robmacl/micron_maxon/drawings/Inventor_Design/Micron22_top_adj_02082013_Inventor2013/Images/render_Shop2.jpg

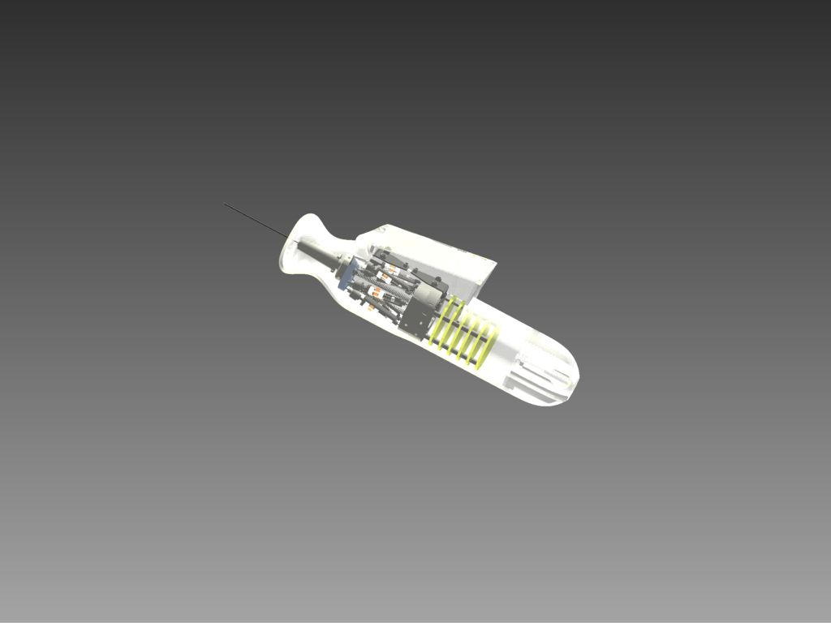
drawings/Inventor_Design/Micron22_top_adj_02082013_Inventor2013/Images/render_Shop2.jpg
