robmacl/micron_maxon/cad/asap_micron/mechanical/README.txt

Parts for the ASAP instrument.

Rob MacLachlan (412-445-8113, ram@ri.cmu.edu)

You can charge this to 15798.1.1090159

The big hole in the camera is for a "C mount lens".  My understanding
that the spec for this is 1" 32 TPI UN2A.

Tolerances: I've used three decimals for any dimensions where there
may be a fit issue.  I've used standard clearance holes for paired bolts,
so I don't think any special care should be required for the tapped
holes or clearance holes.

I think the most critical position is the hole pairs for the alignment
dowel pins between the camera and bar parts.  The idea is that the
pins should slip fit in the camera body and press fit in the bar.

Hole sizes should generally be standard drill sizes, and are not
critical.  I have not called out any tap drill on tapped holes, only
the thread depth.

Files:

Documentation:
README.txt		This file
assembly.SLDASM		Assembly
drawings.SLDDRW		Drawings of assembly and all parts
lens.SLDPRT		Dummy lens for assembly

Fabricated parts:
Mount block.SLDPRT	Mounting block
adapter_plate.SLDPRT	Adapter plate
bar.SLDPRT		Bar
camera.SLDPRT		Camera
ctr_laser_bracket.SLDPRT Center laser bracket
laser_bracket.SLDPRT	 (side) laser bracket
