robmacl/micron_maxon/micron/labview/manipulator/squiggle/Documentation/i2c_fpga.pptx

## I2C multi-bus controller organization

Control output (low overhead)

Demultiplexer commands (synchronization) and packets of bus controller commands.

Host write FIFO

Local command generation

Local write FIFO

Demultiplexer

Triggering

Bus controller commands: start_read, etc.

Bus 0

Bus 1

Bus 2

Multiplexer

Status packets

Host read FIFO

## I2C bus timing

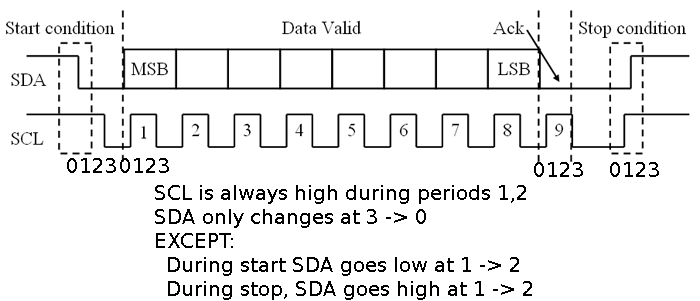
[picture p14: figure]

- Each bit period is divided into four phases 0 .. 3
- State transitions are usually clocked off of the leading edge of one of these phases.

## I2C bus state machine

See
Next slide

start_write
start_read

Exit on empty

Trigger delay 1

CMD wait

sequence

Sequence arg load

stop

Trigger delay 2

TX stop wait

Trigger delay 3

TX stop

## I2C bus state (read/write)

CMD wait

start_write

start_read

The first states of reading and writing are in common, with some parts conditional on whether the command is read or write.

load

start

address

RX data

TX data

address ACK

RX data 1

TX data ACK

wait

RX data ACK

## States for I2C bus state machine

This is copied from the LabView documentation for i2c_controller.ctl
- CMD wait: Waiting for command on write FIFO.
- load: State when loading arguments to read/write command.
- start: Sending start bit for I2C read/write.
- address: Sending address for read/write.
- address ACK: waiting for ACK on read/write address.
- wait: waiting to read/write next byte.
- TX data: writing data byte.
- TX data ACK: waiting for ACK on write data.
- stop wait: waiting to send stop.
- stop: sending stop bit.
- RX data: reading data byte.
- RX data 1: saving read byte.
- RX data ACK: waiting for ACK on read data.
- Sequence arg load: loading argument for sequence command.
- Trigger delay 1: preparing to stop, waiting for argument to load.
- Trigger delay 2: waiting for status machine to start
- Trigger delay 3: waiting for status to be saved.
