robmacl/micron_maxon/drawings/Inventor_Design/Micron22_top_adj_02082013_Inventor2013/Param_Micron.xlsx

baseD | 20
baseOD | 23
baseInitD | 4
baseTh0 | 48.46 | deg
baseTh1 | 23.07 | deg
topD | 14
topInitD | 4
topTh0 | 16.60 | deg
topTh1 | 86.80 | deg
dFlexure | 0.38
lFlexure | 1.5
lFlexureOffset | 1.95
dMotor | 1.44
lMotor | 22.35
topH | 21.666
springBaseD | 8
springTopD | 8
springInitL | 12.7
springLset | 3.5
springDeform | 18.166
springL | 30.866
springLO | 33.866
springUnderCut | 9.200
dM1X | 6.7359
dM1Y | 2.3401
dM2X | -1.3413
dM2Y | 7.0035
dM1Xt | 6.592266744
dM1Yt | -0.437039605 |  | -0.437039605
dM2Xt | -3.674620773 |  | 5.490550667
dM2Yt | 5.490550667
GuideRod | 2
GuideTubingOD | 4
GuideTubingID | 2
CSpringOD | 5.537
CSpringCD | 0.254
CSpringID | 5.029
lOCT | 58
OCToffset | 14.38
lOCTprobeNom | 72.38
lOCTprobe | 75
OCTd0 | 20
OCTd1 | 10
