robmacl/micron_maxon/asap/design/design_freqs.txt

;;; 4 Lights, max ADC rate 500ksps, 2ksps output
;;;
;;; This is what is used in the 3DOF micron

common-lisp-user> (opt-integer 4 2000 22000 15000 (/ 500000 8) :max_time (/ 2000.0))
interference 4.33d-3, Fs = 62500.00 (interval 16.00 uS), repeat interval 31
Output sample rate 2016.129, ADC rate 500000.00, ADC divisor 20
F = 8064.52, half-interval 1/2F = 0.000062, divisor 620
F = 10080.65, half-interval 1/2F = 0.0000496, divisor 496
F = 16129.03, half-interval 1/2F = 0.000031, divisor 310
F = 20161.29, half-interval 1/2F = 0.0000248, divisor 248
 2016.13 0.01604 (60483.87, 3h 20161.29)
 6048.39 0.00846 (56451.61, 7h 8064.52)
 8064.52 0.00433 (70564.52, 7h 10080.65)
 8064.52 1.00000 ( 8064.52, 1h 8064.52)
10080.65 1.00000 (10080.65, 1h 10080.65)
10080.65 0.00309 (72580.65, 9h 8064.52)
12096.77 0.00106 (112903.23, 7h 16129.03)
12096.77 0.01663 (50403.23, 5h 10080.65)
14112.90 0.03133 (48387.10, 3h 16129.03)
14112.90 0.00071 (110887.10, 11h 10080.65)
16129.03 0.00054 (141129.03, 7h 20161.29)
16129.03 1.00000 (16129.03, 1h 16129.03)
16129.03 0.00050 (16129.03, 2h 8064.52)
18145.16 0.00406 (80645.16, 5h 16129.03)
20161.29 0.00071 (104838.71, 13h 8064.52)
20161.29 1.00000 (20161.29, 1h 20161.29)
20161.29 0.00050 (20161.29, 2h 10080.65)
22177.42 0.03248 (40322.58, 5h 8064.52)
24193.55 0.25064 (24193.55, 3h 8064.52)
24193.55 0.00208 (100806.45, 5h 20161.29)
26209.68 0.00139 (88709.68, 11h 8064.52)
28225.81 0.00158 (90725.81, 9h 10080.65)
30241.94 0.12833 (30241.94, 3h 10080.65)
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

Partition 1: 9578.54 11973.18 14367.82 
Internal infererence:
      0      1      2
0: 1.0d+0 
1: 9.9d-3 1.0d+0 
2: 5.5d-4 2.6d-3 1.0d+0 

Partition 2: 7183.91 10775.86 17959.77 
Internal infererence:
      0      1      2
0: 1.0d+0 
1: 1.3d-3 1.0d+0 
2: 3.6d-4 1.3d-4 1.0d+0 

Between partition interference:
2.0d-3 1.5d-4 1.8d-3 
4.3d-4 4.1d-4 2.8d-4 
5.9d-4 5.8d-4 2.9d-3 
Max beteen paritions: 2.9d-3

0.009929061422590217d0
312500/9
((625000/87 29 6) (2500000/261 29 8) (312500/29 29 9) (3125000/261 29 10)
 (1250000/87 29 12) (1562500/87 29 15))
