robmacl/micron_maxon/drawings/Inventor_Design/Micron22_top_adj_02082013_Inventor2013/OCT Probes/OCT_Probe_Asm_03142013.pdf

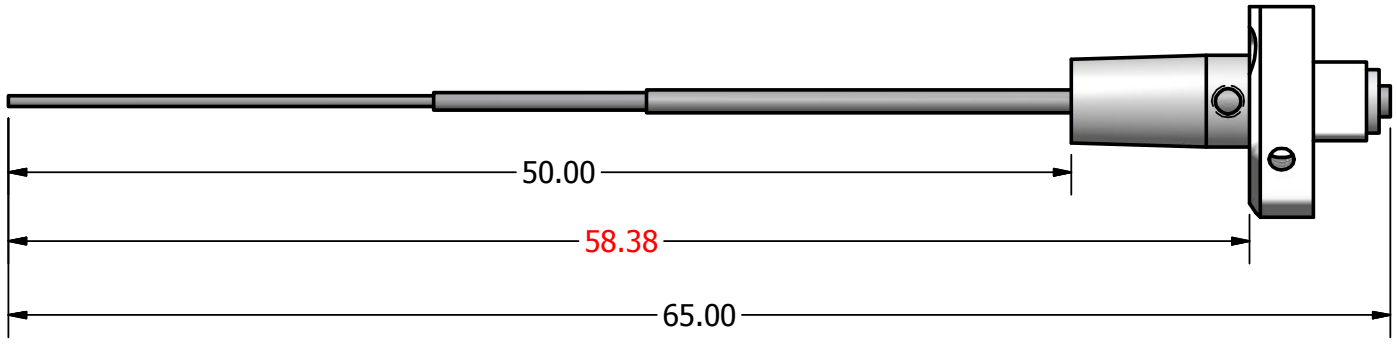
[picture p15: figure]

PRODUCED BY AN AUTODESK EDUCATIONAL PRODUCT

PRODUCED BY AN AUTODESK EDUCATIONAL PRODUCT

A

A

B

B

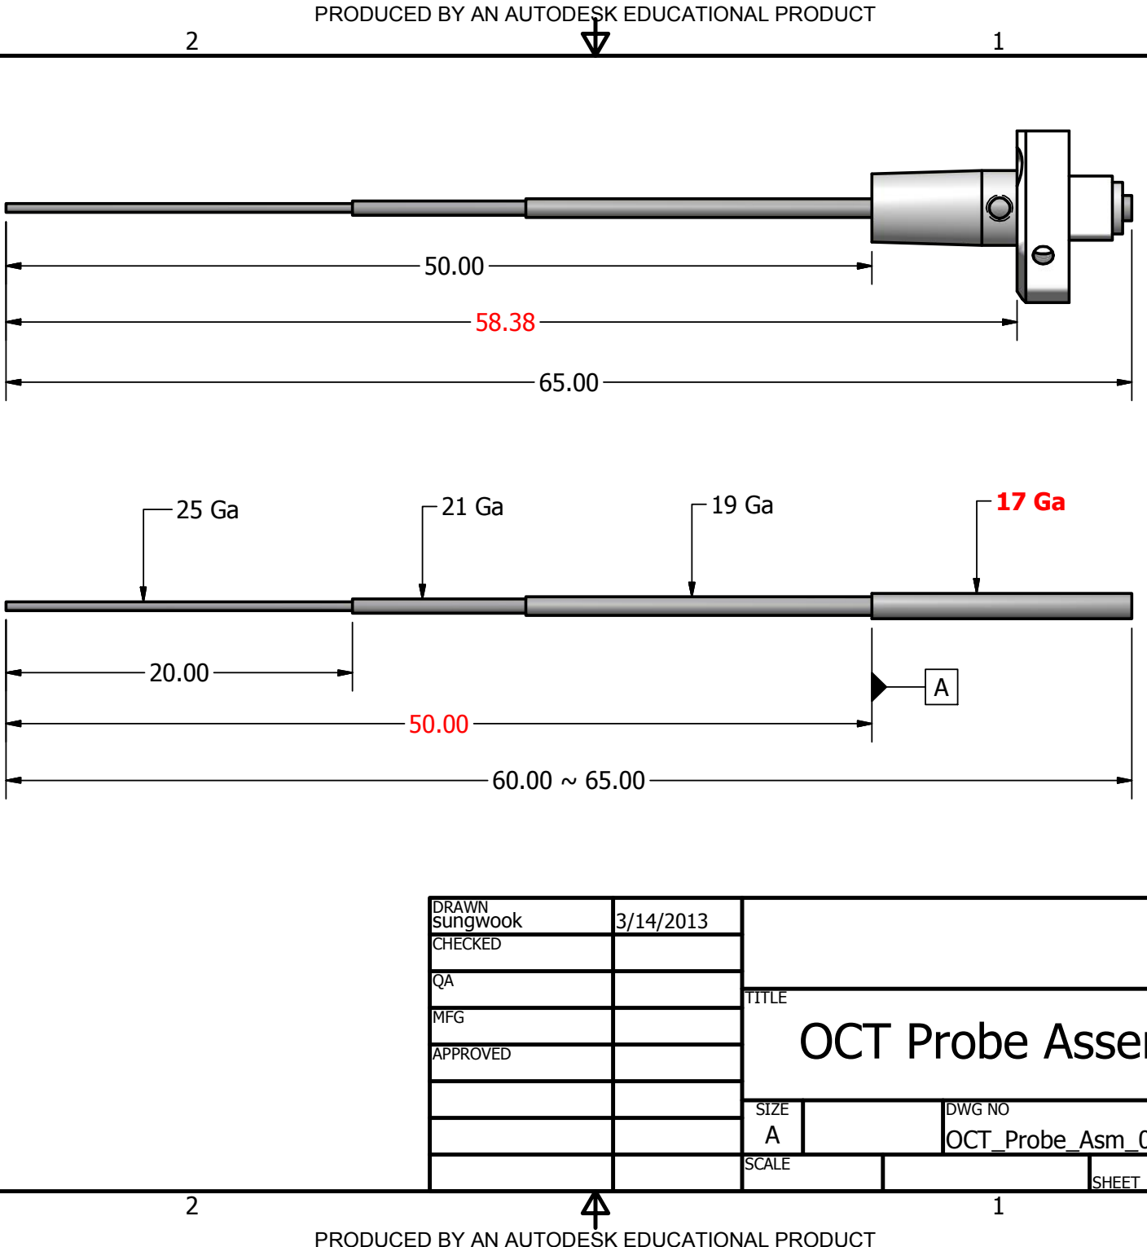
[picture p16: figure]
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
# bly
