robmacl/micron_maxon/cad/exp_fixtures/circle_cross.pdf

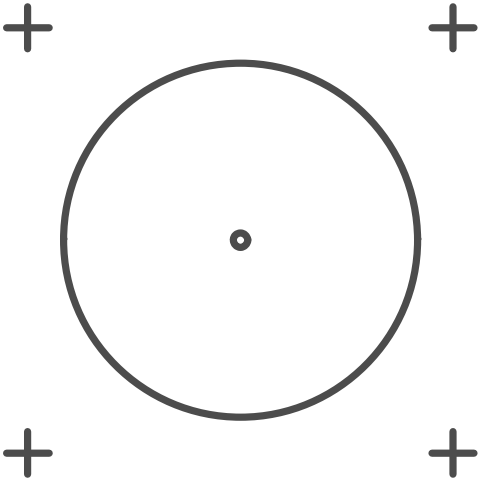
[picture p17: figure]
