robmacl/micron_maxon/cad/micron_6dof/Kinematic Data Pt.xlsx

Sheet: Kinematic Data
Pivot | at half of flexure (1) |  |  | at holes (2) |  |  | on the plates (3)
top | x | y | z | x | y | z | x | y | z
0 | 4.753 | 5.219 | -9.724 | 4.754 | 4.984 | -8.513 | 4.8314 | 5.0653 | -9.0000
1 | -4.753 | 5.219 | -9.724 | -4.754 | 4.984 | -8.513 | -4.8314 | 5.0653 | -9.0000
2 | -6.896 | 1.506 | -9.724 | -6.693 | 1.625 | -8.513 | -6.8024 | 1.6515 | -9.0000
3 | -2.144 | -6.726 | -9.724 | -1.939 | -6.609 | -8.513 | -1.9710 | -6.7168 | -9.0000
4 | 2.144 | -6.726 | -9.724 | 1.939 | -6.609 | -8.513 | 1.9710 | -6.7168 | -9.0000
5 | 6.896 | 1.506 | -9.724 | 6.693 | 1.625 | -8.513 | 6.8024 | 1.6515 | -9.0000
Bottom | x | y | z | x | y | z | x | y | z
0 | 2.550 | 9.536 | -30.015 | 2.499 | 9.799 | -31.226 | 2.471 | 9.690 | -30.739
1 | -2.550 | 9.536 | -30.015 | -2.499 | 9.799 | -31.226 | -2.471 | 9.690 | -30.739
2 | -9.533 | -2.560 | -30.015 | -9.735 | -2.735 | -31.226 | -9.627 | -2.705 | -30.739
3 | -6.984 | -6.976 | -30.015 | -7.237 | -7.063 | -31.226 | -7.156 | -6.985 | -30.739
4 | 6.984 | -6.976 | -30.015 | 7.237 | -7.063 | -31.226 | 7.156 | -6.985 | -30.739
5 | 9.533 | -2.560 | -30.015 | 9.735 | -2.735 | -31.226 | 9.627 | -2.705 | -30.739
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
