robmacl/micron_maxon/drawings/Inventor_Design/Micron22_top_adj_02082013_Inventor2013/Param_dMotor.xlsx

Sheet: Data
dMotor1 | 2.452
dMotor2 | 2.452
dMotor3 | 2.452
dMotor4 | 2.452
dMotor5 | 2.452
dMotor6 | 2.452
 | (0,2,0)
dMotor1 | 2.107
dMotor2 | 3.763
dMotor3 | 3.241
dMotor4 | 2.4
dMotor5 | 3.487
dMotor6 | 2.673
 | pi/2,2,0
dMotor1 | 3.105
dMotor2 | 3.105
dMotor3 | 2.141
dMotor4 | 3.589
dMotor5 | 3.589
dMotor6 | 2.141
 | pi,2,0
dMotor1 | 3.763
dMotor2 | 2.107
dMotor3 | 2.673
dMotor4 | 3.487
dMotor5 | 2.4
dMotor6 | 3.241
 | -pi/2,2,0
dMotor1 | 2.805
dMotor2 | 2.805
dMotor3 | 3.726
dMotor4 | 2.305
dMotor5 | 2.305
dMotor6 | 3.726
 | 0,0,-2
dMotor1 | 0.503
dMotor2 | 0.503
dMotor3 | 0.503
dMotor4 | 0.503
dMotor5 | 0.503
dMotor6 | 0.503
 | 0,2,-2
dMotor1 | 0.182
dMotor2 | 2.116
dMotor3 | 1.433
dMotor4 | 0.445
dMotor5 | 1.872
dMotor6 | 0.927
 | pi/2,2,-2
dMotor1 | 1.442
dMotor2 | 1.442
dMotor3 | 0.174
dMotor4 | 1.871
dMotor5 | 1.871
dMotor6 | 0.174
 | pi,2,-2
dMotor1 | 2.116
dMotor2 | 0.182
dMotor3 | 0.927
dMotor4 | 1.872
dMotor5 | 0.445
dMotor6 | 1.433
 | -pi/2,2,-2
dMotor1 | 0.911
dMotor2 | 0.911
dMotor3 | 2.116
dMotor4 | 0.462
dMotor5 | 0.462
dMotor6 | 2.116
 | 0,0,2
dMotor1 | 4.409
dMotor2 | 4.409
dMotor3 | 4.409
dMotor4 | 4.409
dMotor5 | 4.409
dMotor6 | 4.409
 | 0,2,2
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
