robmacl/micron_maxon/drawings/Inventor_Design/Micron22_top_adj_02082013_Inventor2013/Param_OCT.xlsx

lAdapter | 8.38 | mm
dTop | 6 | mm
OCToffset | 14.38 | mm
lOCTtoAdapter | 50 | mm
lOCTprobeNom | 58.38 | mm
lOCTprobeTotal | 64.38 | mm
OCTd0 | 65 | mm
OCTd1 | 20 | mm
OCTd2 | 10 | mm
