robmacl/micron_maxon/drawings/Inventor_Design/Micron22_top_adj_02082013_Inventor2013/06082012_Outer_Tube/Tube_2D.xlsx

 |  | r (mm)
D | 1.125 | 14.2875 | 89.77101008 | 44.886
 | 1.1289 | 14.3375 | 90.08516934 | 45.043
 | 1.1329 | 14.3875 | 90.39932861 | 45.200
 |  |  | 117.07 | 29.193 | 87.57910125
 |  |  | 117.07 | 29.295 | 87.88558979
 |  |  | 117.07 | 29.397 | 88.19207833
 |  |  | 120 | 29.924
 |  |  | 120 | 30.028
 |  |  | 120 | 30.133 |  | offset
 |  |  | 124.92 | 31.151
 |  |  | 124.92 | 31.260
 |  |  | 124.92 | 31.369
 | 1.378 | 35.0012
 | 1.041 | 26.4414
 | 0.076 | 1.9304
