robmacl/micron_maxon/drawings/Inventor_Design/Micron22_top_adj_02082013_Inventor2013/Param_dMotor_old.xlsx

Sheet: Data
dMotor1 | 2.452
dMotor2 | 2.452
dMotor3 | 2.452
dMotor4 | 2.452
dMotor5 | 2.452
dMotor6 | 2.452
 | (0,2,0)
dMotor1 | 2.194
dMotor2 | 3.609
dMotor3 | 2.738
dMotor4 | 2.738
dMotor5 | 3.609
dMotor6 | 2.194
 | pi/2,2,0
dMotor1 | 3.360
dMotor2 | 2.549
dMotor3 | 2.013
dMotor4 | 3.661
dMotor5 | 3.166
dMotor6 | 2.331
 | pi,2,0
dMotor1 | 3.502
dMotor2 | 2.063
dMotor3 | 2.975
dMotor4 | 2.975
dMotor5 | 2.063
dMotor6 | 3.502
 | -pi/2,2,0
dMotor1 | 2.331
dMotor2 | 3.166
dMotor3 | 3.661
dMotor4 | 2.013
dMotor5 | 2.549
dMotor6 | 3.360
 | 0,0,-2
dMotor1 | 0.396
dMotor2 | 0.396
dMotor3 | 0.396
dMotor4 | 0.396
dMotor5 | 0.396
dMotor6 | 0.396
 | 0,2,-2
dMotor1 | 0.344
dMotor2 | 1.989
dMotor3 | 0.848
dMotor4 | 0.848
dMotor5 | 1.989
dMotor6 | 0.344
 | pi/2,2,-2
dMotor1 | 1.732
dMotor2 | 0.791
dMotor3 | 0.085
dMotor4 | 2.008
dMotor5 | 1.362
dMotor6 | 0.382
 | pi,2,-2
dMotor1 | 1.782
dMotor2 | 0.099
dMotor3 | 1.298
dMotor4 | 1.298
dMotor5 | 0.099
dMotor6 | 1.782
 | -pi/2,2,-2
dMotor1 | 0.382
dMotor2 | 1.362
dMotor3 | 2.008
dMotor4 | 0.085
dMotor5 | 0.791
dMotor6 | 1.732
 | 0,0,2
dMotor1 | 4.311
dMotor2 | 4.311
dMotor3 | 4.311
dMotor4 | 4.311
dMotor5 | 4.311
dMotor6 | 4.311
 | 0,2,2
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
