robmacl/micron_maxon/cad/3dof_handle/mechanical/LED Triangle2.jpg

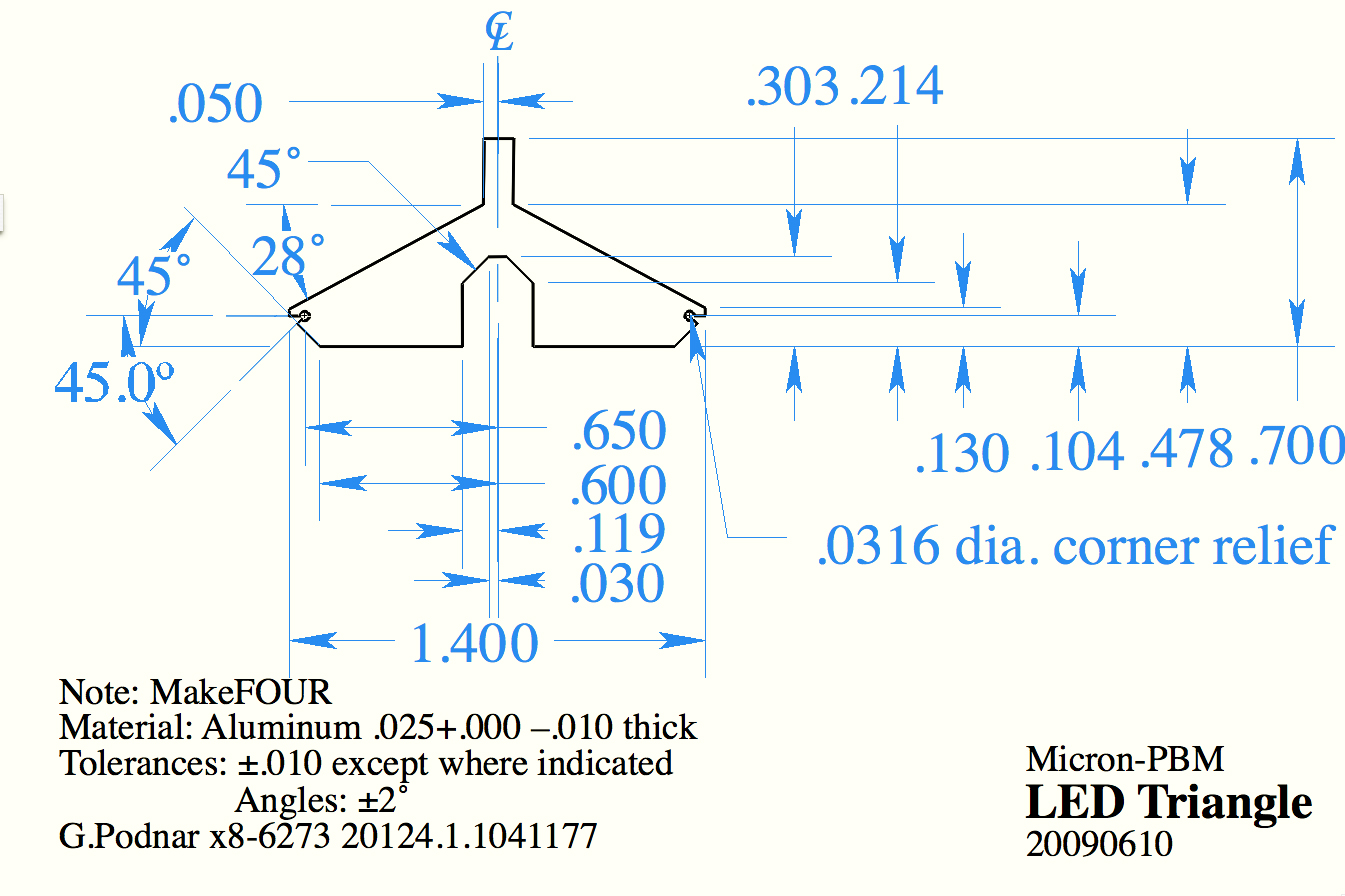
cad/3dof_handle/mechanical/LED Triangle2.jpg
