robmacl/micron_maxon/cad/3dof_handle/mechanical/MICRON-PBM-II_cover3.jpg

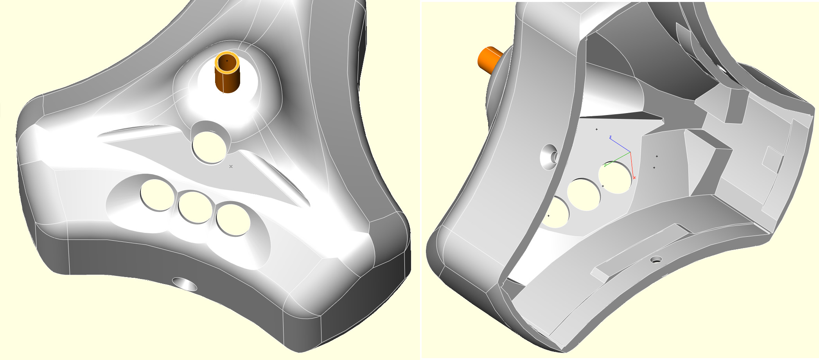
cad/3dof_handle/mechanical/MICRON-PBM-II_cover3.jpg
