robmacl/micron_maxon/cad/asap_micron/noise_gen.png

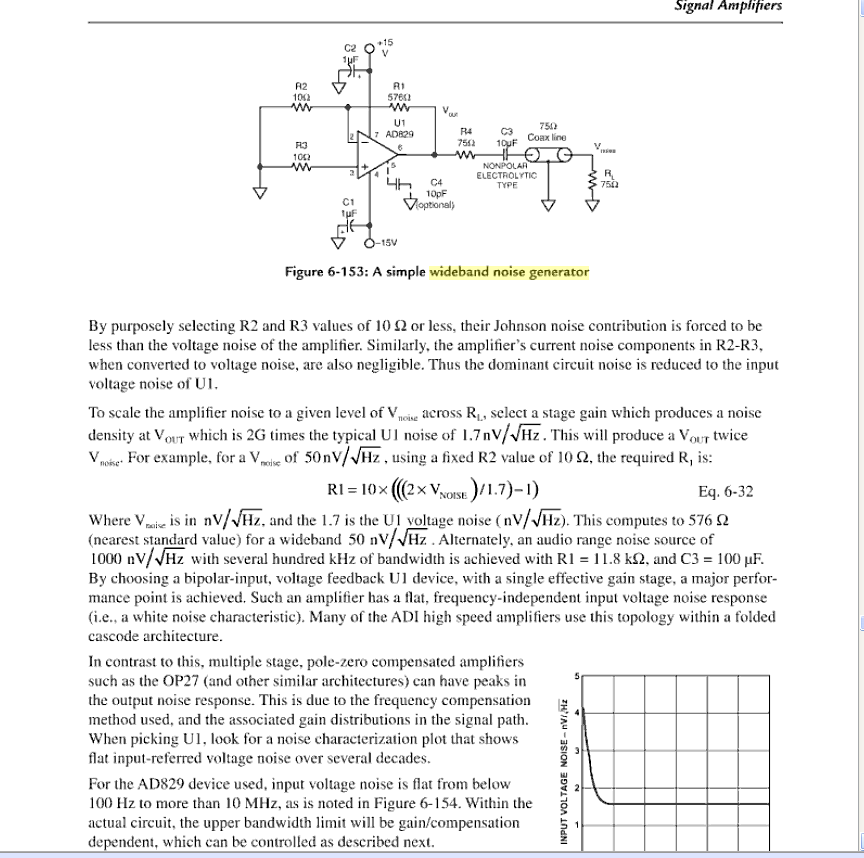
cad/asap_micron/noise_gen.png
