robmacl/micron_maxon/cad/Micron CAD/3dof_stop.jpg

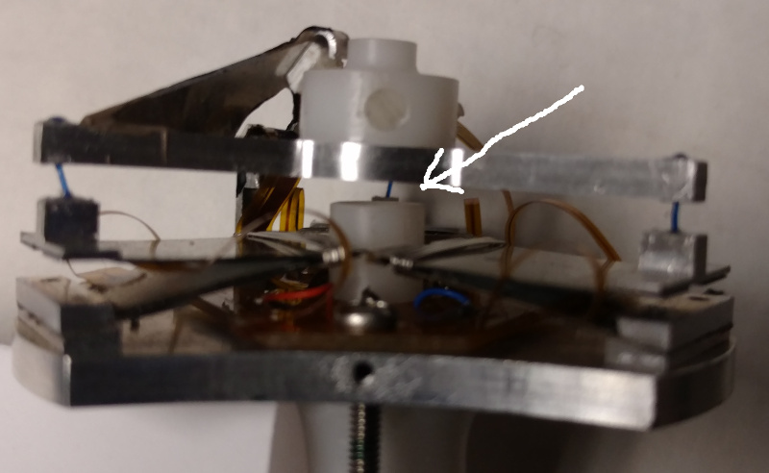
cad/Micron CAD/3dof_stop.jpg
