robmacl/micron_maxon/cad/Micron CAD/locking_feature.jpg

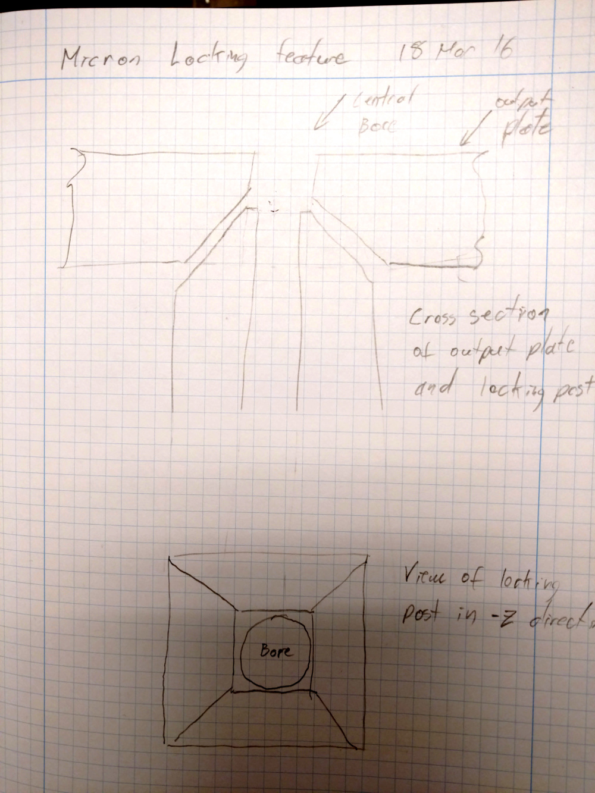
cad/Micron CAD/locking_feature.jpg
