robmacl/micron_maxon/cad/Micron CAD/Select tidbits/6 DOF no finger.jpg

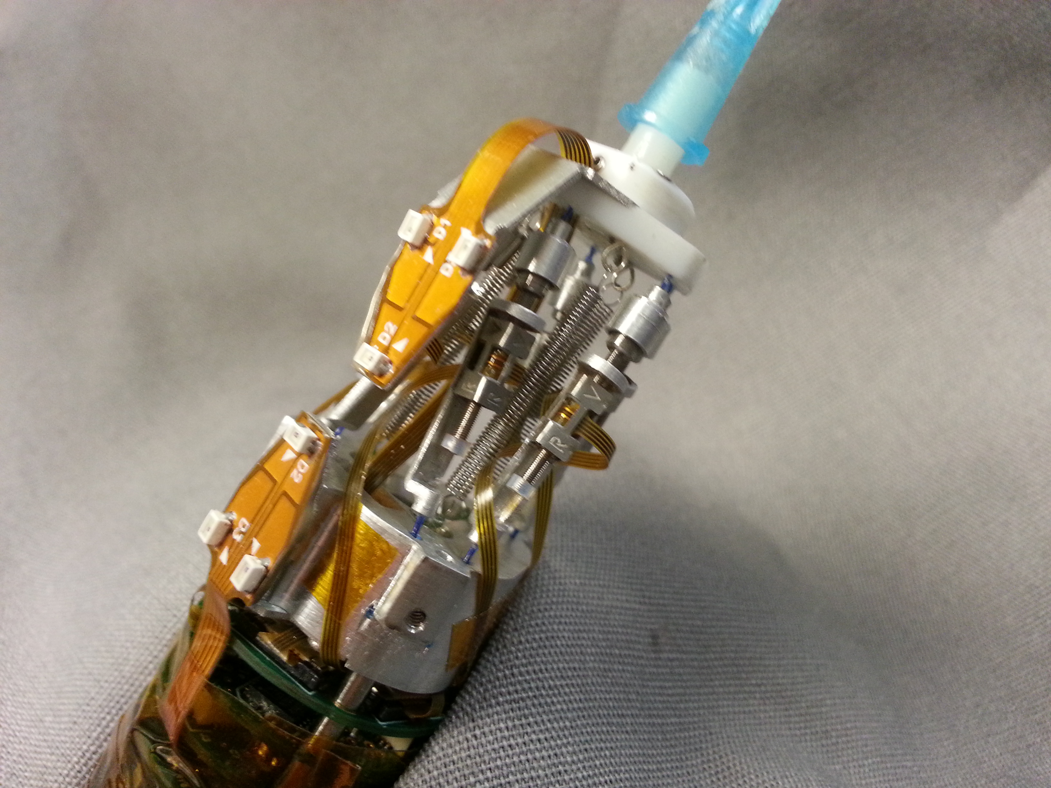
cad/Micron CAD/Select tidbits/6 DOF no finger.jpg
