robmacl/micron_maxon/cad/Micron CAD/Select tidbits/baseplate.png

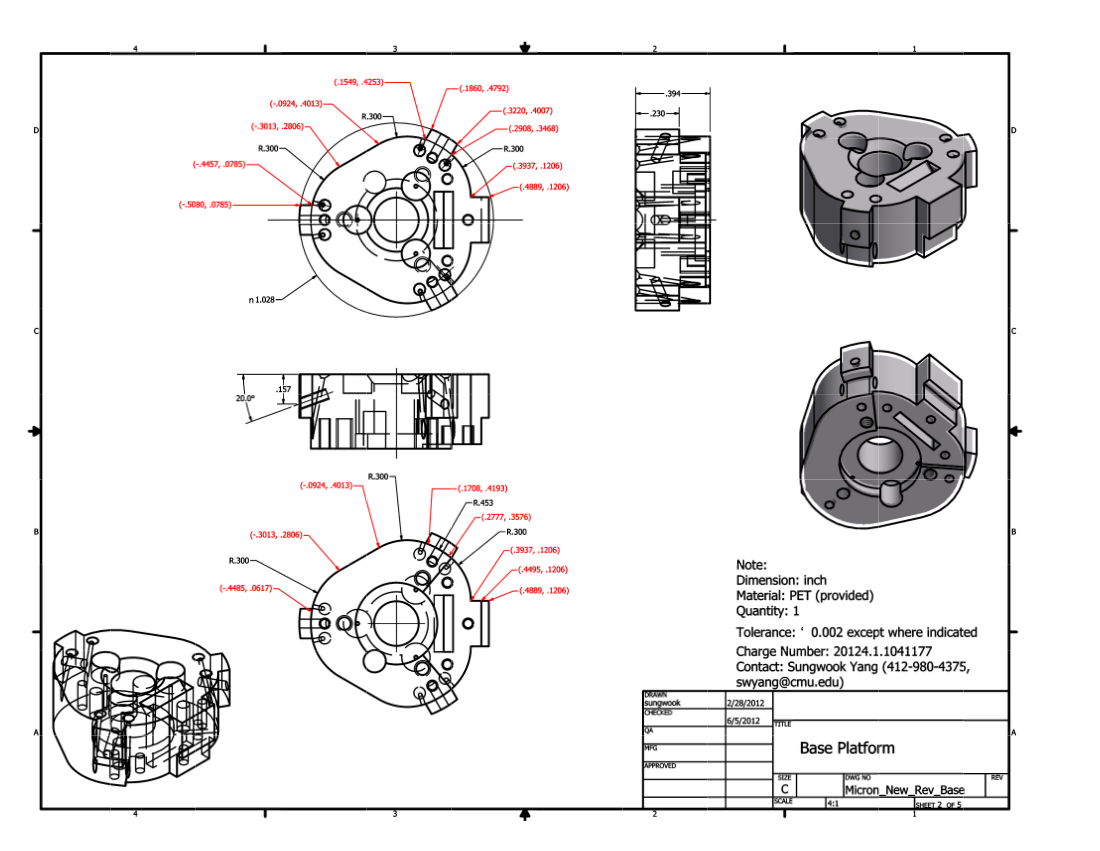
cad/Micron CAD/Select tidbits/baseplate.png
