robmacl/micron_maxon/cad/Micron CAD/Select tidbits/exploded_render.png

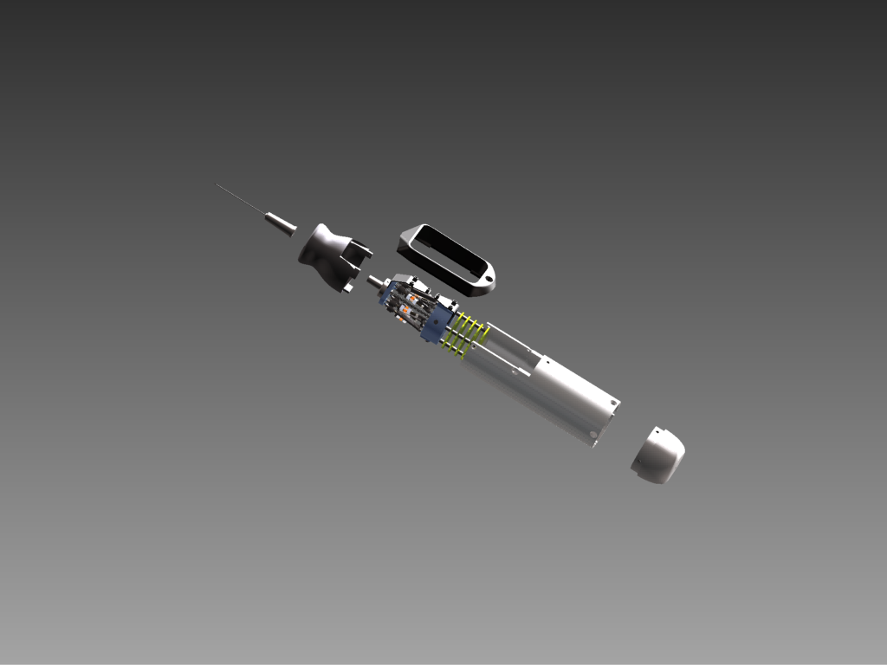
cad/Micron CAD/Select tidbits/exploded_render.png
