robmacl/micron_maxon/cad/Micron CAD/Select tidbits/led_flex.png

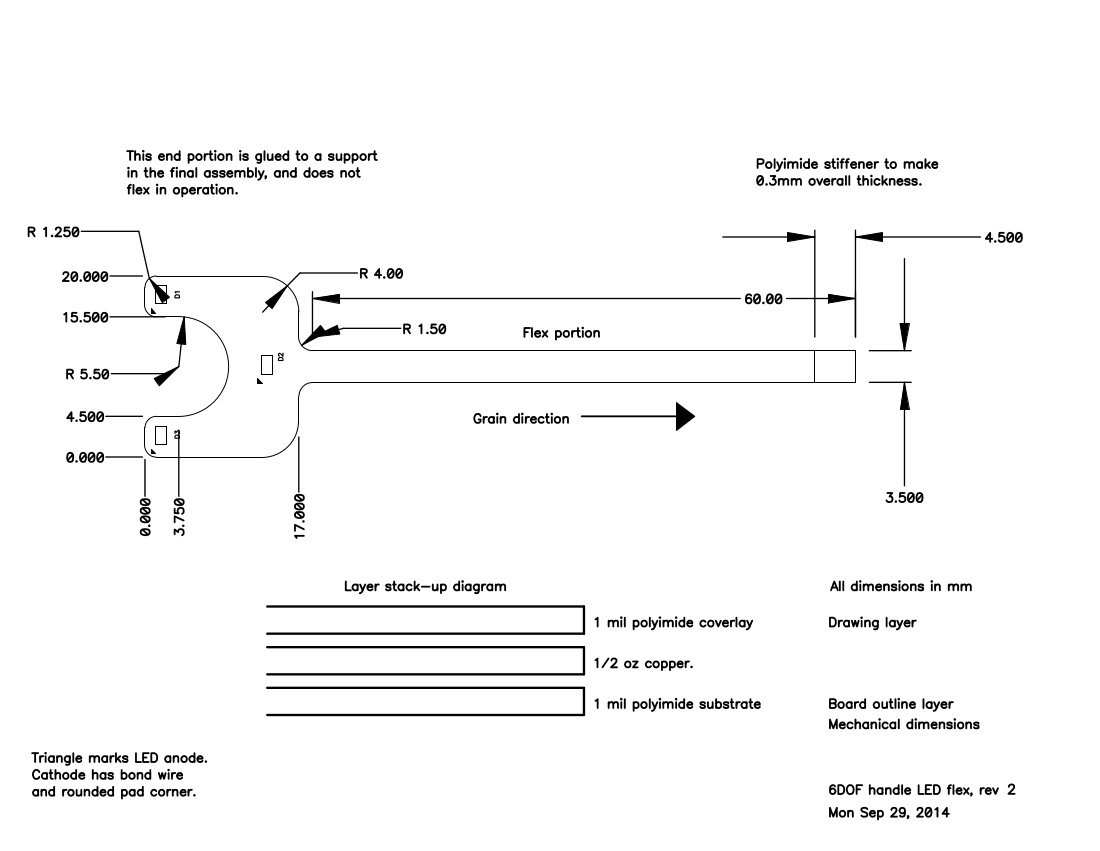
cad/Micron CAD/Select tidbits/led_flex.png
