robmacl/micron_maxon/cad/micron_6dof/connector-board-dimensions.png

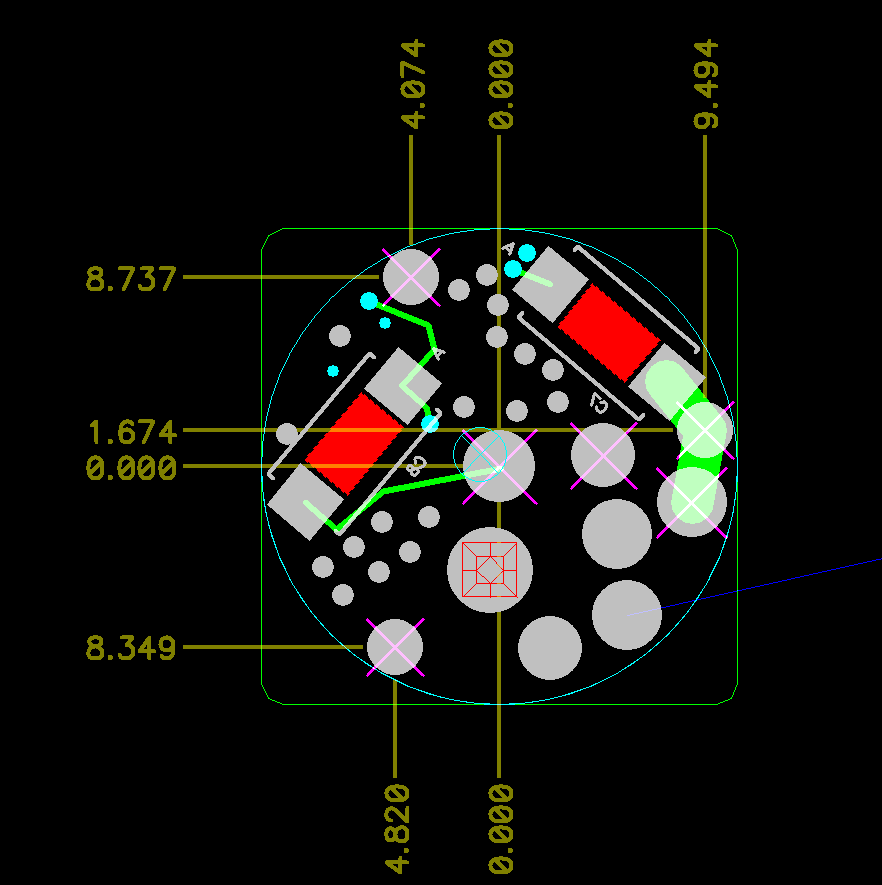
cad/micron_6dof/connector-board-dimensions.png
