robmacl/micron_maxon/cad/micron_6dof/driver-board-dimensions.png

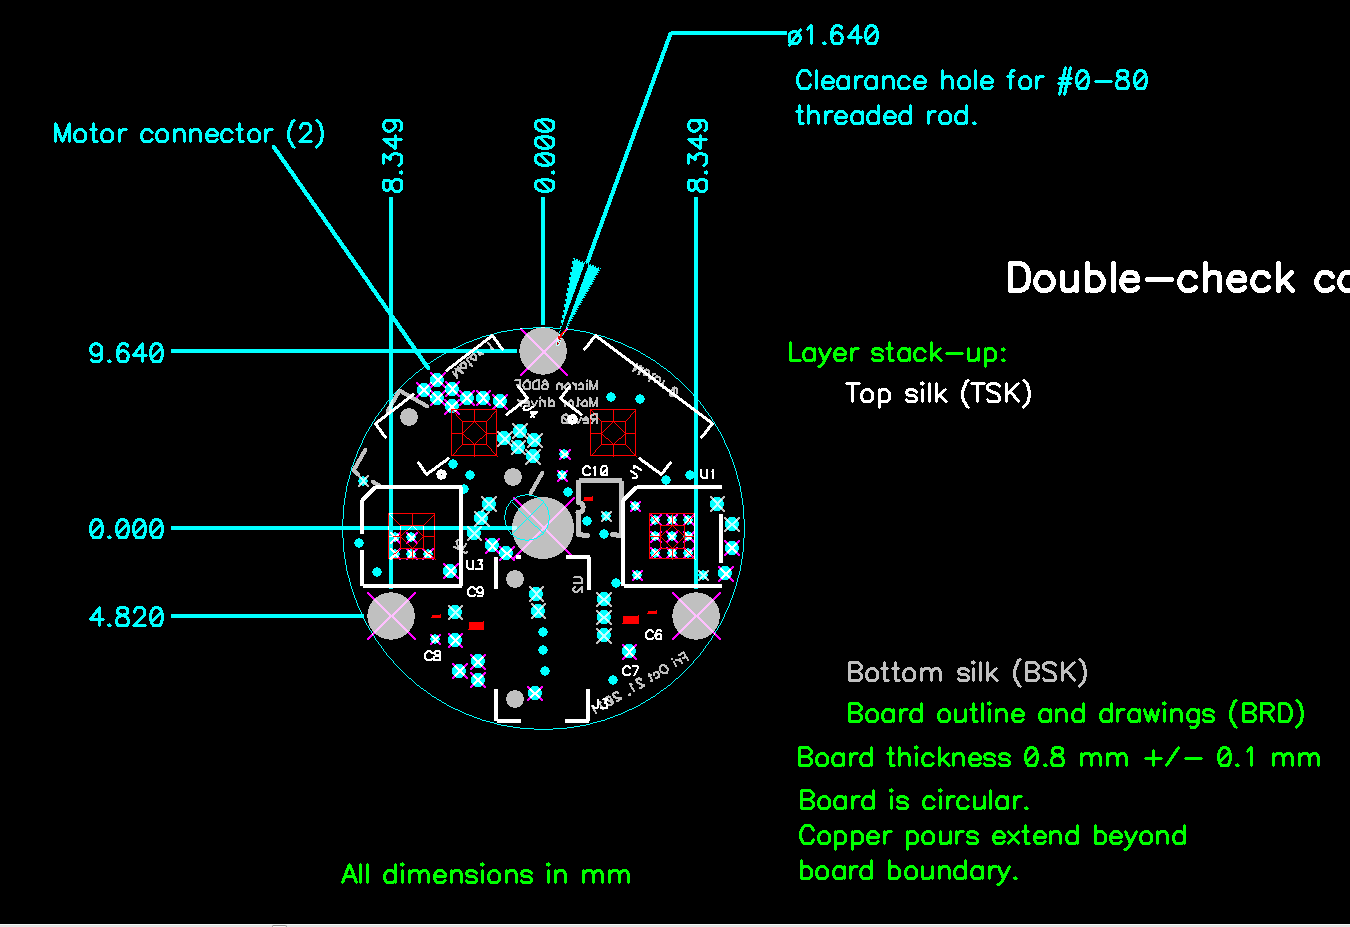
cad/micron_6dof/driver-board-dimensions.png
