robmacl/micron_maxon/cad/micron_6dof/led-board-dimensions.png

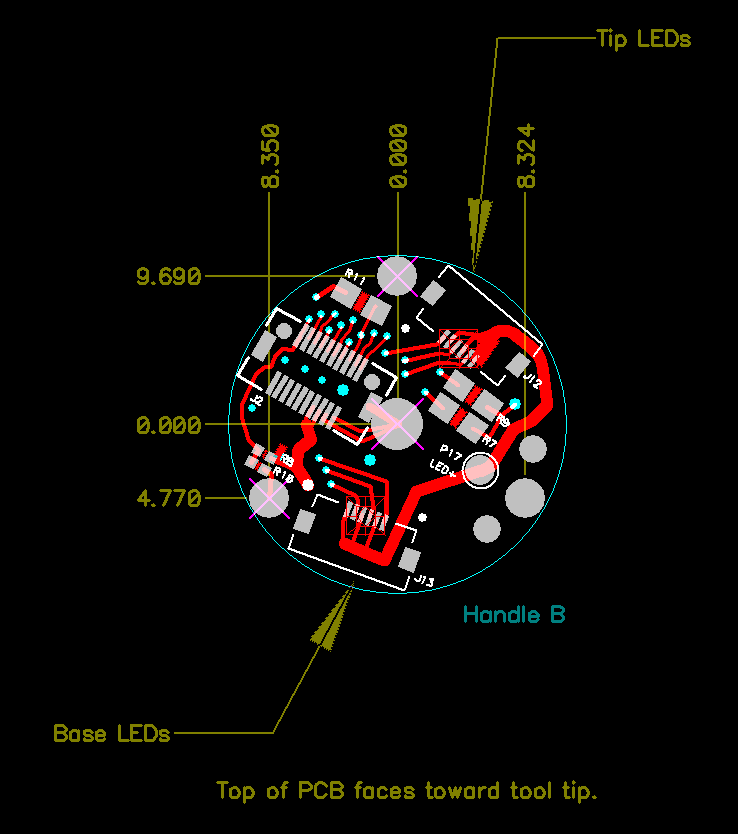
cad/micron_6dof/led-board-dimensions.png
