robmacl/micron_maxon/cad/micron_6dof/motor_location_map.png

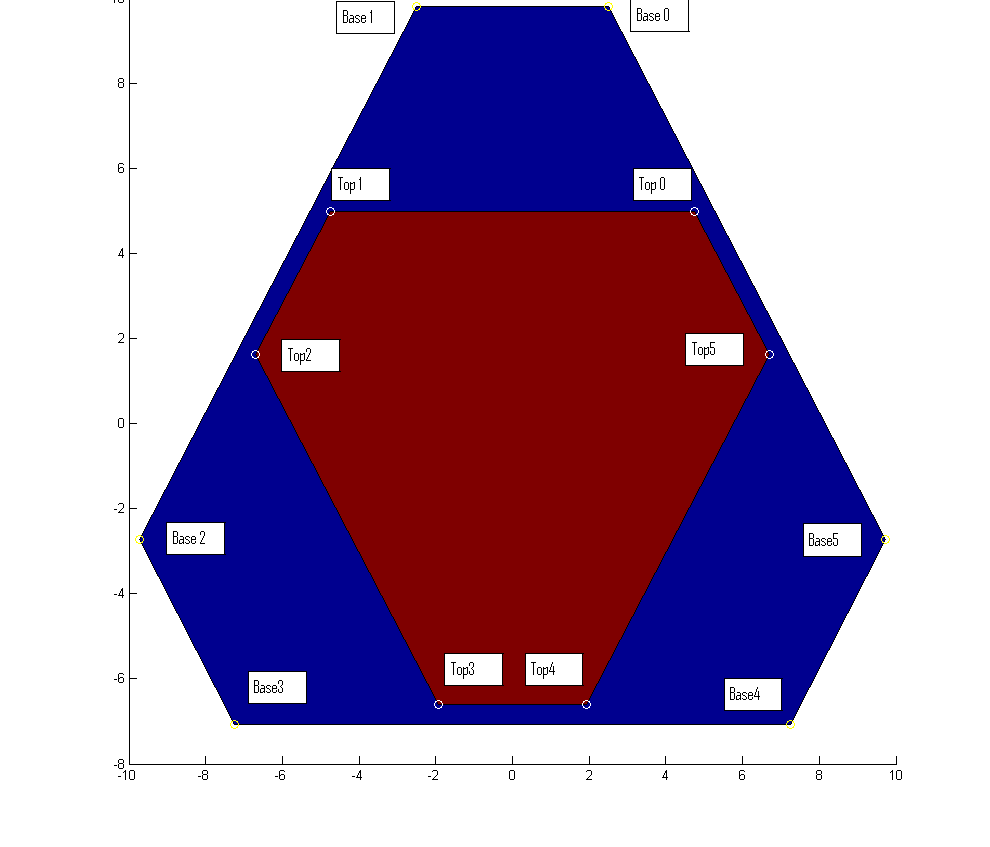
cad/micron_6dof/motor_location_map.png
