robmacl/micron_maxon/drawings/figs/Micron_Asm2.tif

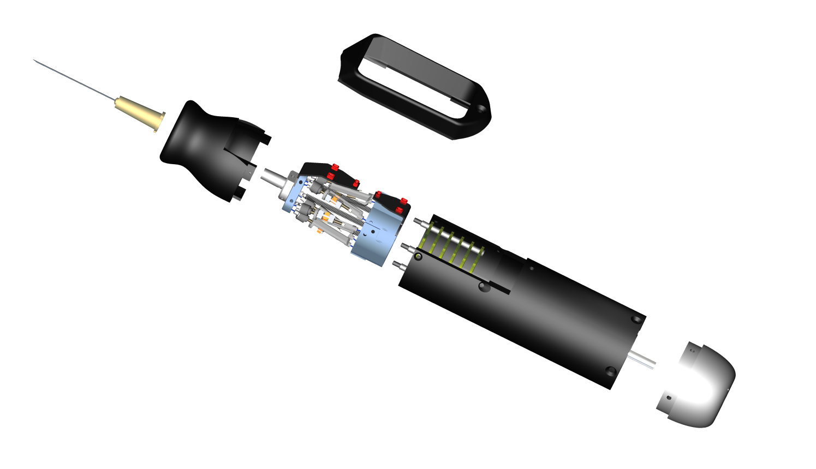
drawings/figs/Micron_Asm2.tif
