robmacl/micron_maxon/drawings/figs/Micron_Asm2_angle.tif

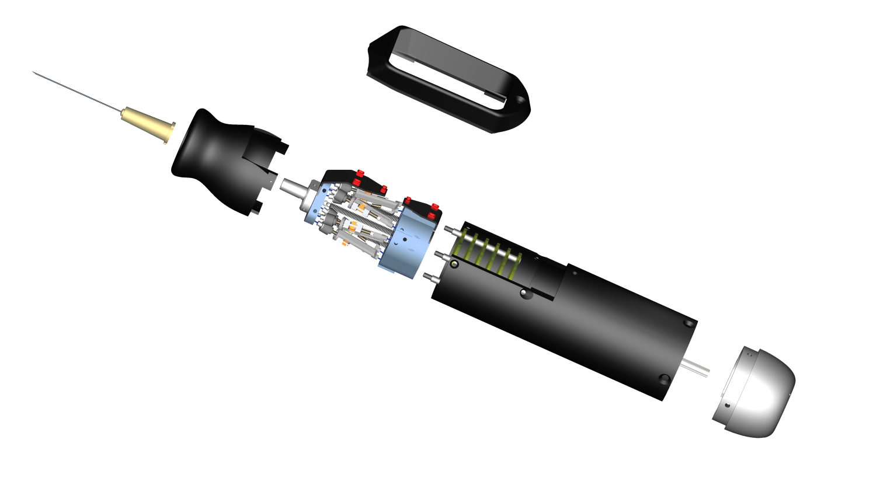
drawings/figs/Micron_Asm2_angle.tif
