robmacl/micron_maxon/drawings/figs/Micron_Asm.tif

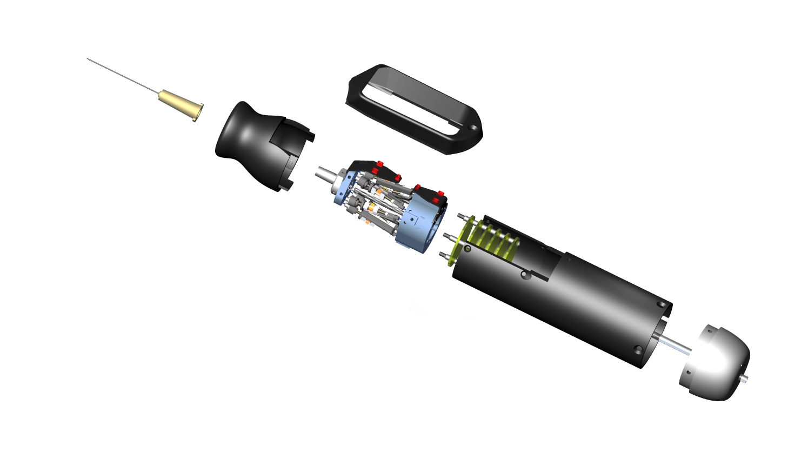
drawings/figs/Micron_Asm.tif
