robmacl/micron_maxon/drawings/figs/Micron_Motor_Asm.tif

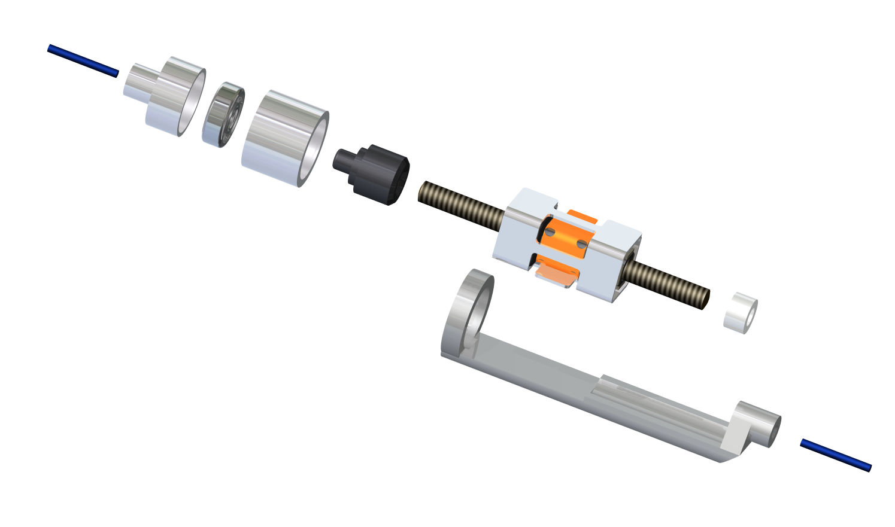
drawings/figs/Micron_Motor_Asm.tif
