robmacl/micron_maxon/drawings/Inventor_Design/Micron22_top_adj_02082013_Inventor2013/Images/ASM_Micron_ASAP_Merge_v4_0_mid.bmp

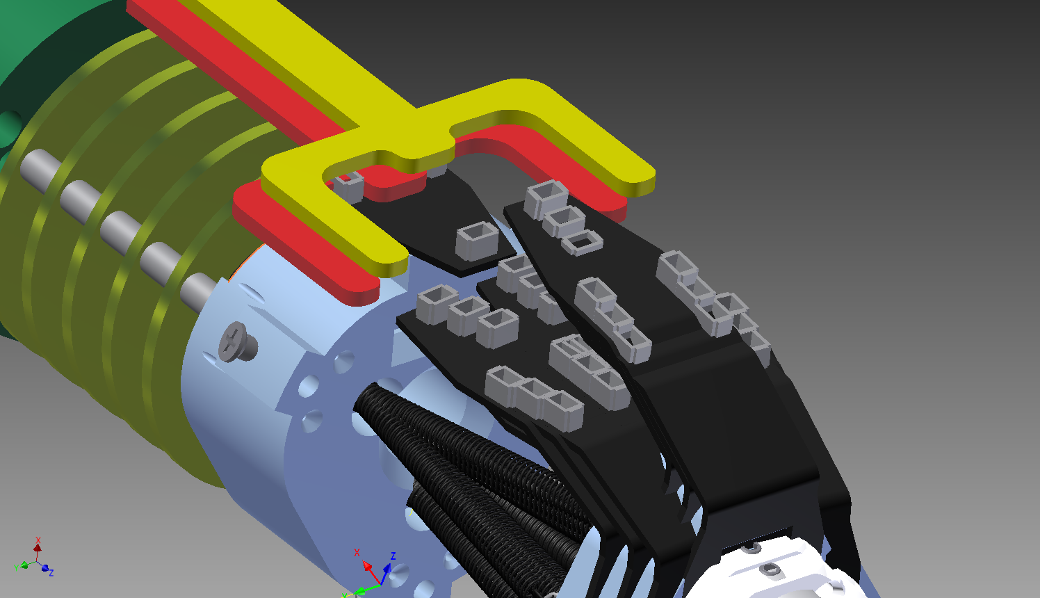
drawings/Inventor_Design/Micron22_top_adj_02082013_Inventor2013/Images/ASM_Micron_ASAP_Merge_v4_0_mid.bmp
