robmacl/micron_maxon/drawings/Inventor_Design/Micron22_top_adj_02082013_Inventor2013/Images/new_flex_3d.bmp

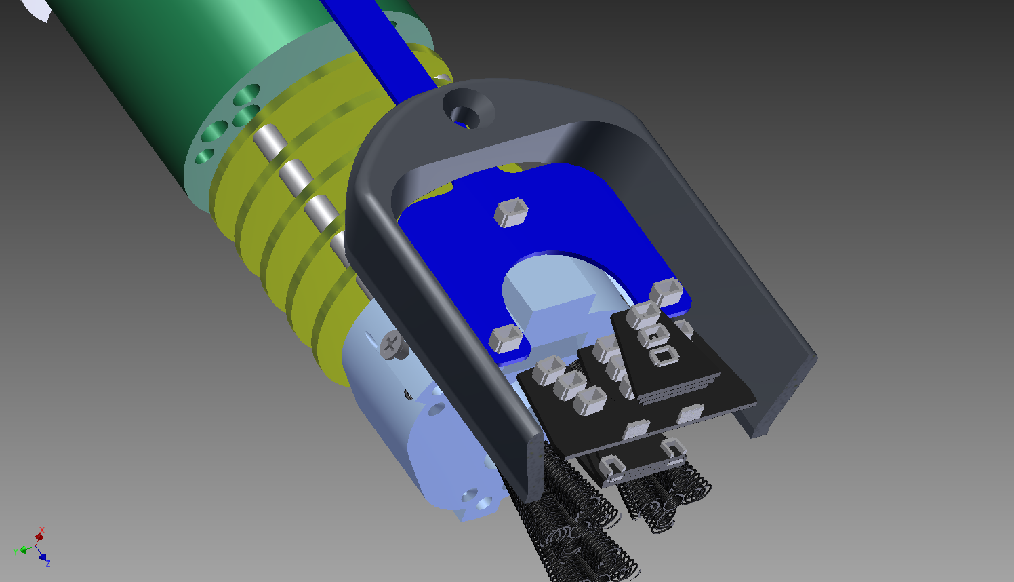
drawings/Inventor_Design/Micron22_top_adj_02082013_Inventor2013/Images/new_flex_3d.bmp
