robmacl/micron_maxon/drawings/Inventor_Design/Micron22_top_adj_02082013_Inventor2013/Images/new_flex_front.bmp

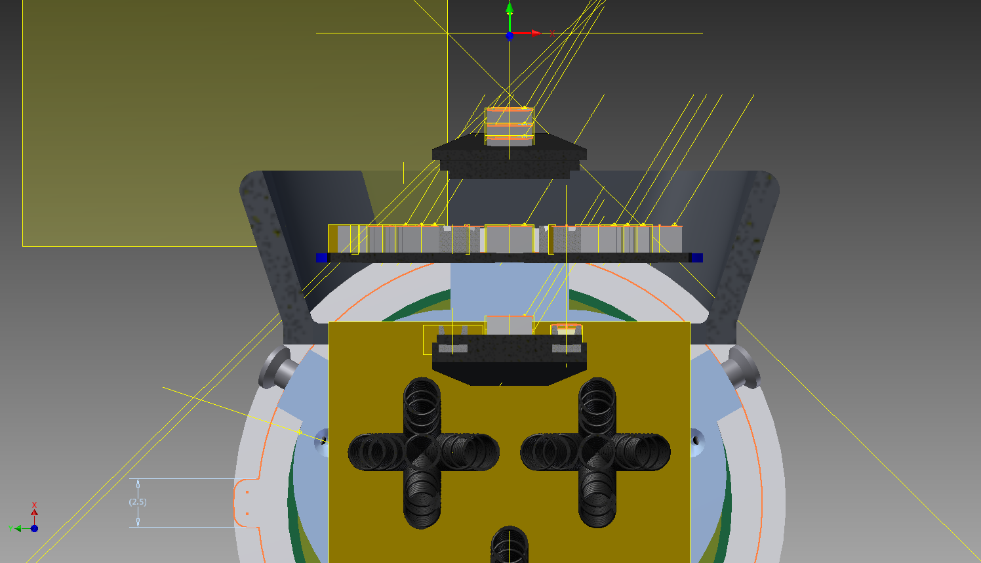
drawings/Inventor_Design/Micron22_top_adj_02082013_Inventor2013/Images/new_flex_front.bmp
