robmacl/micron_maxon/micron/labview/config/SN2/system_id_hh/comp_response.png

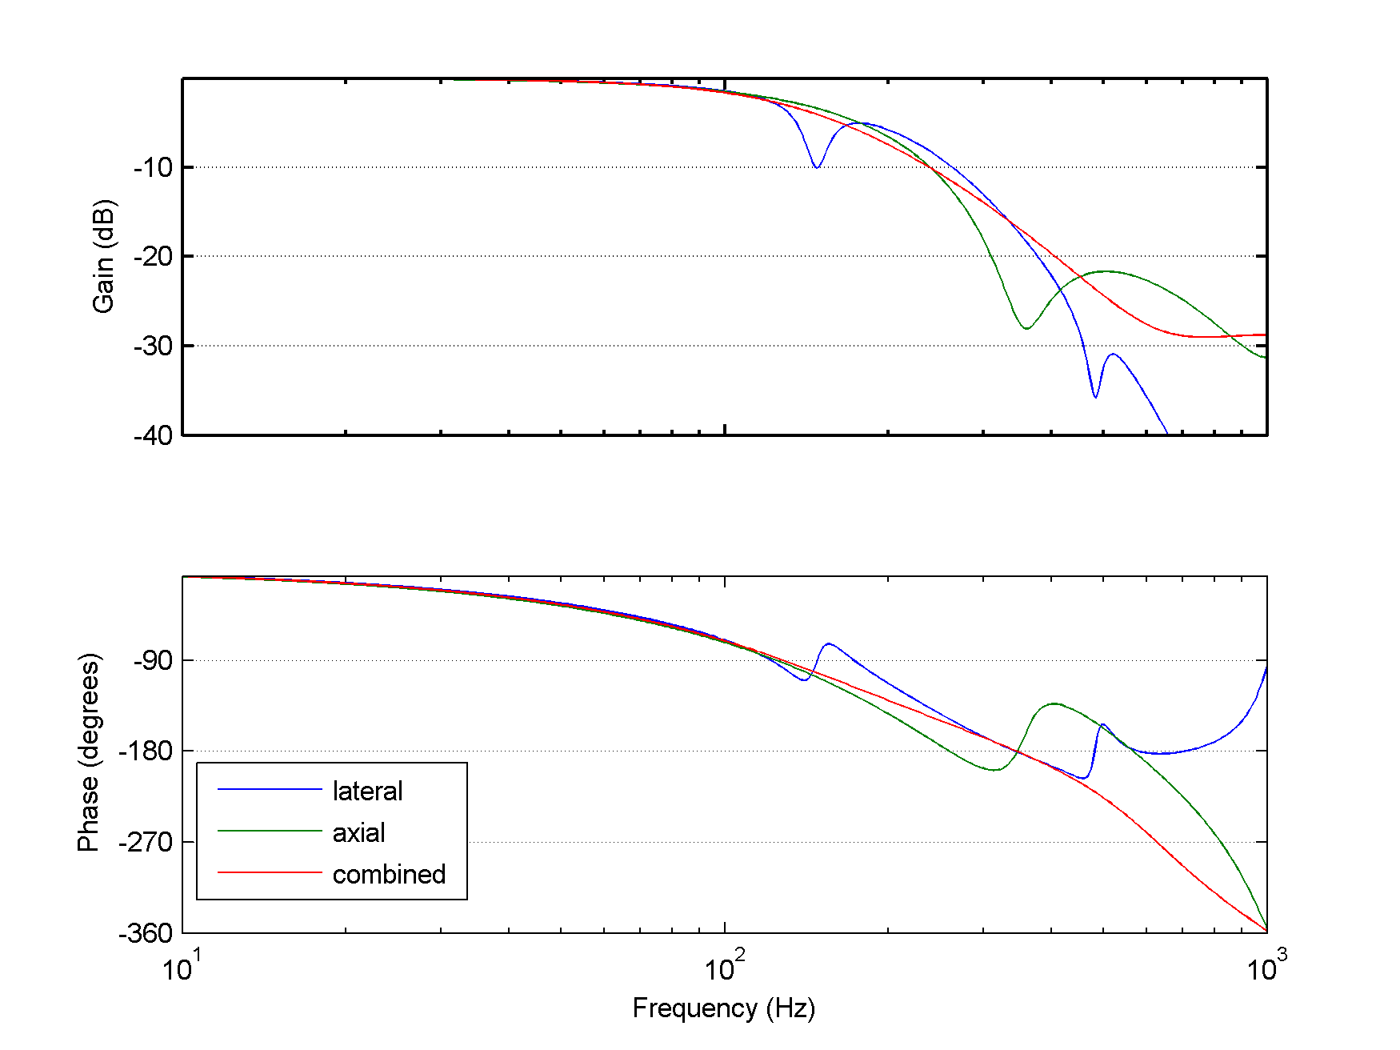
micron/labview/config/SN2/system_id_hh/comp_response.png
