robmacl/micron_maxon/drawings/Inventor_Design/Micron22_top_adj_02082013_Inventor2013/Assembly/ASM_Micron_Manipulator.stp

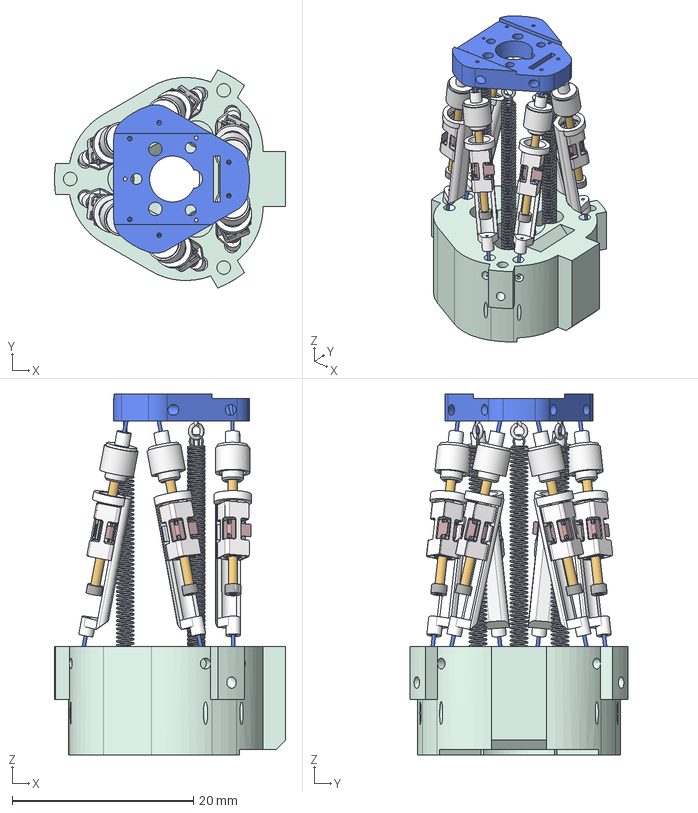
[picture p51: CAD file, 2024-06-14]
drawings/Inventor_Design/Micron22_top_adj_02082013_Inventor2013/Assembly/ASM_Micron_Manipulator.stp
25.5 x 24.1 x 39.9 mm
