robmacl/micron_maxon/drawings/Inventor_Design/Micron22_top_adj_02082013_Inventor2013/Parts/Motor Units/MU_Motor_Asm_Frame_new3.igs

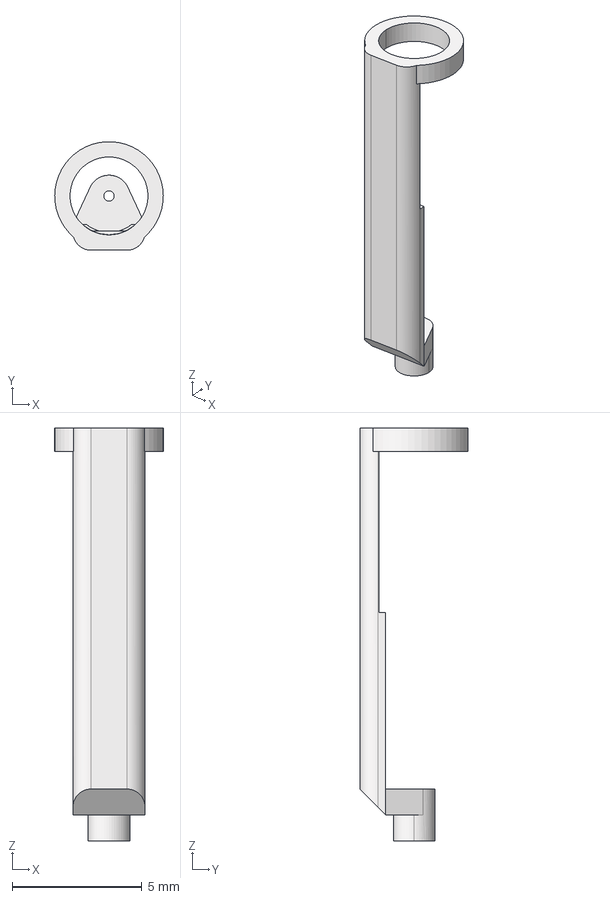
[picture p52: CAD file, 2024-06-14]
drawings/Inventor_Design/Micron22_top_adj_02082013_Inventor2013/Parts/Motor Units/MU_Motor_Asm_Frame_new3.igs
4.18 x 4.18 x 15.9 mm
