robmacl/micron_maxon/cad/exp_fixtures/circle_cross_500.DXF

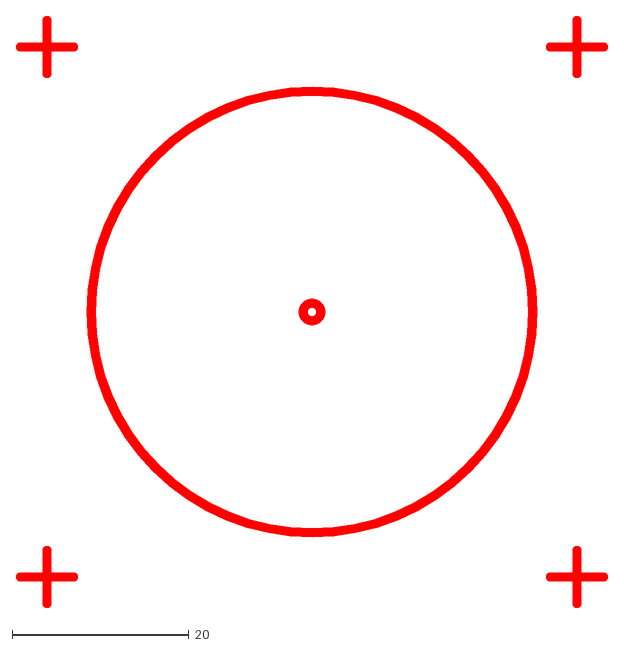
[picture p53: CAD file, 2024-06-14]
cad/exp_fixtures/circle_cross_500.DXF
67.0 x 67.0
