robmacl/micron_maxon/drawings/Inventor_Design/Micron22_top_adj_02082013_Inventor2013/Parts/ASAP/Cad_Drawings/ASAP_Handle_Fixture_New3_inch.dxf

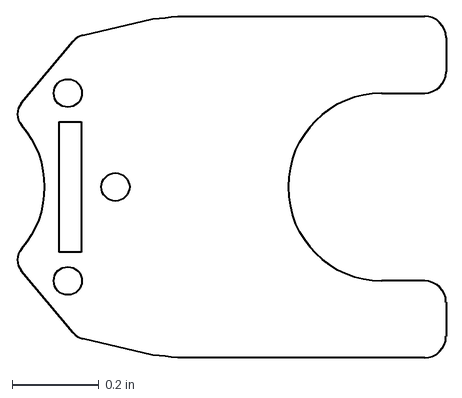
[picture p55: CAD file, 2024-06-14]
drawings/Inventor_Design/Micron22_top_adj_02082013_Inventor2013/Parts/ASAP/Cad_Drawings/ASAP_Handle_Fixture_New3_inch.dxf
0.992 x 0.787 in
