robmacl/micron_maxon/drawings/Inventor_Design/Micron22_top_adj_02082013_Inventor2013/Parts/Handle/STL Files/Handle_Back_Part2.stl

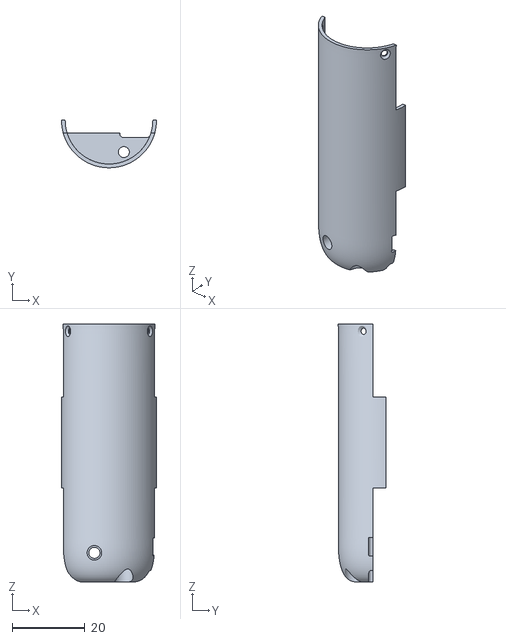
[picture p56: CAD file, 2024-06-14]
drawings/Inventor_Design/Micron22_top_adj_02082013_Inventor2013/Parts/Handle/STL Files/Handle_Back_Part2.stl
26.0 x 13.0 x 70.7
