robmacl/micron_maxon/drawings/Inventor_Design/Micron22_top_adj_02082013_Inventor2013/Parts/Tool/Tool_Mount_Luer_Adapter.igs

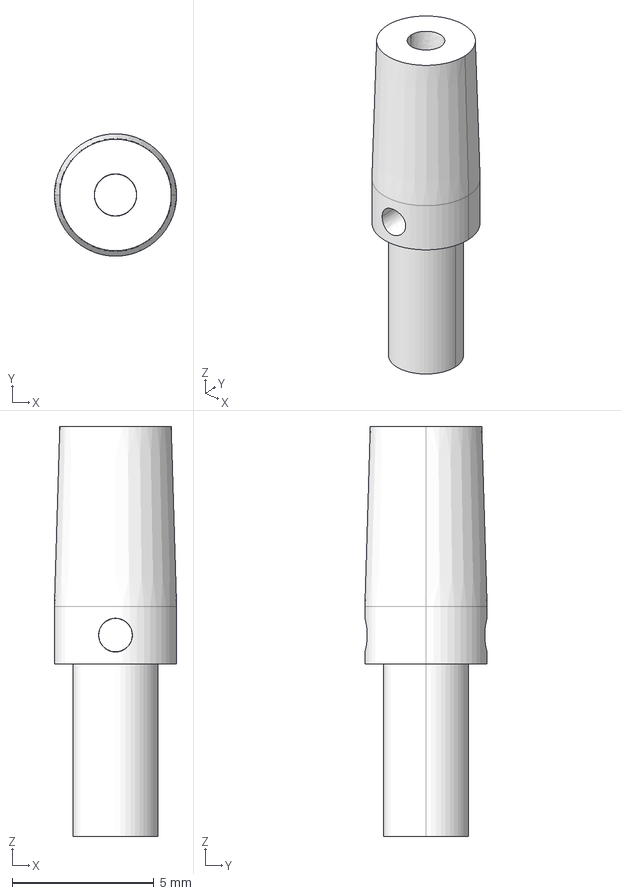
[picture p57: CAD file, 2024-06-14]
drawings/Inventor_Design/Micron22_top_adj_02082013_Inventor2013/Parts/Tool/Tool_Mount_Luer_Adapter.igs
4.32 x 4.32 x 14.5 mm
