robmacl/micron_maxon/drawings/Inventor_Design/Micron22_top_adj_02082013_Inventor2013/Parts/Handle/STL Files/Handle_Back_Part1.stl

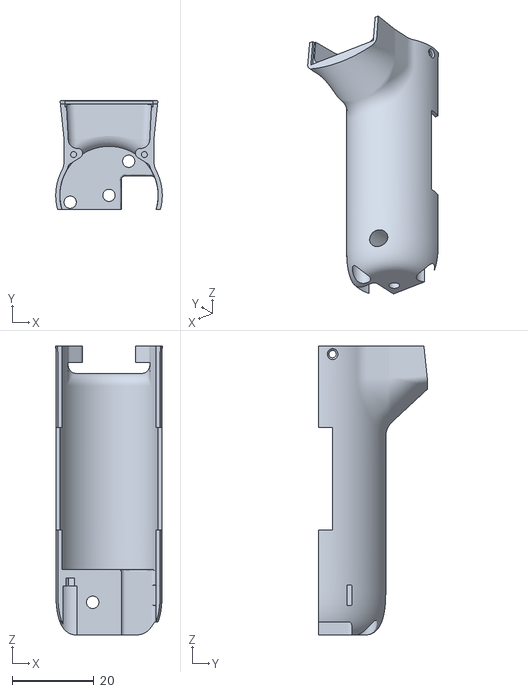
[picture p58: CAD file, 2024-06-14]
drawings/Inventor_Design/Micron22_top_adj_02082013_Inventor2013/Parts/Handle/STL Files/Handle_Back_Part1.stl
26.1 x 26.8 x 70.7
