robmacl/micron_maxon/drawings/Inventor_Design/Micron22_top_adj_02082013_Inventor2013/04192012_New_Front_2pcs/New_Front_Upper_rev3.stl

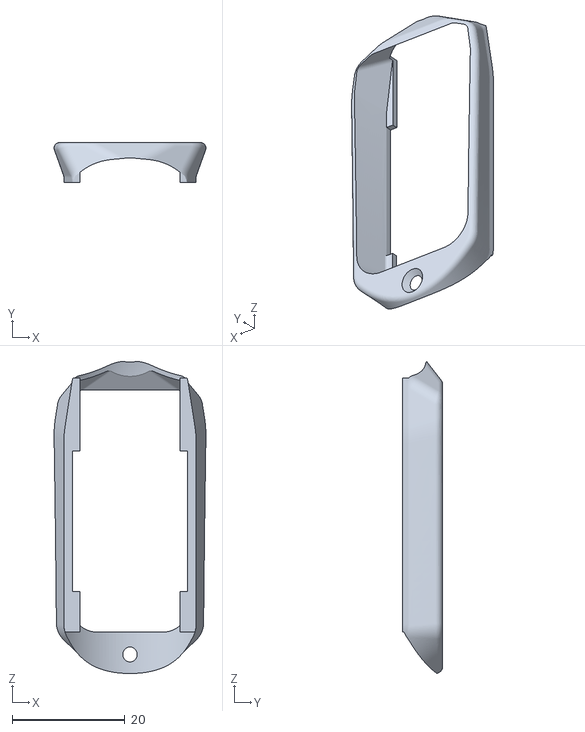
[picture p59: CAD file, 2024-06-14]
drawings/Inventor_Design/Micron22_top_adj_02082013_Inventor2013/04192012_New_Front_2pcs/New_Front_Upper_rev3.stl
26.9 x 7.10 x 55.3
