robmacl/micron_maxon/drawings/Inventor_Design/Micron22_top_adj_02082013_Inventor2013/Parts/ASAP/ASAP_Handle_Fixture_New3_inch2.dxf

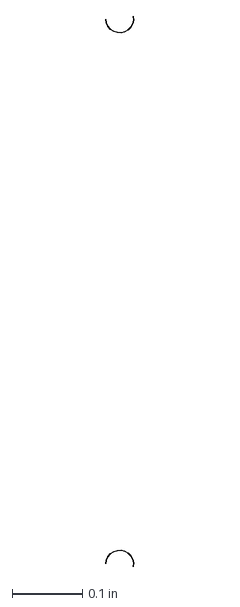
[picture p60: CAD file, 2024-06-14]
drawings/Inventor_Design/Micron22_top_adj_02082013_Inventor2013/Parts/ASAP/ASAP_Handle_Fixture_New3_inch2.dxf
0.0409 x 0.785 in
