robmacl/micron_maxon/drawings/Inventor_Design/Micron22_top_adj_02082013_Inventor2013/Parts/ASAP/Cad_Drawings/ASAP_Mount.dxf

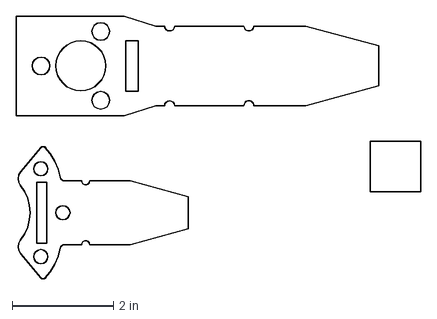
[picture p61: CAD file, 2024-06-14]
drawings/Inventor_Design/Micron22_top_adj_02082013_Inventor2013/Parts/ASAP/Cad_Drawings/ASAP_Mount.dxf
8.00 x 5.19 in
