robmacl/micron_maxon/drawings/Inventor_Design/Micron22_top_adj_02082013_Inventor2013/Parts/Handle/STL Files/Handle_2_Rev_Head.stl

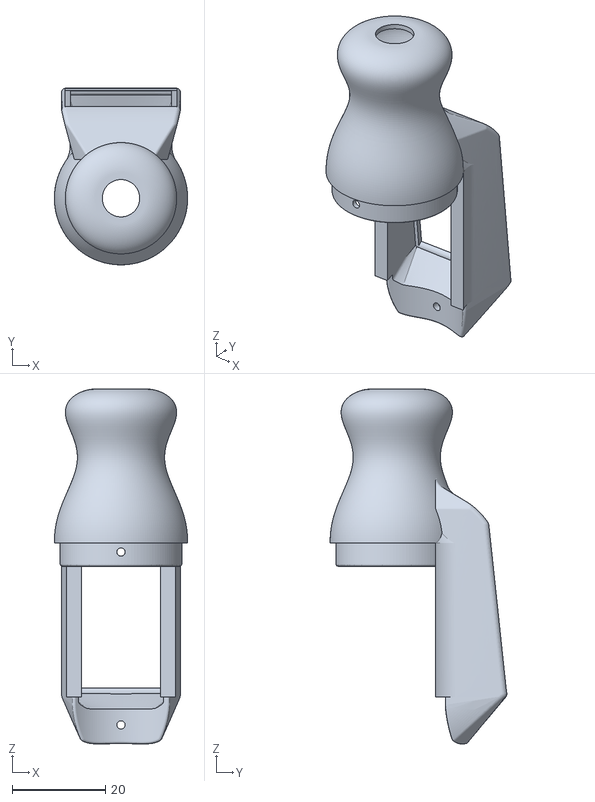
[picture p62: CAD file, 2024-06-14]
drawings/Inventor_Design/Micron22_top_adj_02082013_Inventor2013/Parts/Handle/STL Files/Handle_2_Rev_Head.stl
28.6 x 37.9 x 76.1
