robmacl/micron_maxon/drawings/Inventor_Design/Micron22_top_adj_02082013_Inventor2013/Parts/ASAP/ASAP_Handle_Fixture_New3_re.dxf

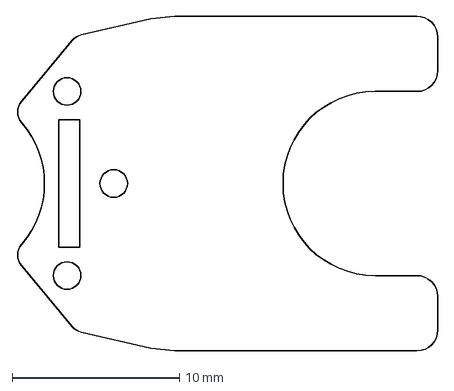
[picture p63: CAD file, 2024-06-14]
drawings/Inventor_Design/Micron22_top_adj_02082013_Inventor2013/Parts/ASAP/ASAP_Handle_Fixture_New3_re.dxf
25.2 x 20.0 mm
