robmacl/micron_maxon/drawings/Inventor_Design/Micron22_top_adj_02082013_Inventor2013/Parts/ASAP/ASAP_Handle_Fixture_New3_inch2_wr.dxf

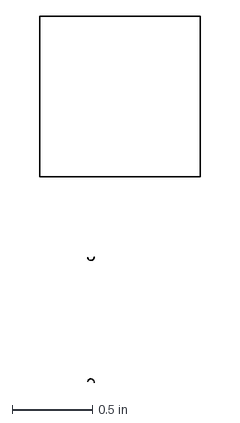
[picture p65: CAD file, 2024-06-14]
drawings/Inventor_Design/Micron22_top_adj_02082013_Inventor2013/Parts/ASAP/ASAP_Handle_Fixture_New3_inch2_wr.dxf
1.00 x 2.28 in
