robmacl/micron_maxon/cad/asap_micron/mechanical/base_assem.sldasm

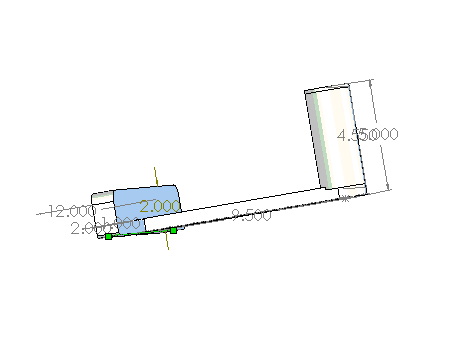
[picture p66: CAD file, 2024-06-14]
cad/asap_micron/mechanical/base_assem.sldasm
base_tube
base_top
base_bar
base_foot
