robmacl/micron_maxon/cad/asap_micron/mechanical/assembly.SLDASM

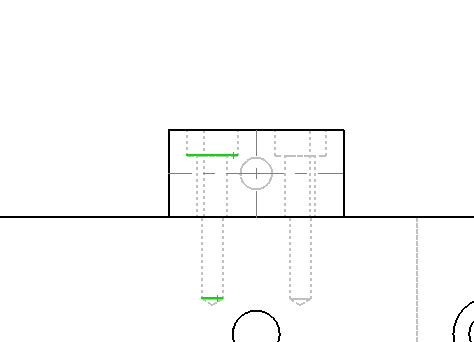
[picture p67: CAD file, 2024-06-14]
cad/asap_micron/mechanical/assembly.SLDASM
bar
camera x 2
ctr_laser_bracket
laser_bracket
lens x 2
Mount block
