robmacl/micron_maxon/(list of files, cad)

Other CAD files:
drawings/Inventor_Design/Micron22_top_adj_02082013_Inventor2013/Drawings/DWG/Bearing_Assembly(Metric).dwg
drawings/Inventor_Design/Micron22_top_adj_02082013_Inventor2013/Drawings/Jigs/ASM_Housing_Bearing_OD.dwg
drawings/Inventor_Design/Micron22_top_adj_02082013_Inventor2013/OCT Probes/OCT_Probe_Asm.dwg
drawings/Inventor_Design/Micron22_top_adj_02082013_Inventor2013/Drawings/ASM_Micron_Rev2_ASAP_FPCB.dwg
drawings/Inventor_Design/Micron22_top_adj_02082013_Inventor2013/Drawings/Jigs/ASM_Coupler_Bearing_ID.dwg
drawings/Inventor_Design/Micron22_top_adj_02082013_Inventor2013/OCT Probes/OCT_Probe_Asm2.dwg
drawings/Inventor_Design/Micron22_top_adj_02082013_Inventor2013/Cannulation/ASM_Micron_ASAP_v4_0_wo_tool.dwg
drawings/Inventor_Design/Micron22_top_adj_02082013_Inventor2013/OCT Probes/OCT_Probe_Asm_03142013.dwg
drawings/Inventor_Design/Micron22_top_adj_02082013_Inventor2013/Drawings/Micron_Bearing_Assembly_Rev2(tol_change)_Metric.dwg
drawings/Inventor_Design/Micron22_top_adj_02082013_Inventor2013/Drawings/ASM_Micron_ASAP_Merge2.dwg
drawings/Inventor_Design/Micron22_top_adj_02082013_Inventor2013/Drawings/ASM_Micron_Rev_with_Jigs_manipulator-1.dwg
drawings/Inventor_Design/Micron22_top_adj_02082013_Inventor2013/Drawings/ASM_Motor_Unit_Rev.dwg
drawings/Inventor_Design/Micron22_top_adj_02082013_Inventor2013/Drawings/ASM_Micron_Matlab_Indication.dwg
drawings/Inventor_Design/Micron22_top_adj_02082013_Inventor2013/Drawings/Micron_Bearing_Assembly_Rev2(tol_change).dwg
drawings/Inventor_Design/Micron22_top_adj_02082013_Inventor2013/Drawings/Micron_Bearing_Assembly_Rev.dwg
drawings/Inventor_Design/Micron22_top_adj_02082013_Inventor2013/Drawings/ASM_Motor_Unit_Rev2.dwg
cad/3dof_handle/mechanical/Micron-PBM4z.dwg
cad/asap_micron/mechanical/base_tube.SLDPRT
cad/Micron CAD/Micron_New_Rev_Base3.dwg
drawings/Inventor_Design/Micron22_top_adj_02082013_Inventor2013/02082012_Fiducail_Markers/Fiducial_Post.dwg
drawings/Inventor_Design/Micron22_top_adj_02082013_Inventor2013/06082012_Outer_Tube/Tube_2D.dwg
drawings/Inventor_Design/Micron22_top_adj_02082013_Inventor2013/Assembly/OCT/DWG_Micron_OCT_Integration.dwg
drawings/Inventor_Design/Micron22_top_adj_02082013_Inventor2013/Cannulation/Cannulation_metric.dwg
drawings/Inventor_Design/Micron22_top_adj_02082013_Inventor2013/Drawings/2D_Al_Tubing/2D_Al_Tubing_2.dwg
drawings/Inventor_Design/Micron22_top_adj_02082013_Inventor2013/Drawings/Micron_New_Rev3.dwg
drawings/Inventor_Design/Micron22_top_adj_02082013_Inventor2013/Parts/ASAP/LED_Mounts_All.dwg
drawings/Inventor_Design/Micron22_top_adj_02082013_Inventor2013/Parts/Handle/ex/handle0.dwg
cad/asap_micron/mechanical/lens.SLDPRT
drawings/Inventor_Design/Micron22_top_adj_02082013_Inventor2013/Cannulation/Cannulation.dwg
drawings/Inventor_Design/Micron22_top_adj_02082013_Inventor2013/Drawings/2D_Al_Tubing/2D_Al_Tubing.dwg
drawings/Inventor_Design/Micron22_top_adj_02082013_Inventor2013/Parts/ASAP/Cad_Drawings/ASAP_Mount_Bottom.dwg
drawings/Inventor_Design/Micron22_top_adj_02082013_Inventor2013/Drawings/Merge_Side.dwg
cad/asap_micron/mechanical/adapter_plate.SLDPRT
drawings/Inventor_Design/Micron22_top_adj_02082013_Inventor2013/Drawings/Micron_New_Rev_Base.dwg
drawings/Inventor_Design/Micron22_top_adj_02082013_Inventor2013/Parts/ASAP/Cad_Drawings/ASAP_Mount_Top.dwg
cad/asap_micron/mechanical/camera.SLDPRT
cad/asap_micron/mechanical/Mount block.SLDPRT
drawings/Inventor_Design/Micron22_top_adj_02082013_Inventor2013/Drawings/Micron_New_Rev_Base2.dwg
cad/asap_micron/mechanical/base_foot.sldprt
drawings/Inventor_Design/Micron22_top_adj_02082013_Inventor2013/Drawings/Merge_Handle.dwg
cad/asap_micron/mechanical/laser_bracket.SLDPRT
drawings/Inventor_Design/Micron22_top_adj_02082013_Inventor2013/Drawings/Merge_Top.dwg
cad/asap_micron/mechanical/bar.SLDPRT
cad/asap_micron/mechanical/ctr_laser_bracket.SLDPRT
cad/asap_micron/mechanical/base_top.SLDPRT
cad/asap_micron/mechanical/base_bar.SLDPRT
drawings/Inventor_Design/Micron22_top_adj_02082013_Inventor2013/Drawings/Top and Base.dwg
drawings/Inventor_Design/Micron22_top_adj_02082013_Inventor2013/Drawings/Micron_New_Rev_Base3.dwg
cad/asap_micron/mechanical/base_draw.SLDDRW
cad/asap_micron/mechanical/drawings.SLDDRW
cad/asap_micron/mechanical/full_size.SLDDRW
drawings/Inventor_Design/Micron22_top_adj_02082013_Inventor2013/02082012_Fiducail_Markers/ASM.iam
drawings/Inventor_Design/Micron22_top_adj_02082013_Inventor2013/02082012_Fiducail_Markers/ASM2.iam
drawings/Inventor_Design/Micron22_top_adj_02082013_Inventor2013/02082012_Fiducail_Markers/ASM_with_Manipulator.iam
drawings/Inventor_Design/Micron22_top_adj_02082013_Inventor2013/02082012_Fiducail_Markers/ASM_with_Micron.iam
drawings/Inventor_Design/Micron22_top_adj_02082013_Inventor2013/02082012_Fiducail_Markers/Fiducial_Post.ipt
drawings/Inventor_Design/Micron22_top_adj_02082013_Inventor2013/02082012_Fiducail_Markers/OldVersions/ASM.0018.iam
drawings/Inventor_Design/Micron22_top_adj_02082013_Inventor2013/02082012_Fiducail_Markers/OldVersions/ASM2.0010.iam
drawings/Inventor_Design/Micron22_top_adj_02082013_Inventor2013/02082012_Fiducail_Markers/OldVersions/ASM_with_Manipulator.0006.iam
drawings/Inventor_Design/Micron22_top_adj_02082013_Inventor2013/02082012_Fiducail_Markers/OldVersions/ASM_with_Micron.0009.iam
drawings/Inventor_Design/Micron22_top_adj_02082013_Inventor2013/02082012_Fiducail_Markers/OldVersions/Fiducial_Post.0008.dwg
drawings/Inventor_Design/Micron22_top_adj_02082013_Inventor2013/02082012_Fiducail_Markers/OldVersions/Fiducial_Post.0030.ipt
drawings/Inventor_Design/Micron22_top_adj_02082013_Inventor2013/02082012_Fiducail_Markers/OldVersions/Post.0007.ipt
drawings/Inventor_Design/Micron22_top_adj_02082013_Inventor2013/02082012_Fiducail_Markers/OldVersions/Short_Needle.0001.ipt
drawings/Inventor_Design/Micron22_top_adj_02082013_Inventor2013/02082012_Fiducail_Markers/OldVersions/Short_Needle.0007.ipt
drawings/Inventor_Design/Micron22_top_adj_02082013_Inventor2013/02082012_Fiducail_Markers/OldVersions/TriPost.0015.ipt
drawings/Inventor_Design/Micron22_top_adj_02082013_Inventor2013/02082012_Fiducail_Markers/Post.ipt
drawings/Inventor_Design/Micron22_top_adj_02082013_Inventor2013/02082012_Fiducail_Markers/Short_Needle.ipt
drawings/Inventor_Design/Micron22_top_adj_02082013_Inventor2013/03172012_Custom_Screw/Custom Screw.dwg
drawings/Inventor_Design/Micron22_top_adj_02082013_Inventor2013/03172012_Custom_Screw/MU_Motor_Thread_Modified.idw
drawings/Inventor_Design/Micron22_top_adj_02082013_Inventor2013/04192012_New_Front_2pcs/New_Front_Base.ipt
drawings/Inventor_Design/Micron22_top_adj_02082013_Inventor2013/04192012_New_Front_2pcs/New_Front_Base_rev.ipt
drawings/Inventor_Design/Micron22_top_adj_02082013_Inventor2013/04192012_New_Front_2pcs/New_Front_Merge.ipt
drawings/Inventor_Design/Micron22_top_adj_02082013_Inventor2013/04192012_New_Front_2pcs/New_Front_Upper.ipt
drawings/Inventor_Design/Micron22_top_adj_02082013_Inventor2013/04192012_New_Front_2pcs/New_Front_Upper_rev.ipt
drawings/Inventor_Design/Micron22_top_adj_02082013_Inventor2013/04192012_New_Front_2pcs/New_Front_Upper_rev2.stl
drawings/Inventor_Design/Micron22_top_adj_02082013_Inventor2013/04192012_New_Front_2pcs/New_Front_Upper_rev_old.ipt
drawings/Inventor_Design/Micron22_top_adj_02082013_Inventor2013/04192012_New_Front_2pcs/New_Front_Upper_rev_v2.ipt
drawings/Inventor_Design/Micron22_top_adj_02082013_Inventor2013/04192012_New_Front_2pcs/New_Front_Upper_rev_v3.ipt
drawings/Inventor_Design/Micron22_top_adj_02082013_Inventor2013/04192012_New_Front_2pcs/OldVersions/New_Front_Base_rev.0031.ipt
drawings/Inventor_Design/Micron22_top_adj_02082013_Inventor2013/04192012_New_Front_2pcs/OldVersions/New_Front_Merge.0015.ipt
drawings/Inventor_Design/Micron22_top_adj_02082013_Inventor2013/04192012_New_Front_2pcs/OldVersions/New_Front_Upper_rev.0056.ipt
drawings/Inventor_Design/Micron22_top_adj_02082013_Inventor2013/04192012_New_Front_2pcs/OldVersions/New_Front_Upper_rev_v2.0007.ipt
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
