robmacl/micron_maxon/cad/Micron CAD/Select tidbits/Assembly_manipulator.jpg

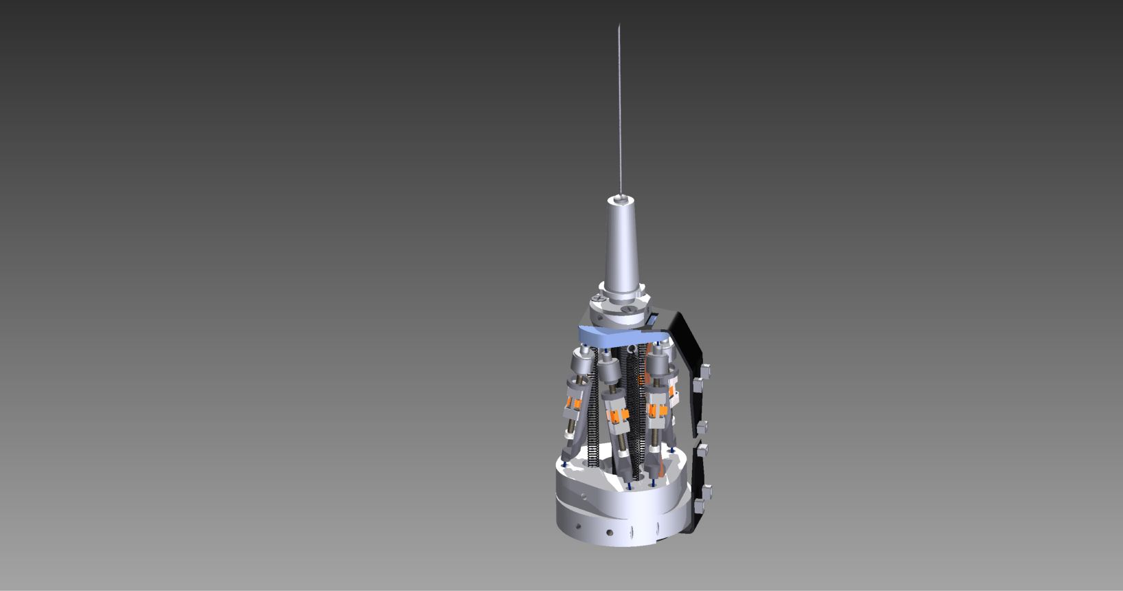
cad/Micron CAD/Select tidbits/Assembly_manipulator.jpg
