robmacl/micron_maxon/drawings/Inventor_Design/Micron22_top_adj_02082013_Inventor2013/05222012_Inner_Guide_Tube/ASM_Micron_with_Inner_Guide.jpg

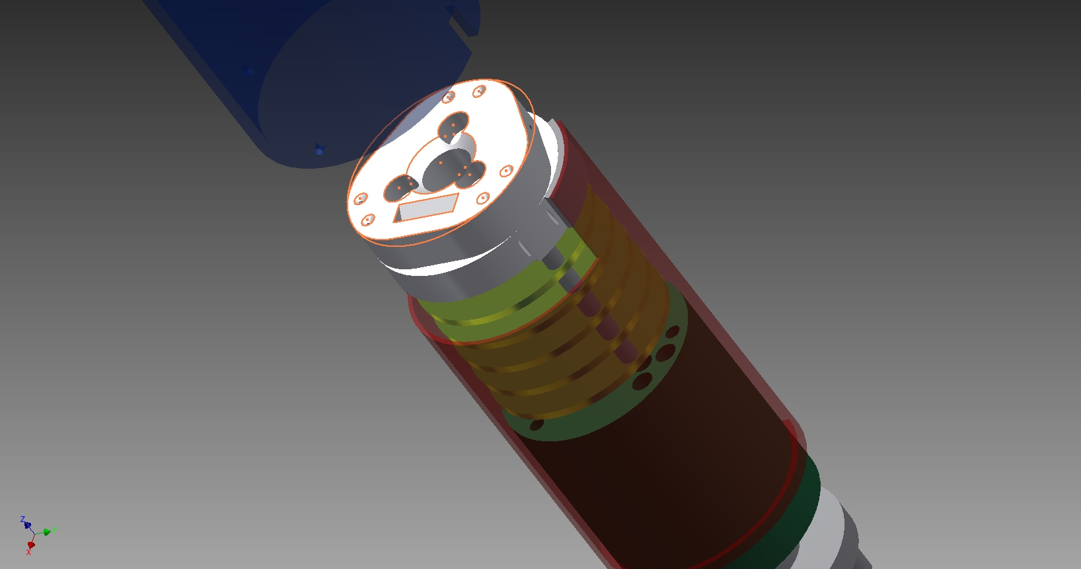
drawings/Inventor_Design/Micron22_top_adj_02082013_Inventor2013/05222012_Inner_Guide_Tube/ASM_Micron_with_Inner_Guide.jpg
