robmacl/micron_maxon/micron/labview/config/SN1/test/30-apr-12/freq_reponse.csv

Axis | 0.0 | 1.0 | 2.0 | 3.0 | 4.0 | 5.0
Gxx 20 Hz | 43.5 | 48.0 | 46.8 | 45.4 | 47.4 | 40.8
Gxx 3 dB | 141.7 | 5.2 | 141.7 | 141.7 | 126.0 | 5.2
Gxy 20 Hz | -18.3 | -18.7 | -9.5 | -11.6 | -15.9 | -16.7
Gxy -14 dB | 63.4 | 85.3 | 5.2 | 5.2 | 56.7 | 5.2
Phase 10 deg | 141.7 | 6.4 | 35.0 | 125.4 | 96.4 | 6.4
