robmacl/micron_maxon/hexapod/calibration_refangle.txt

0.0000000	0.0000000	0.0000000	0.4225887	0.3531663	0.3356417	0.4203384	0.4184356	0.5316067	0.3418544	0.2476595	0.4220374	0.4422272	0.1102258	0.1135686	0.2810811	0.3704242	0.2492310	0.1833477	1516.0523492	-11953.2989616	-1112.5735378	-2193.7348887	-11747.2495231	-6205.0063849	393.2764435	46.0900147
0.0000000	0.0000000	0.0000000	0.4058921	0.3852530	0.2633384	0.3628916	0.3707317	0.5093236	0.3008058	0.2441933	0.3261129	0.3336033	0.2105018	0.2322482	0.2825439	0.3749723	0.2530829	0.1896889	3555.4385967	-4770.3159891	-1170.0632116	-30.5117699	-3987.4702335	-6289.8520844	502.9971590	169.9345986
0.0000000	0.0000000	0.0000000	0.3332142	0.2957910	0.3797278	0.5193448	0.3222859	0.4714772	0.3915800	0.3484949	0.3963842	0.4331677	0.1617968	0.1829080	0.2400114	0.3467508	0.3167646	0.2678328	-1897.2496711	-8416.7273619	2660.5564642	-5882.8242750	-7933.1492322	-2227.4935380	447.2520060	188.7555363
0.0000000	0.0000000	0.0000000	0.4801380	0.4233131	0.2067404	0.2703985	0.4435807	0.5447104	0.2464354	0.1550536	0.3464092	0.3419662	0.1581472	0.1631978	0.3074204	0.3784313	0.1956895	0.1250768	7016.6359251	-8178.9825377	-4615.2345231	3658.5185575	-7639.1660756	-10004.9152290	496.1687500	243.5016681
0.0000000	0.0000000	0.0000000	0.4461579	0.4197341	0.3186068	0.4474237	0.4422350	0.6213214	0.3251405	0.2518955	0.4203113	0.4407170	0.0994614	0.1013821	0.2867765	0.3744887	0.2309420	0.1655417	2470.0360373	-12680.0060925	-2062.6246793	-1161.0061359	-12525.0395159	-7222.3835088	385.2578267	86.0932085
0.0000000	0.0000000	0.0000000	0.3762344	0.3153187	0.2777897	0.3390857	0.3417383	0.4235923	0.3140290	0.2358134	0.3191085	0.3249883	0.2221239	0.2465115	0.2688579	0.3608684	0.2715704	0.2095404	2330.3353483	-3992.0309290	38.9379054	-1361.9862852	-3128.7474806	-5004.5024851	481.8006360	149.6138093
