robmacl/micron_maxon/asap/cal_data/SN1/hex27/calibration_ref.txt

0.0000000	0.0000000	0.0000000	-3.0000000	-3.0000000	-3.0000000	0.0000000	0.0000000	0.0000000	-0.0000037	0.0975940	0.0000005	0.0654851	-0.0000191	0.0977703	-0.0000120	0.0653014	-0.0000036	0.0839197	-0.0000001	0.0708868	-0.0000101	0.0885224	-0.0000201	0.0664909	-8565.3193823	-21479.3571718	1764.5191820	3324.0939042	-2173.3270931	-3026.4468225	10614.9874698	674.6699377
0.0000000	0.0000000	0.0000000	0.0000000	-3.0000000	-3.0000000	0.0000000	0.0000000	0.0000000	-0.0000034	0.0985367	0.0000000	0.0655916	-0.0000166	0.0864959	-0.0000124	0.0776265	-0.0000029	0.0830457	-0.0000021	0.0699457	-0.0000097	0.0766159	-0.0000189	0.0765666	-6479.5417501	-8601.7772967	1481.4650743	3380.3395282	-2164.3514062	-140.1234169	10087.2051316	581.9472778
