robmacl/micron_maxon/asap/cal_data/SN1/new_probe/axis_sweep_test_new2_2x_out.xlsx

Sheet: Sheet1
 |  | Integral non-linearity
 |  | mm |  |  | degrees
 |  | X | Y | Z | Rx | Ry | Rz
On axis | RMS | 0.003 | 0.003 | 0.003 | 0.031 | 0.019 | 0.130
 | MAV | 0.007 | 0.005 | 0.006 | 0.058 | 0.047 | 0.307
Off axis | RMS | 0.003 | 0.002 | 0.004 | 0.025 | 0.027 | 0.090
 | MAV | 0.005 | 0.004 | 0.006 | 0.055 | 0.061 | 0.202
To Rz | RMS | 0.053 | 0.128 | 0.073 | 0.056 | 0.130 | 0.130
 | MAV | 0.087 | 0.207 | 0.191 | 0.112 | 0.201 | 0.307
Cross | RMS | 0.048 | 0.038 | 0.054 | 0.004 | 0.008 | 0.057
 | MAV | 0.083 | 0.052 | 0.081 | 0.007 | 0.014 | 0.102
 |  | degrees |  |  | mm
 |  | Differential non-linearity
 |  | X | Y | Z | Rx | Ry | Rz
On axis | RMS | 0.2% | 0.3% | 0.2% | 0.9% | 0.7% | 8.7%
 | MAV | 0.5% | 0.6% | 0.4% | 2.0% | 1.7% | 18.4%
Off axis | RMS | 0.3% | 0.2% | 0.3% | 0.8% | 1.5% | 4.9%
 | MAV | 0.5% | 0.3% | 0.8% | 1.7% | 3.1% | 11.0%
To Rz | RMS | 0.074 | 0.051 | 0.041 | 2.6% | 2.6% | 8.7%
 | MAV | 0.155 | 0.103 | 0.140 | 5.8% | 4.8% | 18.4%
Cross | RMS | 0.025 | 0.022 | 0.029 | 0.001 | 0.002 | 0.009 | To Rz | RMS | To Rz | RMS | To Rz | RMS | To Rz | RMS | To Rz | RMS | To Rz | RMS
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
