robmacl/micron_maxon/asap/cal_data/SN1/new_probe/axis_sweep_test_new2_2x_out_o17.xlsx

Sheet: Sheet1
 |  | Integral non-linearity
 |  | mm |  |  | degrees
 |  | X | Y | Z | Rx | Ry | Rz
On axis | RMS | 0.001 | 0.003 | 0.002 | 0.020 | 0.012 | 0.110
 | MAV | 0.004 | 0.004 | 0.005 | 0.031 | 0.020 | 0.212
Off axis | RMS | 0.002 | 0.002 | 0.004 | 0.016 | 0.023 | 0.067
 | MAV | 0.004 | 0.003 | 0.006 | 0.035 | 0.042 | 0.138
To Rz | RMS | 0.046 | 0.105 | 0.062 | 0.054 | 0.101 | 0.110
 | MAV | 0.082 | 0.170 | 0.088 | 0.097 | 0.172 | 0.212
Cross | RMS | 0.050 | 0.034 | 0.051 | 0.003 | 0.006 | 0.043
 | MAV | 0.079 | 0.052 | 0.076 | 0.004 | 0.009 | 0.075
 |  | degrees |  |  | mm
 |  | Differential non-linearity
 |  | X | Y | Z | Rx | Ry | Rz
On axis | RMS | 0.1% | 0.1% | 0.1% | 0.6% | 0.4% | 1.6%
 | MAV | 0.3% | 0.3% | 0.2% | 0.8% | 0.9% | 2.5%
Off axis | RMS | 0.1% | 0.1% | 0.1% | 0.4% | 0.7% | 2.0%
 | MAV | 0.2% | 0.2% | 0.2% | 0.8% | 1.4% | 3.8%
To Rz | RMS | 0.034 | 0.052 | 0.018 | 1.2% | 2.5% | 1.6%
 | MAV | 0.051 | 0.074 | 0.043 | 1.9% | 3.5% | 2.5%
Cross | RMS | 0.016 | 0.012 | 0.015 | 0.001 | 0.002 | 0.009 | To Rz | RMS | To Rz | RMS | To Rz | RMS | To Rz | RMS | To Rz | RMS | To Rz | RMS
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
