robmacl/micron_maxon/asap/cal_data/SN1/new_probe/axis_sweep_test_new2_2x_out_save_o9.xlsx

Sheet: Sheet1
 |  | Integral non-linearity
 |  | mm |  |  | degrees
 |  | X | Y | Z | Rx | Ry | Rz
On axis | RMS | 0.002 | 0.003 | 0.003 | 0.028 | 0.015 | 0.127
 | MAV | 0.007 | 0.004 | 0.006 | 0.053 | 0.032 | 0.293
Off axis | RMS | 0.002 | 0.002 | 0.004 | 0.023 | 0.024 | 0.080
 | MAV | 0.004 | 0.004 | 0.006 | 0.055 | 0.043 | 0.171
To Rz | RMS | 0.053 | 0.120 | 0.066 | 0.055 | 0.119 | 0.127
 | MAV | 0.083 | 0.191 | 0.134 | 0.109 | 0.183 | 0.293
Cross | RMS | 0.049 | 0.038 | 0.054 | 0.003 | 0.008 | 0.052
 | MAV | 0.083 | 0.052 | 0.079 | 0.007 | 0.012 | 0.093
 |  | degrees |  |  | mm
 |  | Differential non-linearity
 |  | X | Y | Z | Rx | Ry | Rz
On axis | RMS | 0.2% | 0.2% | 0.1% | 0.8% | 0.6% | 5.6%
 | MAV | 0.3% | 0.4% | 0.3% | 1.5% | 1.5% | 11.7%
Off axis | RMS | 0.2% | 0.1% | 0.2% | 0.7% | 1.2% | 4.1%
 | MAV | 0.3% | 0.2% | 0.4% | 1.4% | 2.5% | 9.4%
To Rz | RMS | 0.048 | 0.050 | 0.029 | 2.2% | 2.6% | 5.6%
 | MAV | 0.098 | 0.092 | 0.097 | 4.5% | 4.4% | 11.7%
Cross | RMS | 0.021 | 0.017 | 0.022 | 0.001 | 0.002 | 0.009 | To Rz | RMS | To Rz | RMS | To Rz | RMS | To Rz | RMS | To Rz | RMS | To Rz | RMS
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
