robmacl/micron_maxon/asap/cal_data/SN1/new_probe/axis_sweep_test_new2_out.xlsx

Sheet: Sheet1
 |  | Integral non-linearity
 |  | mm |  |  | degrees
 |  | X | Y | Z | Rx | Ry | Rz
On axis | RMS | 0.003 | 0.003 | 0.003 | 0.032 | 0.017 | 0.127
 | MAV | 0.005 | 0.006 | 0.006 | 0.051 | 0.045 | 0.297
Off axis | RMS | 0.003 | 0.003 | 0.005 | 0.026 | 0.030 | 0.083
 | MAV | 0.006 | 0.005 | 0.007 | 0.056 | 0.055 | 0.183
To Rz | RMS | 0.058 | 0.119 | 0.052 | 0.054 | 0.122 | 0.127
 | MAV | 0.095 | 0.199 | 0.119 | 0.109 | 0.187 | 0.297
Cross | RMS | 0.044 | 0.037 | 0.053 | 0.004 | 0.007 | 0.054
 | MAV | 0.077 | 0.051 | 0.078 | 0.007 | 0.013 | 0.093
 |  | degrees |  |  | mm
 |  | Differential non-linearity
 |  | X | Y | Z | Rx | Ry | Rz
On axis | RMS | 0.2% | 0.2% | 0.1% | 0.8% | 0.6% | 5.8%
 | MAV | 0.4% | 0.5% | 0.3% | 1.5% | 1.5% | 12.5%
Off axis | RMS | 0.2% | 0.1% | 0.2% | 0.7% | 1.3% | 4.2%
 | MAV | 0.4% | 0.2% | 0.5% | 1.4% | 2.9% | 9.6%
To Rz | RMS | 0.049 | 0.050 | 0.028 | 2.2% | 2.6% | 5.8%
 | MAV | 0.104 | 0.096 | 0.105 | 4.5% | 4.4% | 12.5%
Cross | RMS | 0.021 | 0.017 | 0.022 | 0.001 | 0.002 | 0.009 | To Rz | RMS | To Rz | RMS | To Rz | RMS | To Rz | RMS | To Rz | RMS | To Rz | RMS
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
