robmacl/micron_maxon/asap/cal_data/SN1/new_probe/axis_sweep_test_new_out.xlsx

Sheet: Sheet1
 |  | Integral non-linearity
 |  | mm |  |  | degrees
 |  | X | Y | Z | Rx | Ry | Rz
On axis | RMS | 0.006 | 0.011 | 0.006 | 0.033 | 0.020 | 0.115
 | MAV | 0.008 | 0.022 | 0.011 | 0.058 | 0.060 | 0.234
Off axis | RMS | 0.009 | 0.007 | 0.008 | 0.028 | 0.024 | 0.106
 | MAV | 0.012 | 0.011 | 0.013 | 0.056 | 0.043 | 0.215
To Rz | RMS | 0.091 | 0.360 | 0.094 | 0.048 | 0.108 | 0.115
 | MAV | 0.140 | 0.752 | 0.190 | 0.100 | 0.238 | 0.234
Cross | RMS | 0.042 | 0.077 | 0.074 | 0.005 | 0.012 | 0.055
 | MAV | 0.069 | 0.153 | 0.127 | 0.007 | 0.019 | 0.107
 |  | degrees |  |  | mm
 |  | Differential non-linearity
 |  | X | Y | Z | Rx | Ry | Rz
On axis | RMS | 0.2% | 0.3% | 0.1% | 0.8% | 0.6% | 6.4%
 | MAV | 0.5% | 1.0% | 0.3% | 1.6% | 1.4% | 13.9%
Off axis | RMS | 0.2% | 0.1% | 0.2% | 0.6% | 1.4% | 4.3%
 | MAV | 0.3% | 0.3% | 0.4% | 1.2% | 3.0% | 9.4%
To Rz | RMS | 0.050 | 0.049 | 0.060 | 2.4% | 2.5% | 6.4%
 | MAV | 0.105 | 0.137 | 0.182 | 4.8% | 4.1% | 13.9%
Cross | RMS | 0.021 | 0.022 | 0.022 | 0.001 | 0.003 | 0.009 | To Rz | RMS | To Rz | RMS | To Rz | RMS | To Rz | RMS | To Rz | RMS | To Rz | RMS
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
