robmacl/micron_maxon/asap/cal_data/SN1/new_probe/axis_sweep_test_out_new_floc.xlsx

Sheet: Sheet1
 |  | Integral non-linearity
 |  | mm |  |  | degrees
 |  | X | Y | Z | Rx | Ry | Rz
On axis | RMS | 0.003 | 0.004 | 0.004 | 0.032 | 0.028 | 0.111
 | MAV | 0.008 | 0.006 | 0.008 | 0.051 | 0.071 | 0.269
Off axis | RMS | 0.003 | 0.002 | 0.005 | 0.049 | 0.029 | 0.089
 | MAV | 0.005 | 0.004 | 0.007 | 0.083 | 0.053 | 0.194
To Rz | RMS | 0.074 | 0.121 | 0.036 | 0.044 | 0.114 | 0.111
 | MAV | 0.119 | 0.223 | 0.096 | 0.078 | 0.217 | 0.269
Cross | RMS | 0.053 | 0.047 | 0.061 | 0.004 | 0.007 | 0.053
 | MAV | 0.080 | 0.065 | 0.085 | 0.006 | 0.011 | 0.092
 |  | degrees |  |  | mm
 |  | Differential non-linearity
 |  | X | Y | Z | Rx | Ry | Rz
On axis | RMS | 0.2% | 0.2% | 0.2% | 0.8% | 0.6% | 5.8%
 | MAV | 0.4% | 0.6% | 0.3% | 1.6% | 1.5% | 12.6%
Off axis | RMS | 0.1% | 0.1% | 0.2% | 0.7% | 1.3% | 4.2%
 | MAV | 0.5% | 0.2% | 0.5% | 1.3% | 3.0% | 9.5%
To Rz | RMS | 0.049 | 0.050 | 0.028 | 2.3% | 2.6% | 5.8%
 | MAV | 0.104 | 0.098 | 0.105 | 4.6% | 4.3% | 12.6%
Cross | RMS | 0.021 | 0.017 | 0.022 | 0.001 | 0.002 | 0.009 | To Rz | RMS | To Rz | RMS | To Rz | RMS | To Rz | RMS | To Rz | RMS | To Rz | RMS
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
