robmacl/micron_maxon/micron/matlab/Data_Analysis/Linearization_fitting/1.3k_amp_sq_calibrate.xlsx

Sheet: Sheet1
Motor command - Plot 0 | Velocity (mm/sec) - Plot 0 | Motor command - Plot 1 | Velocity (mm/sec) - Plot 1 | Motor command - Plot 2 | Velocity (mm/sec) - Plot 2 | Motor command - Plot 3 | Velocity (mm/sec) - Plot 3 | Motor command - Plot 4 | Velocity (mm/sec) - Plot 4 | Motor command - Plot 5 | Velocity (mm/sec) - Plot 5 | Motor command - Plot 6 | Velocity (mm/sec) - Plot 6 | Motor command - Plot 7 | Velocity (mm/sec) - Plot 7 | Motor command - Plot 8 | Velocity (mm/sec) - Plot 8 | Motor command - Plot 9 | Velocity (mm/sec) - Plot 9 | Motor command - Plot 10 | Velocity (mm/sec) - Plot 10 | Motor command - Plot 11 | Velocity (mm/sec) - Plot 11
-0.89899 | -19.9764 | -0.939394 | -19.5301 | -0.69697 | -19.6703 | -0.737374 | -19.1344 | -0.919192 | -19.7661 | -0.818182 | -19.2995 | -0.322833 | -4.20558 | -0.285281 | -2.06292 | -0.265656 | -2.75169 | -0.248862 | -2.82762 | -0.27706 | -4.87413 | -0.272615 | -2.32712
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
