robmacl/micron_maxon/micron/matlab/Data_Analysis/Linearization_fitting/1.3k_amp_sq_calibrate_new.xlsx

Motor command - Plot 0 | Velocity (mm/sec) - Plot 0 | Motor command - Plot 1 | Velocity (mm/sec) - Plot 1 | Motor command - Plot 2 | Velocity (mm/sec) - Plot 2 | Motor command - Plot 3 | Velocity (mm/sec) - Plot 3 | Motor command - Plot 4 | Velocity (mm/sec) - Plot 4 | Motor command - Plot 5 | Velocity (mm/sec) - Plot 5 | Motor command - Plot 6 | Velocity (mm/sec) - Plot 6 | Motor command - Plot 7 | Velocity (mm/sec) - Plot 7 | Motor command - Plot 8 | Velocity (mm/sec) - Plot 8 | Motor command - Plot 9 | Velocity (mm/sec) - Plot 9 | Motor command - Plot 10 | Velocity (mm/sec) - Plot 10 | Motor command - Plot 11 | Velocity (mm/sec) - Plot 11
-0.757576 | -19.3059 | -0.757576 | -19.2607 | -0.79798 | -19.2847 | -0.79798 | -19.9031 | -0.757576 | -19.8783 | -0.777778 | -19.2209 | -0.304953 | -4.5525 | -0.394973 | -3.76829 | -0.397494 | -6.14234 | -0.368033 | -4.5159 | -0.341413 | -4.30028 | -0.391642 | -3.77316
-0.737374 | -18.343 | -0.737374 | -18.1502 | -0.777778 | -18.3573 | -0.777778 | -18.9574 | -0.737374 | -18.8866 | -0.757576 | -18.1521 | 0.0773693 | 1.18385 | -0.133006 | -0.920891 | 0.258577 | 1.03285 | -0.00773474 | -0.142436 | -0.0372502 | -0.630106 | -0.157567 | -1.40969
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
