robmacl/micron_maxon/micron/matlab/Data_Analysis/Linearization_fitting/1.3k_amp_sq_calibrate_new2_06122013.xlsx

Sheet: deci7
Motor command - Plot 0 | Velocity (mm/sec) - Plot 0 | Motor command - Plot 1 | Velocity (mm/sec) - Plot 1 | Motor command - Plot 2 | Velocity (mm/sec) - Plot 2 | Motor command - Plot 3 | Velocity (mm/sec) - Plot 3 | Motor command - Plot 4 | Velocity (mm/sec) - Plot 4 | Motor command - Plot 5 | Velocity (mm/sec) - Plot 5 | Motor command - Plot 6 | Velocity (mm/sec) - Plot 6 | Motor command - Plot 7 | Velocity (mm/sec) - Plot 7 | Motor command - Plot 8 | Velocity (mm/sec) - Plot 8 | Motor command - Plot 9 | Velocity (mm/sec) - Plot 9 | Motor command - Plot 10 | Velocity (mm/sec) - Plot 10 | Motor command - Plot 11 | Velocity (mm/sec) - Plot 11
-0.818182 | -24.3645 | -0.89899 | -24.6879 | -0.717172 | -24.2875 | -0.89899 | -24.8569 | -0.79798 | -23.9639 | -0.676768 | -24.524 | -0.262657 | -3.42841 | -0.330523 | -2.75917 | -0.308299 | -4.76402 | -0.316642 | -3.37665 | -0.29928 | -2.99708 | -0.304049 | -4.32364
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
