robmacl/micron_maxon/micron/labview/config/SN1/test/30-apr-12/sq_calibrate.csv

Axis | 0.00 | 1.00 | 2.00 | 3.00 | 4.00 | 5.00
y'(0) | 11.49 | 2.84 | 4.24 | 11.02 | 8.83 | 8.13
y'(-0.8) | 63.01 | 50.72 | 124.74 | 72.28 | 79.91 | 47.91
y'(0.8) | 40.78 | 31.92 | 82.81 | 55.99 | 55.48 | 15.36
y(-0.8) | -24.73 | -16.34 | -38.37 | -26.48 | -27.68 | -19.43
y(0.8) | 15.21 | 8.72 | 21.49 | 19.48 | 17.84 | 6.11
Residue | 0.86 | 2.08 | 0.94 | 0.57 | 0.79 | 1.53
P0 | -0.32 | -0.05 | -0.05 | -0.24 | -0.03 | -0.15
P1 | 11.49 | 2.84 | 4.24 | 11.02 | 8.83 | 8.13
P2 | -6.95 | -5.87 | -13.10 | -5.09 | -7.64 | -10.17
P3 | 21.04 | 20.04 | 51.84 | 27.66 | 30.66 | 12.24
