robmacl/micron_maxon/drawings/Fiducials/test.jpg

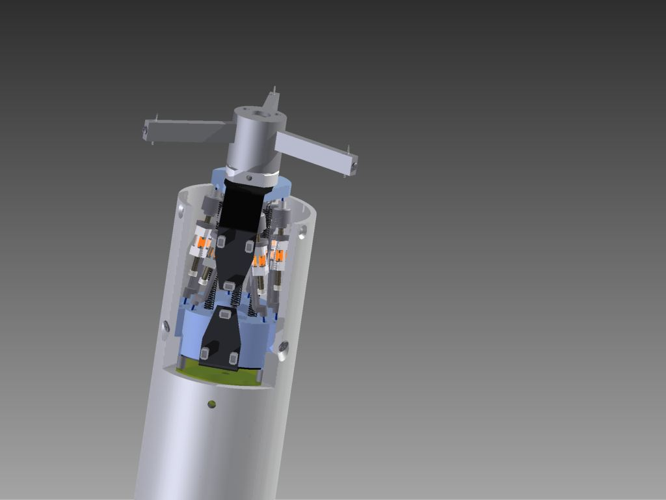
drawings/Fiducials/test.jpg
