robmacl/micron_maxon/drawings/Micron_Bearing_Assembly_Rev2_10302012.pdf

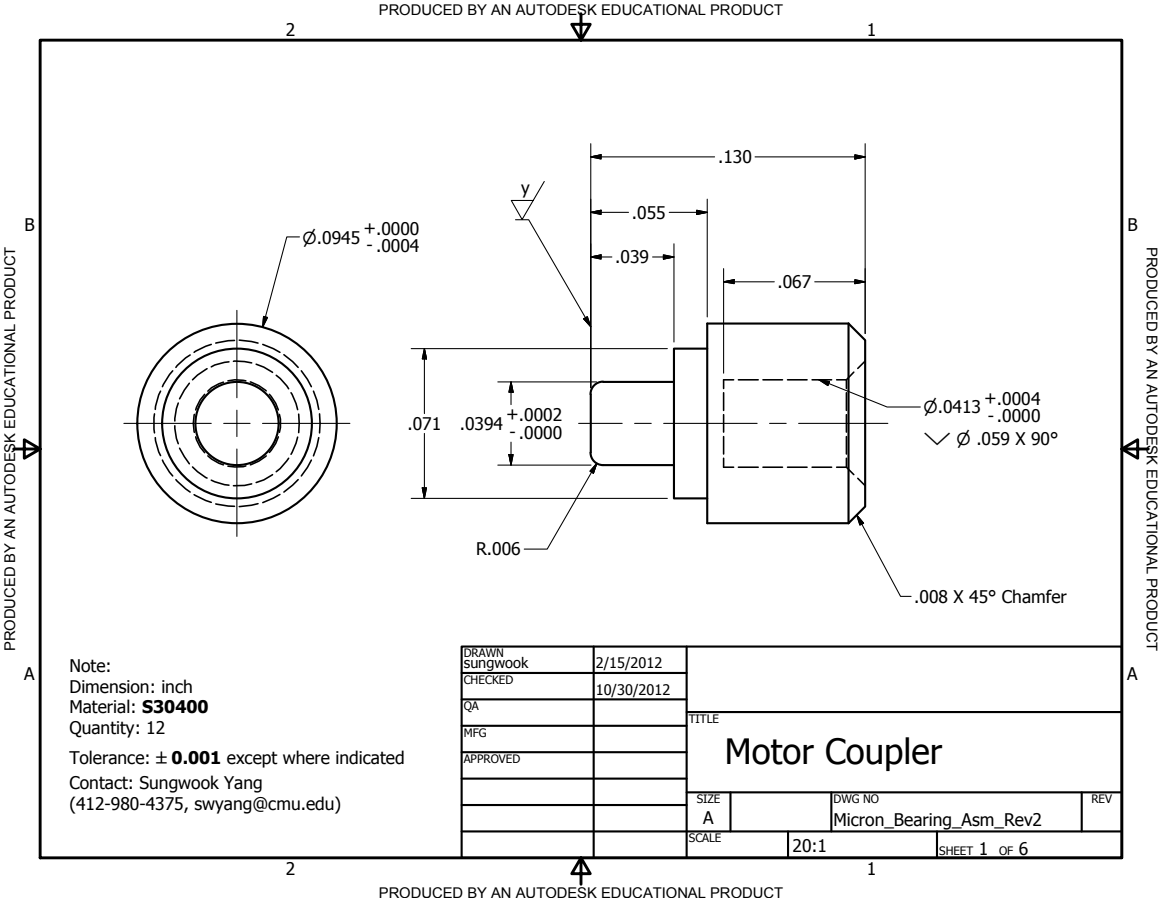
[picture p71: page 1]
TIO; A U T O D E S K E D U C A TIO; DRAWN sungwook; CHECKED; MFG; APPROVED; TITLE; SIZE A; SCALE; DWG NO Micron_Bearing_Asm_Rev2; REV; SHEET 1 OF 6; .008 X 45° Chamfer; Note:; Motor Coupler

Dimension: inch
Material: S30400
Quantity: 12
Tolerance: B0.001 except where indicated
Contact: Sungwook Yang
(412-980-4375, swyang@cmu.edu)

PRODUCED BY AN AUTODESK EDUCATIONAL PRODUCT

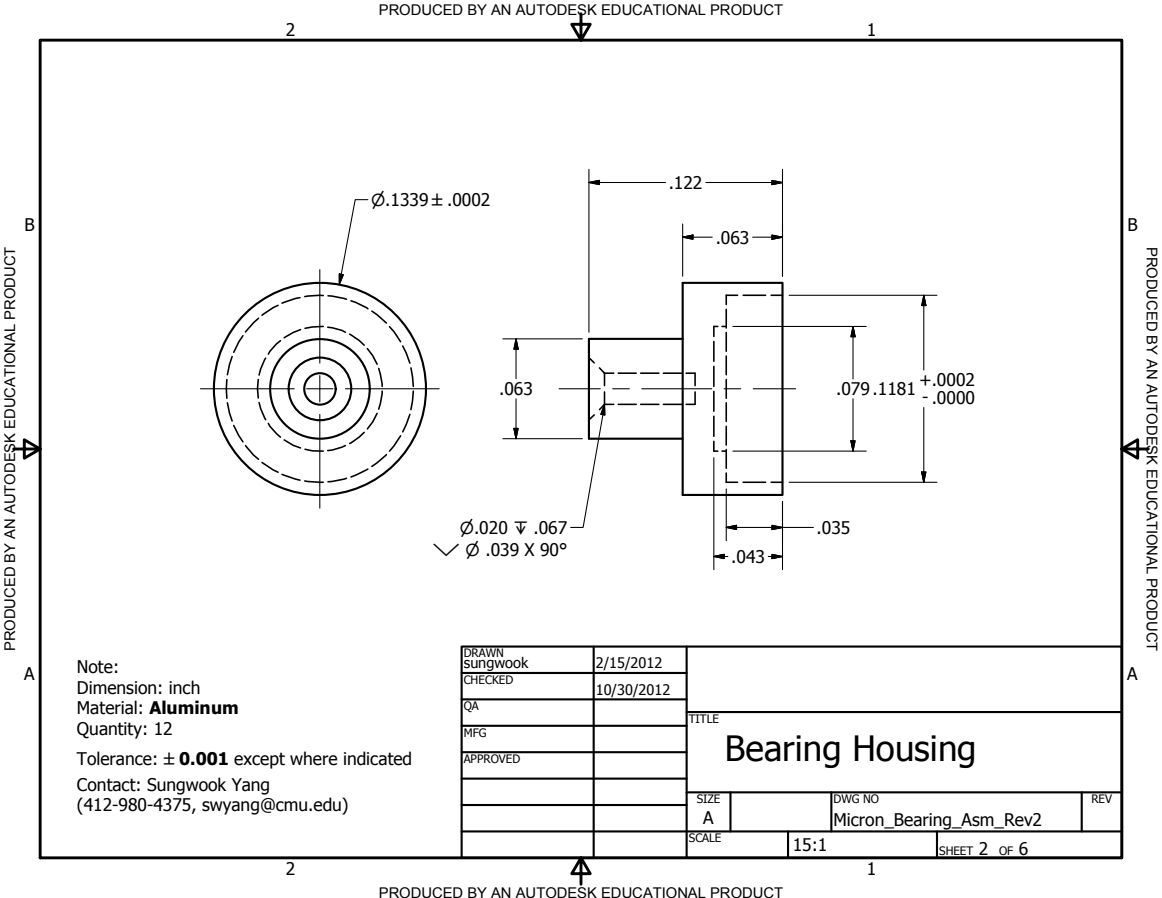
[picture p72: page 2]
TIO; A U T O D E S K E D U C A TIO; DRAWN sungwook; CHECKED; MFG; APPROVED; TITLE; SIZE A; DWG NO Micron_Bearing_Asm_Rev2; REV; Bearing Housing

Note:
Dimension: inch
Material: Aluminum
Quantity: 12
Tolerance: B0.001 except where indicated
Contact: Sungwook Yang
(412-980-4375, swyang@cmu.edu)

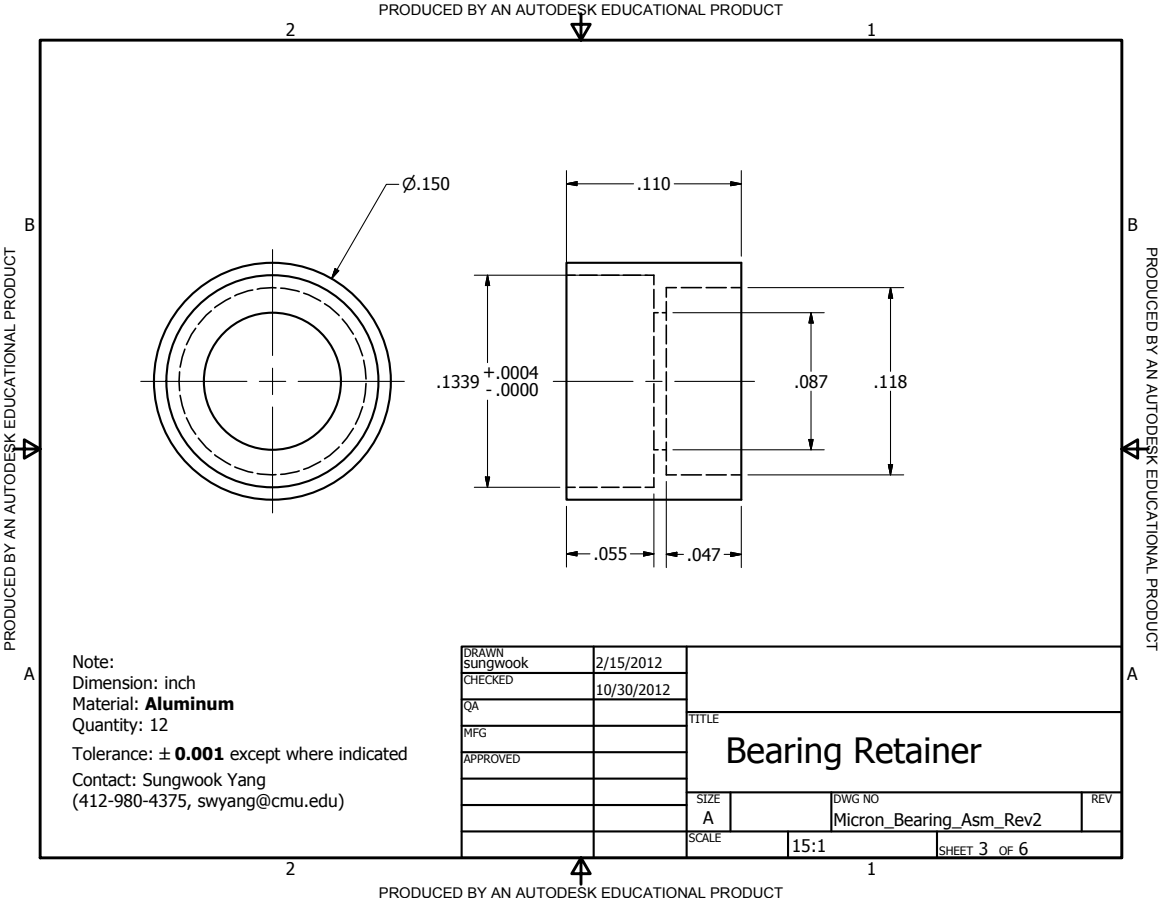
[picture p73: page 3]
TIO; A U T O D E S K E D U C A TIO; DRAWN sungwook; CHECKED; MFG; APPROVED; TITLE; SIZE A; DWG NO Micron_Bearing_Asm_Rev2; REV; Note:; Bearing Retainer

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
