robmacl/micron_maxon/drawings/Jigs/Bearing_Assembly_Jigs.pdf

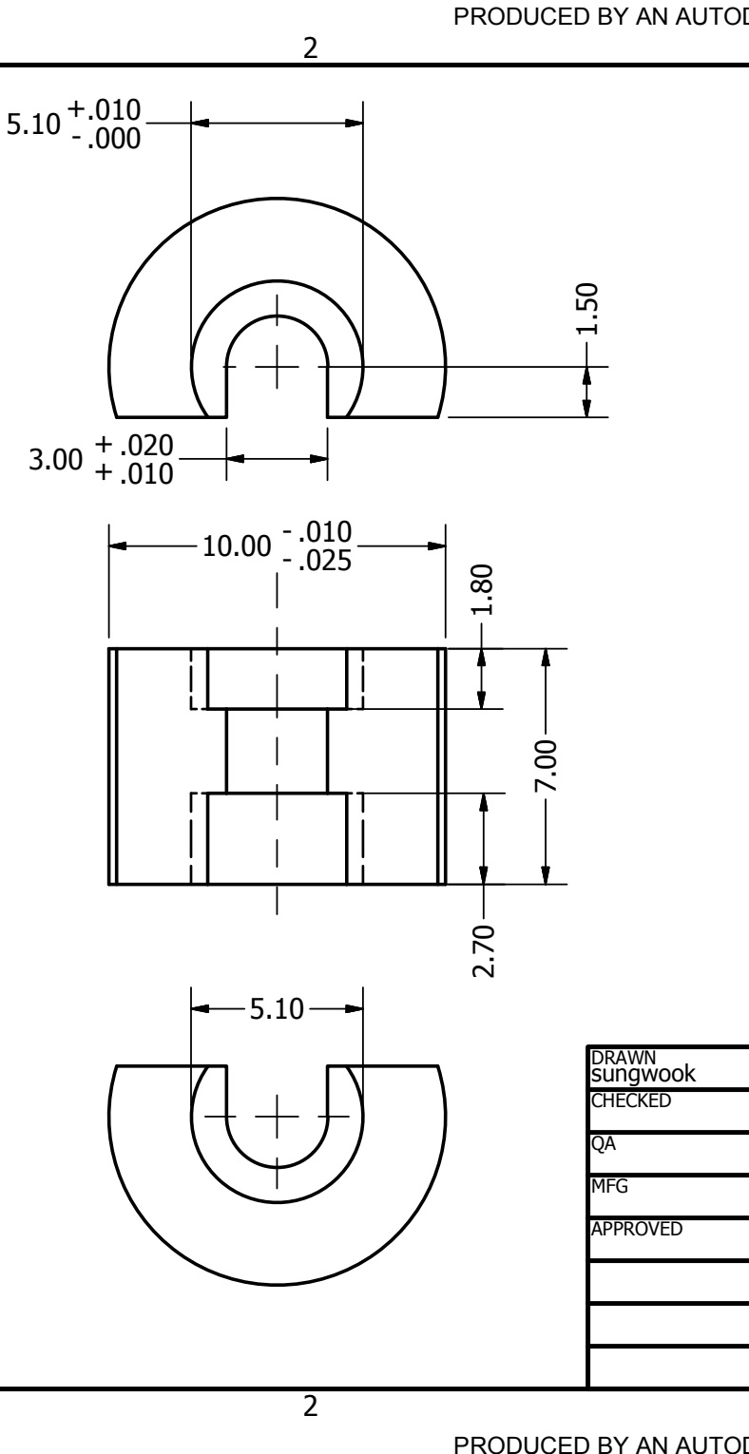
[picture p74: figure]

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
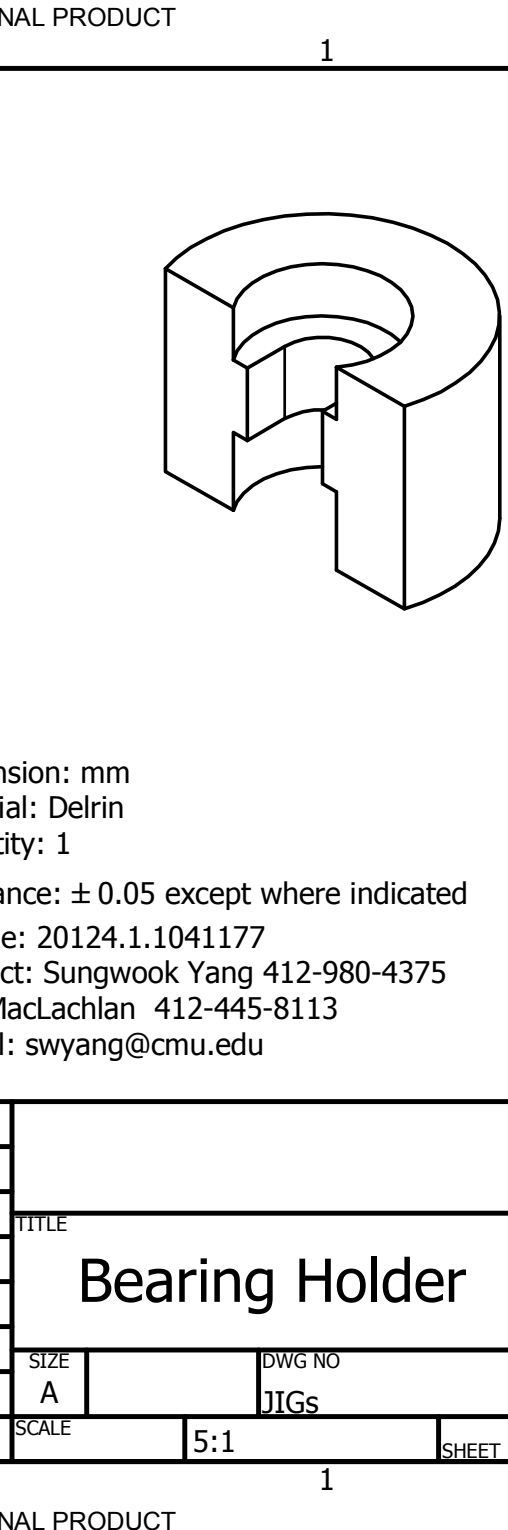
[picture p75: figure]
elr; hla; old

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
PRODUCED BY AN AUTODESK EDUCATIONAL PRODUCT

PRODUCED BY AN AUTODESK EDUCATIONAL PRODUCT

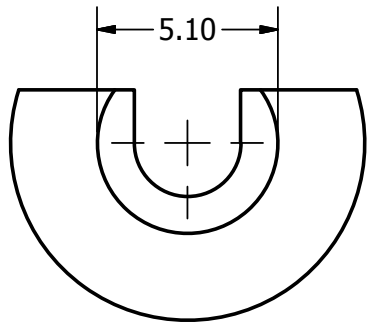
[picture p76: figure]

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
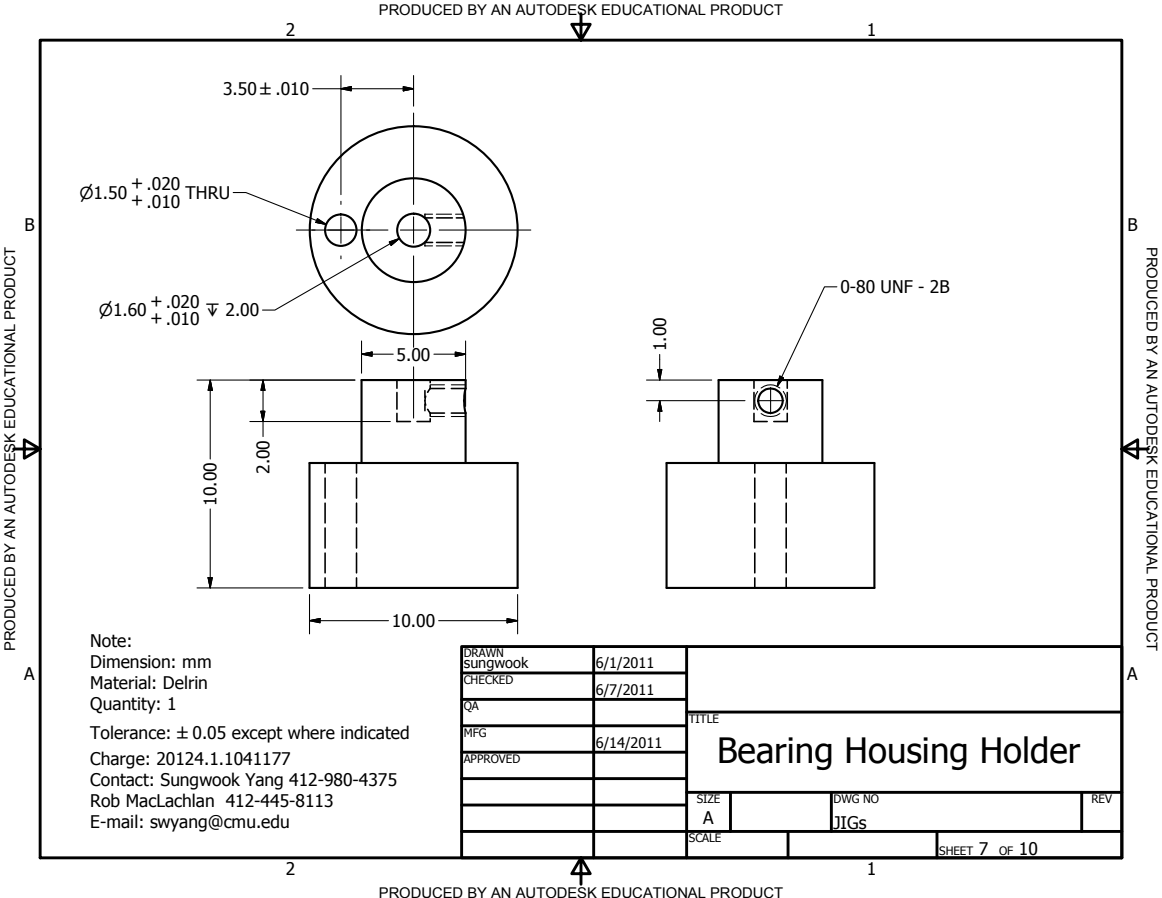
[picture p77: page 2]
TIO; A U T O D E S K E D U C A TIO; DRAWN sungwook; CHECKED; MFG; APPROVED; SIZE A; SCALE; DWG NO JIGs; REV; SHEET 7 OF 10; 0-80 UNF - 2B; THRU

Note:
Dimension: mm
Material: Delrin
Quantity: 1
Tolerance: B0.05 except where indicated
Charge: 20124.1.1041177
Contact: Sungwook Yang 412-980-4375
Rob MacLachlan 412-445-8113
E-mail: swyang@cmu.edu

TITLE
Bearing Housing Holder

PRODUCED BY AN AUTODESK EDUCATIONAL PRODUCT

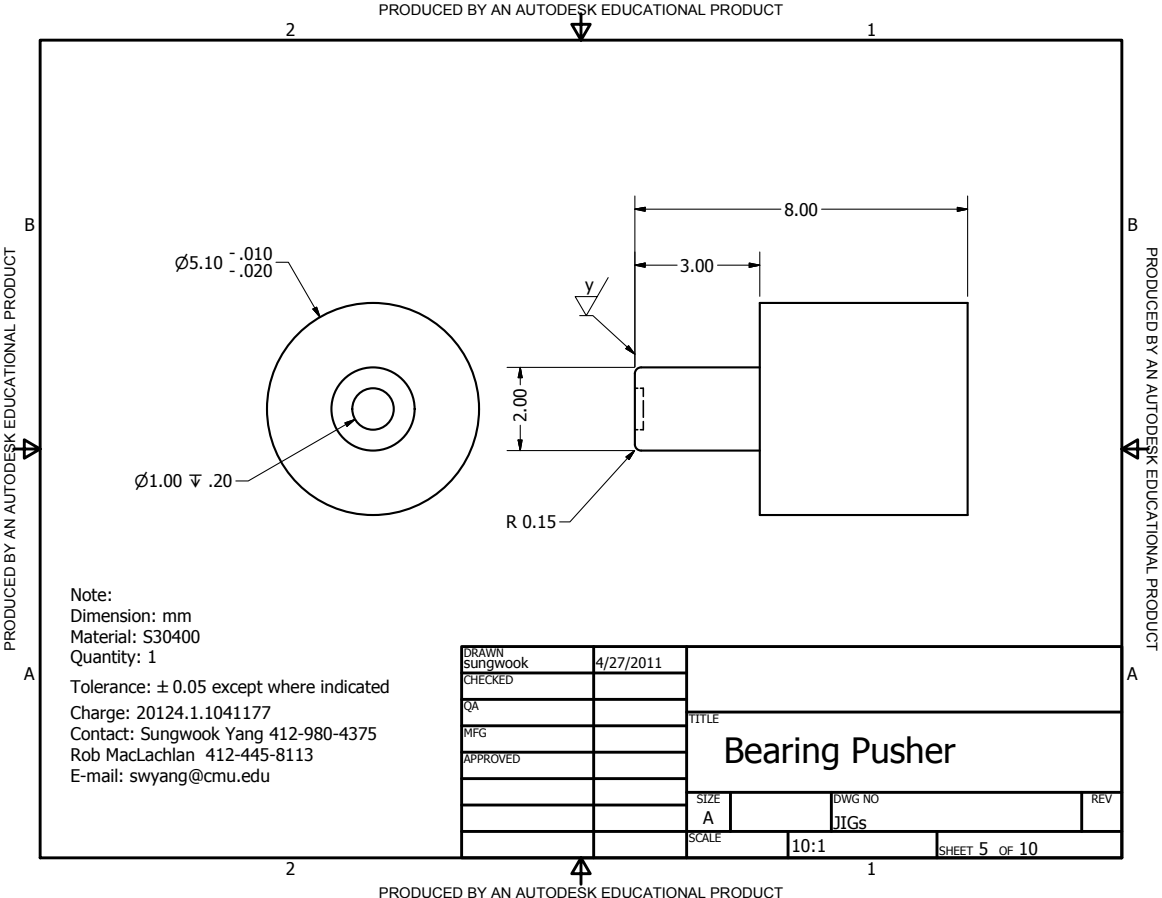
[picture p78: page 3]
TIO; A U T O D E S K E D U C A TIO; DRAWN sungwook; CHECKED; MFG; APPROVED; TITLE; SIZE A; DWG NO JIGs; REV; Bearing Pusher

Note:
Dimension: mm
Material: S30400
Quantity: 1
Tolerance: B0.05 except where indicated
Charge: 20124.1.1041177
Contact: Sungwook Yang 412-980-4375
Rob MacLachlan 412-445-8113
E-mail: swyang@cmu.edu

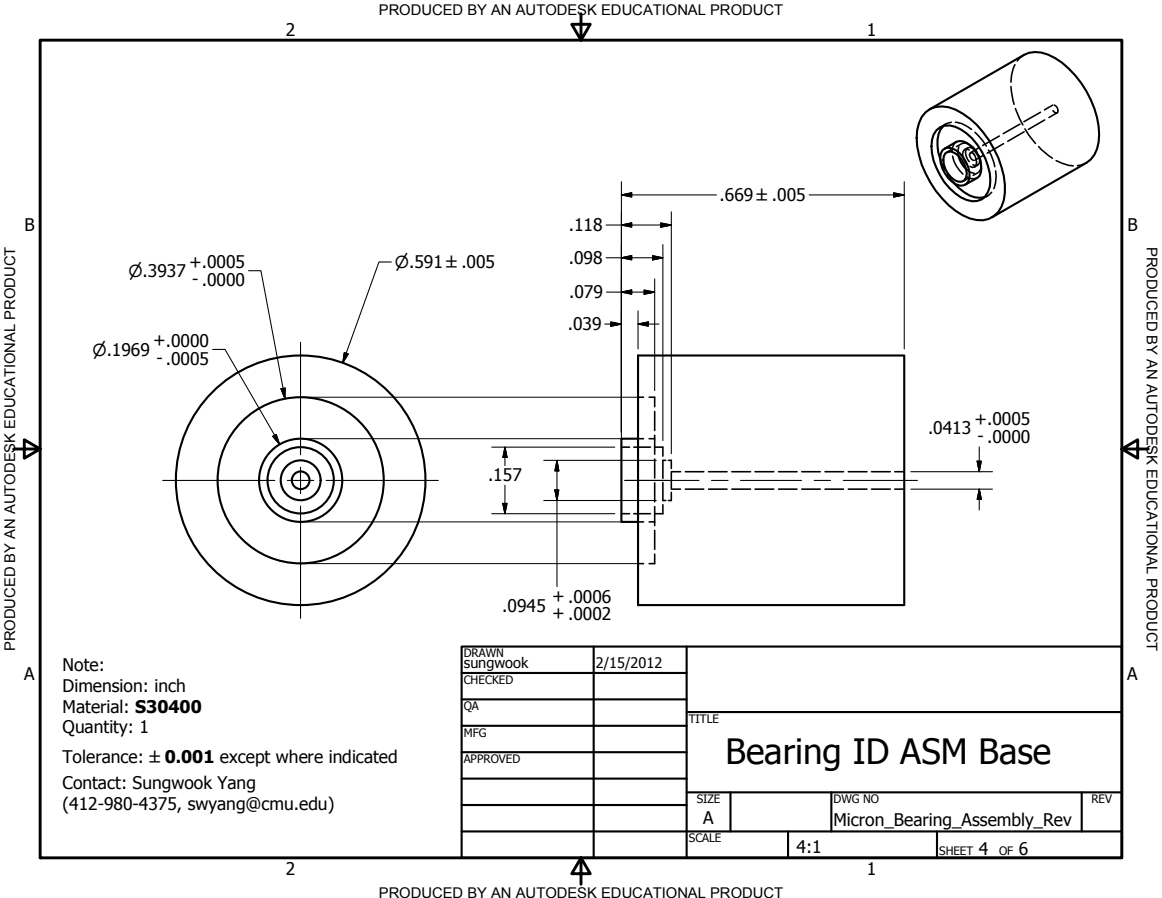
[picture p79: page 4]
TIO; A U T O D E S K E D U C A TIO; DRAWN sungwook; CHECKED; MFG; APPROVED; SIZE A; DWG NO Micron_Bearing_Assembly_Rev; REV; Note:

Dimension: inch
Material: S30400
Quantity: 1
Tolerance: B0.001 except where indicated
Contact: Sungwook Yang
(412-980-4375, swyang@cmu.edu)

TITLE
Bearing ID ASM Base

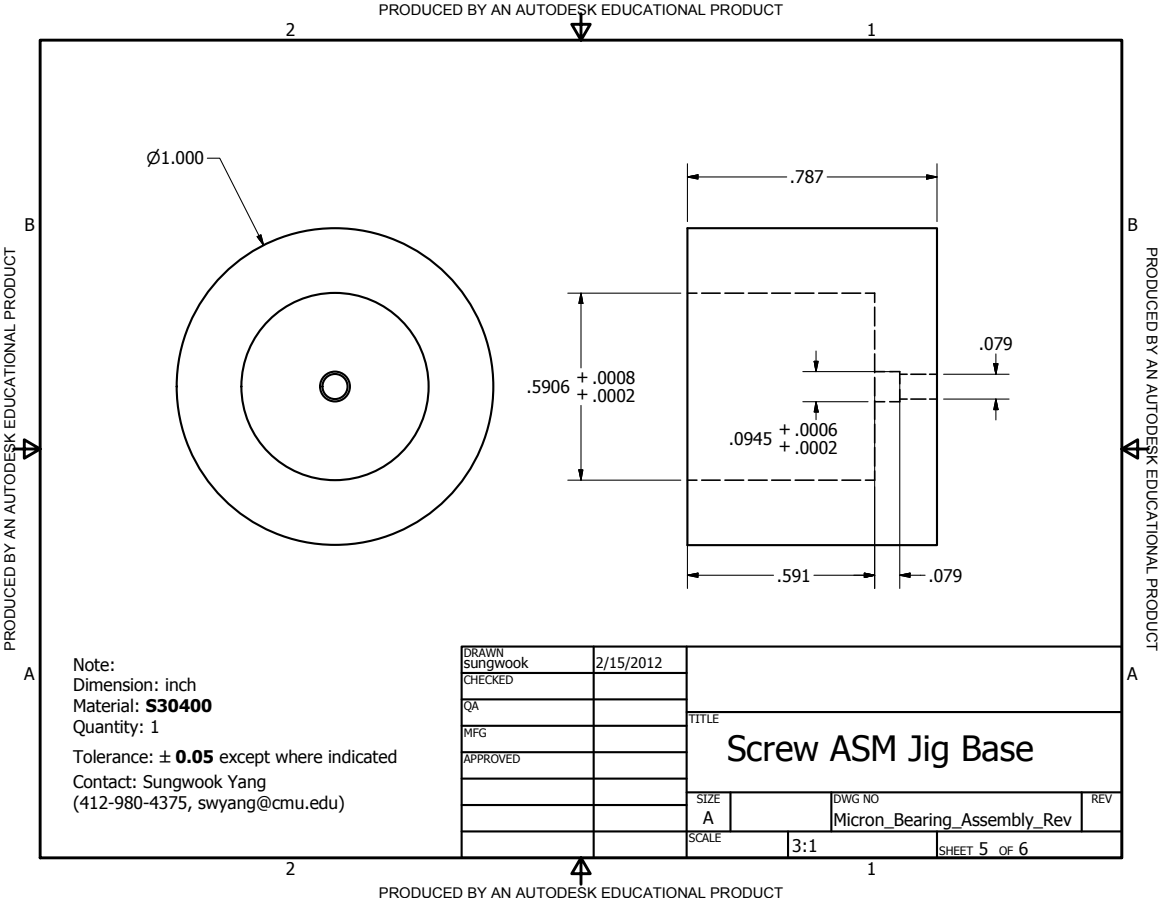
[picture p80: page 5]
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

Dimension: inch
Material: S30400
Quantity: 1
Tolerance: B0.05 except where indicated
Contact: Sungwook Yang
(412-980-4375, swyang@cmu.edu)

TITLE
Screw ASM Jig Base

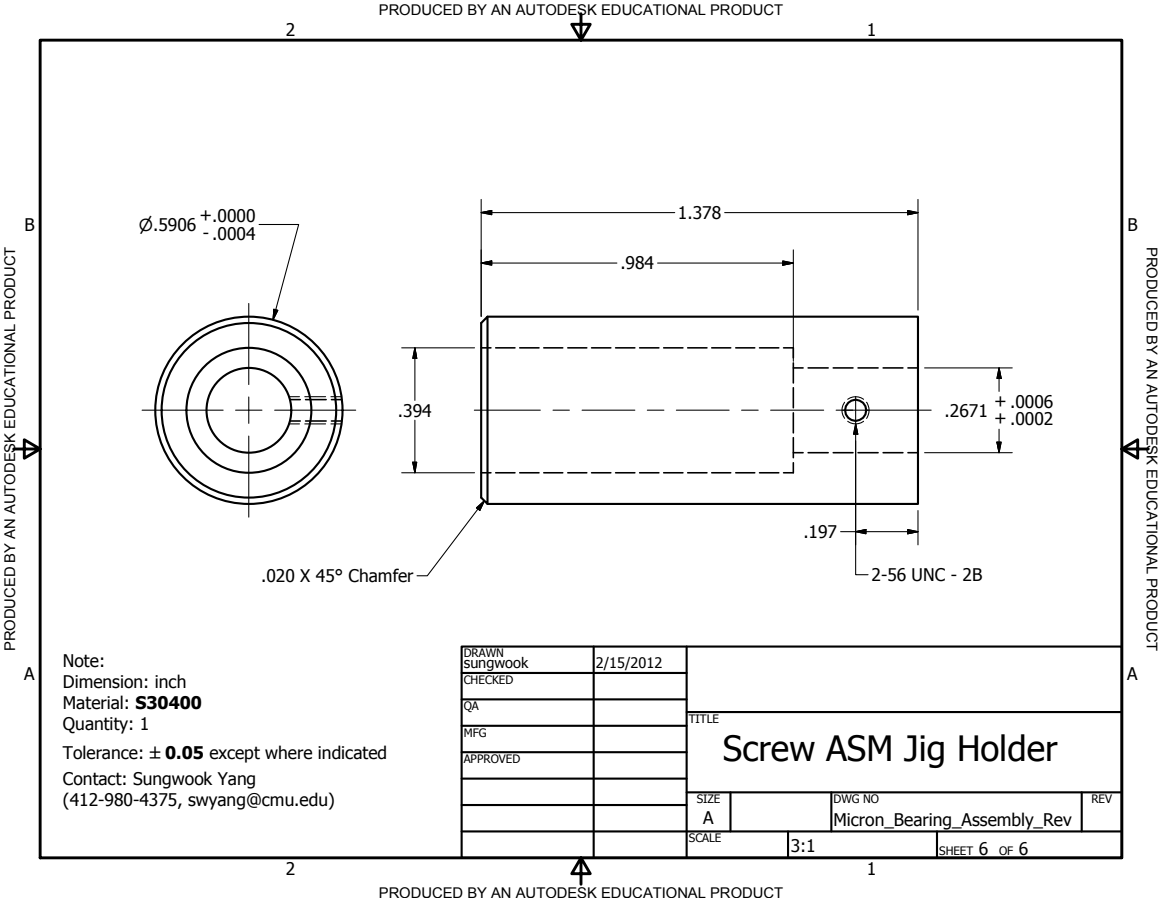
[picture p81: page 6]
TIO; A U T O D E S K E D U C A TIO; DRAWN sungwook; CHECKED; MFG; APPROVED; SIZE A; DWG NO Micron_Bearing_Assembly_Rev; REV; .020 X 45° Chamfer; 2-56 UNC - 2B; Note:

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

TITLE
Screw ASM Jig Holder
