robmacl/micron_maxon/cad/asap_micron/mechanical/drawings.pdf

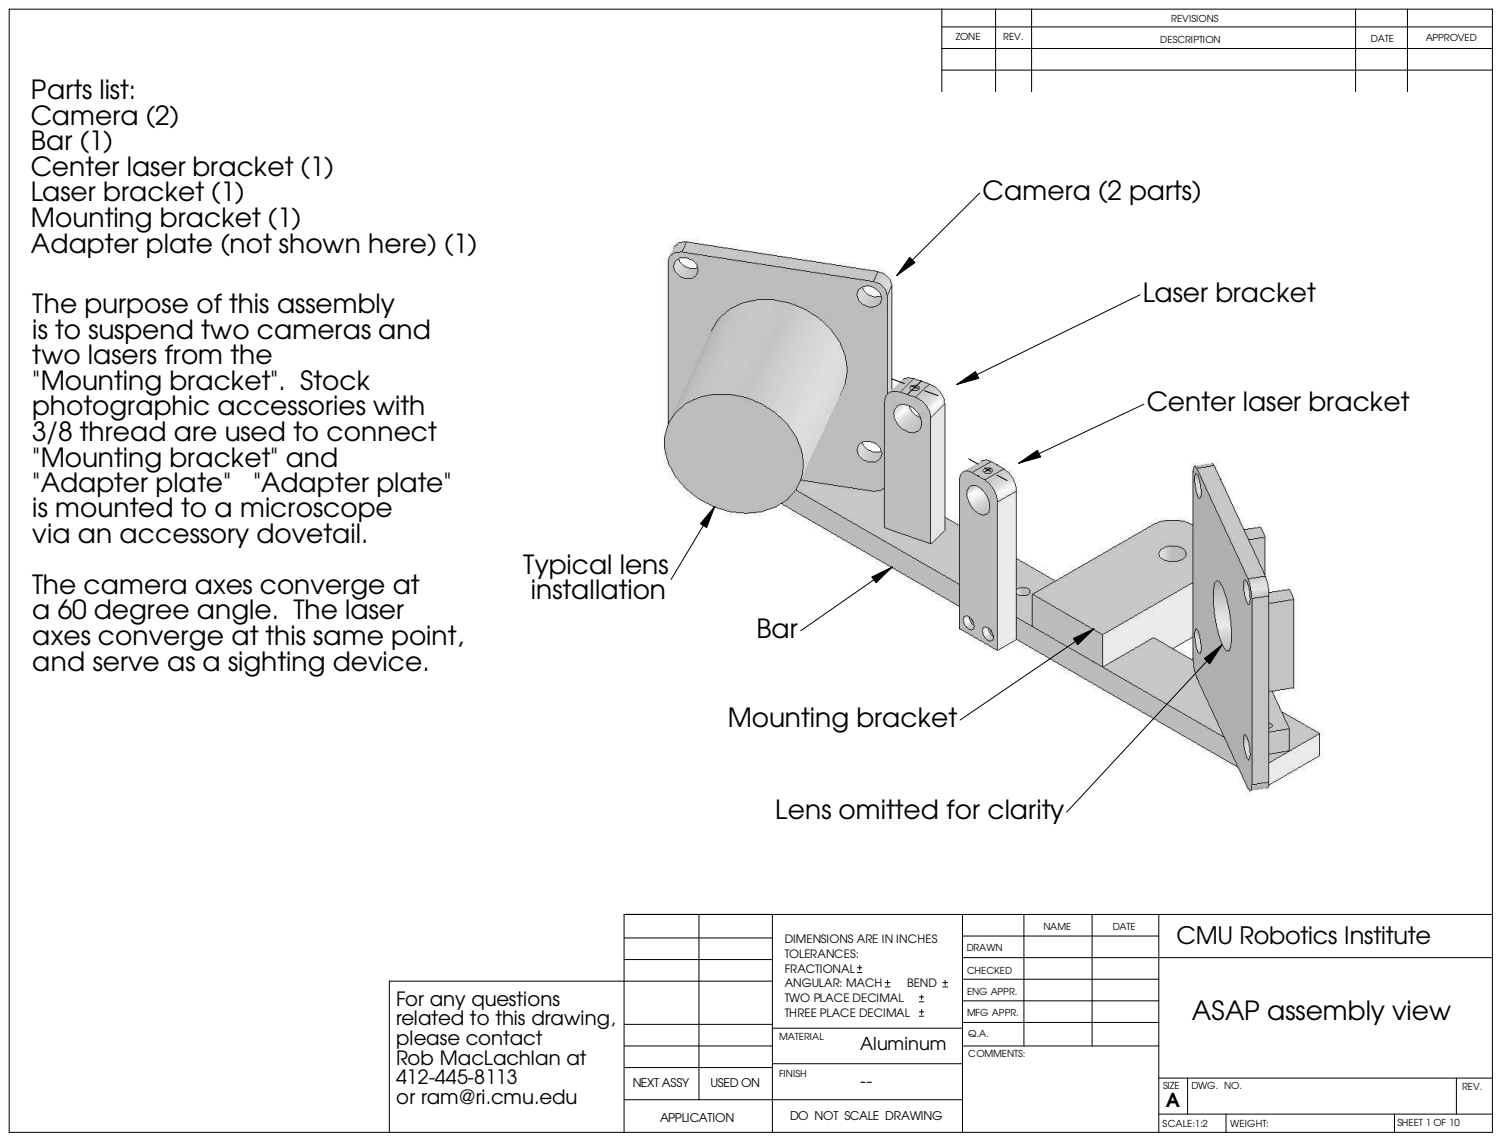
[picture p82: page 1]
Camera (2 parts); Laser bracket; Bar; Mounting bracket; Typical lens installation; MATERIAL; FINISH; Aluminum -- APPLICATION; DO NOT SCALE DRAWING NEXT ASSY; USED ON; COMMENTS:

REVISIONS

ZONE | REV. | DESCRIPTION | DATE | APPROVED

Parts list:
Camera (2)
Bar (1)
Center laser bracket (1)
Laser bracket (1)
Mounting bracket (1)
Adapter plate (not shown here) (1)

The purpose of this assembly
is to suspend two cameras and
two lasers from the
"Mounting bracket". Stock
photographic accessories with 3/8 thread are used to connect

Center laser bracket

"Mounting bracket" and
"Adapter plate"
is mounted to a microscope
via an accessory dovetail.

The camera axes converge at a 60 degree angle. The laser

axes converge at this same point,
and serve as a sighting device.

Lens omitted for clarity

DIMENSIONS ARE IN INCHES TOLERANCES: FRACTIONAL ANGULAR: MACH BEND TWO PLACE DECIMAL THREE PLACE DECIMAL | | NAME | DATE | CMU Robotics Institute

DRAWN
CHECKED | | | ASAP assembly view

For any questions related to this drawing, please contact Rob MacLachlan at 412-445-8113 or ram@ri.cmu.edu | | | ENG APPR.

MFG APPR.

SIZE A | DWG. NO. | REV.

SCALE:1:2 | WEIGHT: | SHEET 1 OF 10

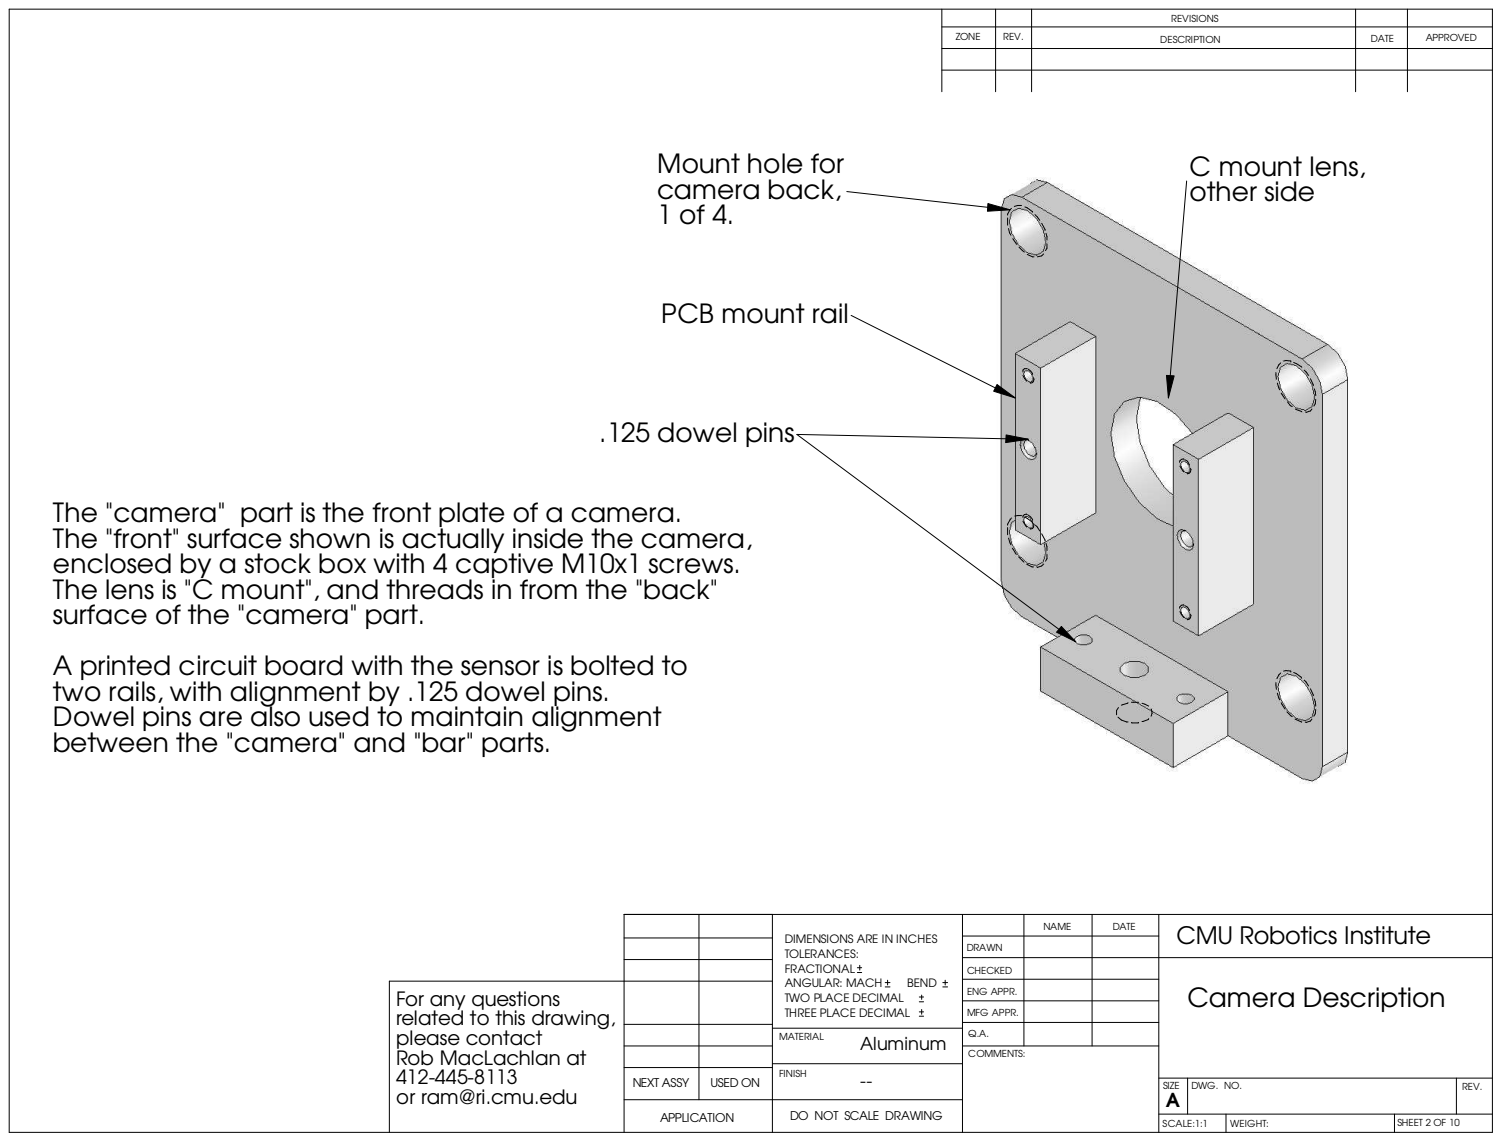
[picture p83: page 2]
C mount lens, other side; .125 dowel pins; SCALE:1:1; MATERIAL; FINISH; Aluminum -- APPLICATION; DO NOT SCALE DRAWING NEXT ASSY; USED ON; WEIGHT:; SHEET 2 OF 10; COMMENTS:

Mount hole for
camera back,

PCB mount rail

The "camera" part is the front plate of a camera.
The "front" surface shown is actually inside the camera,
enclosed by a stock box with 4 captive M10x1 screws.
The lens is "C mount", and threads in from the "back"
surface of the "camera" part.

A printed circuit board with the sensor is bolted to
two rails, with alignment by .125 dowel pins.
Dowel pins are also used to maintain alignment
between the "camera" and "bar" parts.

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

DRAWN
CHECKED | | | Camera Description

For any questions related to this drawing, please contact Rob MacLachlan at 412-445-8113 | | | ENG APPR.

MFG APPR.

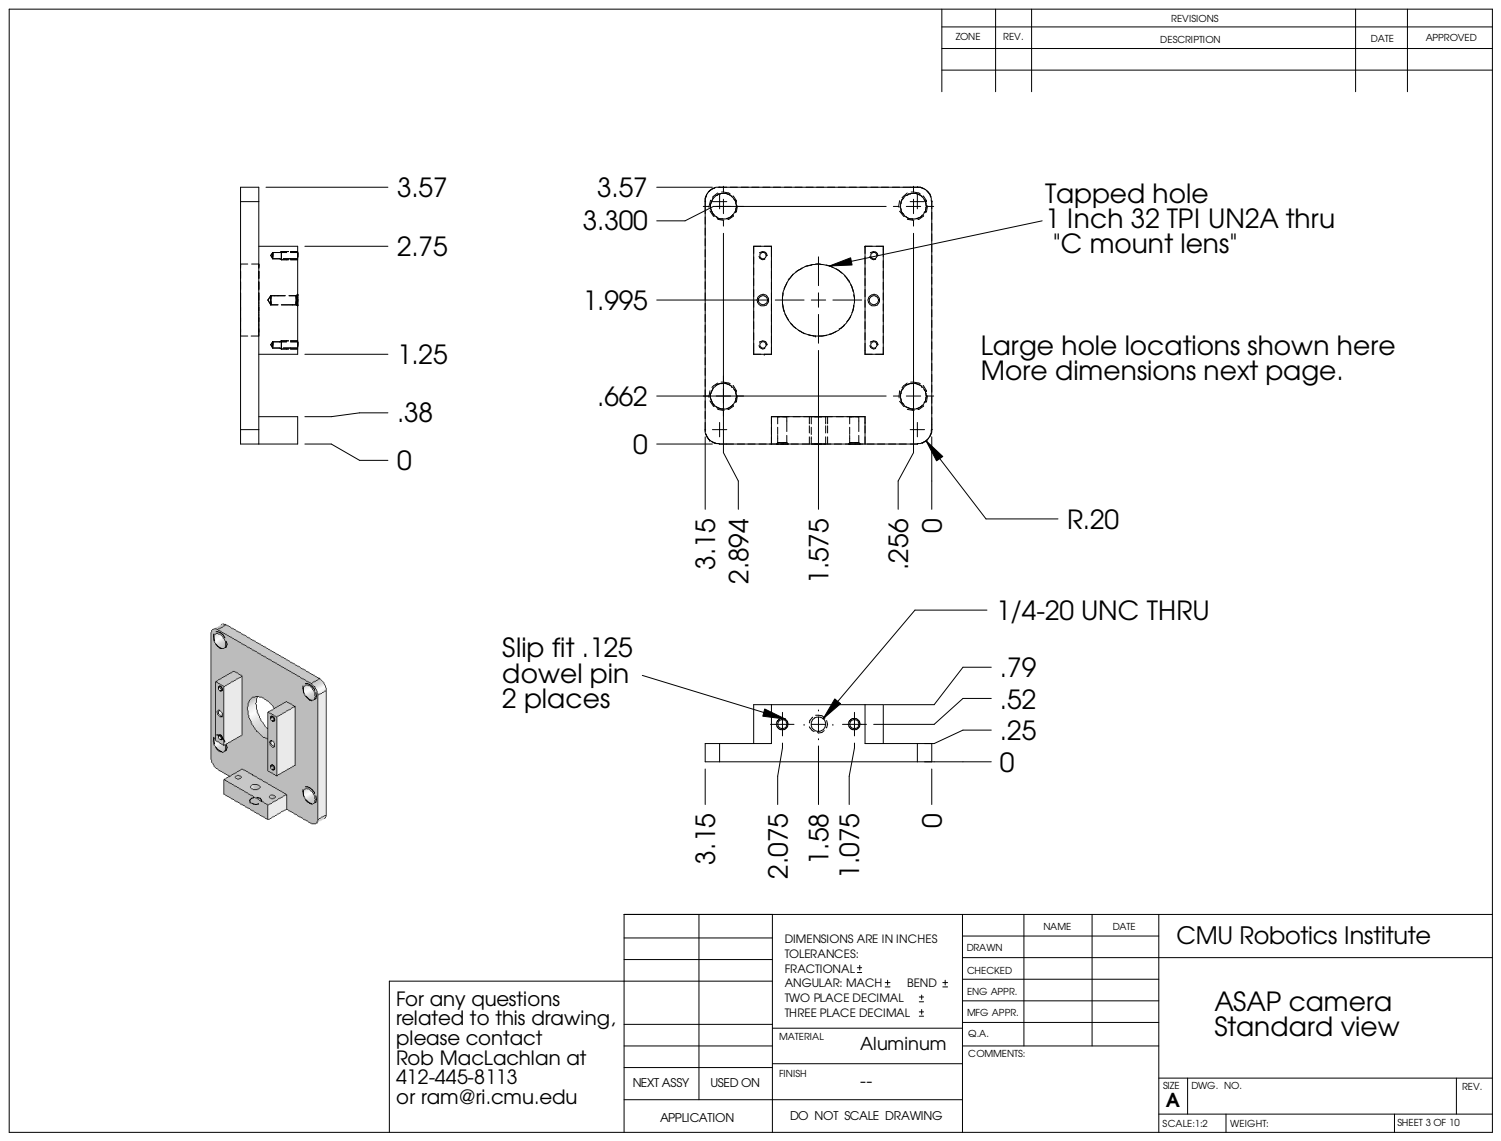
[picture p84: page 3]
3.57 Tapped hole; 1/4-20 UNC THRU; 2 places; MATERIAL; FINISH; Aluminum -- APPLICATION; DO NOT SCALE DRAWING NEXT ASSY; USED ON; WEIGHT:; SHEET 3 OF 10; COMMENTS:

1 Inch 32 TPI UN2A thru
"C mount lens"

Large hole locations shown here
More dimensions next page.

.79 Slip fit .125 dowel pin

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

DRAWN
CHECKED | | | ASAP camera Standard view

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

MFG APPR.

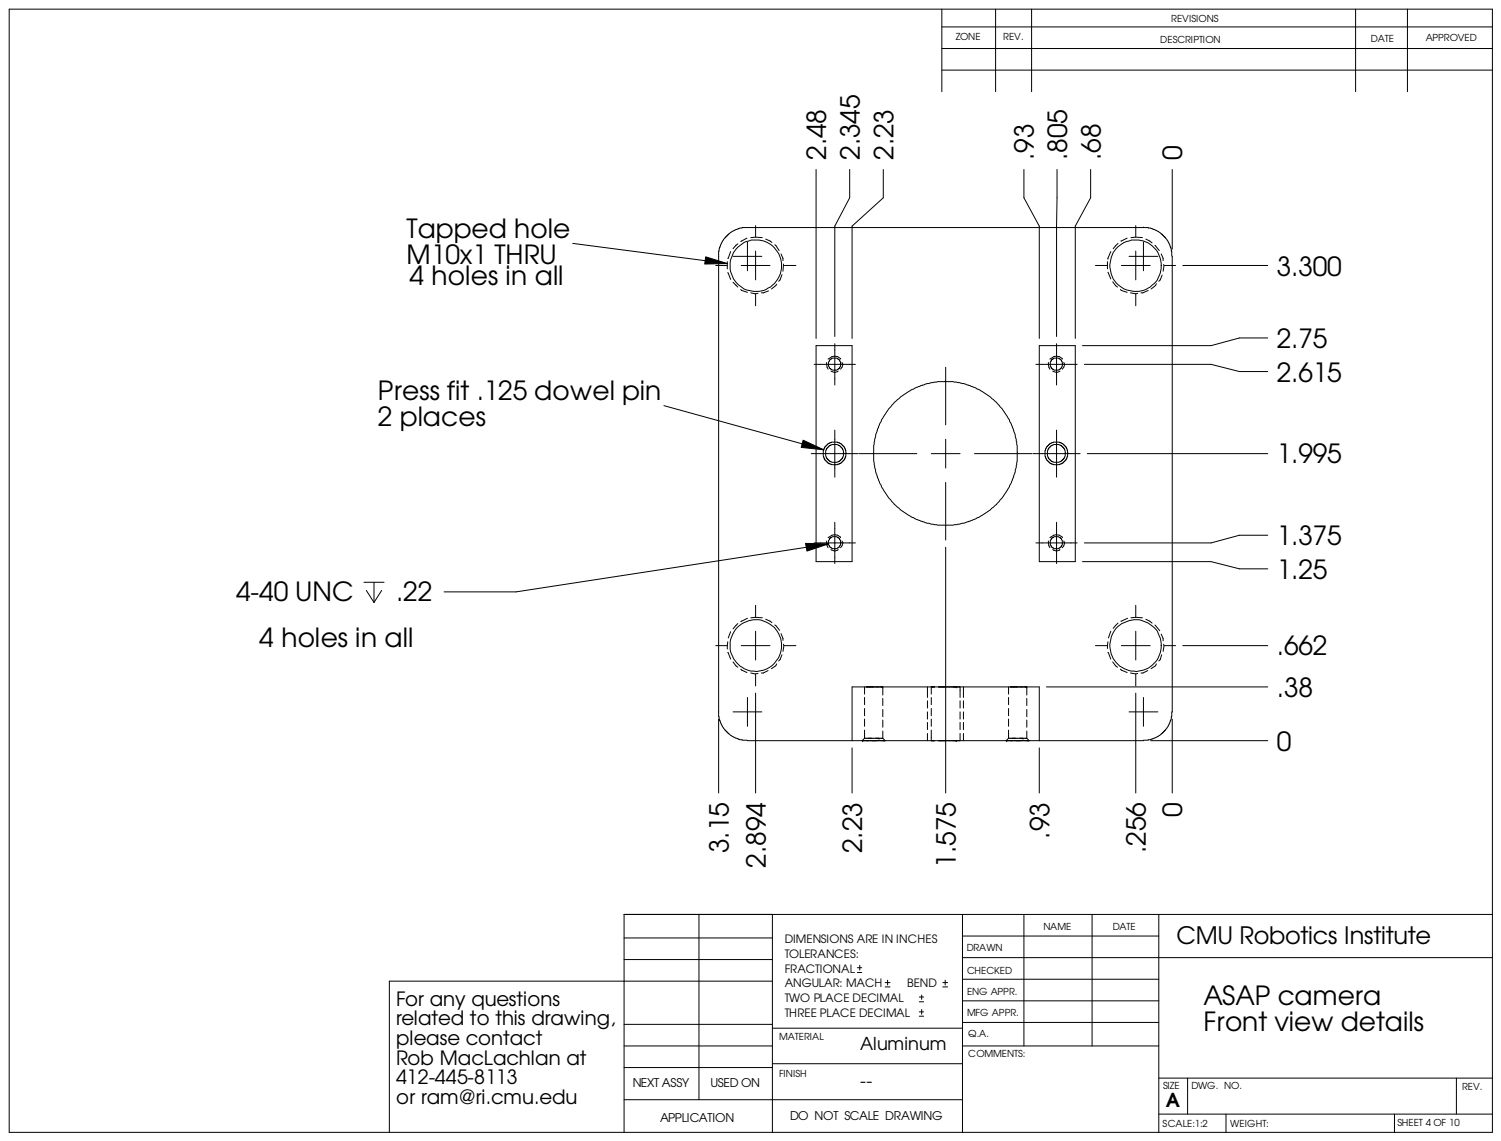
[picture p85: page 4]
4-40 UNC; MATERIAL; FINISH; Aluminum -- APPLICATION; DO NOT SCALE DRAWING NEXT ASSY; USED ON; WEIGHT:; SHEET 4 OF 10; COMMENTS:

Tapped hole
M10x1 THRU
4 holes in all

Press fit .125 dowel pin
2 places

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

DRAWN
CHECKED | | | ASAP camera Front view details

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

MFG APPR.

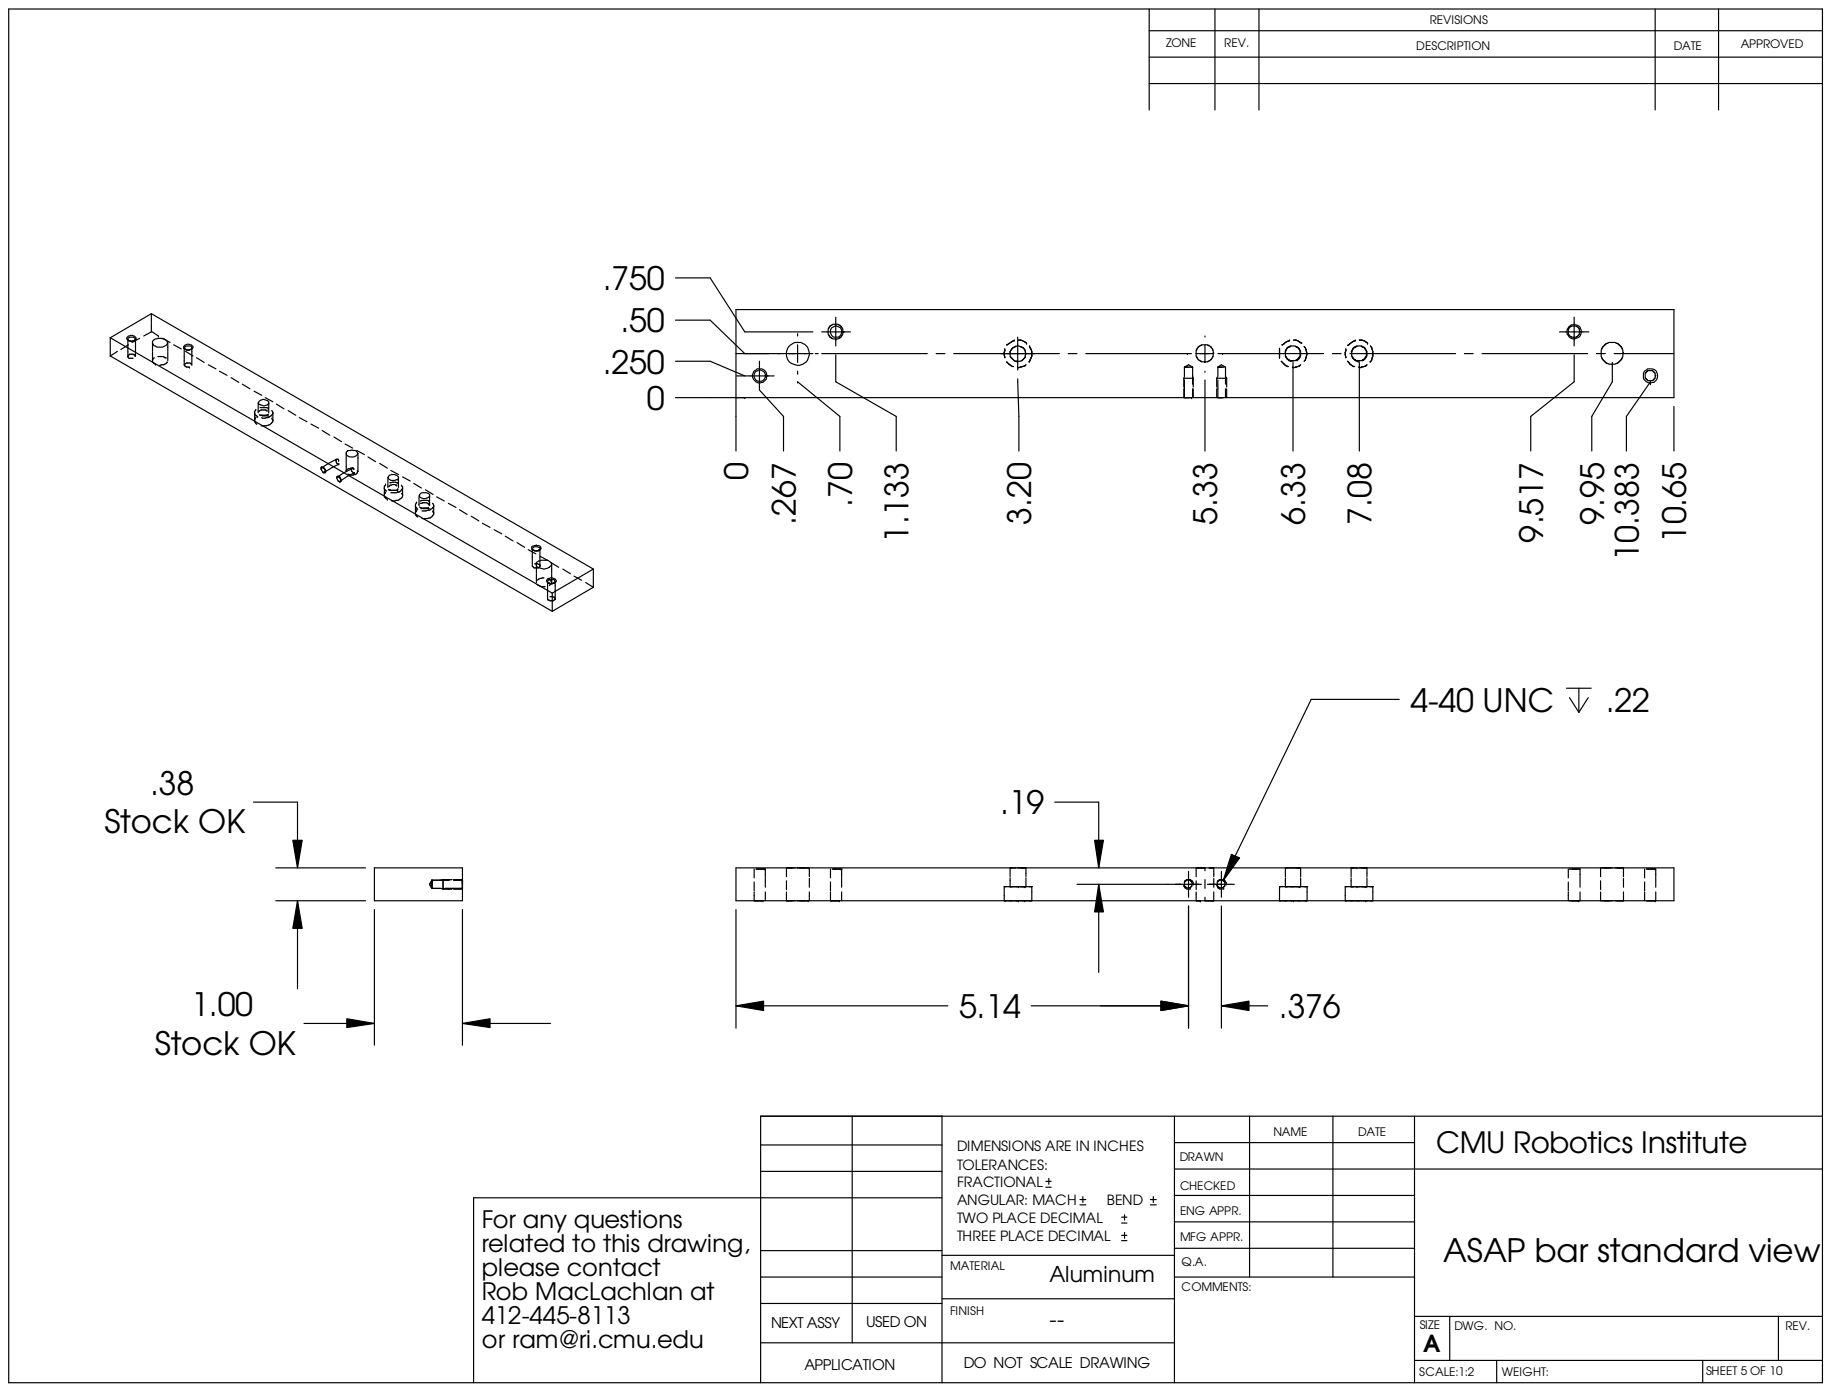
[picture p86: page 5]
4-40 UNC; .38 Stock OK; 1.00 Stock OK; MATERIAL; FINISH; Aluminum -- APPLICATION; DO NOT SCALE DRAWING NEXT ASSY; USED ON; WEIGHT:; SHEET 5 OF 10; COMMENTS:

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

DRAWN
CHECKED | | | ASAP bar standard view

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

MFG APPR.

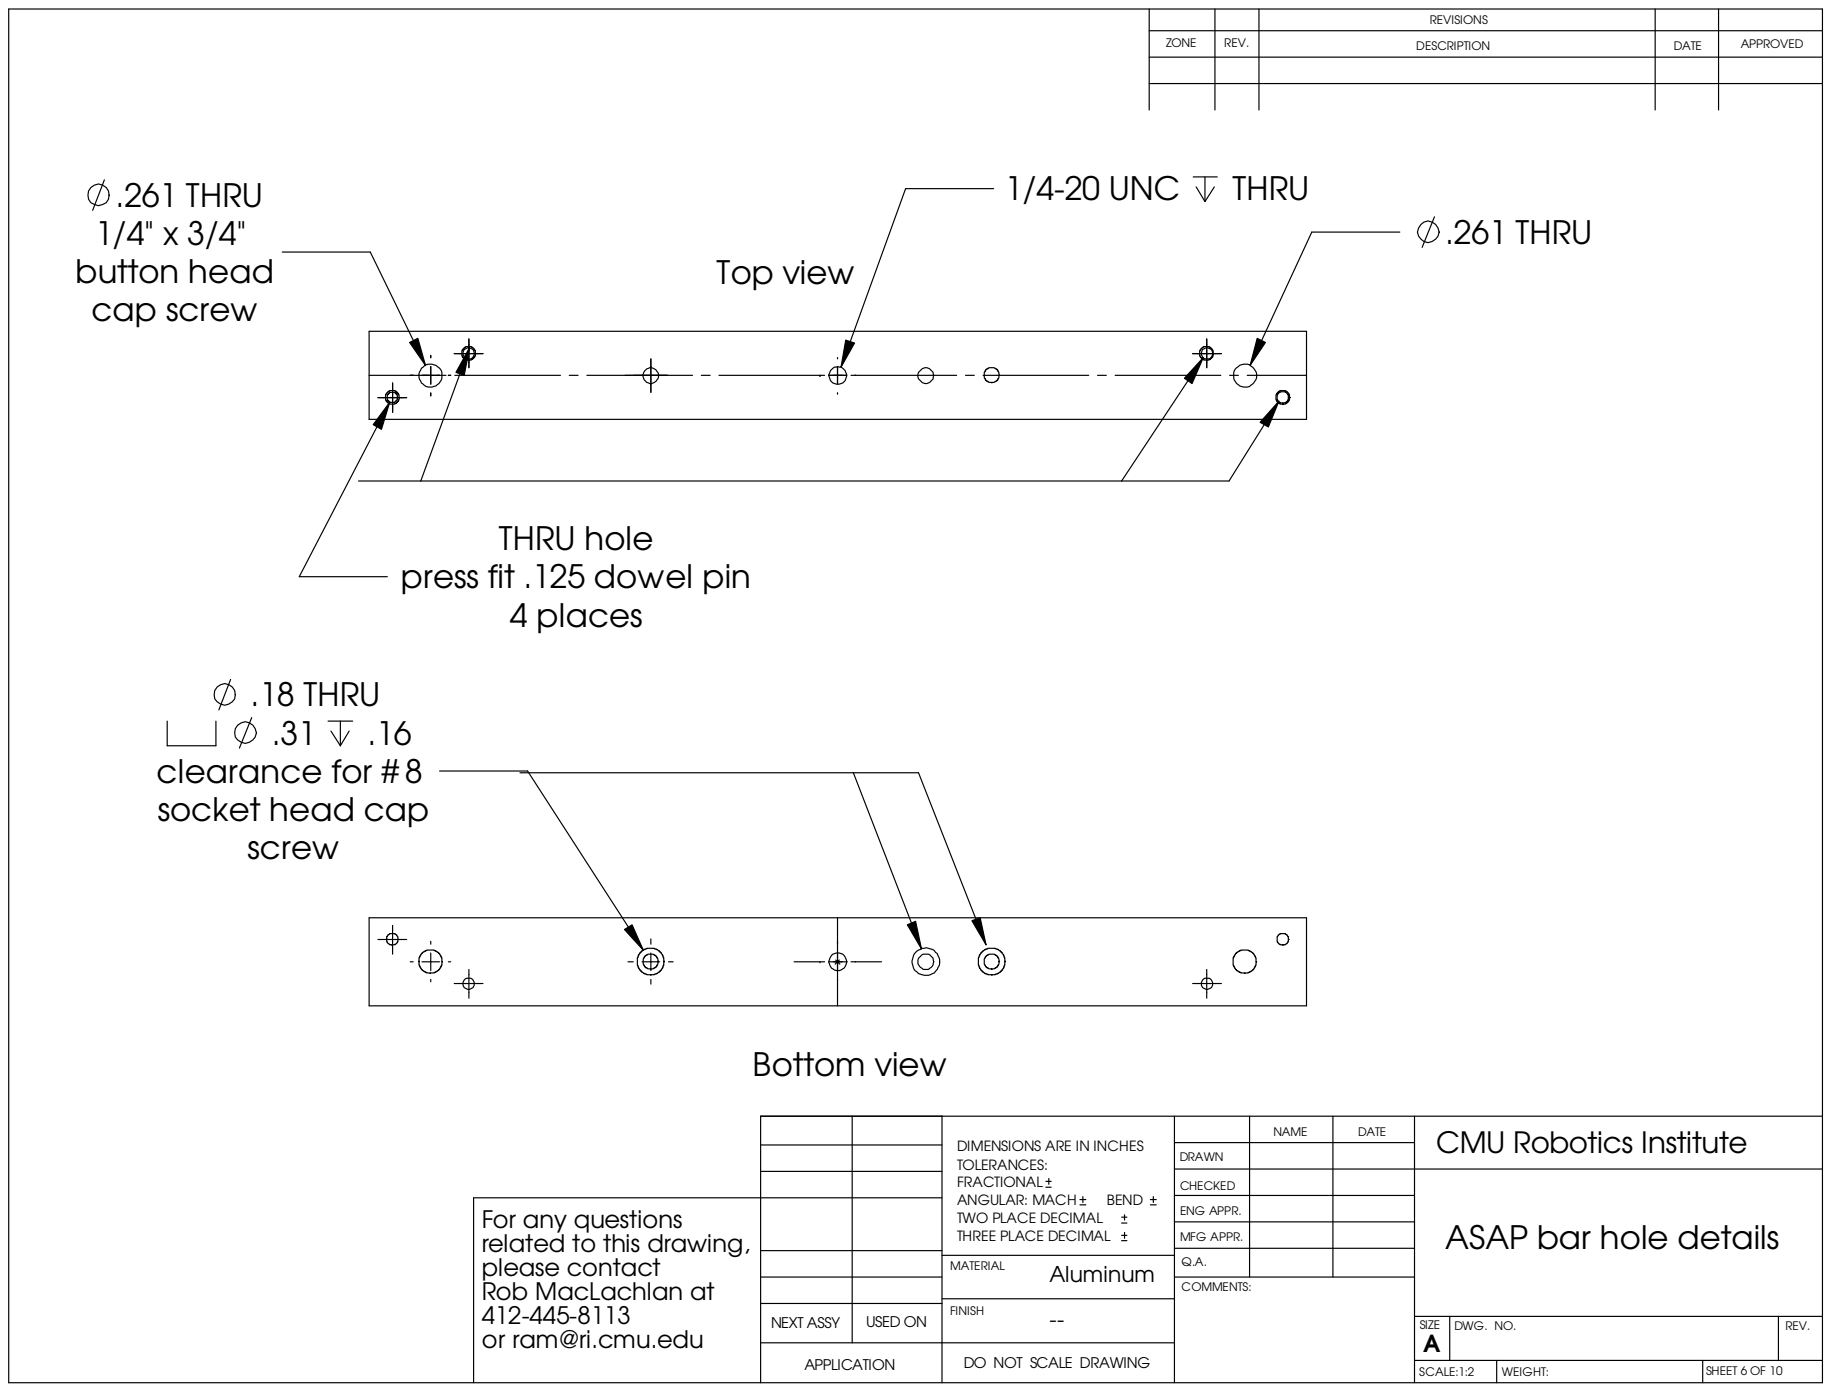
[picture p87: page 6]
.261 THRU 1/4" x 3/4" button head cap screw; 1/4-20 UNC; THRU; .261 THRU; THRU hole; 4 places; Top view; .18 THRU; Bottom view; MATERIAL; FINISH; Aluminum -- APPLICATION; DO NOT SCALE DRAWING NEXT ASSY; USED ON; WEIGHT:; SHEET 6 OF 10; COMMENTS:

press fit .125 dowel pin

clearance for # 8
socket head cap
screw

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

DRAWN
CHECKED | | | ASAP bar hole details

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

MFG APPR.

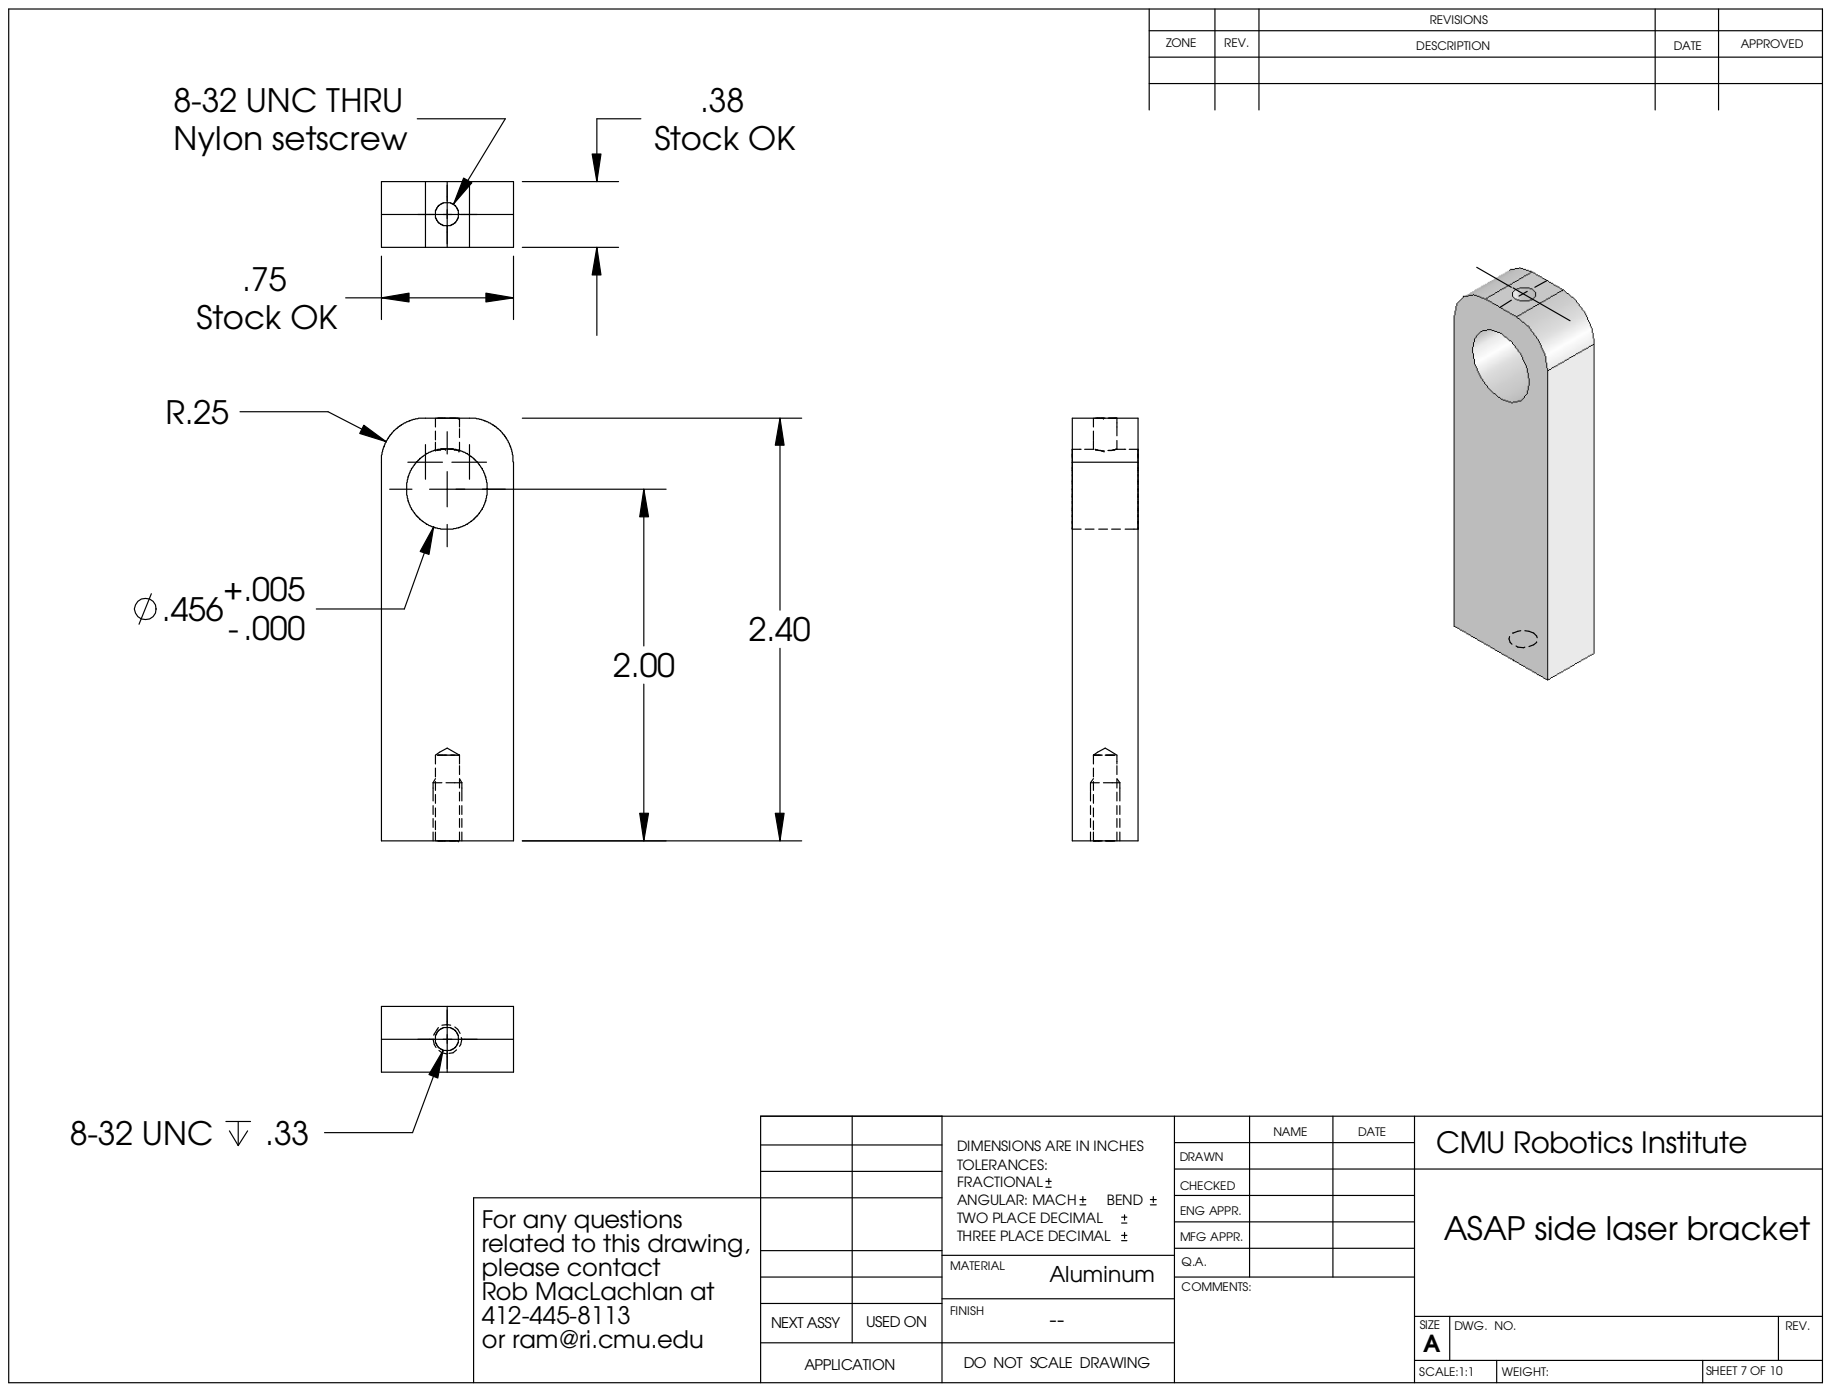
[picture p88: page 7]
.38 Stock OK; 8-32 UNC THRU Nylon setscrew; .75 Stock OK; 8-32 UNC; CMU Robotics Institute; MATERIAL; FINISH; Aluminum -- APPLICATION; DO NOT SCALE DRAWING NEXT ASSY; USED ON; WEIGHT:; SHEET 7 OF 10; COMMENTS:

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

DRAWN
CHECKED | | | ASAP side laser bracket

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

MFG APPR.

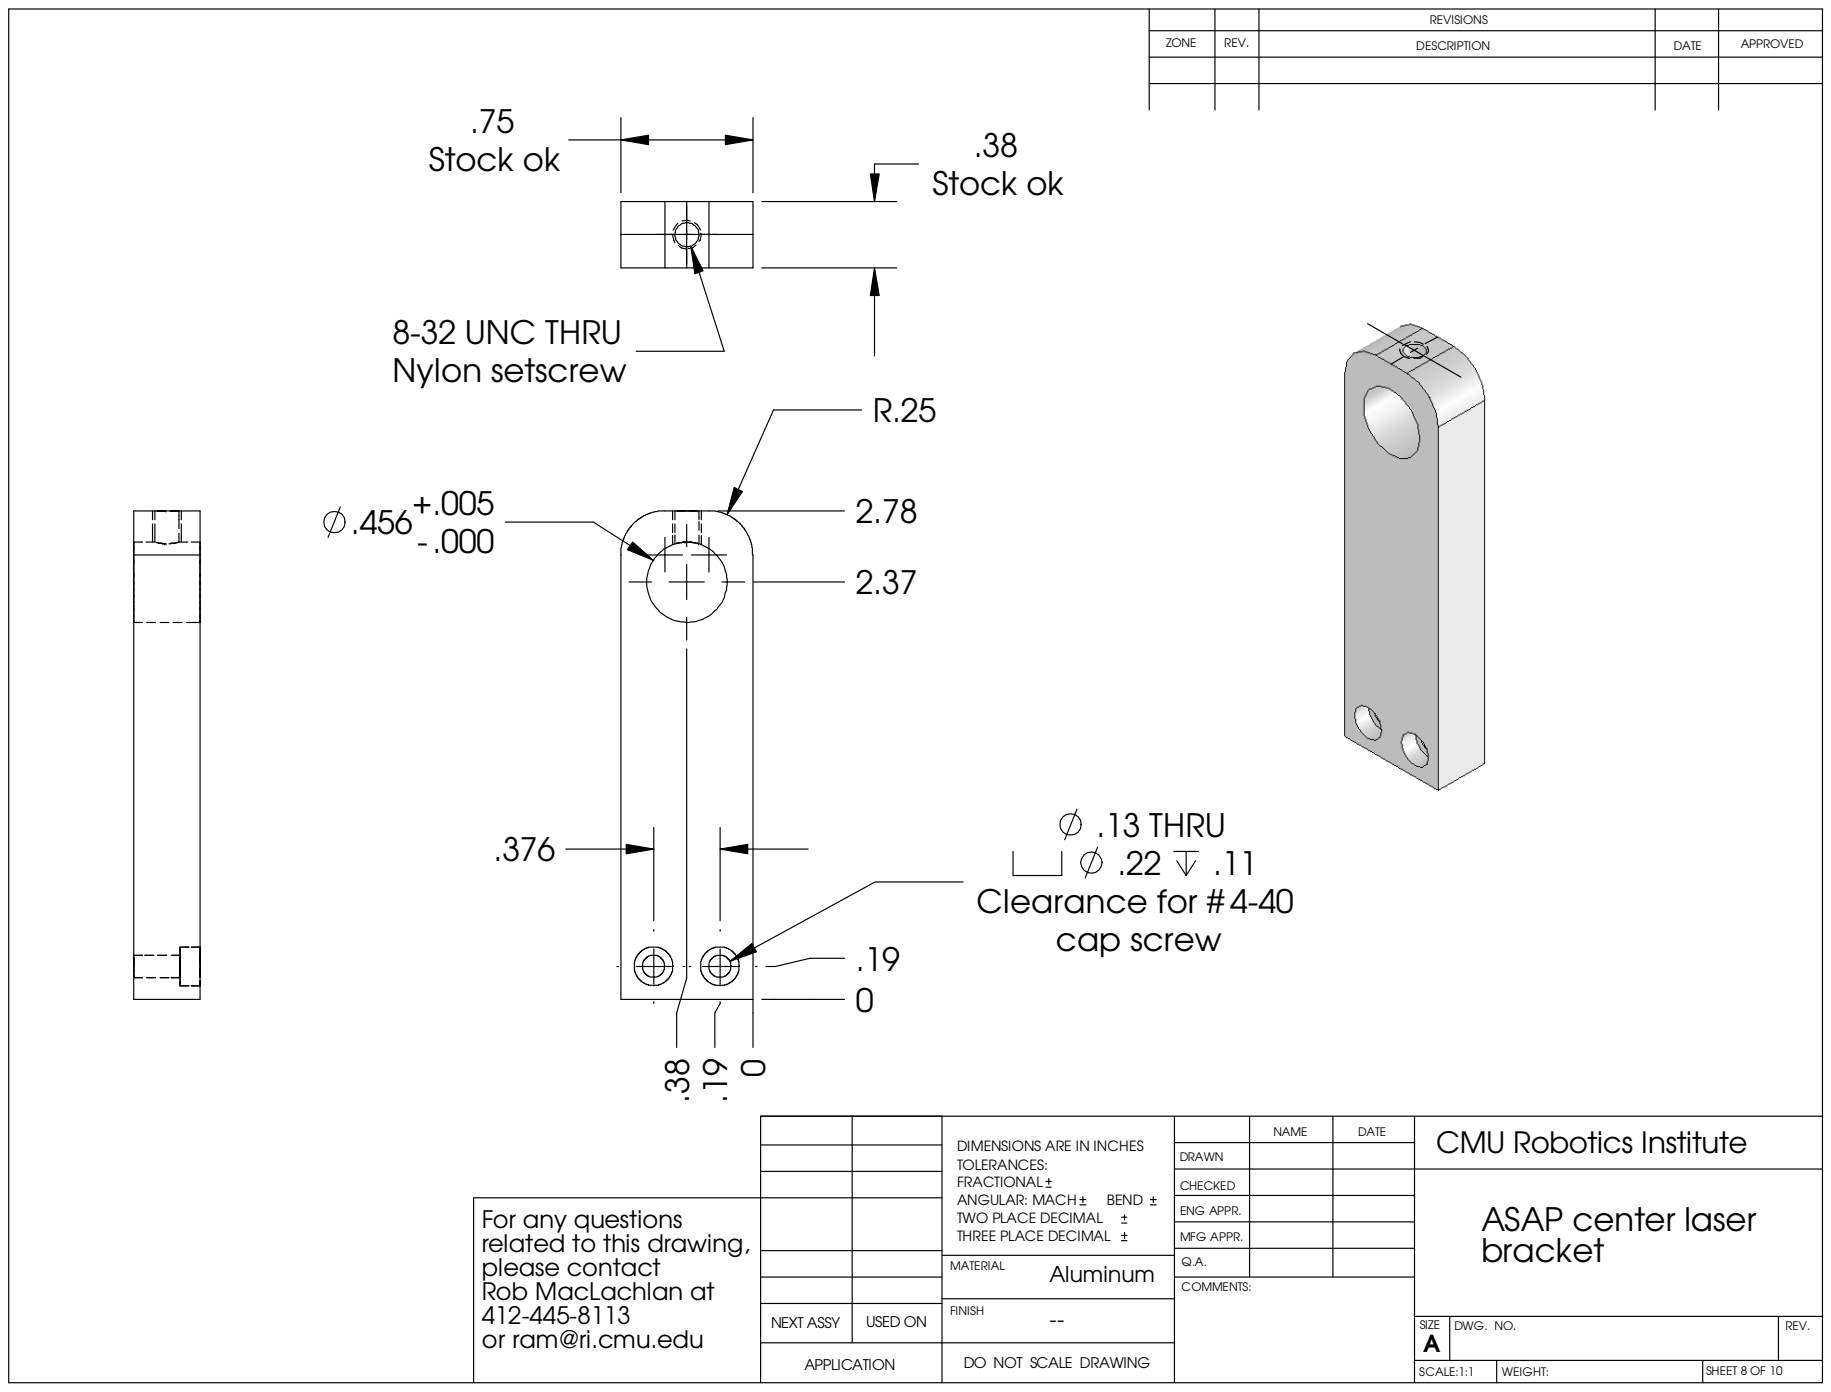
[picture p89: page 8]
Clearance for # 4-40 cap screw; .13 THRU; Stock ok; .38 Stock ok; 8-32 UNC THRU Nylon setscrew; MATERIAL; FINISH; Aluminum -- APPLICATION; DO NOT SCALE DRAWING NEXT ASSY; USED ON; WEIGHT:; SHEET 8 OF 10; COMMENTS:

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

DRAWN
CHECKED | | | ASAP center laser bracket

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

MFG APPR.

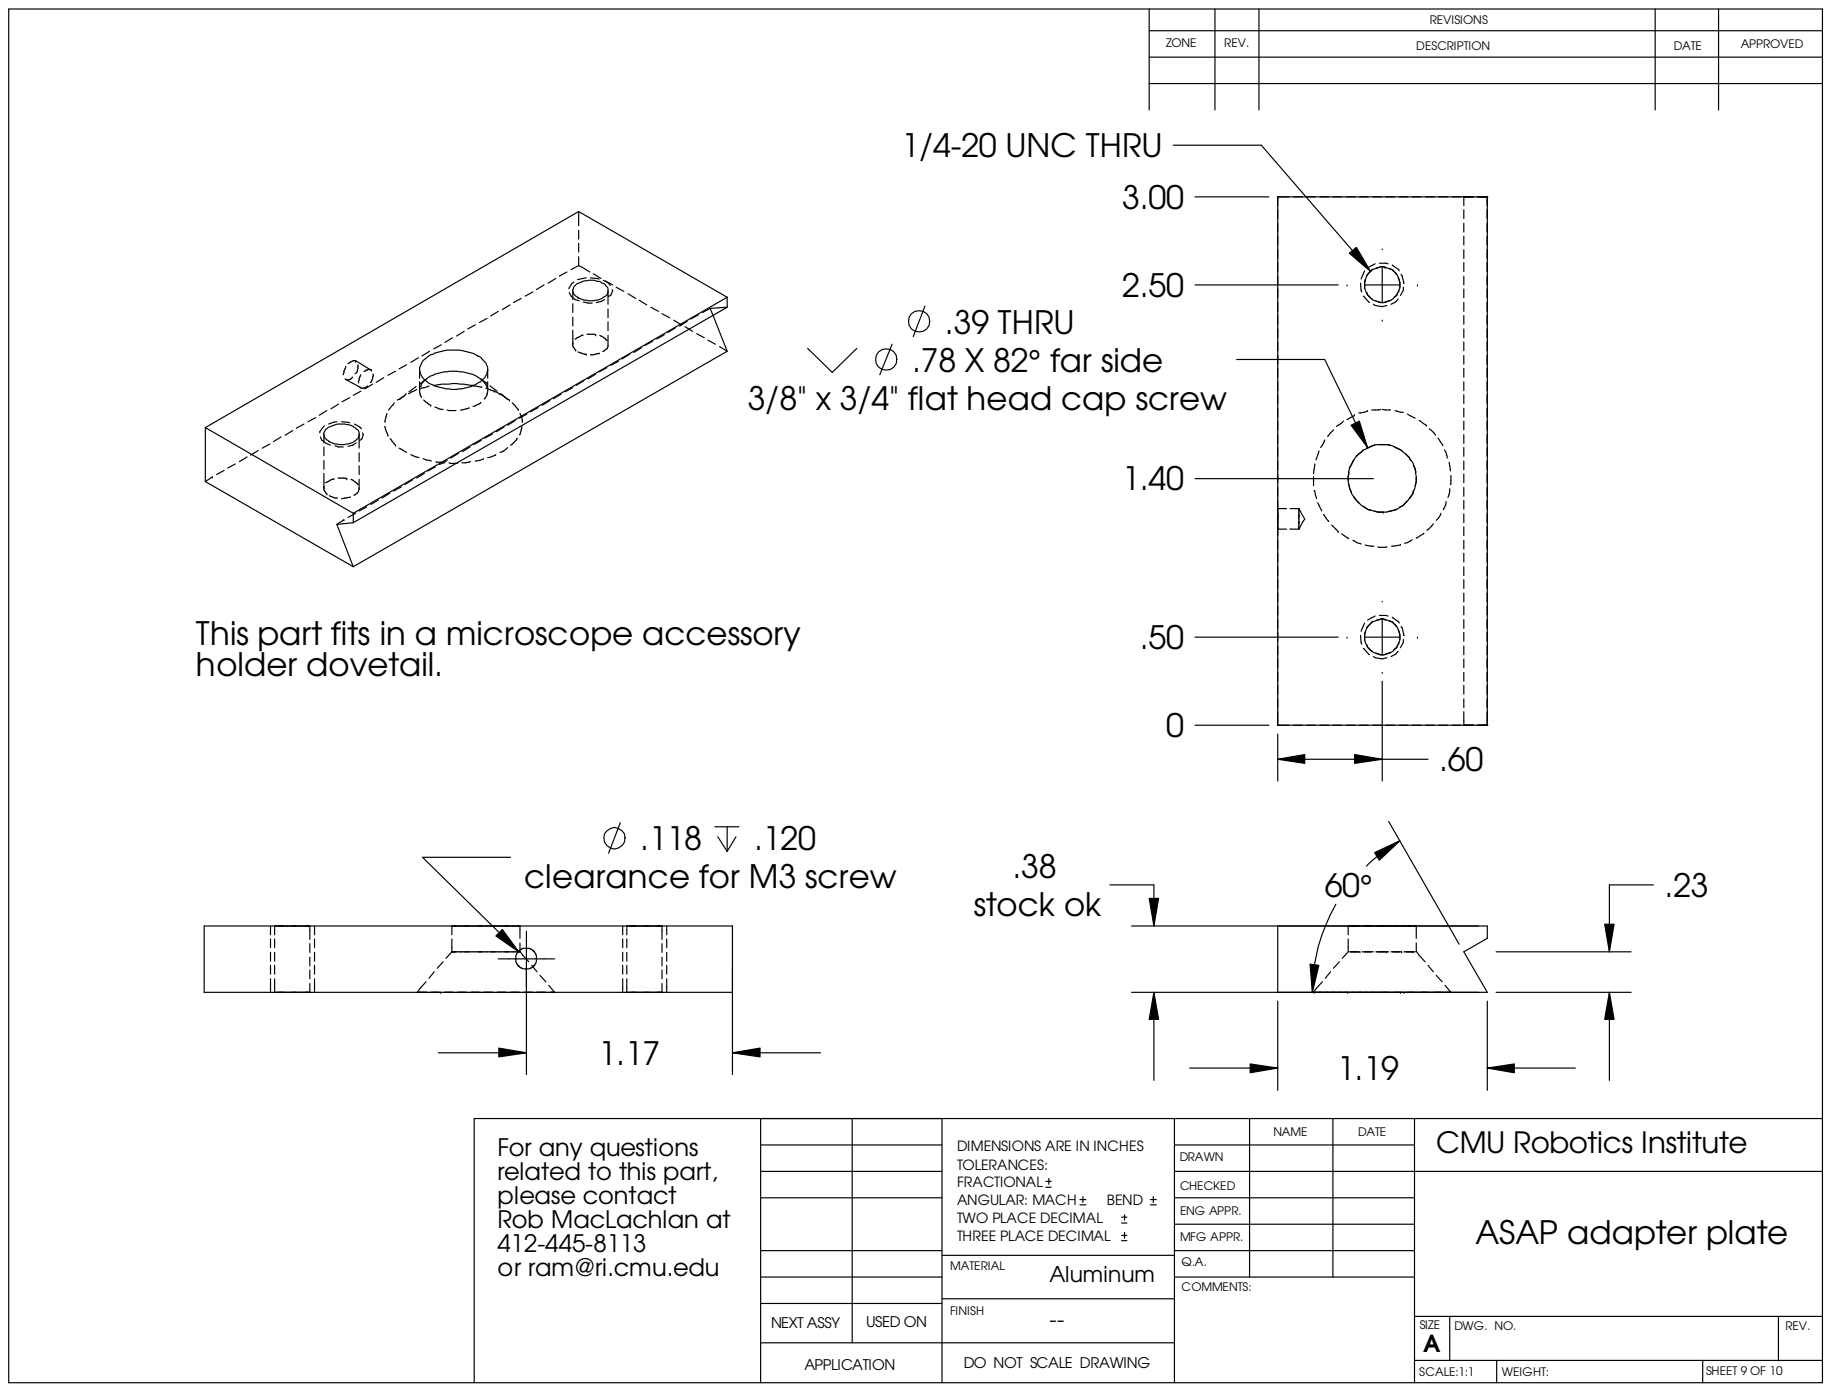
[picture p90: page 9]
stock ok; 1/4-20 UNC THRU; .78 X 82° far side; .39 THRU; FINISH; Aluminum -- APPLICATION; DO NOT SCALE DRAWING NEXT ASSY; USED ON; WEIGHT:; SHEET 9 OF 10; COMMENTS:

3/8" x 3/4" flat head cap screw

This part fits in a microscope accessory
holder dovetail.

clearance for M3 screw

For any questions related to this part, please contact Rob MacLachlan at 412-445-8113 or ram@ri.cmu.edu | DIMENSIONS ARE IN INCHES TOLERANCES: FRACTIONAL ANGULAR: MACH BEND TWO PLACE DECIMAL THREE PLACE DECIMAL | | NAME | DATE | CMU Robotics Institute

DRAWN
CHECKED | | | ASAP adapter plate

ENG APPR.

MFG APPR.

MATERIAL | Q.A.

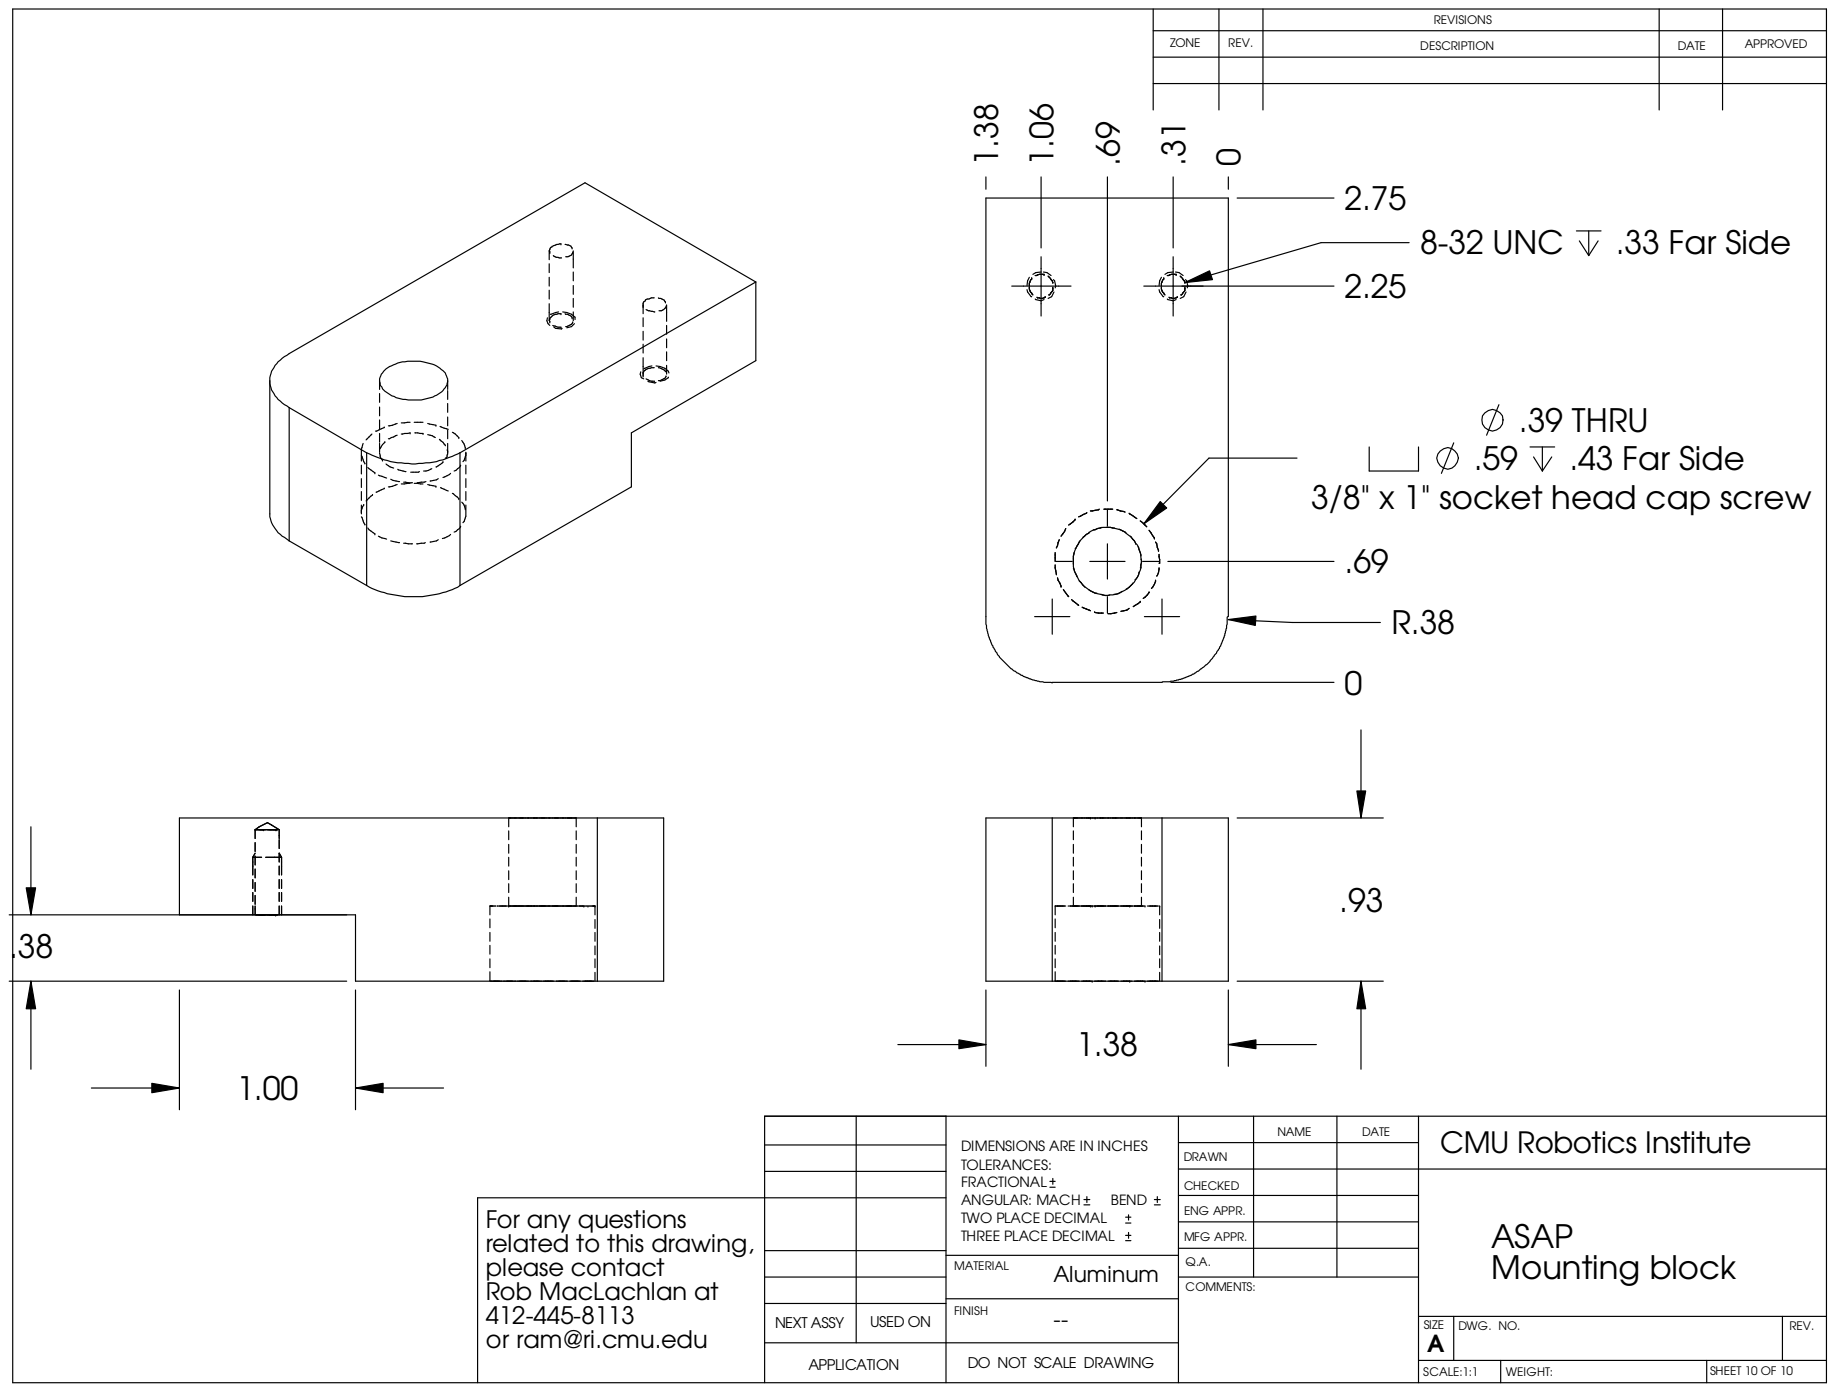
[picture p91: page 10]
.43 Far Side; .39 THRU; 8-32 UNC; .33 Far Side; MATERIAL; FINISH; Aluminum -- APPLICATION; DO NOT SCALE DRAWING NEXT ASSY; USED ON; WEIGHT:; SHEET 10 OF 10; COMMENTS:

3/8" x 1" socket head cap screw

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

DRAWN
CHECKED | | | ASAP Mounting block

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

MFG APPR.
