robmacl/micron_maxon/drawings/Inventor_Design/Micron22_top_adj_02082013_Inventor2013/03172012_Custom_Screw/Custom_Screw.pdf

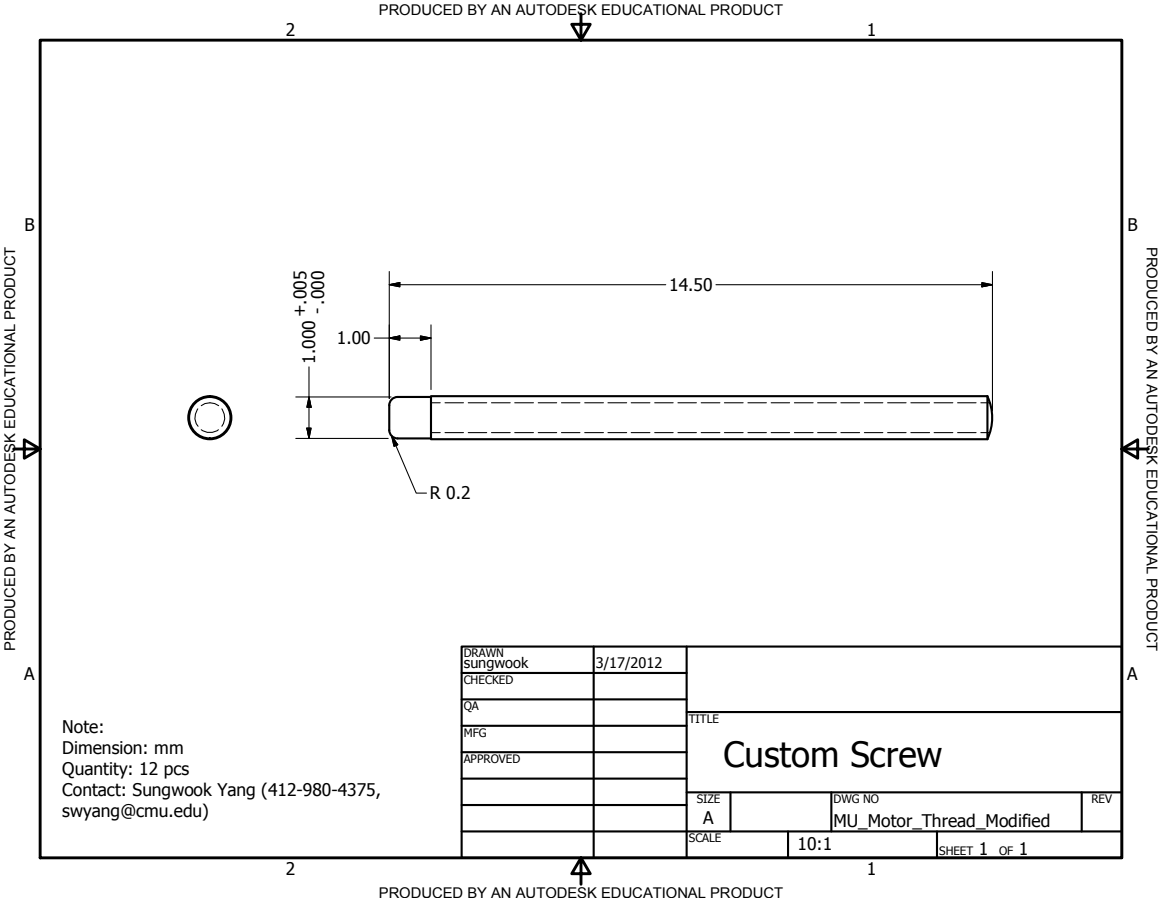
[picture p92: page 1]
TIO; A U T O D E S K E D U C A TIO; DRAWN sungwook; CHECKED; MFG; APPROVED; TITLE; SIZE A; SCALE; DWG NO MU_Motor_Thread_Modified; REV; SHEET 1 OF 1; Custom Screw

PRODUCED BY AN AUTODESK EDUCATIONAL PRODUCT

Note:
Dimension: mm
Quantity: 12 pcs
Contact: Sungwook Yang (412-980-4375,
swyang@cmu.edu)
