robmacl/micron_maxon/drawings/Inventor_Design/Micron22_top_adj_02082013_Inventor2013/09062012_Metric_Parts/Micron_Bearing_Assembly_Rev2(Metric).pdf

B | B

3.30

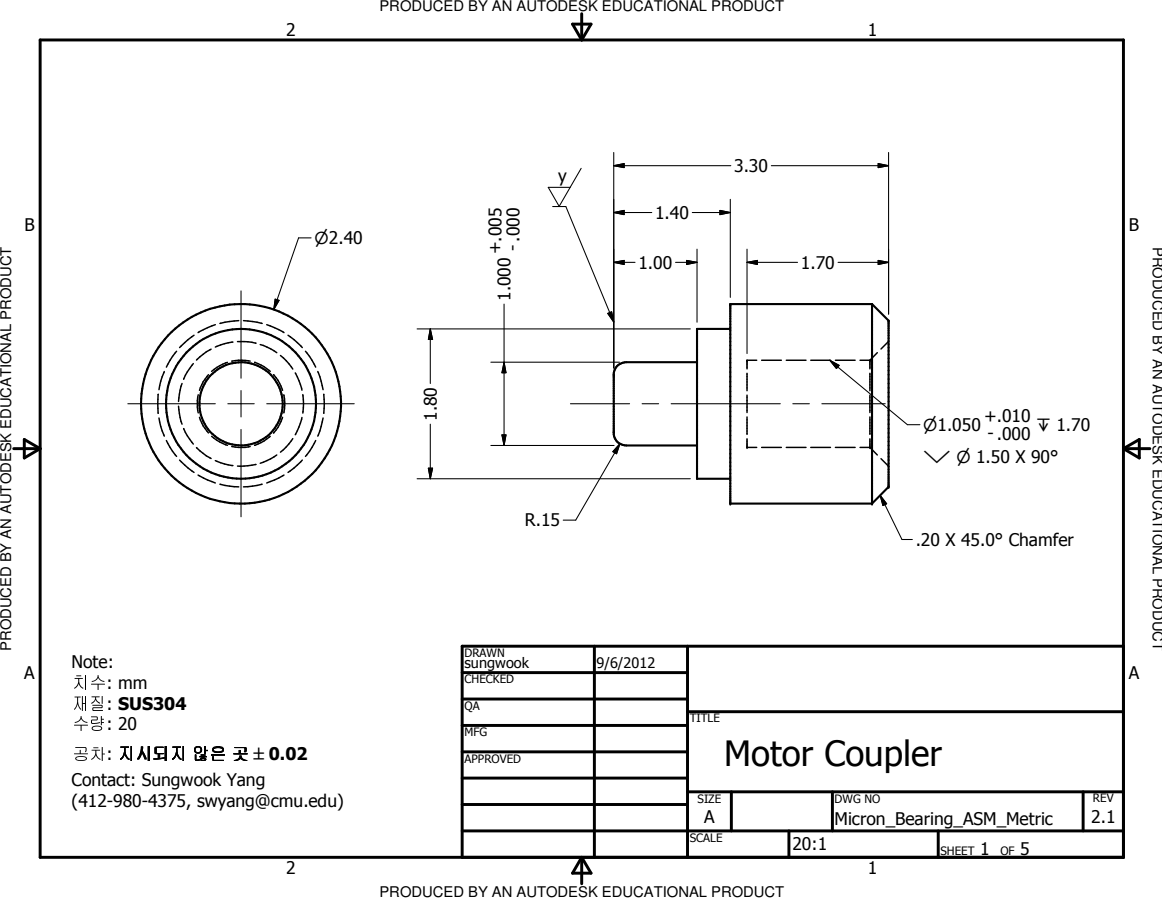
[picture p93: page 1]
TIO; A U T O D E S K E D U C A TIO; TITLE; Note: 치수: mm 재질: SUS304 수량: 20; .20 X 45.0° Chamfer; Motor Coupler

공차: 지시되지 않은 곳 `0.02

DRAWN sungwook | 9/6/2012

CHECKED

MFG

APPROVED

Contact: Sungwook Yang
(412-980-4375, swyang@cmu.edu)

SIZE A | DWG NO Micron_Bearing_ASM_Metric | REV 2.1

SCALE | | SHEET 1 OF 5

PRODUCED BY AN AUTODESK EDUCATIONAL PRODUCT

B | B
n | ` 3.400 .005

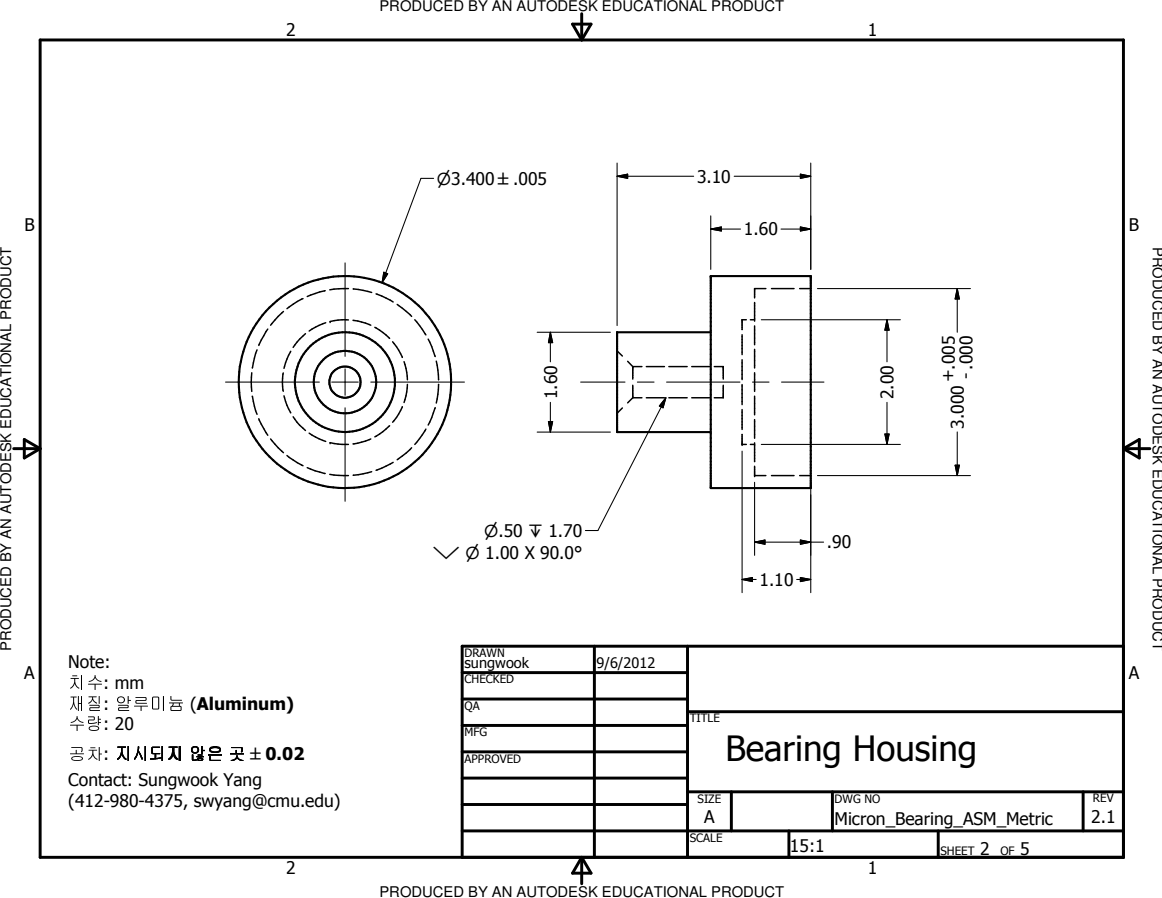
[picture p94: page 2]
TIO; A U T O D E S K E D U C A TIO; TITLE; SIZE A; DWG NO Micron_Bearing_ASM_Metric; REV 2.1; Note:; Bearing Housing

공차: 지시되지 않은 곳 `0.02

재질: 알루미늄 (Aluminum)

DRAWN sungwook | 9/6/2012

CHECKED

MFG

APPROVED

Contact: Sungwook Yang
(412-980-4375, swyang@cmu.edu)

B | B

n3.80

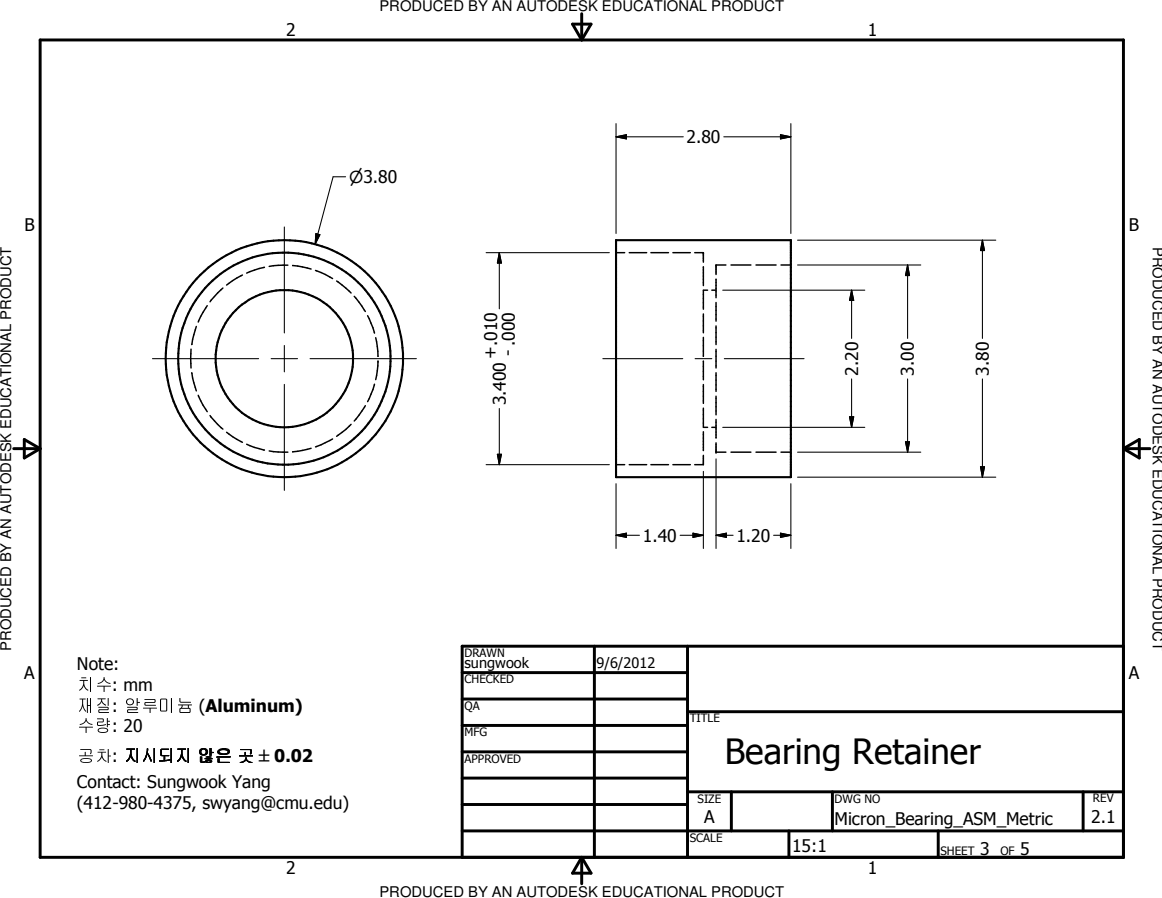
[picture p95: page 3]
TIO; A U T O D E S K E D U C A TIO; TITLE; SIZE A; DWG NO Micron_Bearing_ASM_Metric; REV 2.1; Note:; Bearing Retainer

공차: 지시되지 않은 곳 `0.02

재질: 알루미늄 (Aluminum)

DRAWN sungwook | 9/6/2012

CHECKED

MFG

APPROVED

Contact: Sungwook Yang
(412-980-4375, swyang@cmu.edu)
