robmacl/micron_maxon/drawings/Inventor_Design/Micron22_top_adj_02082013_Inventor2013/Cannulation/ASM_Micron_ASAP_v4_0.pdf

# PRODUCED BY AN AUTODESK EDUCATIONAL PRODUCT

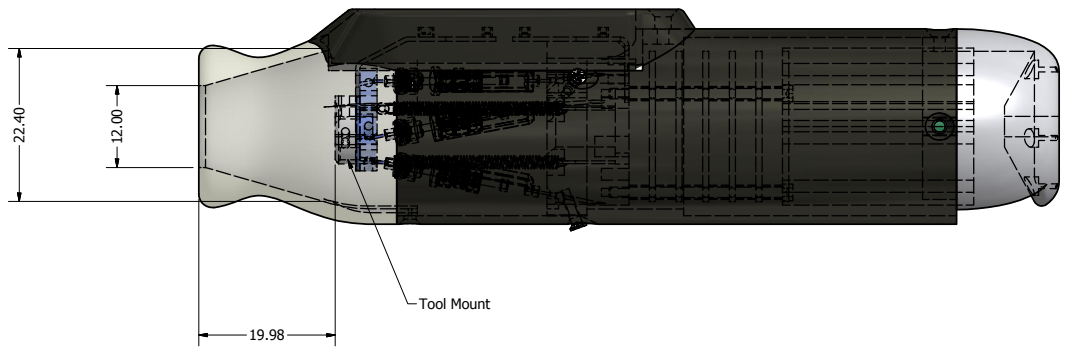
[picture p101: page 1]
TIO; P R O D U C E D B Y A N A U T O D E S K E D U C A TIO; SHEET 1 OF 1; DRAWN; CHECKED; MFG; APPROVED; sungwook; DWG NO ASM_Micron_ASAP_v4_0_wo_tool; TITLE; SIZE C; SCALE; REV; Tool Mount

PRODUCED BY AN AUTODESK EDUCATIONAL PRODUCT

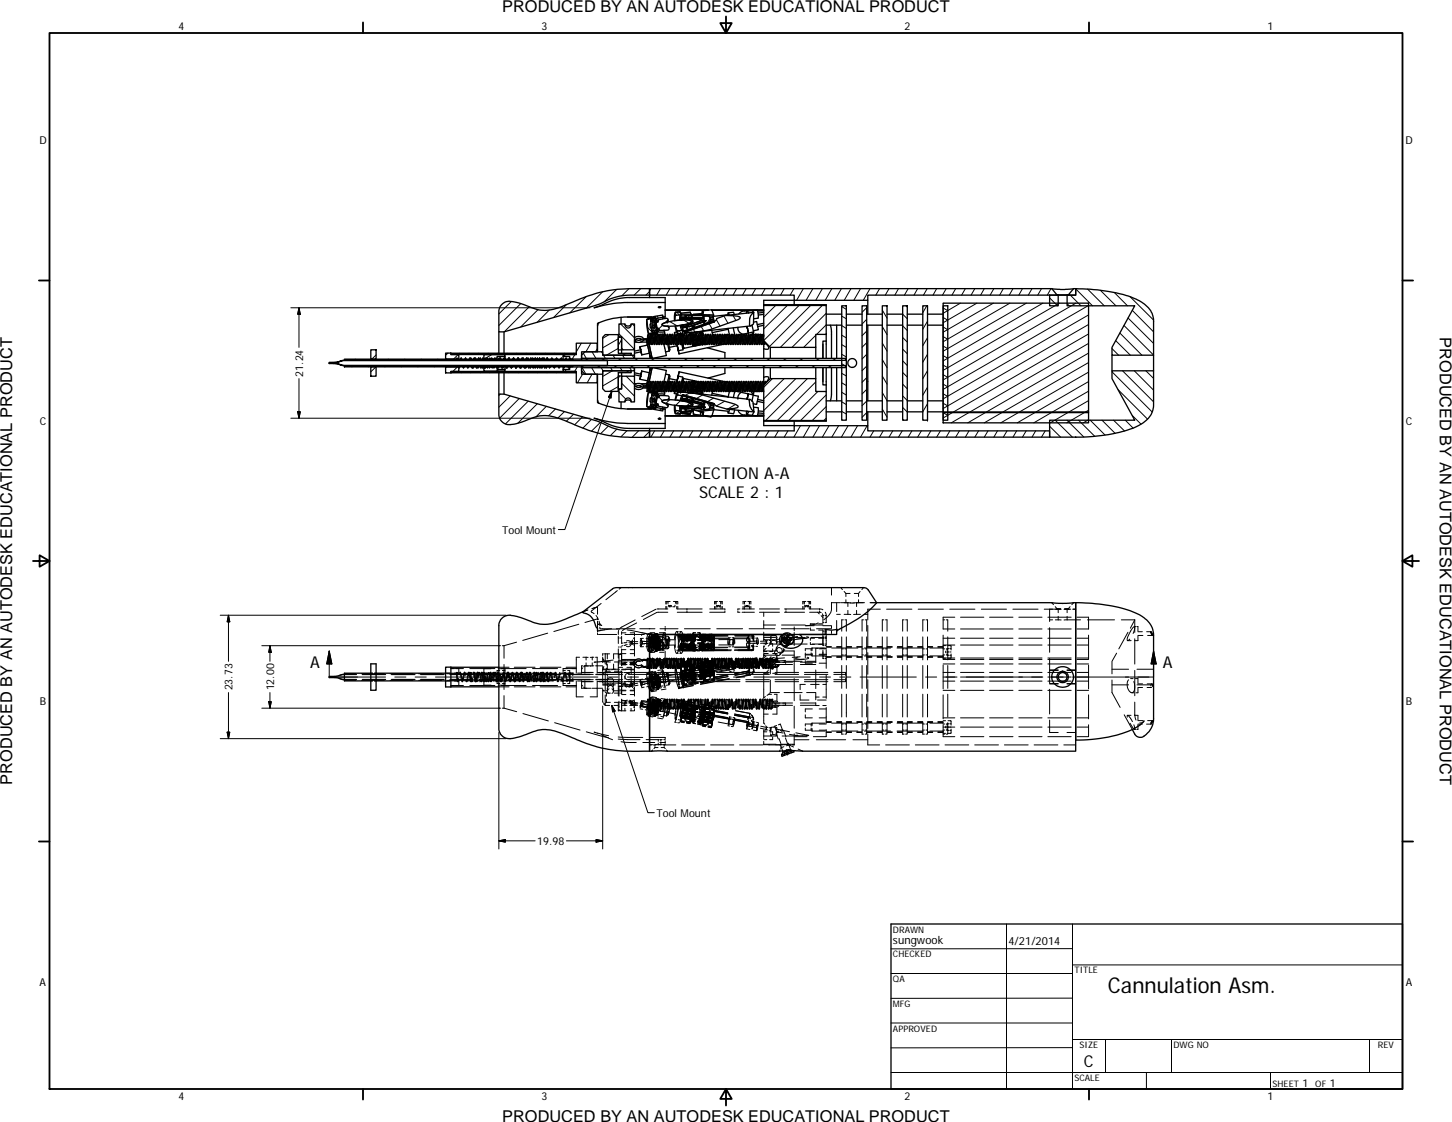
[picture p102: page 2]
SECTION A-A SCALE 2 : 1; SHEET 1 OF 1; DRAWN; CHECKED; MFG; APPROVED; sungwook; DWG NO; TITLE; SIZE C; SCALE; REV; Tool Mount; Cannulation Asm.

PRODUCED BY AN AUTODESK EDUCATIONAL PRODUCT
