robmacl/micron_maxon/drawings/Inventor_Design/Micron22_top_adj_02082013_Inventor2013/Cannulation/Bottom_cap.pdf

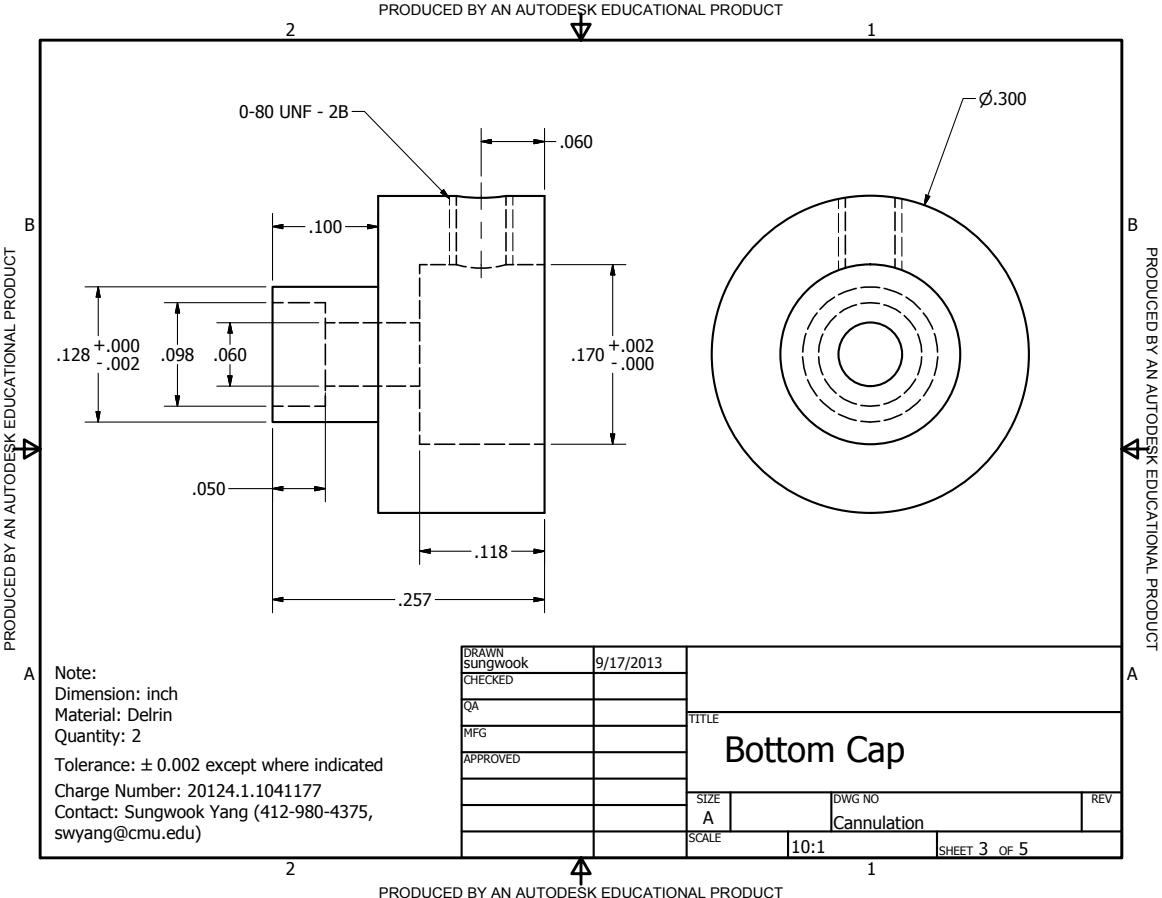
[picture p103: page 1]
TIO; A U T O D E S K E D U C A TIO; DRAWN sungwook; CHECKED; MFG; APPROVED; TITLE; SIZE A; SCALE; DWG NO Cannulation; REV; SHEET 3 OF 5; 0-80 UNF - 2B; Note:; Bottom Cap

PRODUCED BY AN AUTODESK EDUCATIONAL PRODUCT

Dimension: inch
Material: Delrin
Quantity: 2
Tolerance: B0.002 except where indicated
Charge Number: 20124.1.1041177
Contact: Sungwook Yang (412-980-4375,
swyang@cmu.edu)
