robmacl/micron_maxon/drawings/Inventor_Design/Micron22_top_adj_02082013_Inventor2013/Cannulation/Cannulation.pdf

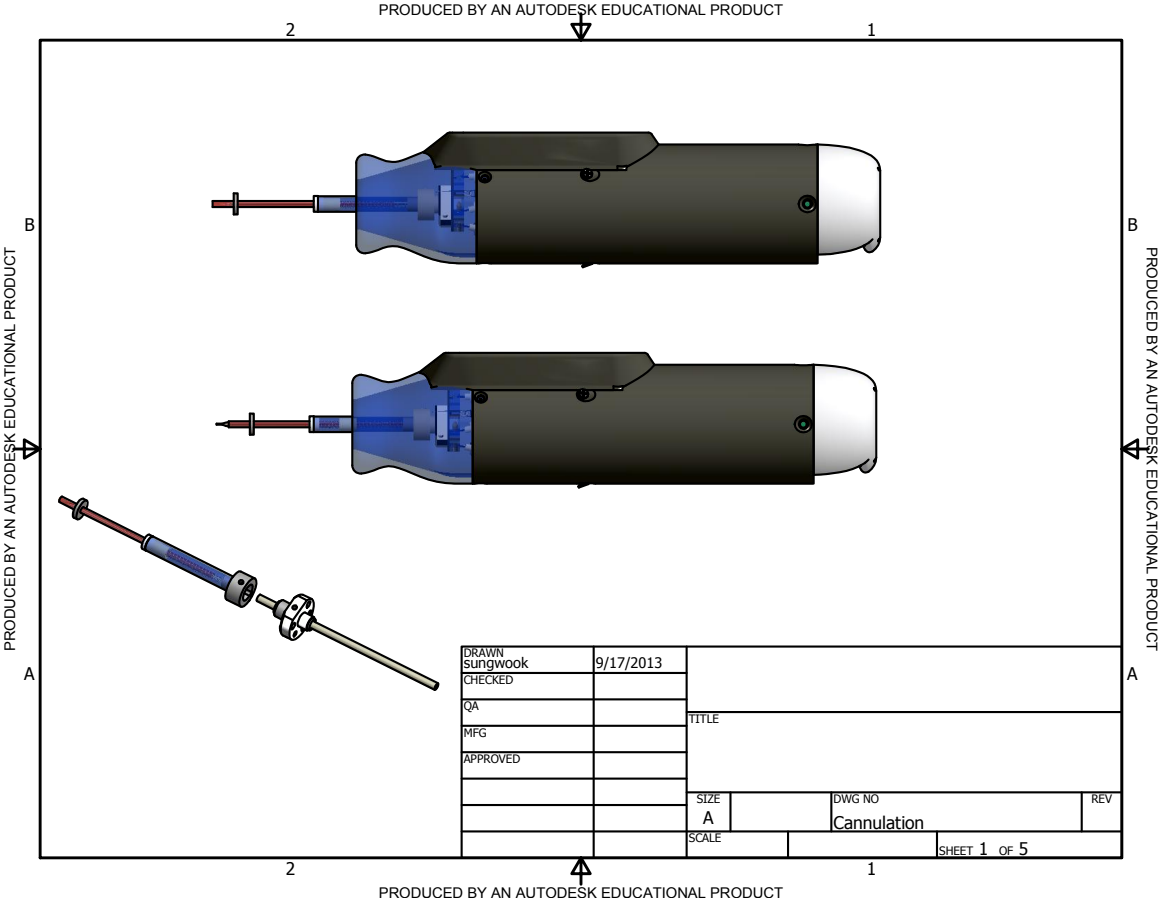
[picture p104: page 1]
TIO; ula

PRODUCED BY AN AUTODESK EDUCATIONAL PRODUCT

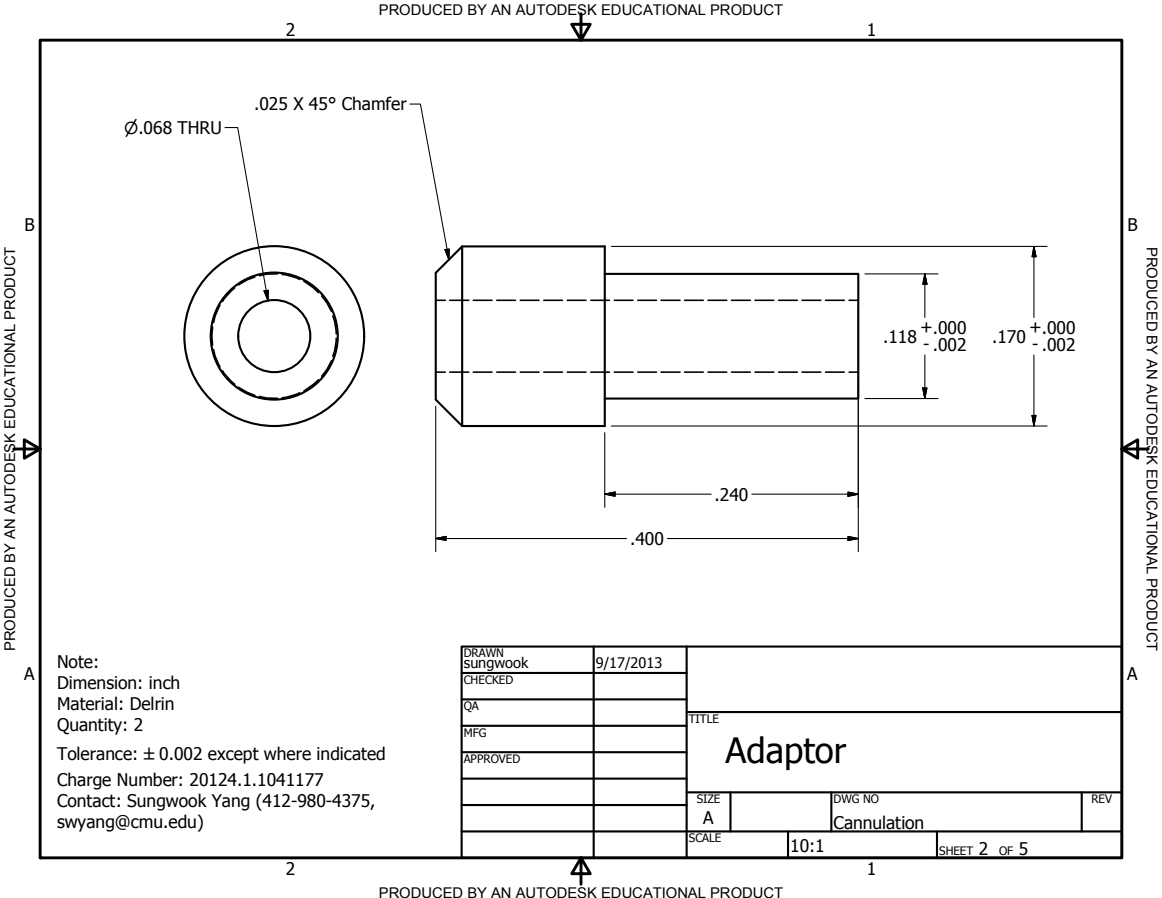
[picture p105: page 2]
TIO; A U T O D E S K E D U C A TIO; DRAWN sungwook; CHECKED; MFG; APPROVED; TITLE; SIZE A; SCALE; DWG NO Cannulation; REV; SHEET 2 OF 5; P.068 THRU; .025 X 45° Chamfer; Note:; Adaptor

Dimension: inch
Material: Delrin
Quantity: 2
Tolerance: B0.002 except where indicated
Charge Number: 20124.1.1041177
Contact: Sungwook Yang (412-980-4375,
swyang@cmu.edu)

PRODUCED BY AN AUTODESK EDUCATIONAL PRODUCT

TIO; A U T O D E S K E D U C A TIO; DRAWN sungwook; CHECKED; MFG; APPROVED; TITLE; SIZE A; DWG NO Cannulation; REV; 0-80 UNF - 2B; Note:; Bottom Cap

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

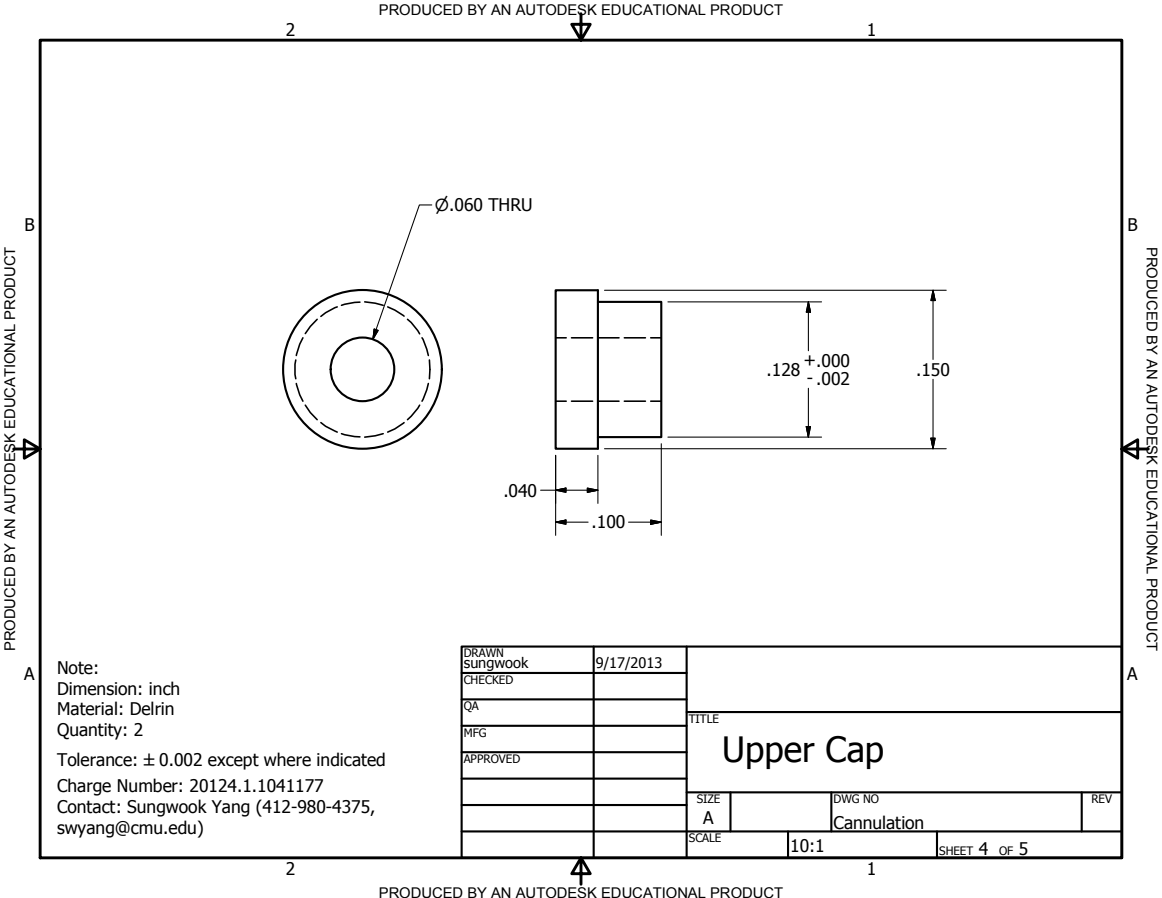
[picture p106: page 4]
TIO; A U T O D E S K E D U C A TIO; DRAWN sungwook; CHECKED; MFG; APPROVED; TITLE; SIZE A; DWG NO Cannulation; REV; P.060 THRU; Note:; Upper Cap

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

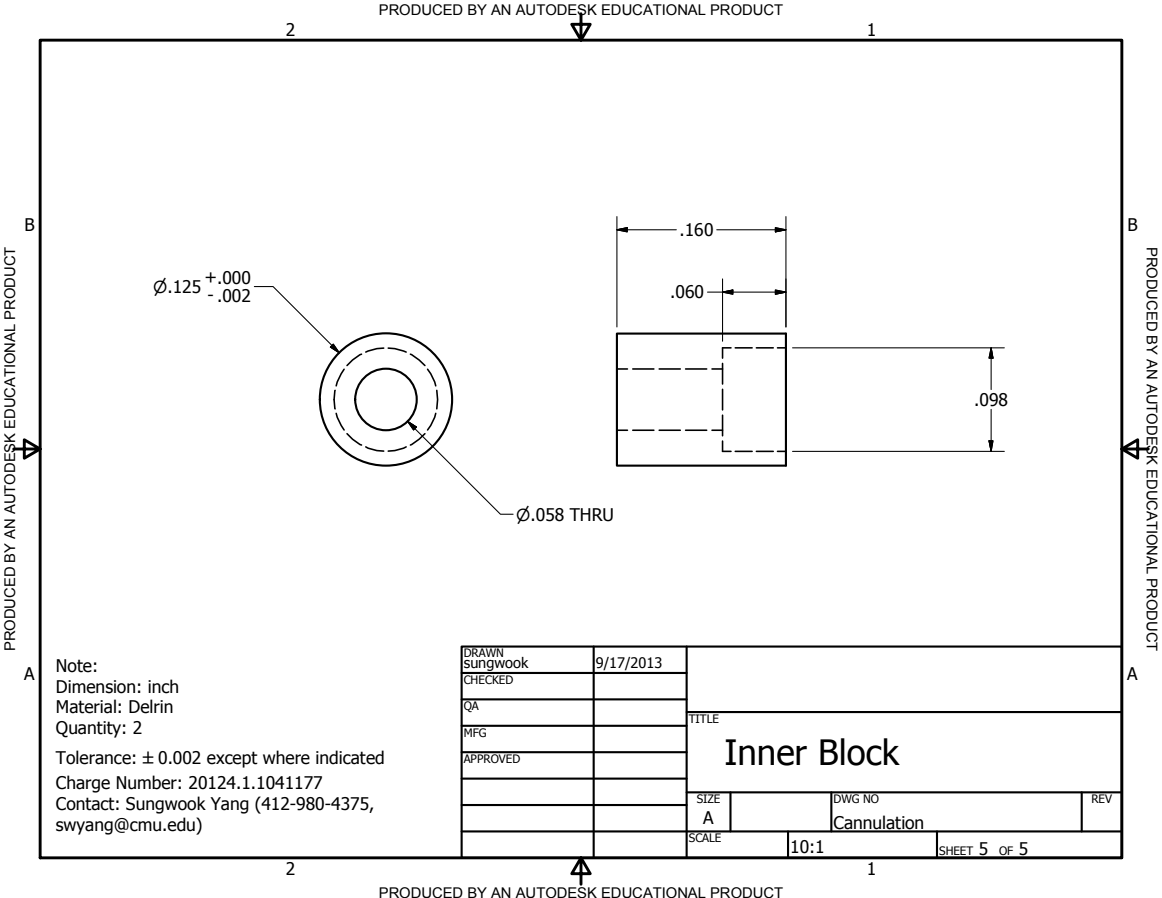
[picture p107: page 5]
TIO; A U T O D E S K E D U C A TIO; DRAWN sungwook; CHECKED; MFG; APPROVED; TITLE; SIZE A; DWG NO Cannulation; REV; P.058 THRU; Note:; Inner Block

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
