robmacl/micron_maxon/drawings/Inventor_Design/Micron22_top_adj_02082013_Inventor2013/Cannulation/Cannulation_for_JHU.pdf

TIO; ula

PRODUCED BY AN AUTODESK EDUCATIONAL PRODUCT

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

PRODUCED BY AN AUTODESK EDUCATIONAL PRODUCT

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

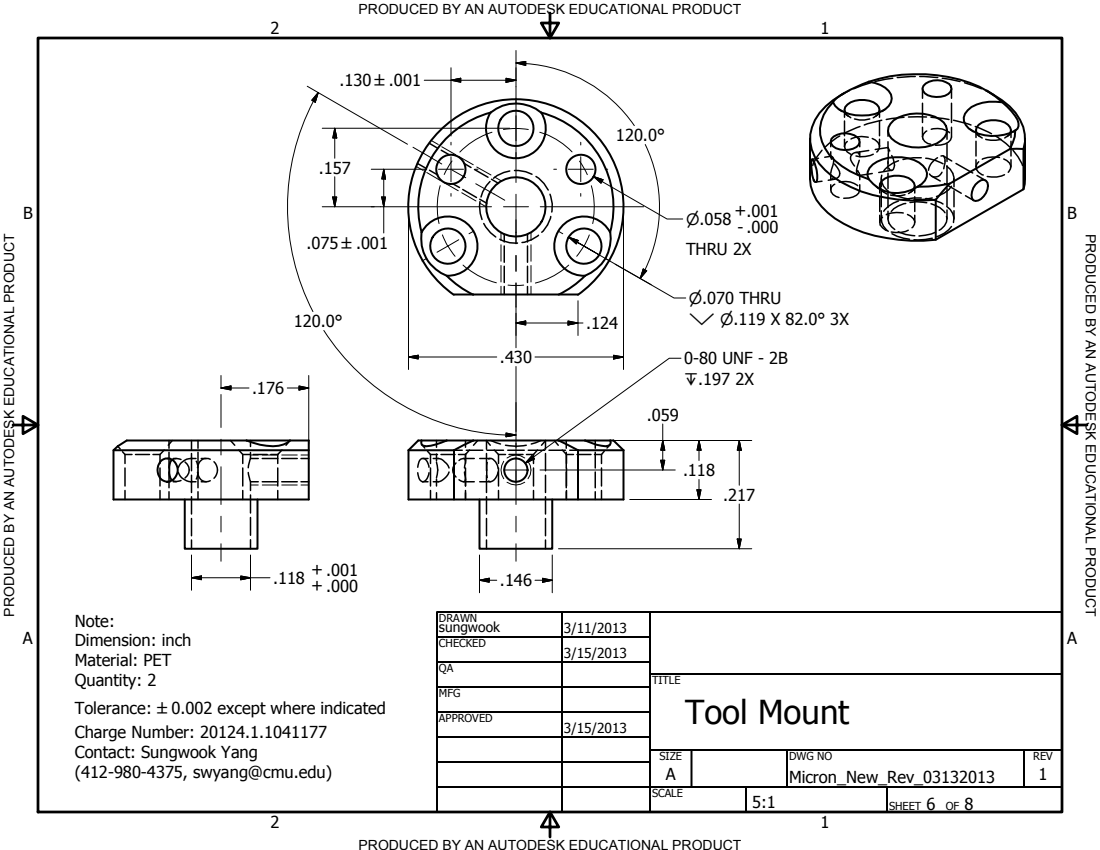
[picture p108: page 3]
TIO; A U T O D E S K E D U C A TIO; DRAWN sungwook; CHECKED; MFG; APPROVED; TITLE; SIZE A; SCALE; DWG NO Micron_New_Rev_03132013; REV 1; SHEET 6 OF 8; 0-80 UNF - 2B Z.197 2X; P.070 THRU Y P.119 X 82.0° 3X; THRU 2X; Tool Mount

PRODUCED BY AN AUTODESK EDUCATIONAL PRODUCT

Note:
Dimension: inch
Material: PET
Quantity: 2
Tolerance: B0.002 except where indicated
Charge Number: 20124.1.1041177
Contact: Sungwook Yang
(412-980-4375, swyang@cmu.edu)
