robmacl/micron_maxon/drawings/Inventor_Design/Micron22_top_adj_02082013_Inventor2013/Drawings/Micron_Bearing_ASM(CMU).pdf

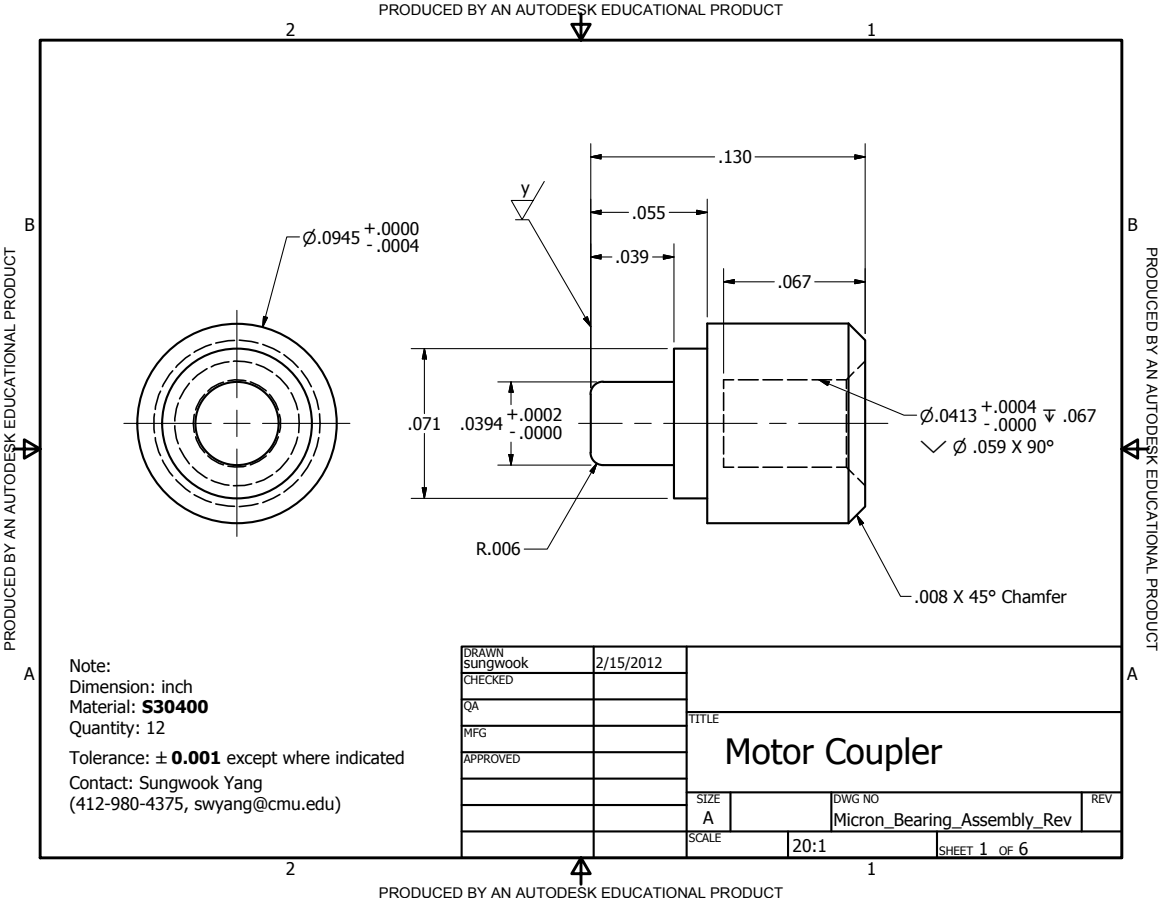
[picture p109: page 1]
TIO; A U T O D E S K E D U C A TIO; DRAWN sungwook; CHECKED; MFG; APPROVED; TITLE; SIZE A; SCALE; DWG NO Micron_Bearing_Assembly_Rev; REV; SHEET 1 OF 6; .008 X 45° Chamfer; Note:; Motor Coupler

Dimension: inch
Material: S30400
Quantity: 12
Tolerance: B0.001 except where indicated
Contact: Sungwook Yang
(412-980-4375, swyang@cmu.edu)

PRODUCED BY AN AUTODESK EDUCATIONAL PRODUCT

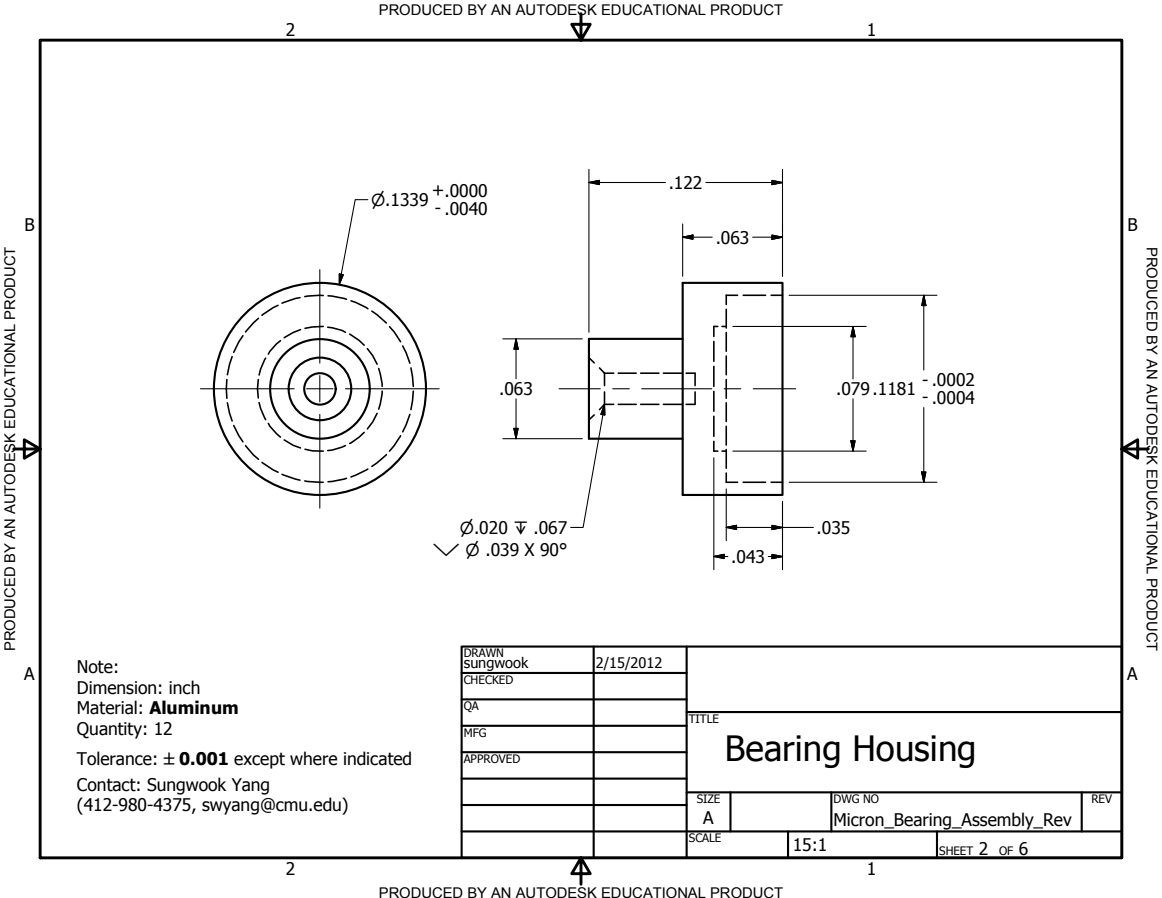
[picture p110: page 2]
TIO; A U T O D E S K E D U C A TIO; DRAWN sungwook; CHECKED; MFG; APPROVED; TITLE; SIZE A; DWG NO Micron_Bearing_Assembly_Rev; REV; Bearing Housing

Note:
Dimension: inch
Material: Aluminum
Quantity: 12
Tolerance: B0.001 except where indicated
Contact: Sungwook Yang
(412-980-4375, swyang@cmu.edu)

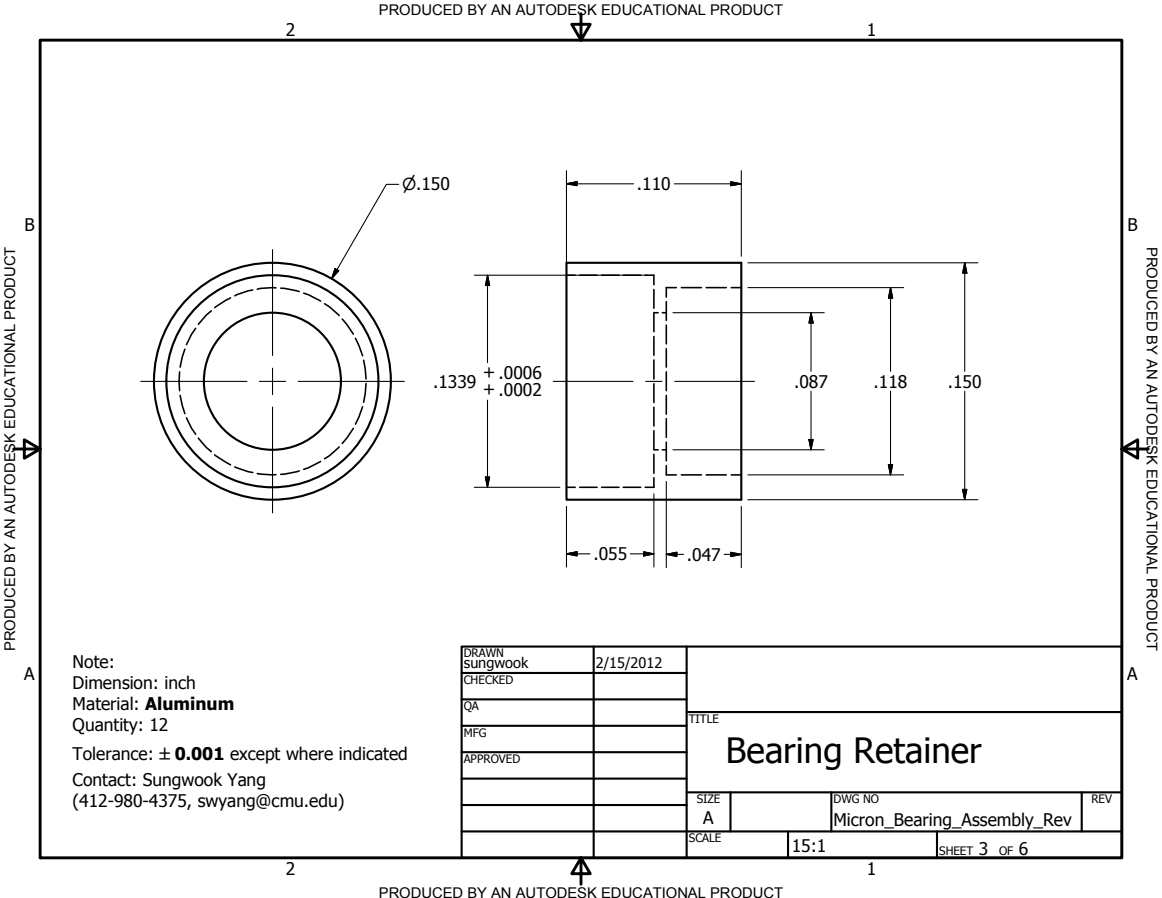
[picture p111: page 3]
TIO; A U T O D E S K E D U C A TIO; DRAWN sungwook; CHECKED; MFG; APPROVED; TITLE; SIZE A; DWG NO Micron_Bearing_Assembly_Rev; REV; Note:; Bearing Retainer

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

TIO; A U T O D E S K E D U C A TIO; DRAWN sungwook; CHECKED; MFG; APPROVED; SIZE A; DWG NO Micron_Bearing_Assembly_Rev; REV; Note:

Dimension: inch
Material: S30400
Quantity: 1
Tolerance: B0.001 except where indicated
Contact: Sungwook Yang
(412-980-4375, swyang@cmu.edu)

TITLE
Bearing ID ASM Base

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

Dimension: inch
Material: S30400
Quantity: 1
Tolerance: B0.05 except where indicated
Contact: Sungwook Yang
(412-980-4375, swyang@cmu.edu)

TITLE
Screw ASM Jig Base

TIO; A U T O D E S K E D U C A TIO; DRAWN sungwook; CHECKED; MFG; APPROVED; SIZE A; DWG NO Micron_Bearing_Assembly_Rev; REV; .020 X 45° Chamfer; 2-56 UNC - 2B; Note:

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

TITLE
Screw ASM Jig Holder
