robmacl/micron_maxon/drawings/Inventor_Design/Micron22_top_adj_02082013_Inventor2013/Drawings/Micron_New_Rev4.pdf

C

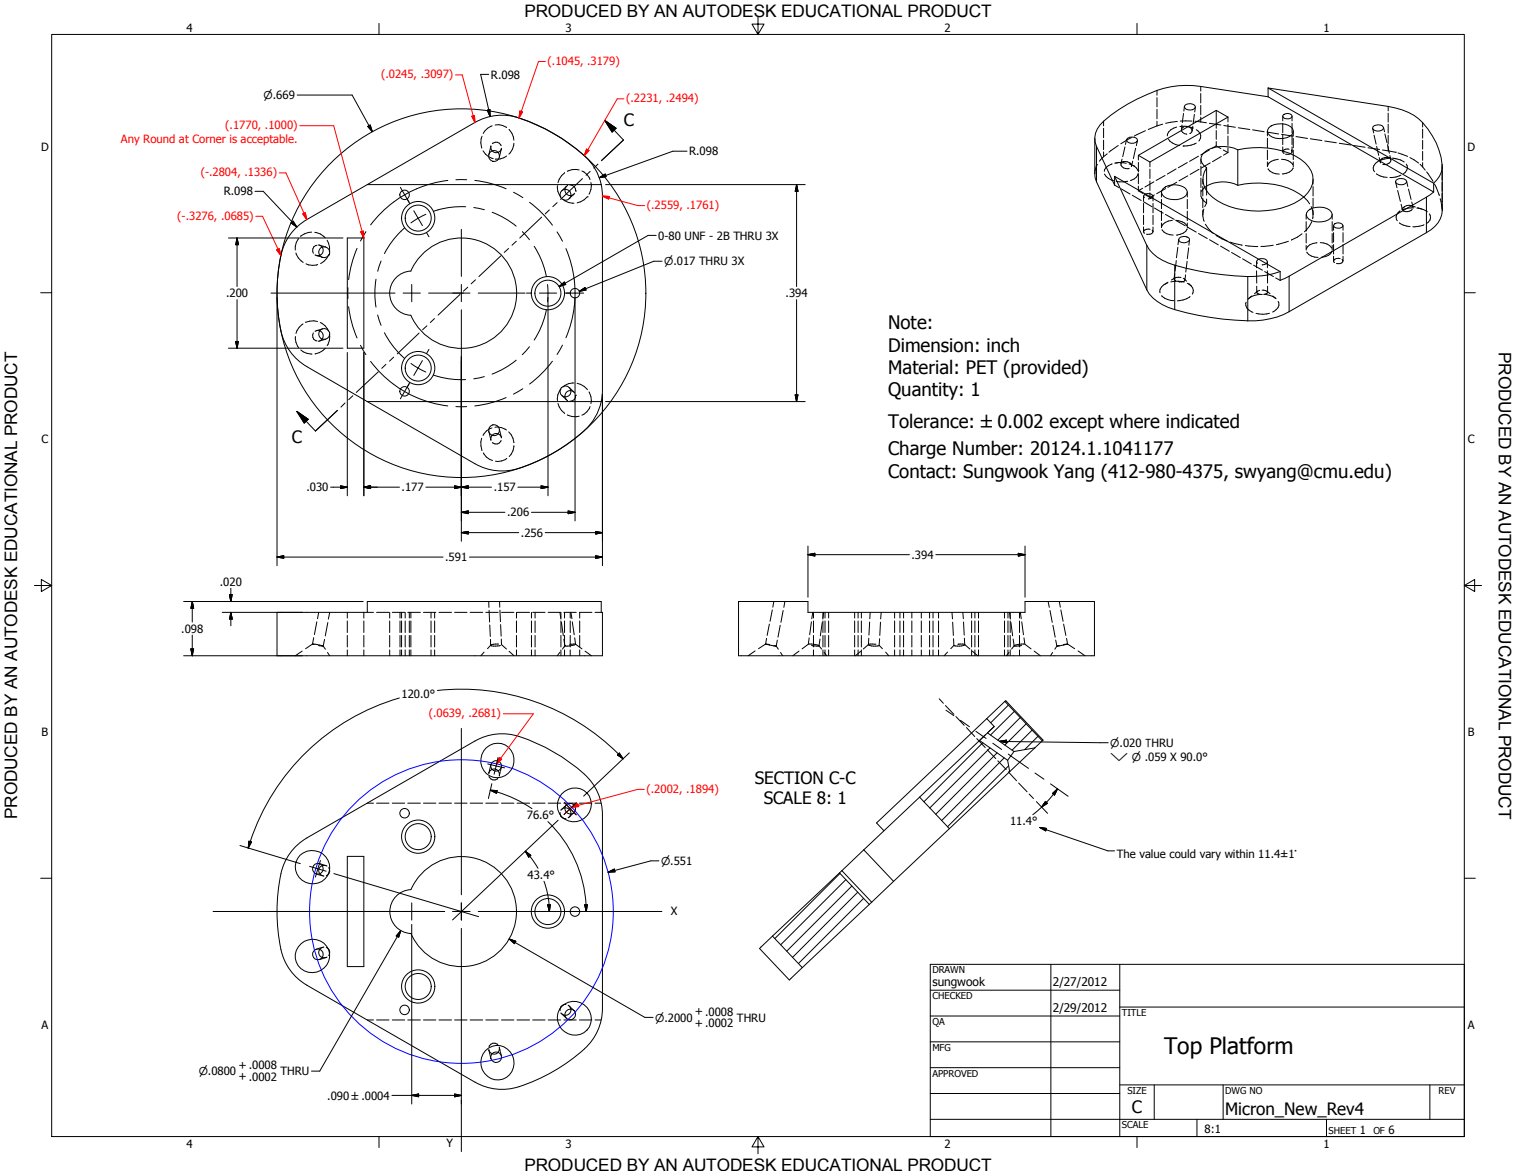
[picture p112: page 1]
SECTION C-C SCALE 8: 1; TIO; P R O D U C E D B Y A N A U T O D E S K E D U C A TIO; TITLE; Top Platform; THRU; P.017 THRU 3X; 0-80 UNF - 2B THRU 3X; P.020 6HRU Y P .059 X 90.0°

Any Round at Corner is acceptable.

Note:
Dimension: inch
Material: PET (provided)
Quantity: 1
Tolerance: B0.002 except where indicated
Charge Number: 20124.1.1041177
Contact: Sungwook Yang (412-980-4375, swyang@cmu.edu)

The value could vary within 11.4±1`

DRAWN sungwook | 2/27/2012

CHECKED | 2/29/2012

MFG

APPROVED

SIZE C | DWG NO Micron_New_Rev4 | REV

SCALE | | SHEET 1 OF 6

PRODUCED BY AN AUTODESK EDUCATIONAL PRODUCT

A

A

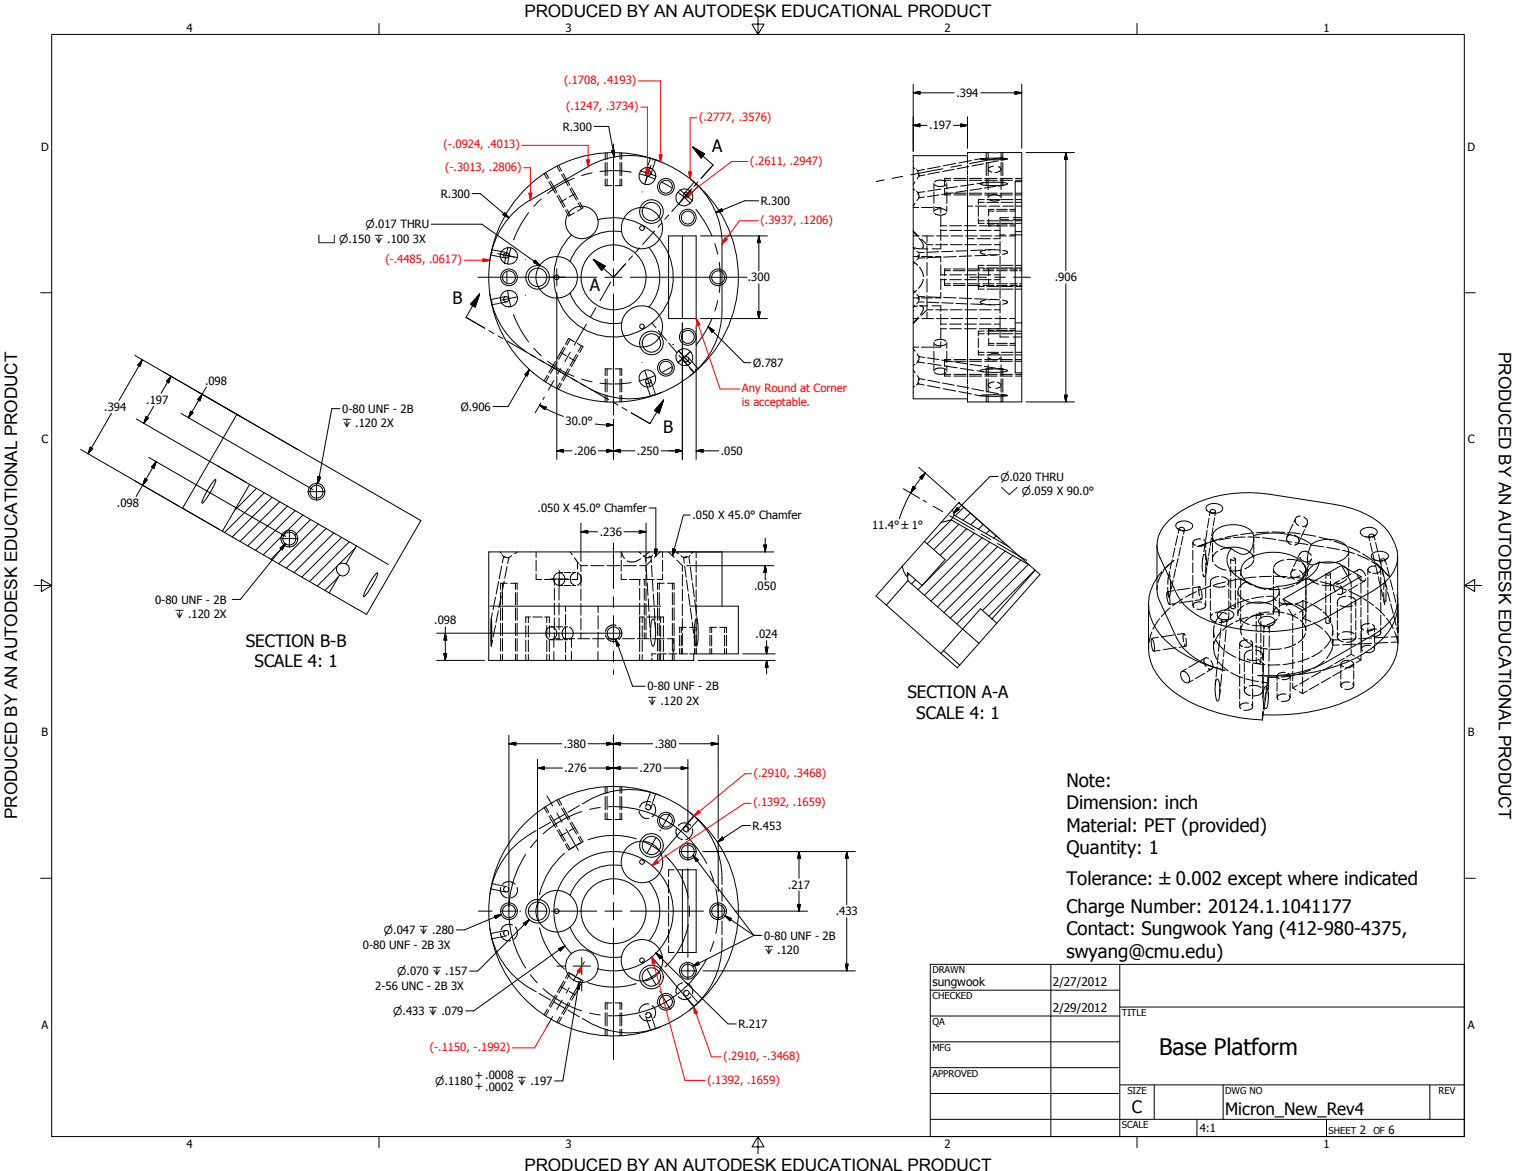
[picture p113: page 2]
SECTION A-A SCALE 4: 1; SECTION B-B SCALE 4: 1; TIO; P R O D U C E D B Y A N A U T O D E S K E D U C A TIO; DWG NO Micron_New_Rev4; TITLE; SIZE; REV; Base Platform; 0-80 UNF - 2B 3X; 2-56 UNC - 2B 3X; P.017 THRU X P.150 Z .100 3X; .050 X 45.0° Chamfer; 0-80 UNF - 2B Z .120 2X; P.020 THRU Y P.059 X 90.0°; 0-80 UNF - 2B Z .120

Any Round at Corner
is acceptable.

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

DRAWN sungwook | 2/27/2012

CHECKED | 2/29/2012

MFG

APPROVED

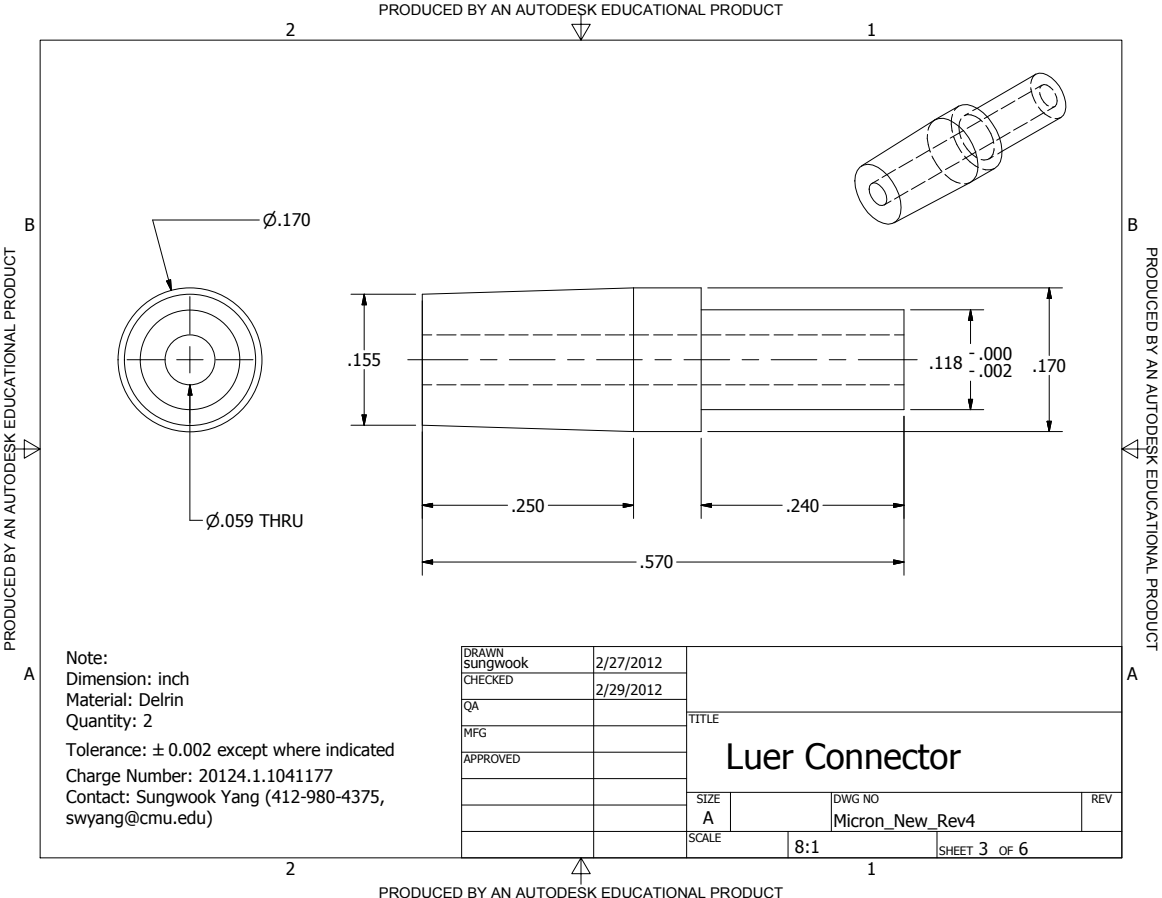
[picture p114: page 3]
TIO; A U T O D E S K E D U C A TIO; TITLE; SIZE A; DWG NO Micron_New_Rev4; REV; P.059 THRU; Luer Connector; Note:

Dimension: inch
Material: Delrin
Quantity: 2
Tolerance: B0.002 except where indicated
Charge Number: 20124.1.1041177
Contact: Sungwook Yang (412-980-4375,
swyang@cmu.edu)

DRAWN sungwook | 2/27/2012

CHECKED | 2/29/2012

MFG

APPROVED

B
P

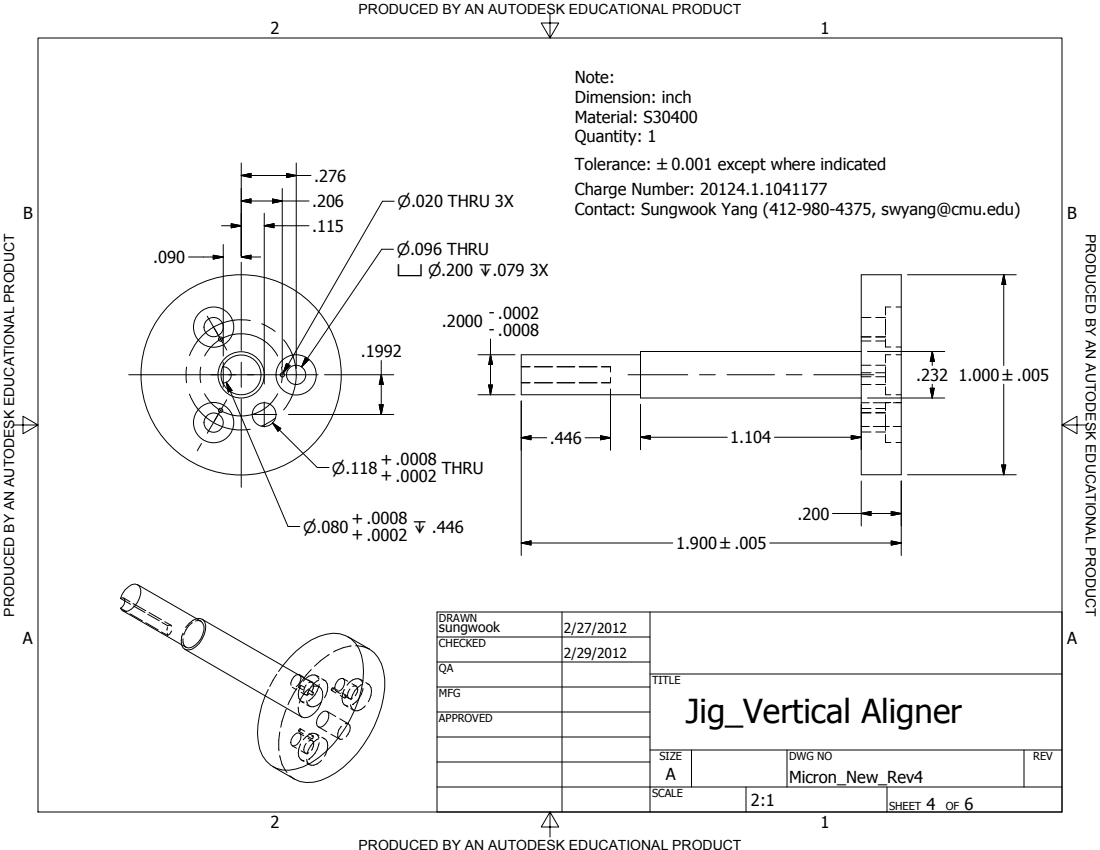
[picture p115: page 4]
TIO; ole; al Ali

PRODUCED BY AN AUTODESK EDUCATIONAL PRODUCT

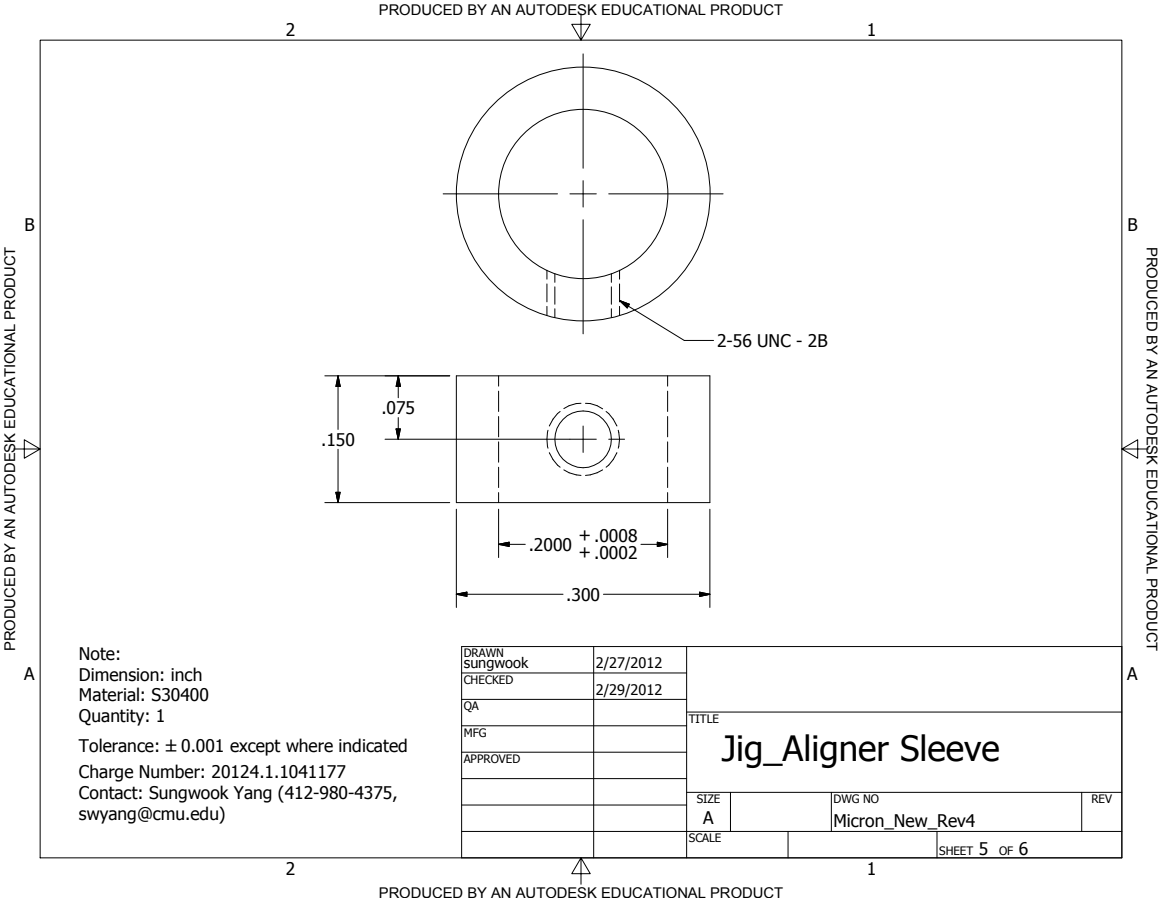
[picture p116: page 5]
TIO; A U T O D E S K E D U C A TIO; TITLE; SIZE A; DWG NO Micron_New_Rev4; REV; Jig_Aligner Sleeve; 2-56 UNC - 2B

Note:
Dimension: inch
Material: S30400
Quantity: 1
Tolerance: B0.001 except where indicated
Charge Number: 20124.1.1041177
Contact: Sungwook Yang (412-980-4375,
swyang@cmu.edu)

DRAWN sungwook | 2/27/2012

CHECKED | 2/29/2012

MFG

APPROVED

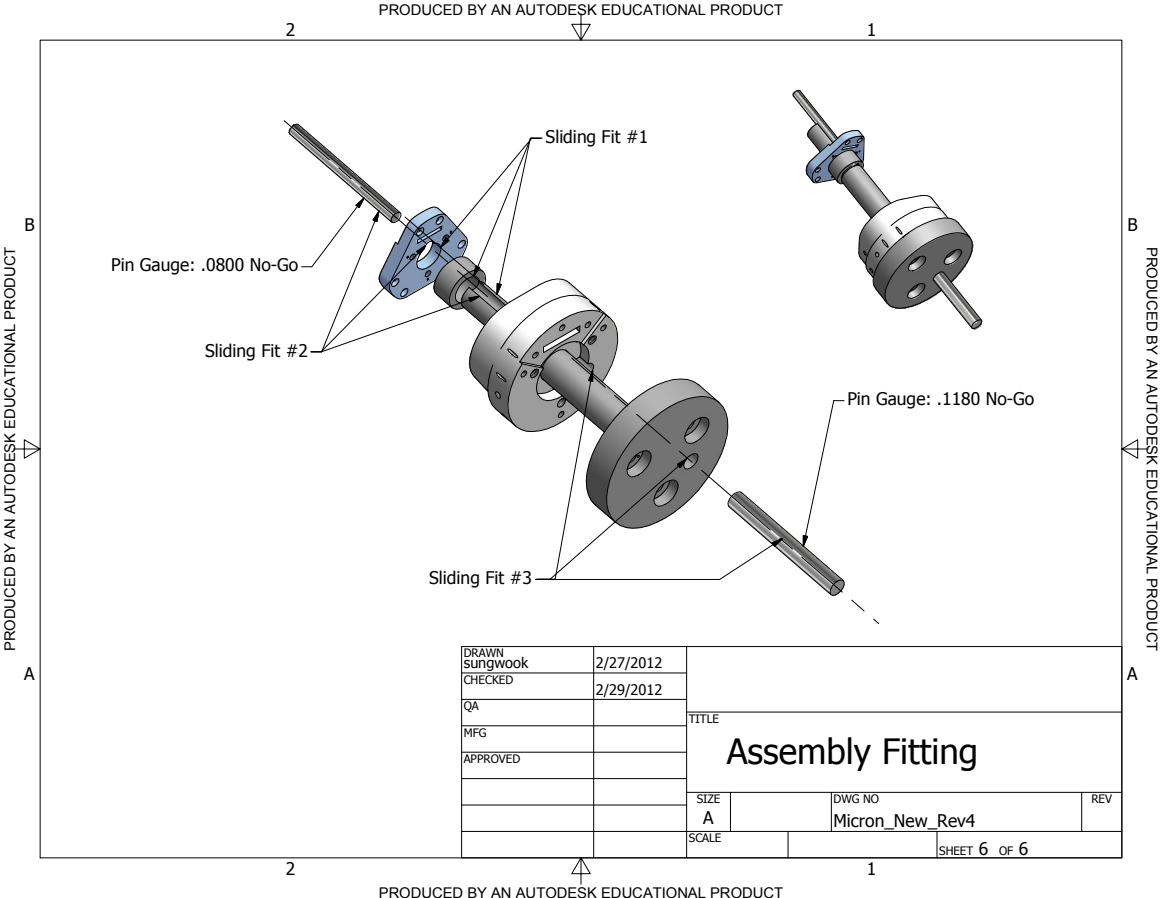
[picture p117: page 6]
TIO; A U T O D E S K E D U C A TIO; TITLE; SIZE A; DWG NO Micron_New_Rev4; REV; Sliding Fit #1; Sliding Fit #3; Assembly Fitting; Sliding Fit #2

Pin Gauge: .0800 No-Go

Pin Gauge: .1180 No-Go

DRAWN sungwook | 2/27/2012

CHECKED | 2/29/2012

MFG

APPROVED
