robmacl/micron_maxon/drawings/Inventor_Design/Micron22_top_adj_02082013_Inventor2013/Drawings/Micron_New_Rev_03132013.pdf

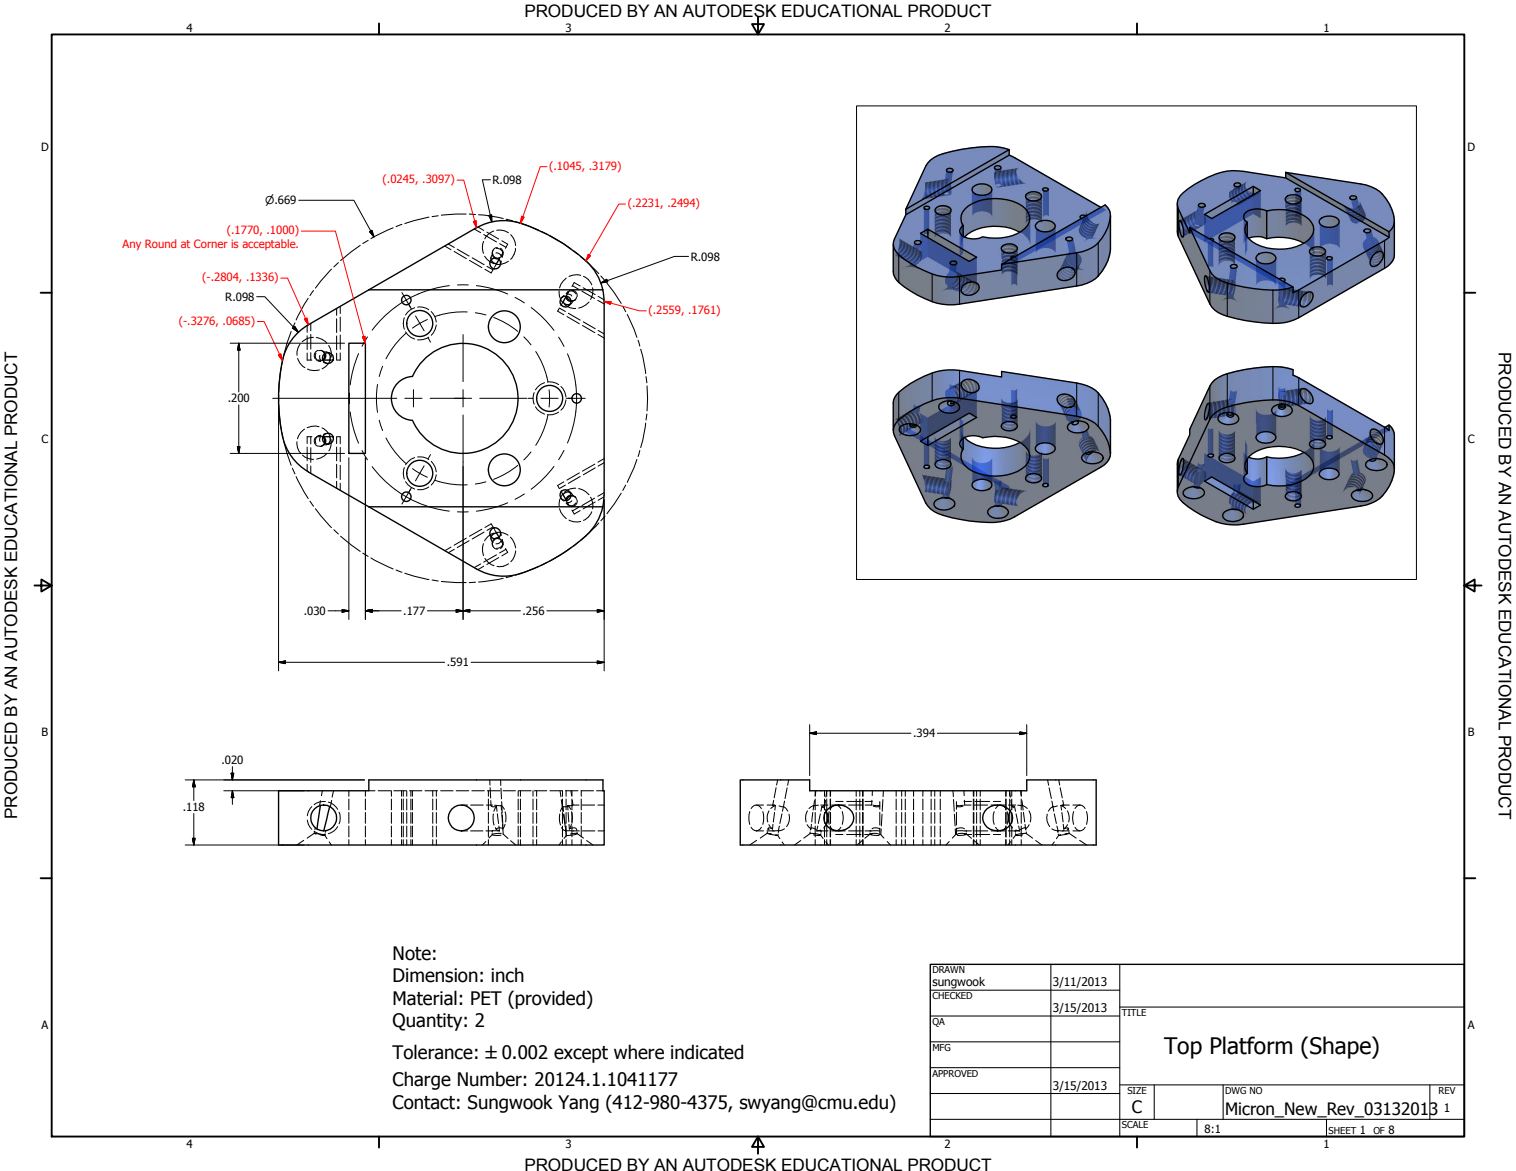
[picture p131: page 1]
TIO; P R O D U C E D B Y A N A U T O D E S K E D U C A TIO; SHEET 1 OF 8; DRAWN; CHECKED; MFG; APPROVED; sungwook; DWG NO; Micron_New_Rev_03132013; SIZE C; SCALE; REV

Any Round at Corner is acceptable.

Note:
Dimension: inch
Material: PET (provided)
Quantity: 2
Tolerance: B0.002 except where indicated
Charge Number: 20124.1.1041177
Contact: Sungwook Yang (412-980-4375, swyang@cmu.edu)

TITLE
Top Platform (Shape)

PRODUCED BY AN AUTODESK EDUCATIONAL PRODUCT

C

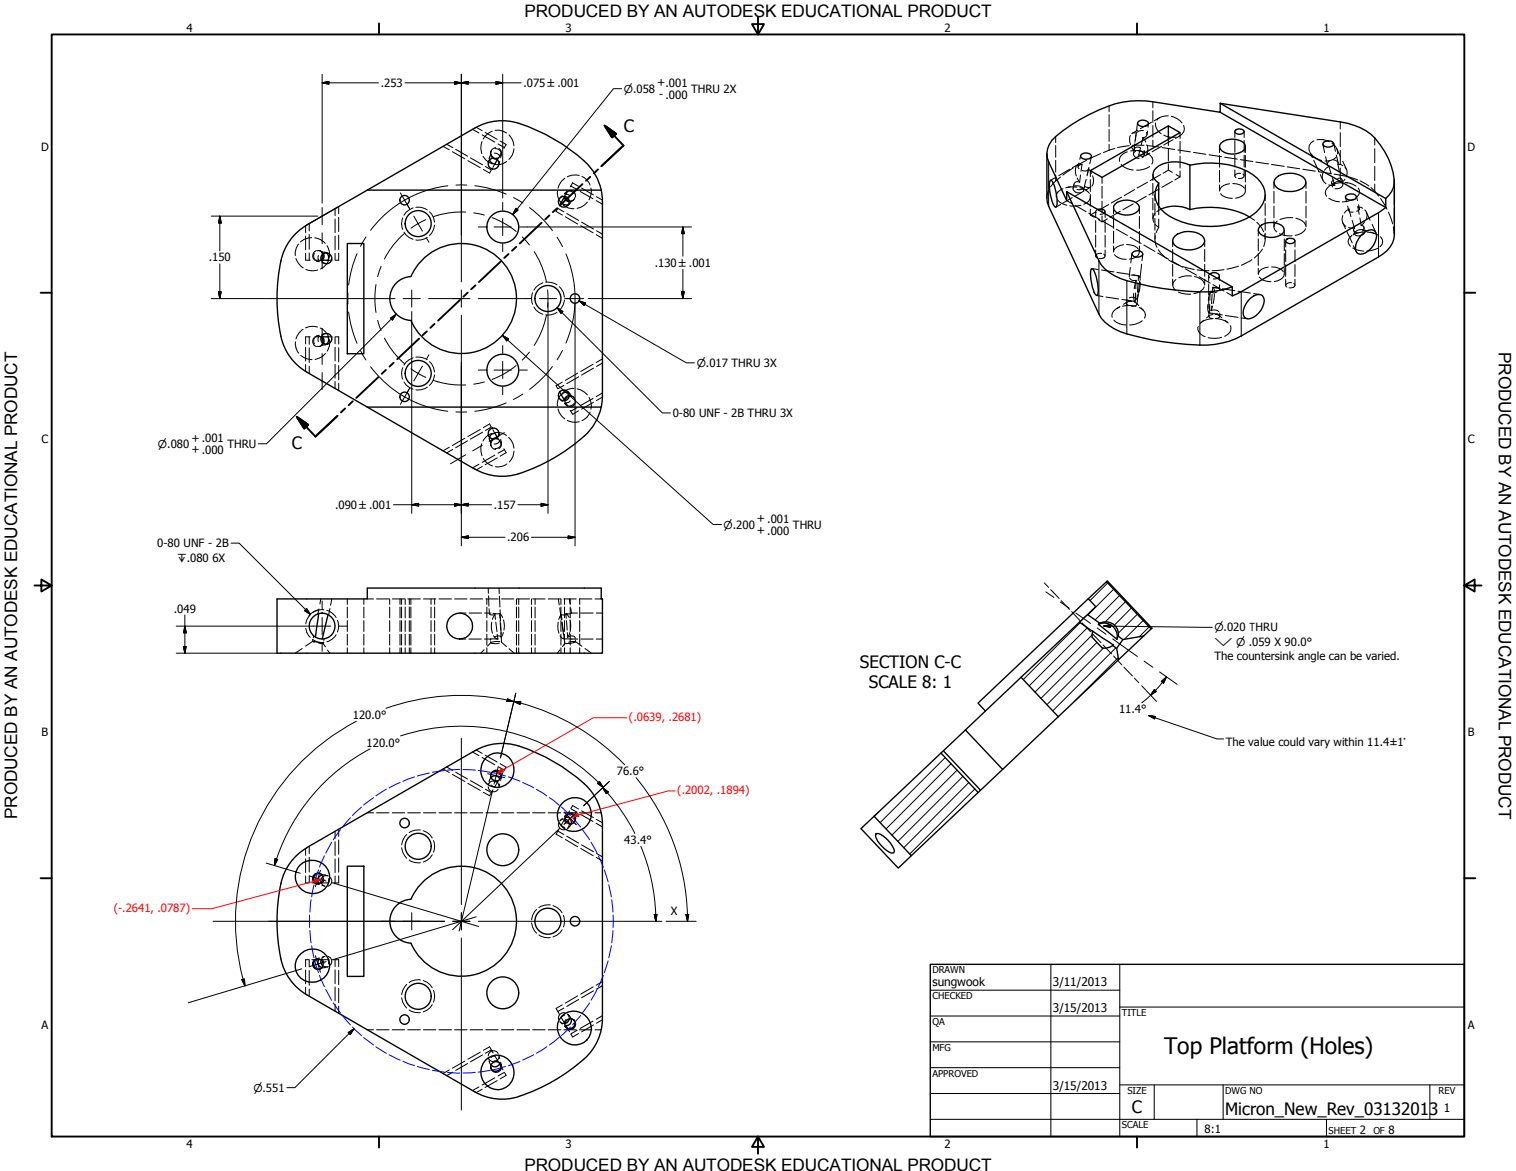
[picture p132: page 2]
SECTION C-C SCALE 8: 1; TIO; P R O D U C E D B Y A N A U T O D E S K E D U C A TIO; DRAWN; CHECKED; MFG; sungwook; P.017 THRU 3X; 0-80 UNF - 2B THRU 3X; THRU 2X; 0-80 UNF - 2B Z.080 6X; THRU

P.020 6HRU
The countersink angle can be varied.

The value could vary within 11.4±1`

TITLE
Top Platform (Holes)

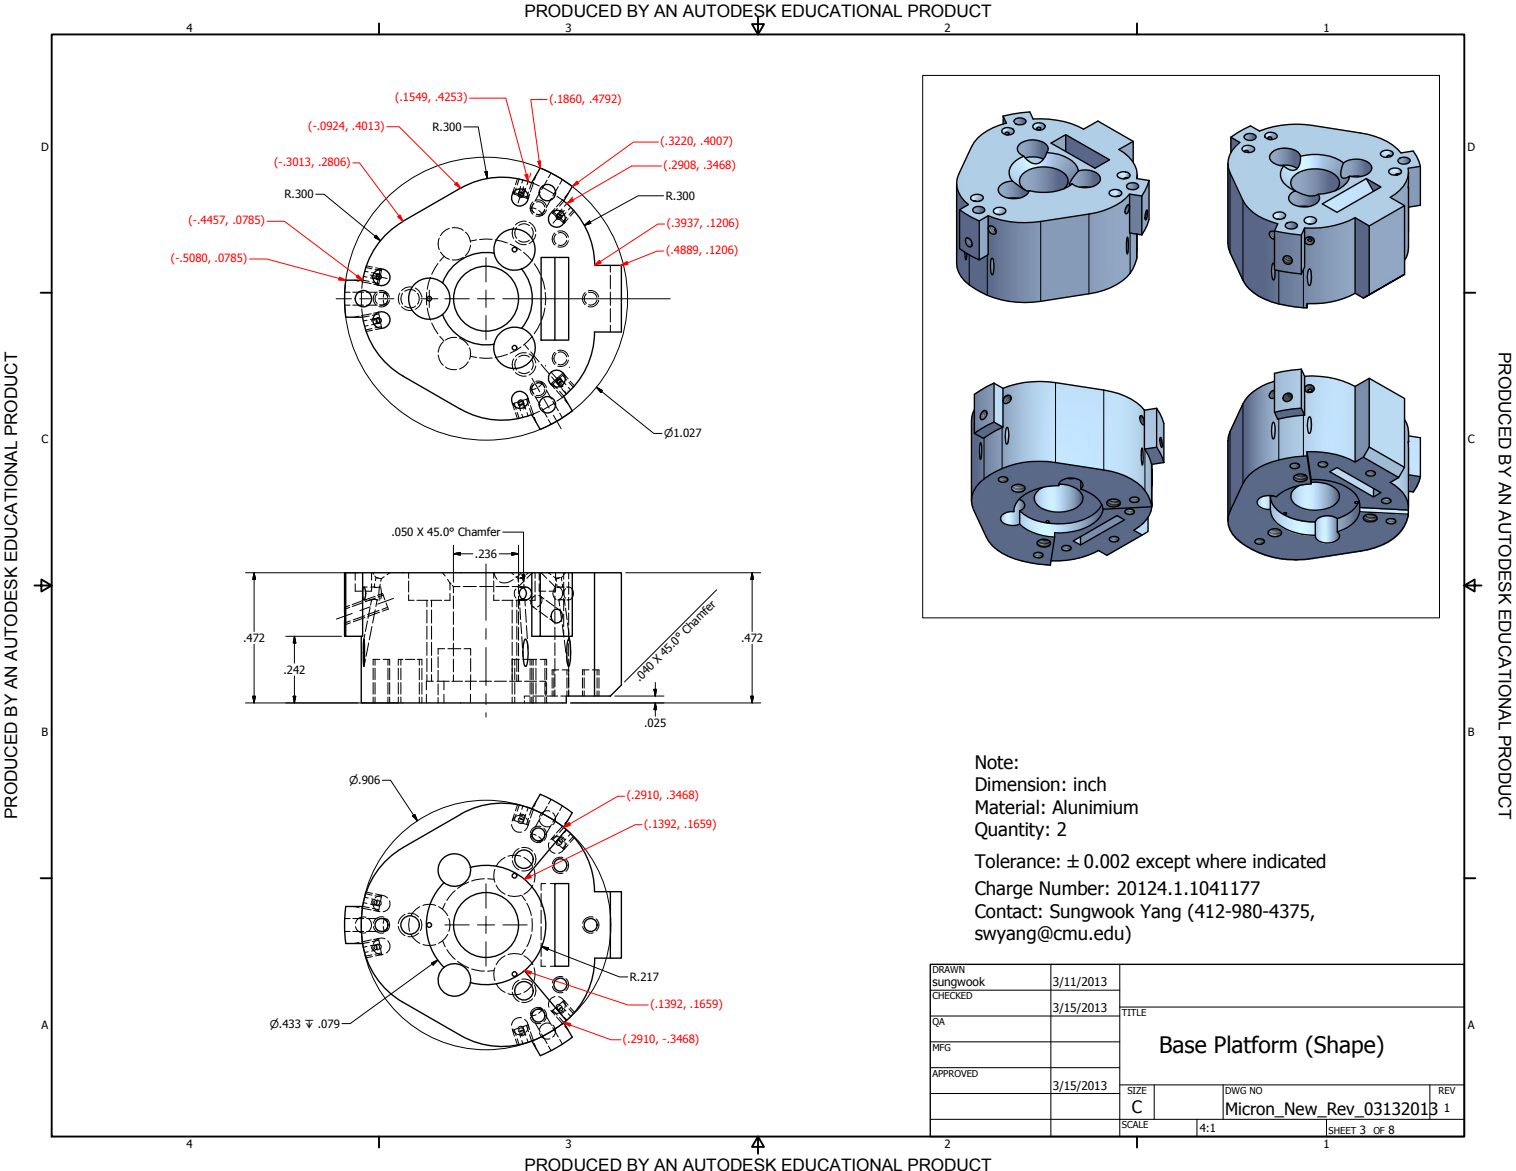
[picture p133: page 3]
TIO; P R O D U C E D B Y A N A U T O D E S K E D U C A TIO; DRAWN; CHECKED; MFG; sungwook; .050 X 45.0° Chamfer; .040 X 45.0° Chamfer

Note:
Dimension: inch
Material: Alunimium
Quantity: 2
Tolerance: B0.002 except where indicated
Charge Number: 20124.1.1041177
Contact: Sungwook Yang (412-980-4375,
swyang@cmu.edu)

TITLE
Base Platform (Shape)

B

## Holes Summary

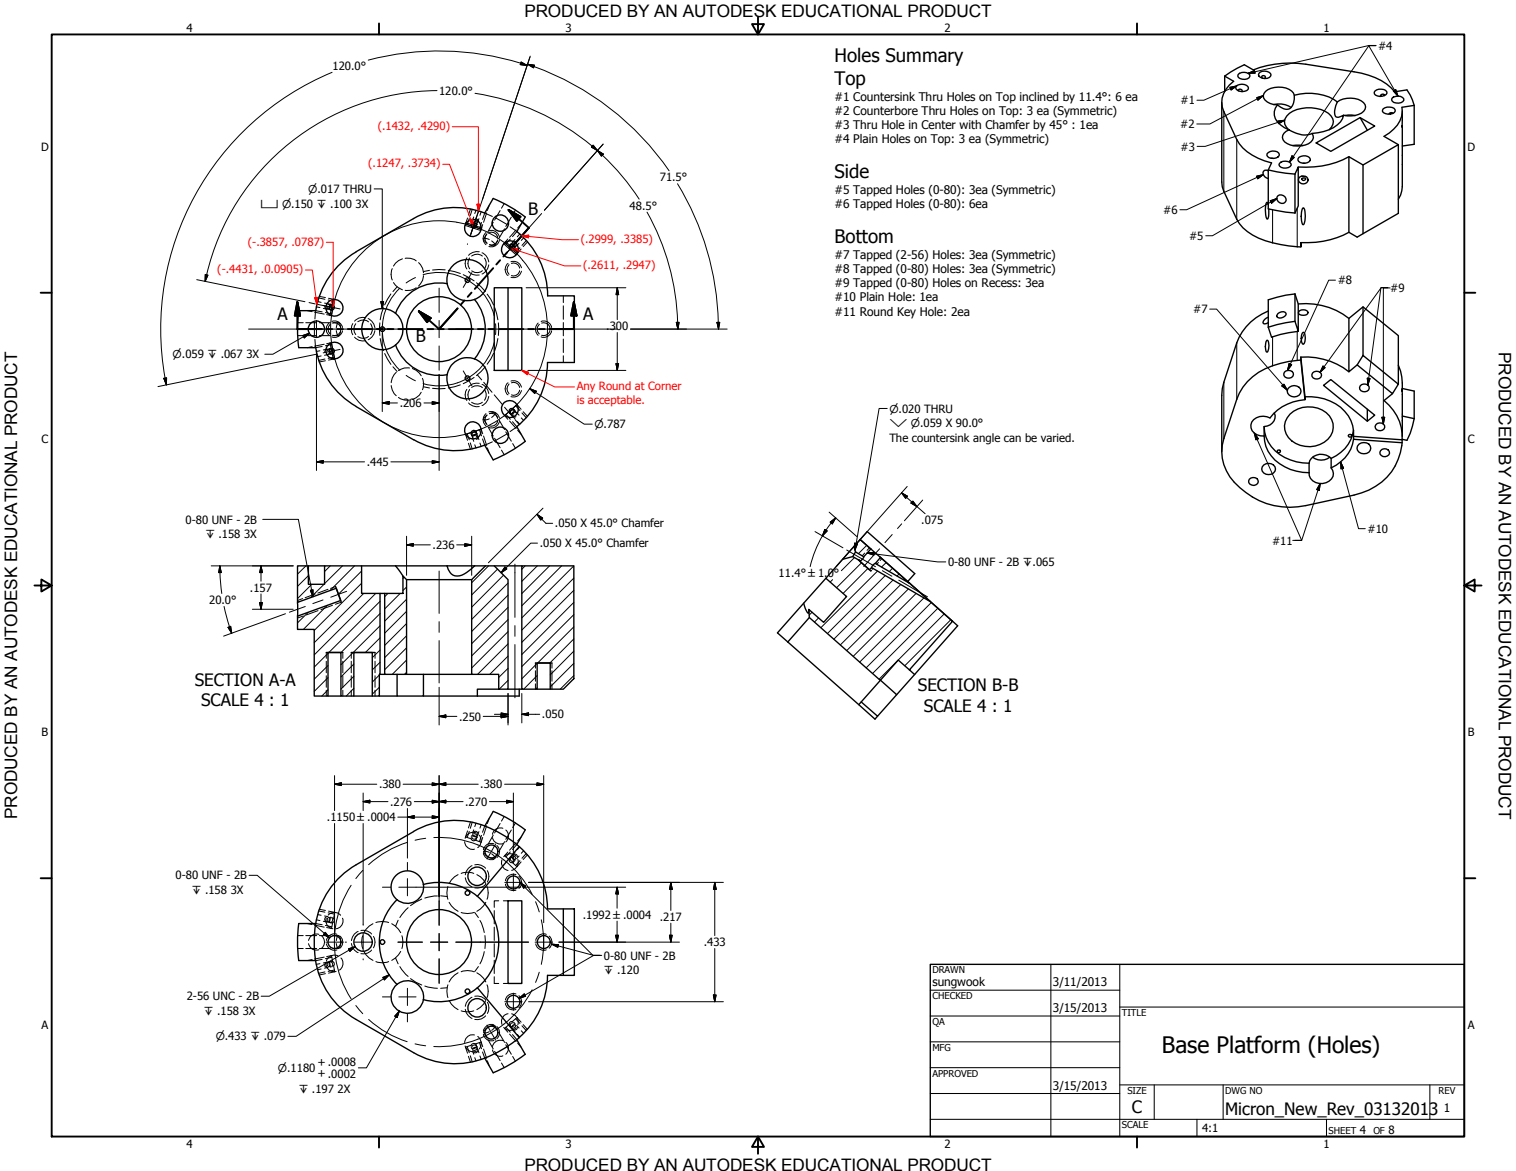
[picture p134: page 4]
SECTION A-A SCALE 4 : 1; SECTION B-B SCALE 4 : 1; TIO; P R O D U C E D B Y A N A U T O D E S K E D U C A TIO; DRAWN; CHECKED; MFG; sungwook; 0-80 UNF - 2B Z .158 3X; .050 X 45.0° Chamfer; P.017 THRU X P.150 Z .100 3X; 2-56 UNC - 2B Z .158 3X; 0-80 UNF - 2B Z .120; 0-80 UNF - 2B Z.065

Top
#1 Countersink Thru Holes on Top inclined by 11.4°: 6 ea
#2 Counterbore Thru Holes on Top: 3 ea (Symmetric)
#3 Thru Hole in Center with Chamfer by 45° : 1ea
#4 Plain Holes on Top: 3 ea (Symmetric)
Side
#5 Tapped Holes (0-80): 3ea (Symmetric)
#6 Tapped Holes (0-80): 6ea
Bottom
#7 Tapped (2-56) Holes: 3ea (Symmetric)
#8 Tapped (0-80) Holes: 3ea (Symmetric)
#9 Tapped (0-80) Holes on Recess: 3ea
#10 Plain Hole: 1ea
#11 Round Key Hole: 2ea

Any Round at Corner
is acceptable.

P.020 THRU
The countersink angle can be varied.

TITLE
Base Platform (Holes)

## Note: Dimension: inch

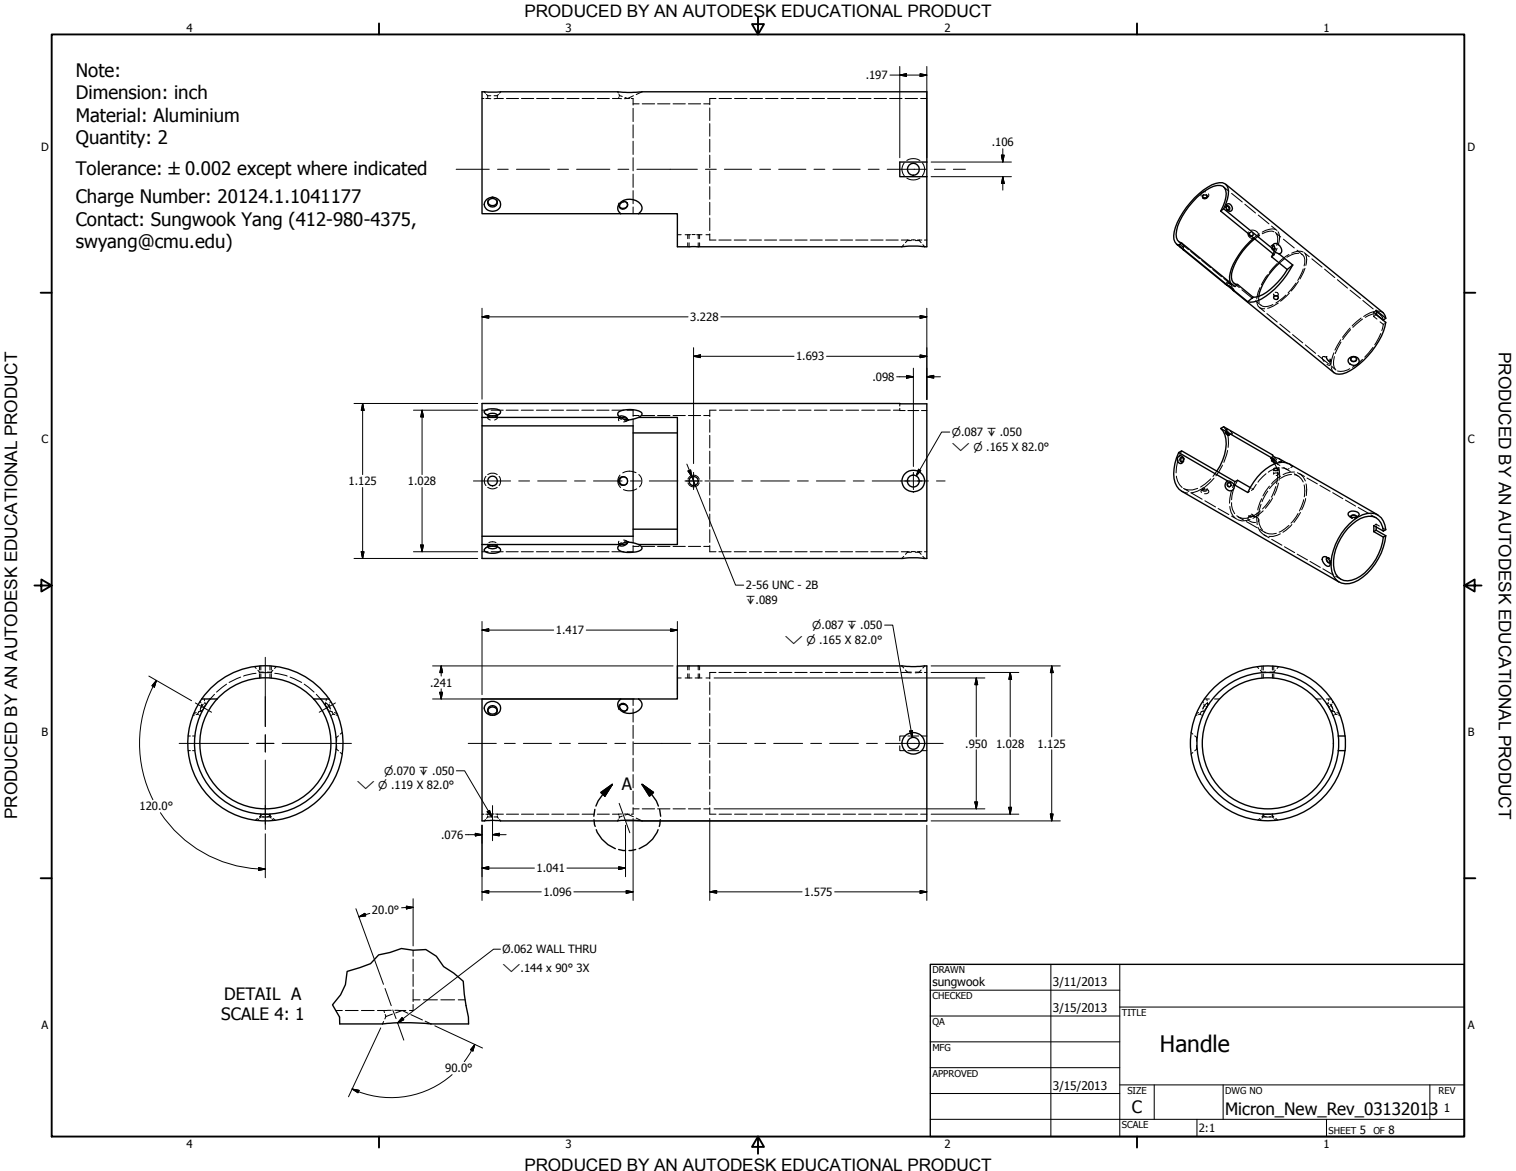
[picture p135: page 5]
DETAIL A SCALE 4: 1; TIO; P R O D U C E D B Y A N A U T O D E S K E D U C A TIO; DRAWN; CHECKED; MFG; sungwook; TITLE; 2-56 UNC - 2B Z.089; Ø.062 WALL THRU Y.144 x 90° 3X; Handle

Material: Aluminium
Quantity: 2
Tolerance: B0.002 except where indicated
Charge Number: 20124.1.1041177
Contact: Sungwook Yang (412-980-4375,
swyang@cmu.edu)

TIO; A U T O D E S K E D U C A TIO; DRAWN sungwook; CHECKED; MFG; APPROVED; TITLE; SIZE A; DWG NO Micron_New_Rev_03132013; REV 1; 0-80 UNF - 2B Z.197 2X; P.070 THRU Y P.119 X 82.0° 3X; THRU 2X; Tool Mount

Note:
Dimension: inch
Material: PET
Quantity: 2
Tolerance: B0.002 except where indicated
Charge Number: 20124.1.1041177
Contact: Sungwook Yang
(412-980-4375, swyang@cmu.edu)

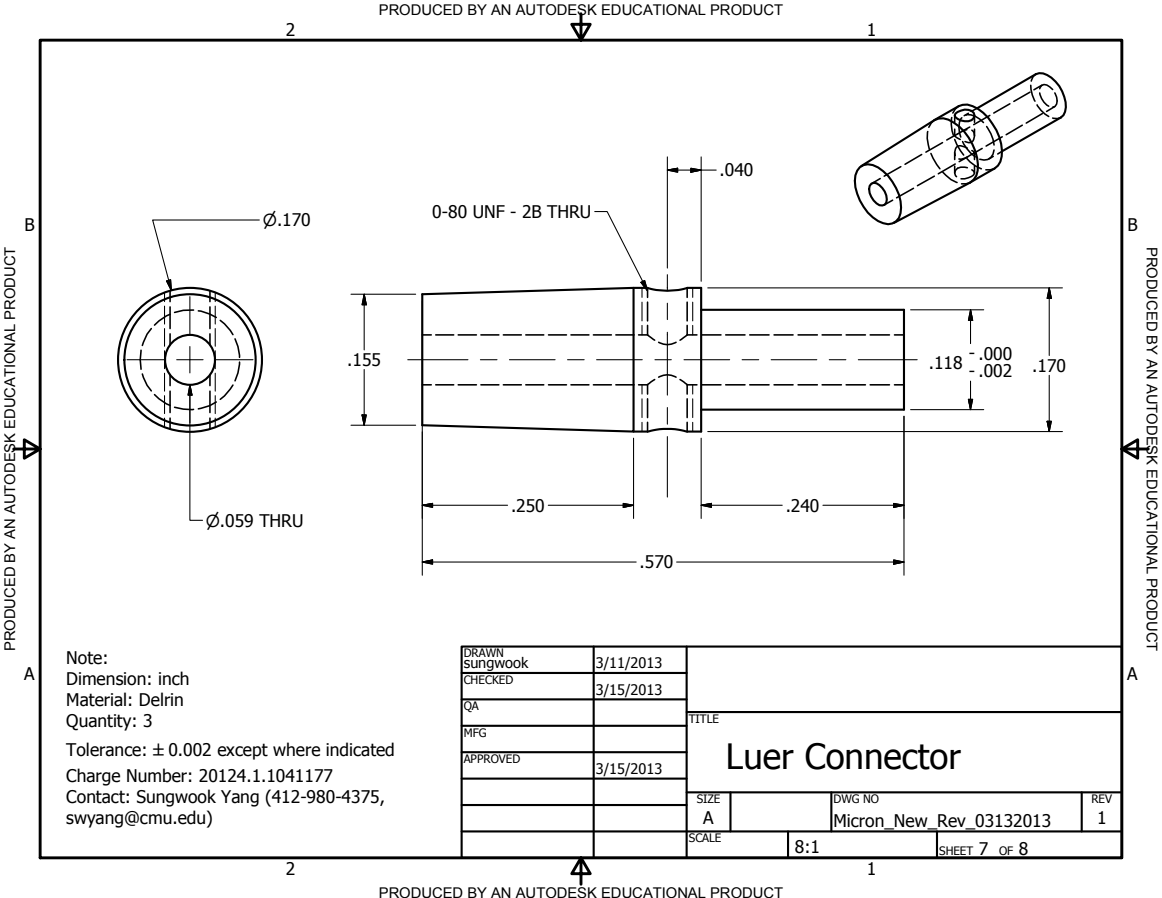
[picture p136: page 7]
TIO; A U T O D E S K E D U C A TIO; DRAWN sungwook; CHECKED; MFG; APPROVED; TITLE; SIZE A; DWG NO Micron_New_Rev_03132013; REV 1; P.059 THRU; Luer Connector; Note:; 0-80 UNF - 2B THRU

Dimension: inch
Material: Delrin
Quantity: 3
Tolerance: B0.002 except where indicated
Charge Number: 20124.1.1041177
Contact: Sungwook Yang (412-980-4375,
swyang@cmu.edu)

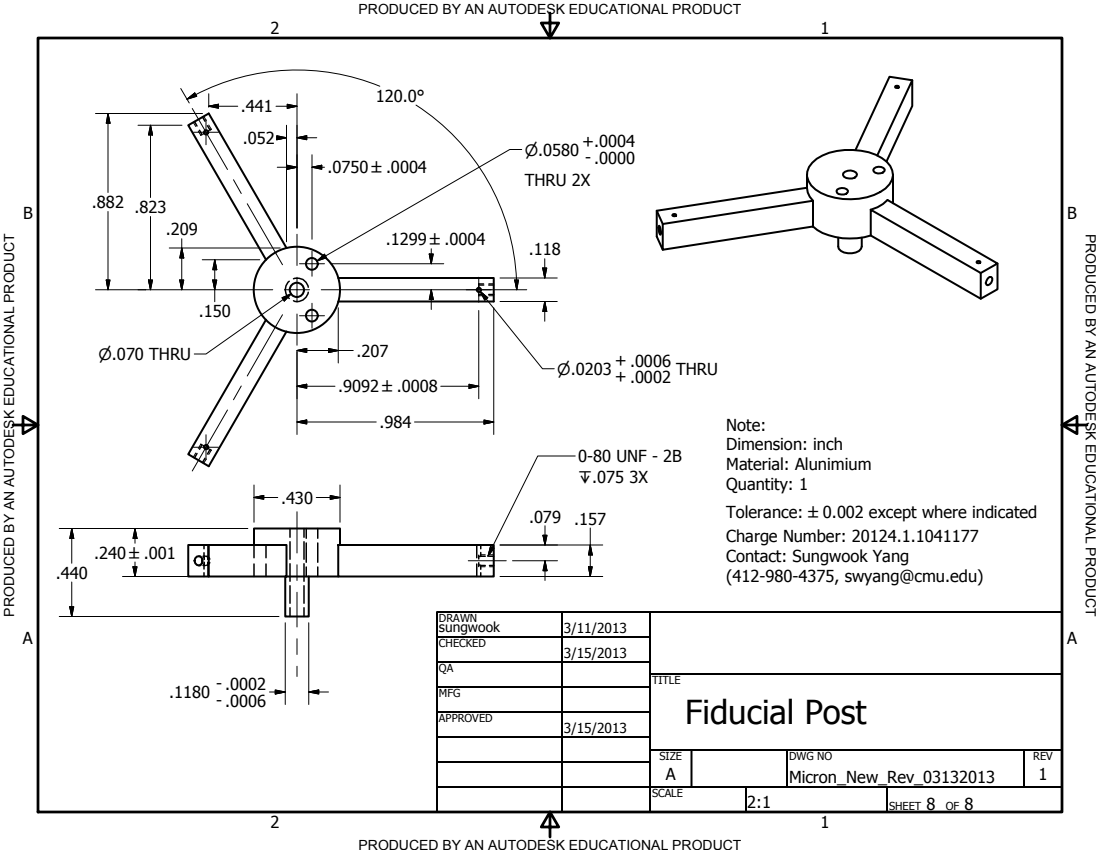
[picture p137: page 8]
TIO; A U T O D E S K E D U C A TIO; DRAWN sungwook; CHECKED; MFG; APPROVED; TITLE; SIZE A; DWG NO Micron_New_Rev_03132013; REV 1; THRU 2X; 0-80 UNF - 2B Z.075 3X; P.070 THRU; Fiducial Post; THRU

Note:
Dimension: inch
Material: Alunimium
Quantity: 1
Tolerance: B0.002 except where indicated
Charge Number: 20124.1.1041177
Contact: Sungwook Yang

(412-980-4375, swyang@cmu.edu)

P

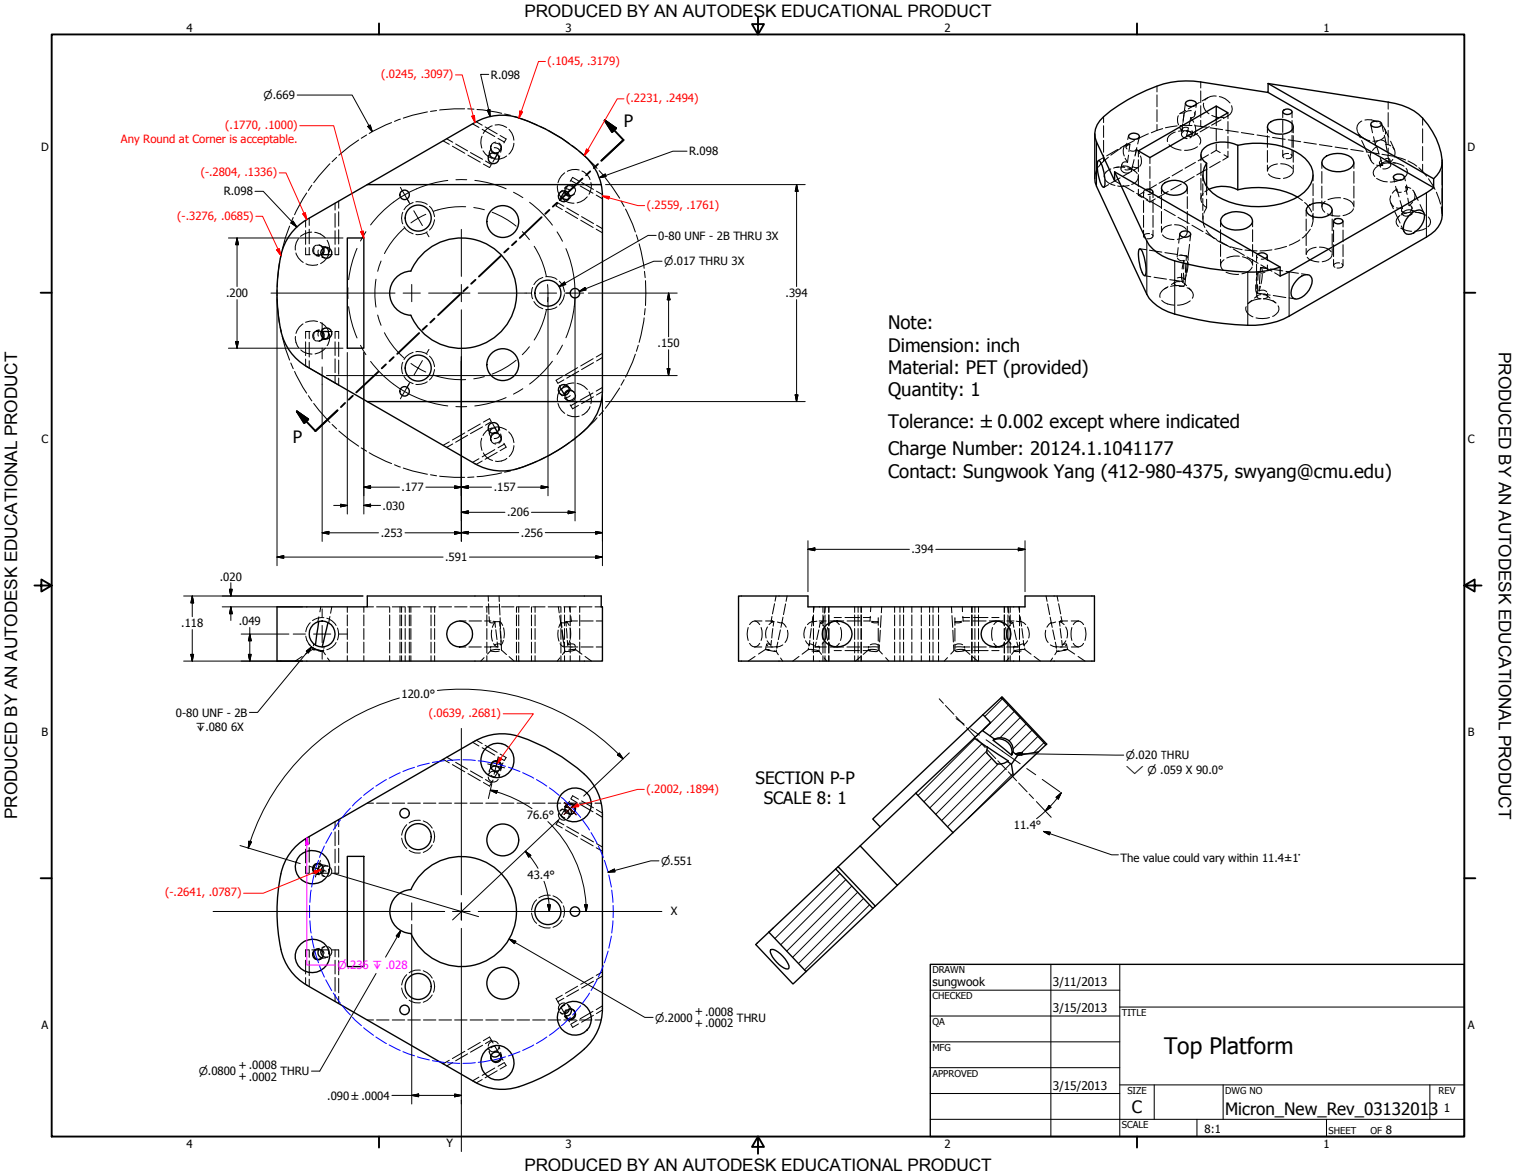
[picture p138: page 9]
SECTION P-P SCALE 8: 1; TIO; P R O D U C E D B Y A N A U T O D E S K E D U C A TIO; SHEET; DRAWN; CHECKED; MFG; sungwook; TITLE; Top Platform; THRU; The value could vary within 11.4±1`; P.017 THRU 3X; 0-80 UNF - 2B THRU 3X; P.020 6HRU Y P .059 X 90.0°; 0-80 UNF - 2B Z.080 6X

Any Round at Corner is acceptable.

Note:
Dimension: inch
Material: PET (provided)
Quantity: 1
Tolerance: B0.002 except where indicated
Charge Number: 20124.1.1041177
Contact: Sungwook Yang (412-980-4375, swyang@cmu.edu)

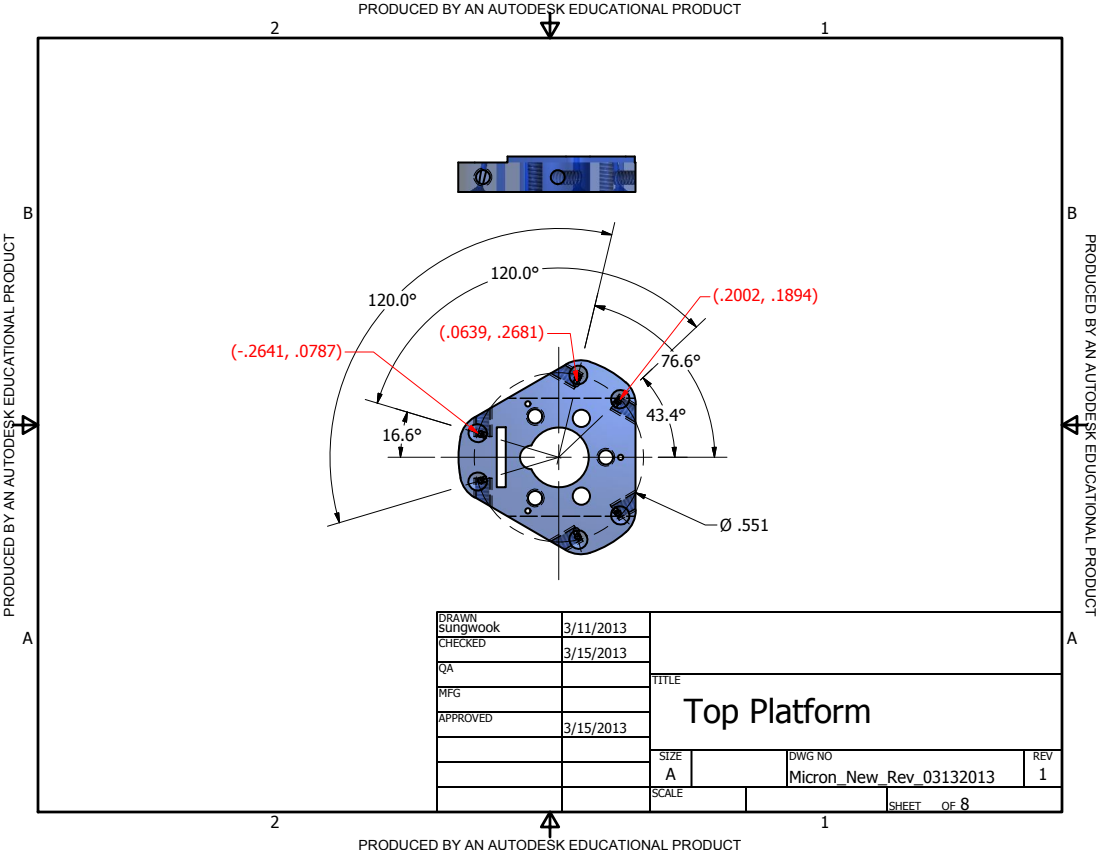
[picture p139: page 10]
TIO; Pla

PRODUCED BY AN AUTODESK EDUCATIONAL PRODUCT

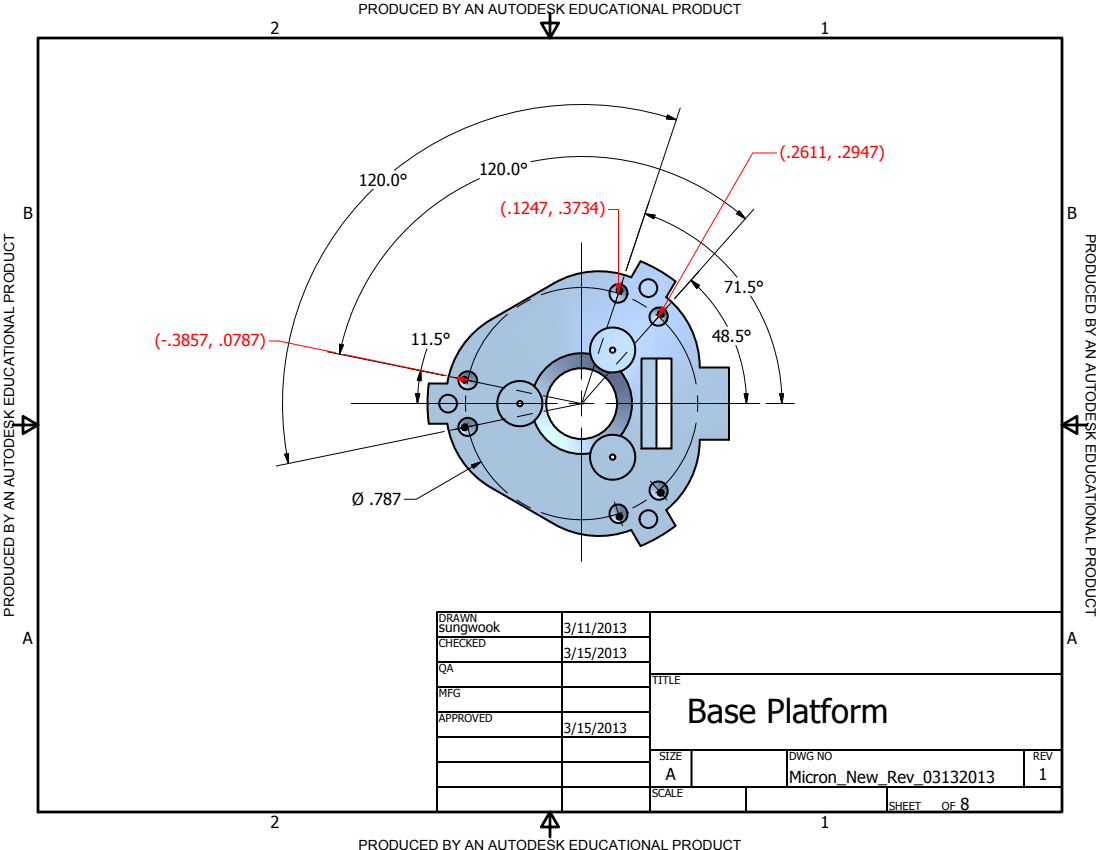
[picture p140: page 11]
TIO; Pla

PRODUCED BY AN AUTODESK EDUCATIONAL PRODUCT

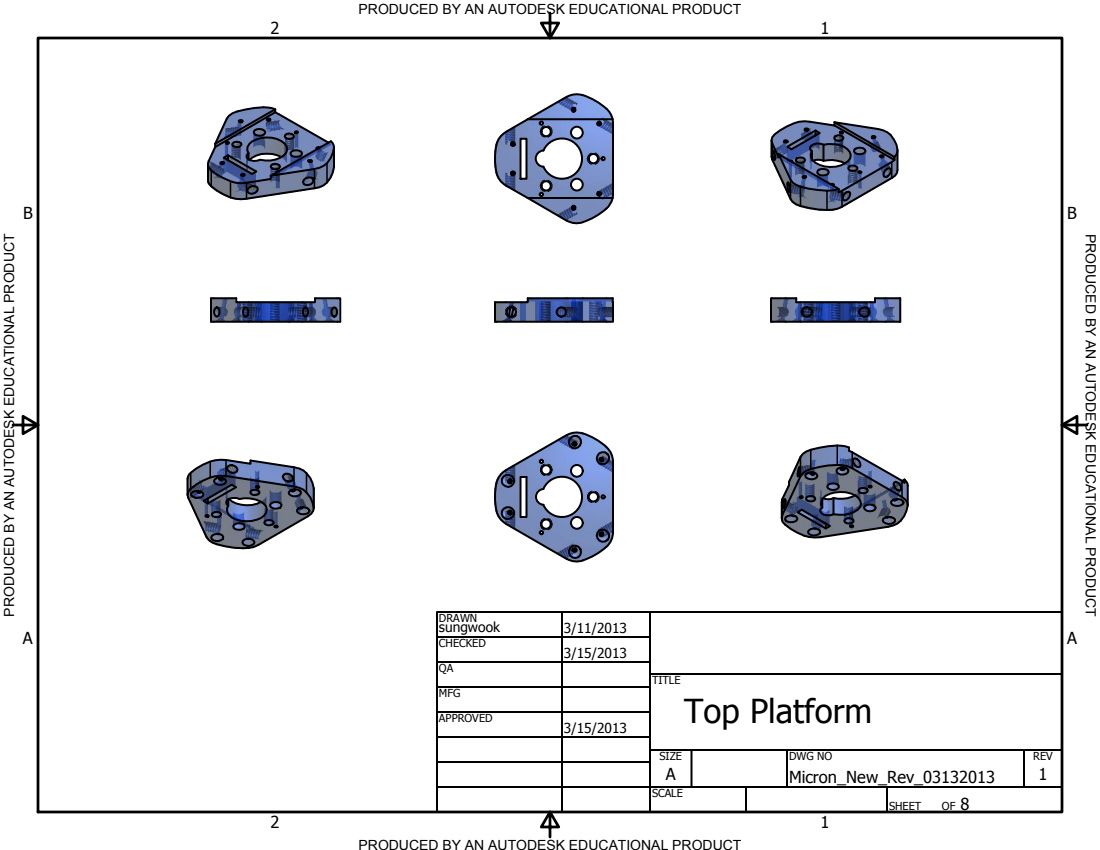
[picture p141: page 12]
TIO; Pla

PRODUCED BY AN AUTODESK EDUCATIONAL PRODUCT

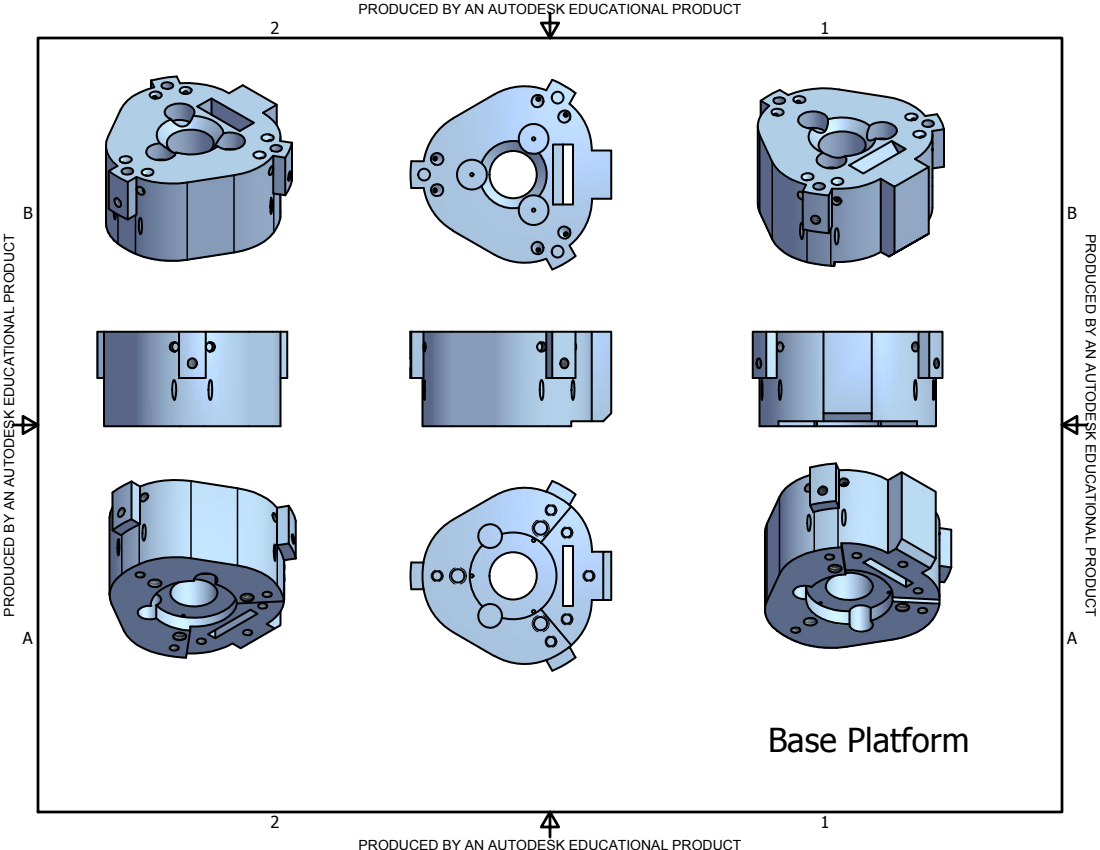
[picture p142: page 13]
TIO; Pla

PRODUCED BY AN AUTODESK EDUCATIONAL PRODUCT
