robmacl/micron_maxon/drawings/Inventor_Design/Micron22_top_adj_02082013_Inventor2013/Drawings/Micron_New_Rev_Base3.pdf

C

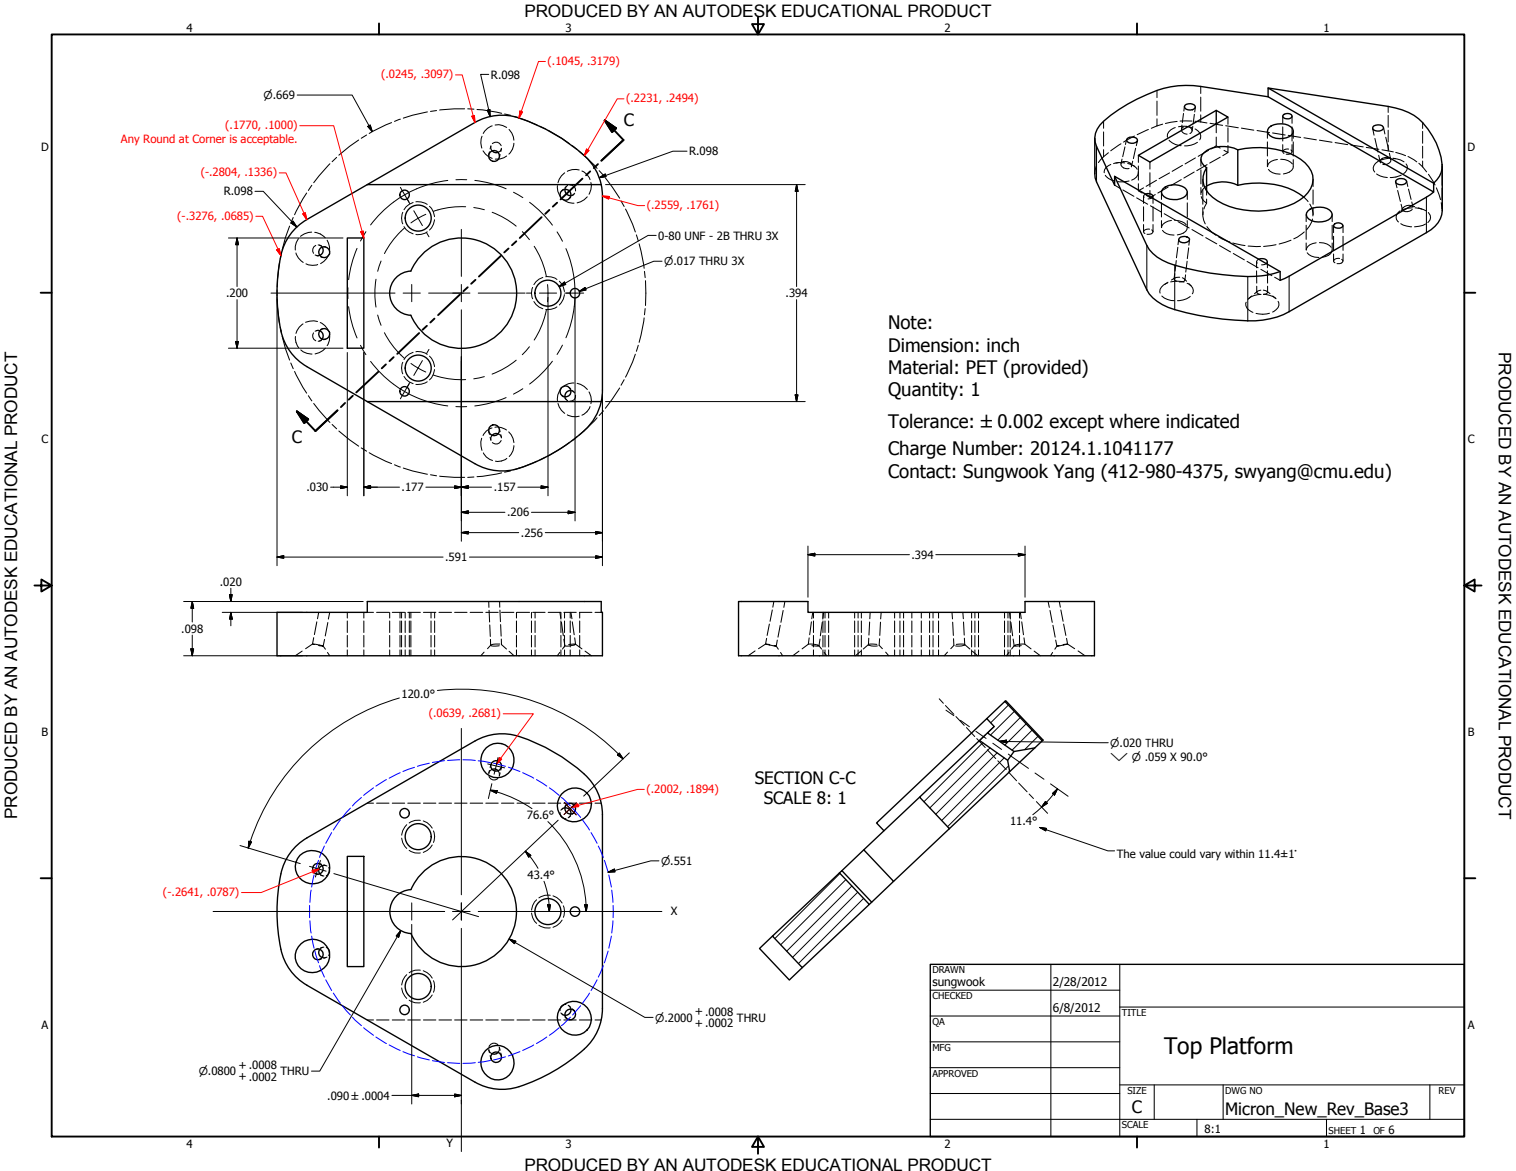
[picture p143: page 1]
SECTION C-C SCALE 8: 1; TIO; P R O D U C E D B Y A N A U T O D E S K E D U C A TIO; SHEET 1 OF 6; DRAWN; CHECKED; MFG; APPROVED; sungwook; DWG NO Micron_New_Rev_Base3; TITLE; SIZE C; SCALE; REV; Top Platform; THRU; P.017 THRU 3X; 0-80 UNF - 2B THRU 3X; P.020 6HRU Y P .059 X 90.0°

Any Round at Corner is acceptable.

Note:
Dimension: inch
Material: PET (provided)
Quantity: 1
Tolerance: B0.002 except where indicated
Charge Number: 20124.1.1041177
Contact: Sungwook Yang (412-980-4375, swyang@cmu.edu)

The value could vary within 11.4±1`

PRODUCED BY AN AUTODESK EDUCATIONAL PRODUCT

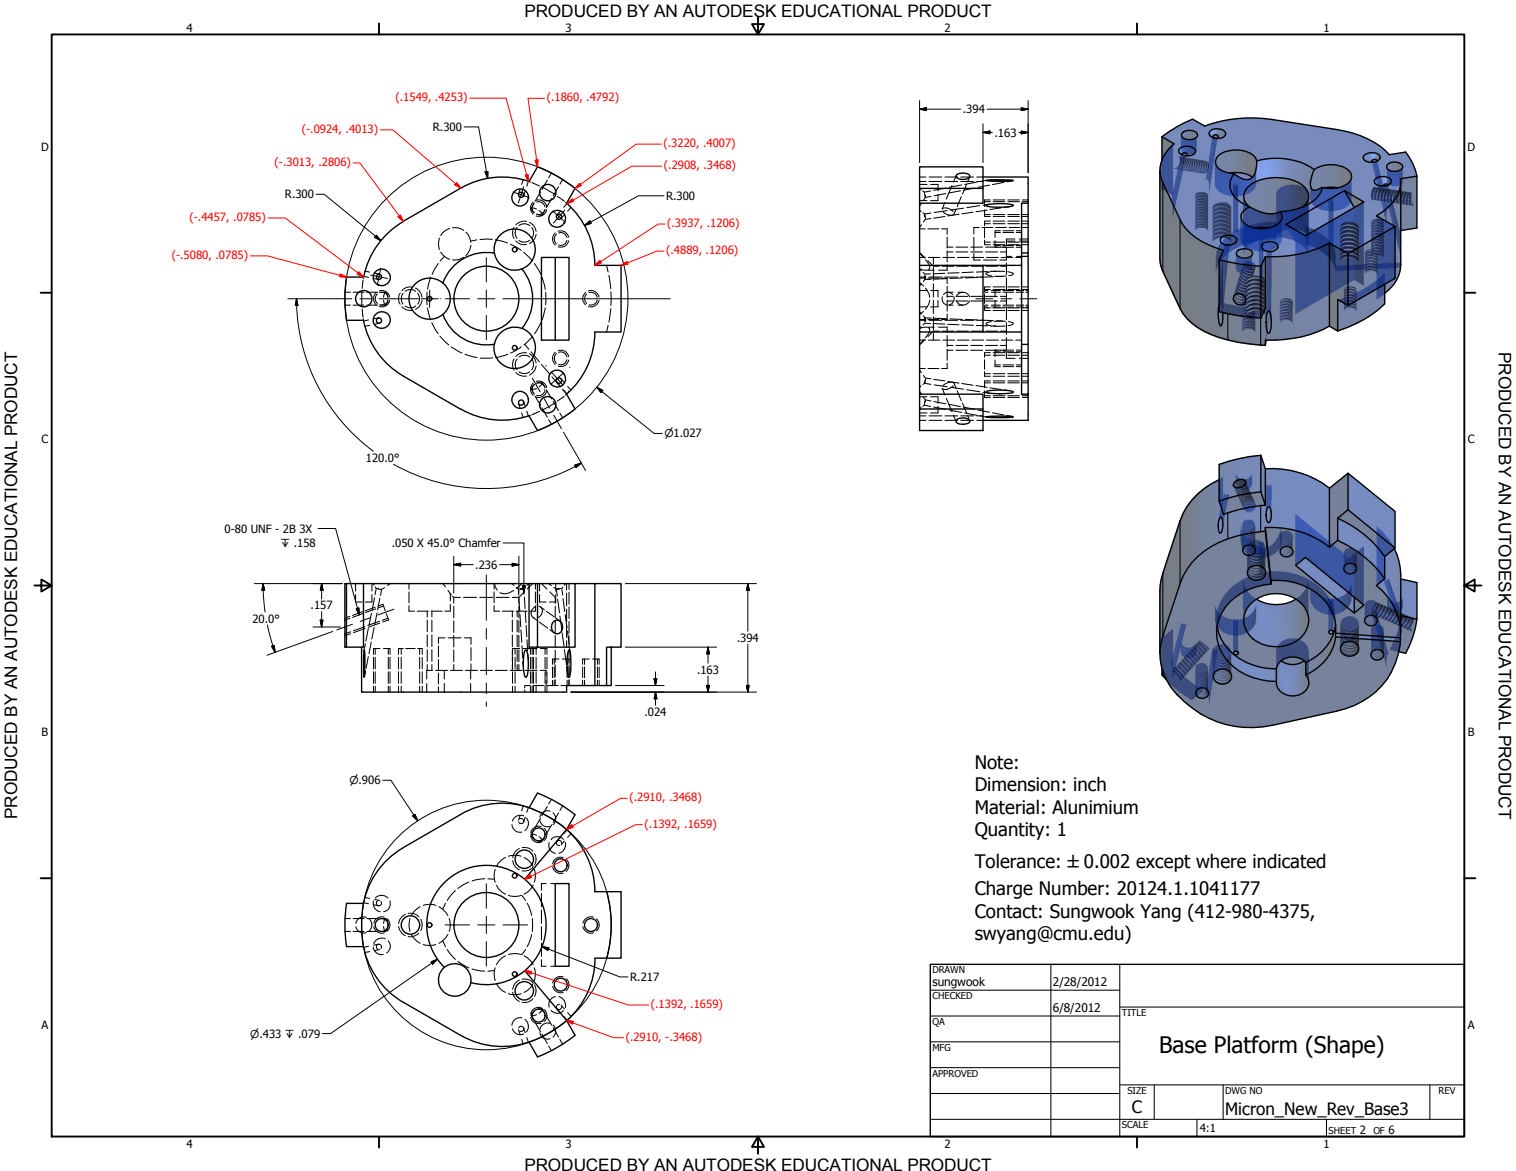
[picture p144: page 2]
TIO; P R O D U C E D B Y A N A U T O D E S K E D U C A TIO; DRAWN; CHECKED; MFG; sungwook; 0-80 UNF - 2B 3X Z .158; .050 X 45.0° Chamfer

Note:
Dimension: inch
Material: Alunimium
Quantity: 1
Tolerance: B0.002 except where indicated
Charge Number: 20124.1.1041177
Contact: Sungwook Yang (412-980-4375,
swyang@cmu.edu)

TITLE
Base Platform (Shape)

A | A
B

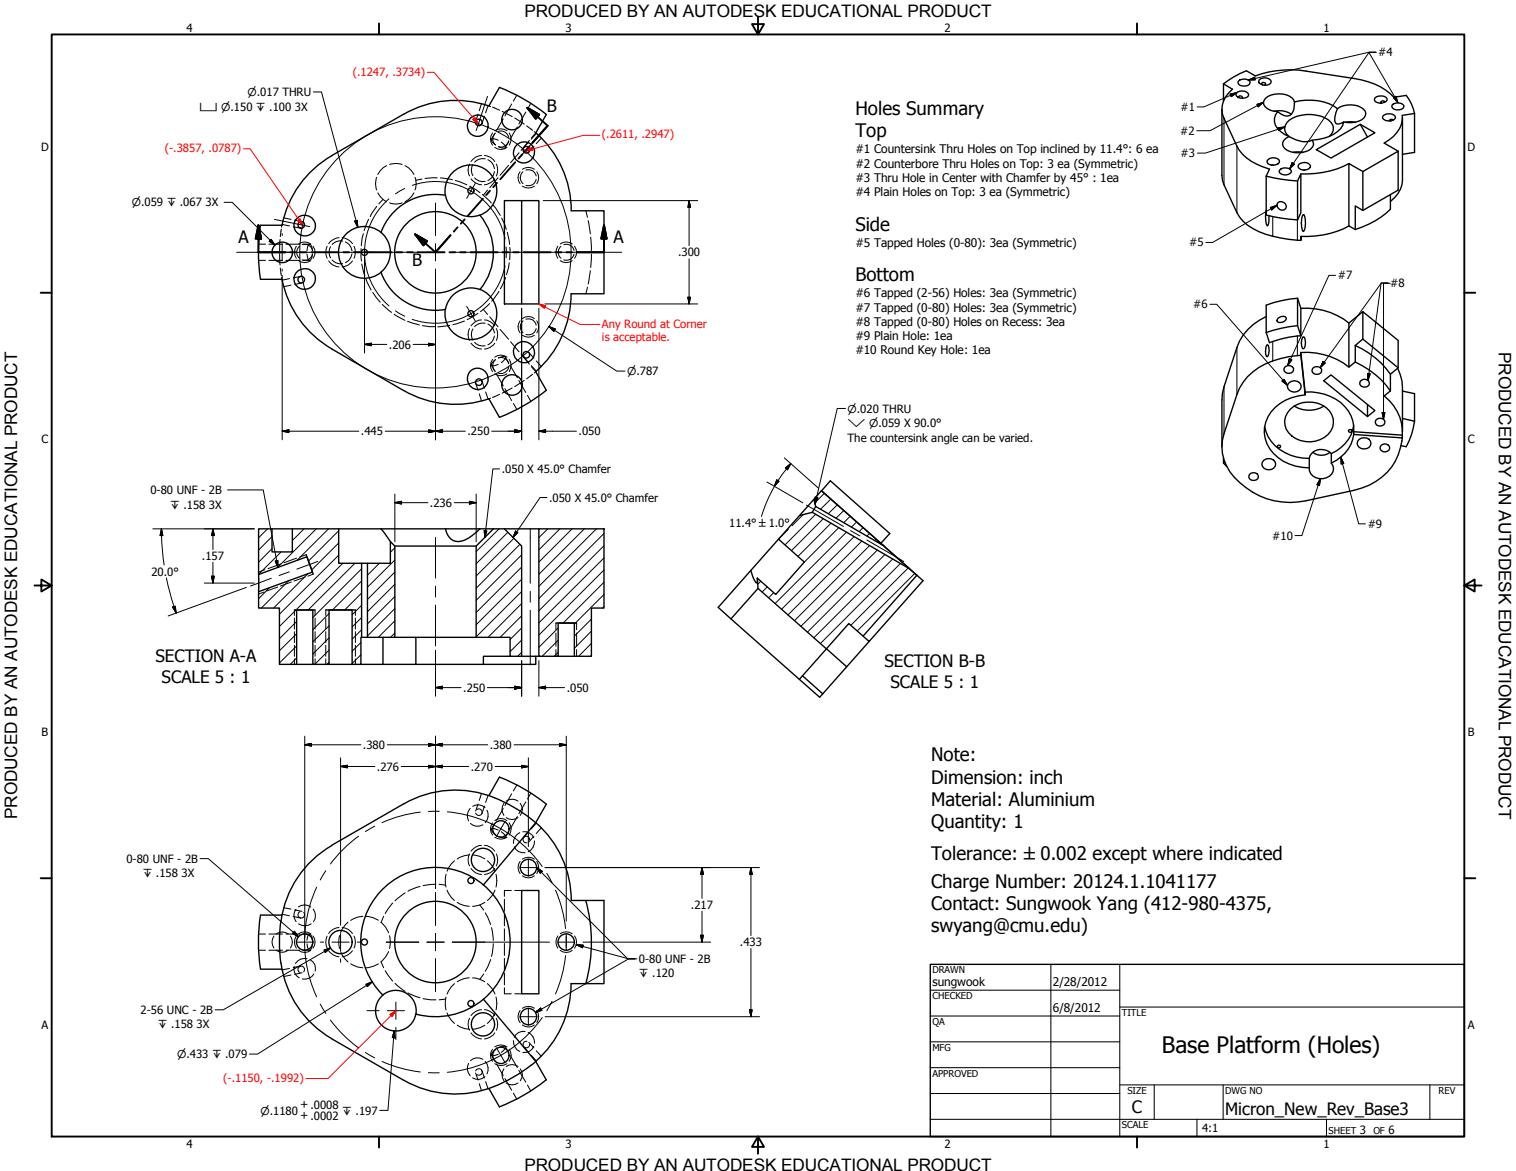
[picture p145: page 3]
SECTION A-A SCALE 5 : 1; SECTION B-B SCALE 5 : 1; TIO; P R O D U C E D B Y A N A U T O D E S K E D U C A TIO; DRAWN; CHECKED; MFG; sungwook; 0-80 UNF - 2B Z .158 3X; .050 X 45.0° Chamfer; P.017 THRU X P.150 Z .100 3X; 2-56 UNC - 2B Z .158 3X; 0-80 UNF - 2B Z .120

Holes Summary
Top
#1 Countersink Thru Holes on Top inclined by 11.4°: 6 ea
#2 Counterbore Thru Holes on Top: 3 ea (Symmetric)
#3 Thru Hole in Center with Chamfer by 45° : 1ea
#4 Plain Holes on Top: 3 ea (Symmetric)
Side
#5 Tapped Holes (0-80): 3ea (Symmetric)
Bottom
#6 Tapped (2-56) Holes: 3ea (Symmetric)
#7 Tapped (0-80) Holes: 3ea (Symmetric)
#8 Tapped (0-80) Holes on Recess: 3ea
#9 Plain Hole: 1ea
#10 Round Key Hole: 1ea

Any Round at Corner
is acceptable.

P.020 THRU
The countersink angle can be varied.

Note:
Dimension: inch
Material: Aluminium
Quantity: 1
Tolerance: B0.002 except where indicated
Charge Number: 20124.1.1041177
Contact: Sungwook Yang (412-980-4375,
swyang@cmu.edu)

TITLE
Base Platform (Holes)

## Note: Dimension: inch

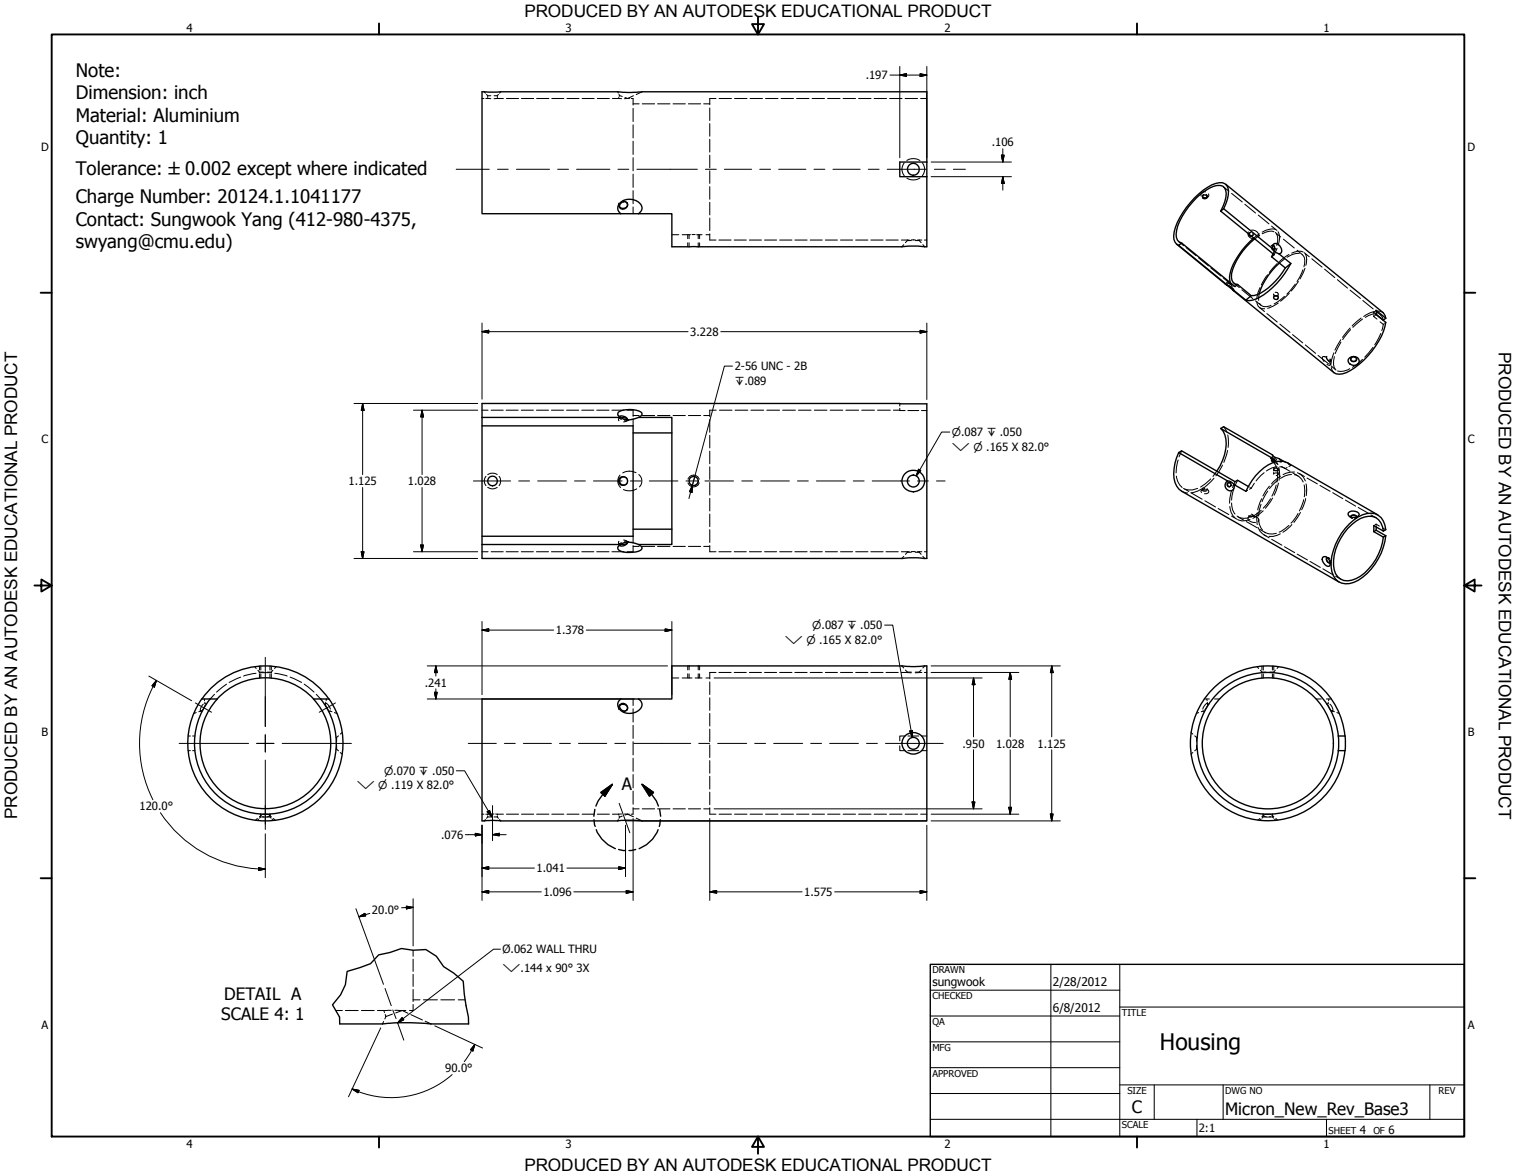
[picture p146: page 4]
DETAIL A SCALE 4: 1; TIO; P R O D U C E D B Y A N A U T O D E S K E D U C A TIO; DRAWN; CHECKED; MFG; sungwook; TITLE; 2-56 UNC - 2B Z.089; Ø.062 WALL THRU Y.144 x 90° 3X; Housing

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
