robmacl/micron_maxon/drawings/Inventor_Design/Micron22_top_adj_02082013_Inventor2013/Assembly/OCT/DWG_Micron_OCT_Integration.pdf

A | A

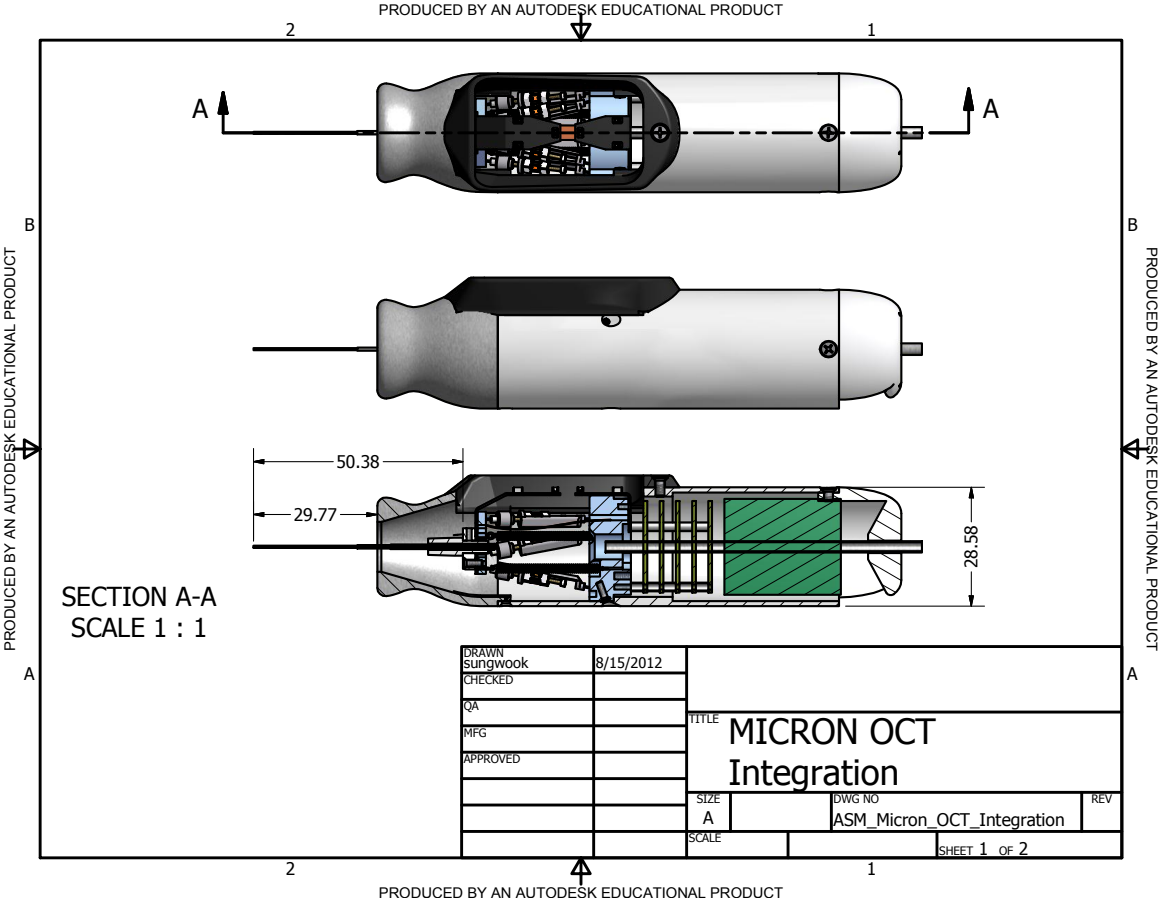
[picture p149: page 1]
SECTION A-A SCALE 1 : 1; TIO; A U T O D E S K E D U C A TIO; DRAWN sungwook; CHECKED; MFG; APPROVED; TITLE; SIZE A; SCALE; DWG NO ASM_Micron_OCT_Integration; REV; SHEET 1 OF 2; MICRON OCT Integration

PRODUCED BY AN AUTODESK EDUCATIONAL PRODUCT

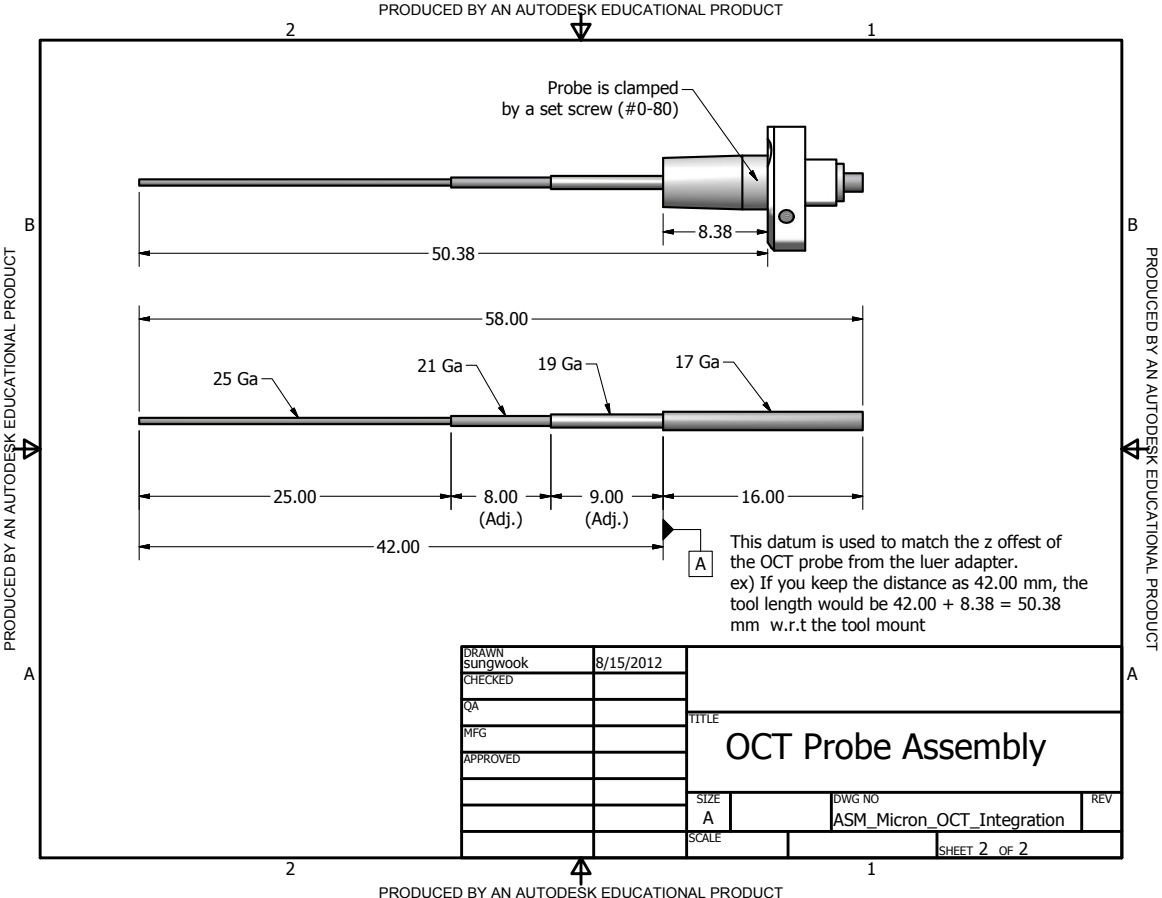
[picture p150: page 2]
TIO; A U T O D E S K E D U C A TIO; DRAWN sungwook; CHECKED; MFG; APPROVED; SIZE A; SCALE; DWG NO ASM_Micron_OCT_Integration; REV; SHEET 2 OF 2; (Adj.); 9.00 (Adj.)

PRODUCED BY AN AUTODESK EDUCATIONAL PRODUCT

Probe is clamped
by a set screw (#0-80)

This datum is used to match the z offest of
the OCT probe from the luer adapter.
ex) If you keep the distance as 42.00 mm, the
tool length would be 42.00 + 8.38 = 50.38
mm w.r.t the tool mount

TITLE
OCT Probe Assembly
