robmacl/micron_maxon/drawings/Inventor_Design/Micron22_top_adj_02082013_Inventor2013/Parts/Tool/Luer_Adapter_ForceSensor.pdf

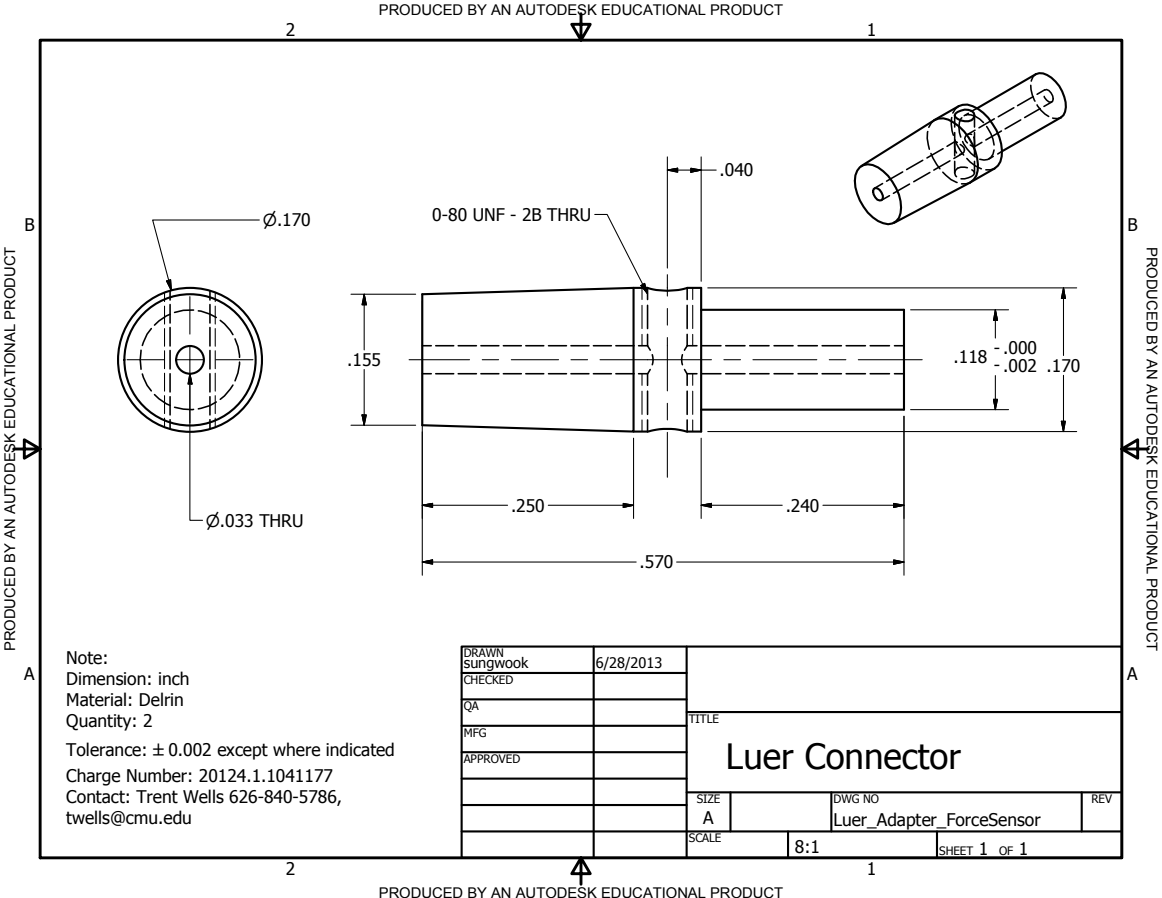
[picture p151: page 1]
TIO; A U T O D E S K E D U C A TIO; DRAWN sungwook; CHECKED; MFG; APPROVED; TITLE; SIZE A; SCALE; DWG NO Luer_Adapter_ForceSensor; REV; SHEET 1 OF 1; P.033 THRU; Luer Connector; Note:; 0-80 UNF - 2B THRU

PRODUCED BY AN AUTODESK EDUCATIONAL PRODUCT

Dimension: inch
Material: Delrin
Quantity: 2
Tolerance: B0.002 except where indicated
Charge Number: 20124.1.1041177
Contact: Trent Wells 626-840-5786,
twells@cmu.edu
