robmacl/micron_maxon/cad/micron_6dof/fpga_breakout.pdf

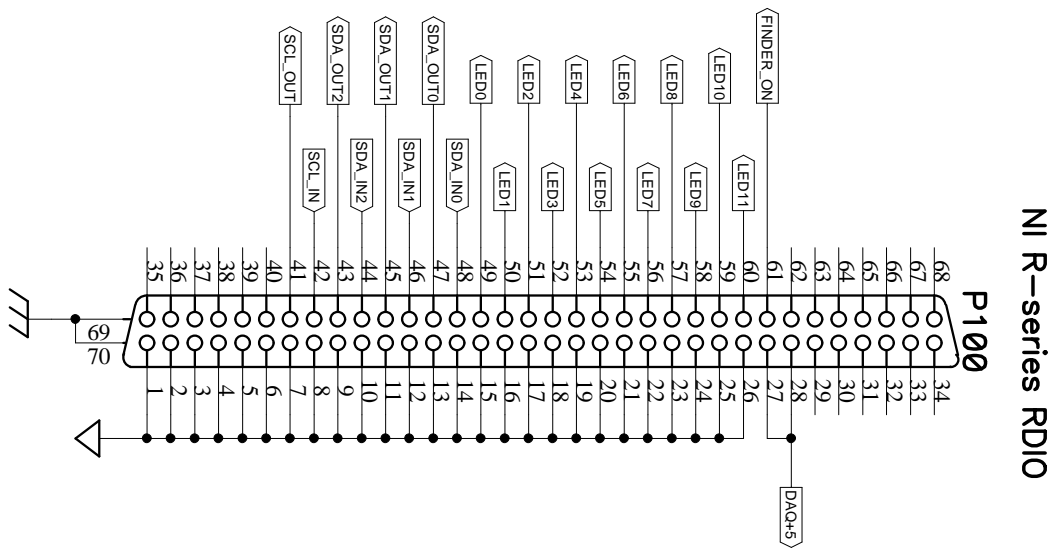
[picture p164: page 1]

Micron FPGA breakout: FPGA board connectors

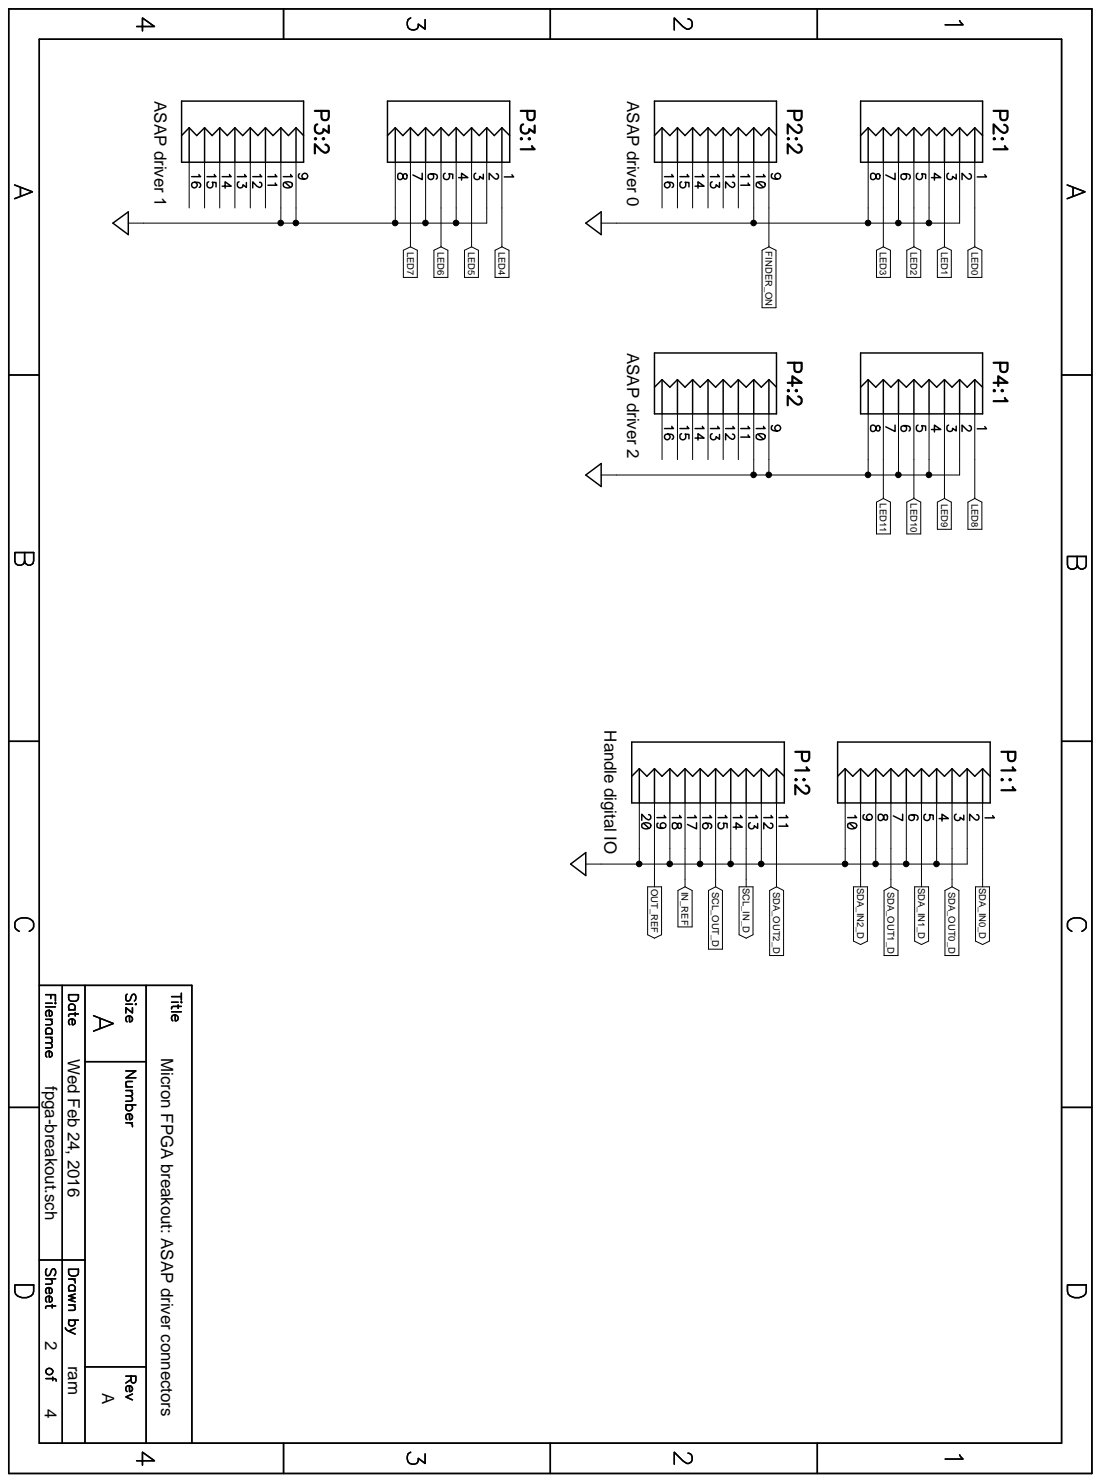
[picture p165: page 2]

ASAP driver 0 ASAP driver 2

Micron FPGA breakout: ASAP driver connectors

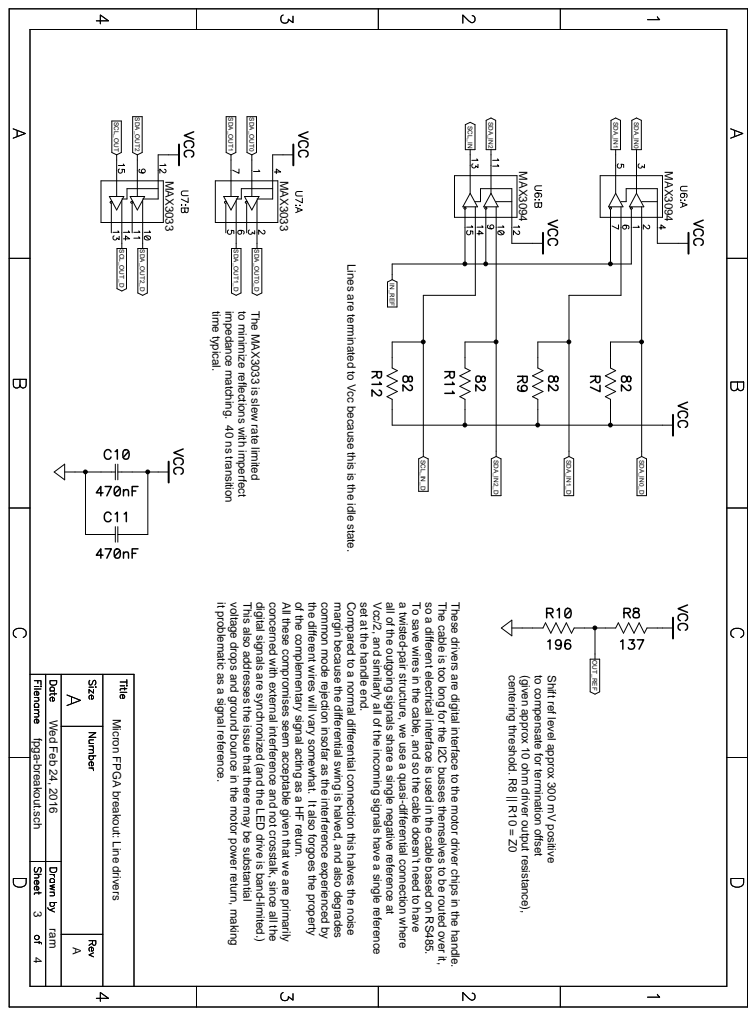
[picture p166: page 3]
IN_REF; SDA_OUT2; SDA_OUT1; SDA_OUT0; SCL_OUT SCL_OUT_D; SDA_OUT2_D; SDA_OUT1_D; SDA_OUT0_D; time typical.; MAX3033; SCL_IN_D; SDA_IN2_D; SDA_IN1_D; SDA_IN0_D; SDA_IN2; SDA_IN1; SDA_IN0; SCL_IN; MAX3094; OUT_REF; centering threshold. R8 || R10 = Z0; are primarily; Wed Feb 24, 2016; ram

Lines are terminated to Vcc because this is the idle state.

impedance matching. 40 ns transition

to minimize reflections with imperfect

The MAX3033 is slew rate limited

it problematic as a signal reference.

voltage drops and ground bounce in the motor power return, making

This also addresses the issue that there may be substantial

digital signals are synchronized (and the LED drive is band-limited.)

concerned with external interference and not crosstalk, since all the

All these compromises seem acceptable given that we

of the complementary signal acting as a HF return.

the different wires will vary somewhat. It also forgoes the property

common mode rejection insofar as the interference experienced by

margin because the differential swing is halved, and also degrades

Compared to a normal differential connection this h

set at the handle end.

Vcc/2, and similarly all of the incoming signals have a single reference

all of the outgoing signals share a single negative reference at

a twisted-pair structure, we use a quasi-differential connection where

To save wires in the cable, and so the cable doesn't need to have

so a different electrical interface is used in the cable based on RS485.

The cable is too long for the I2C busses themselves to be routed over it,

These drivers are digital interface to the motor driver chips in the handle.

(given approx 10 ohm driver output resistance),

to compensate for termination offset

Shift ref level approx 300 mV positive

Micron FPGA breakout: Line drivers

4 3 fpga-breakout.sch

alves the noise

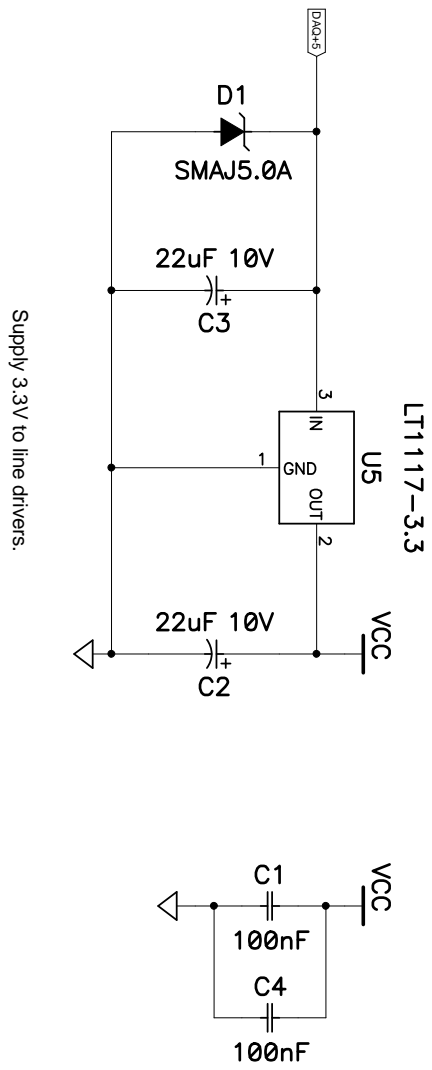
[picture p167: page 4]
DAQ+5

Supply 3.3V to line drivers.
