robmacl/micron_maxon/cad/micron_6dof/handle.pdf

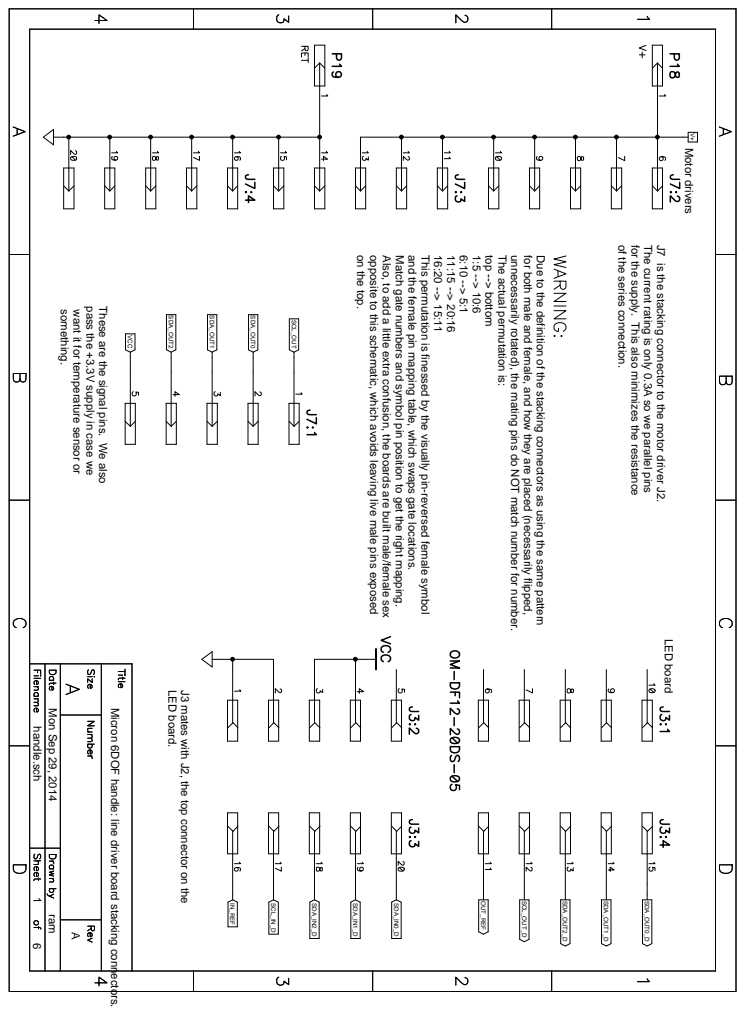
[picture p168: page 1]
IN_REF; SCL_IN_D; SDA_IN2_D; SDA_IN1_D; SDA_IN0_D; LED board; OUT_REF; SCL_OUT_D; SDA_OUT2_D; SDA_OUT1_D; SDA_OUT0_D; LED board.; Motor drivers; something.; VCC; SDA_OUT2; SDA_OUT1; SCL_OUT; SDA_OUT0; top --> bottom; ale symbol; ram; Mon Sep 29, 2014; handle.sch 1 6

on the top.

opposite to this schematic, which avoids leaving live male pins exposed

Also, to add a little extra confusion, the boards are built male/female sex

Match gate numbers and symbol pin position to get the right mapping.

and the female pin mapping table, which swaps gate locations.

This permutation is finessed by the visually pin-reversed fem

The actual permutation is:

unnecessarily rotated), the mating pins do NOT match number for number.

for both male and female, and how they are placed (necessarily flipped,

Due to the definition of the stacking connectors as using the same pattern

of the series connection.

for the supply. This also minimizes the resistance

The current rating is only 0.3A so we parallel pins

J7 is the stacking connector to the motor driver J2.

want it for temperature sensor or

pass the +3.3V supply in case we

These are the signal pins. We also

J3 mates with J2, the top connector on the

Micron 6DOF handle: line driver board stacking connectors.

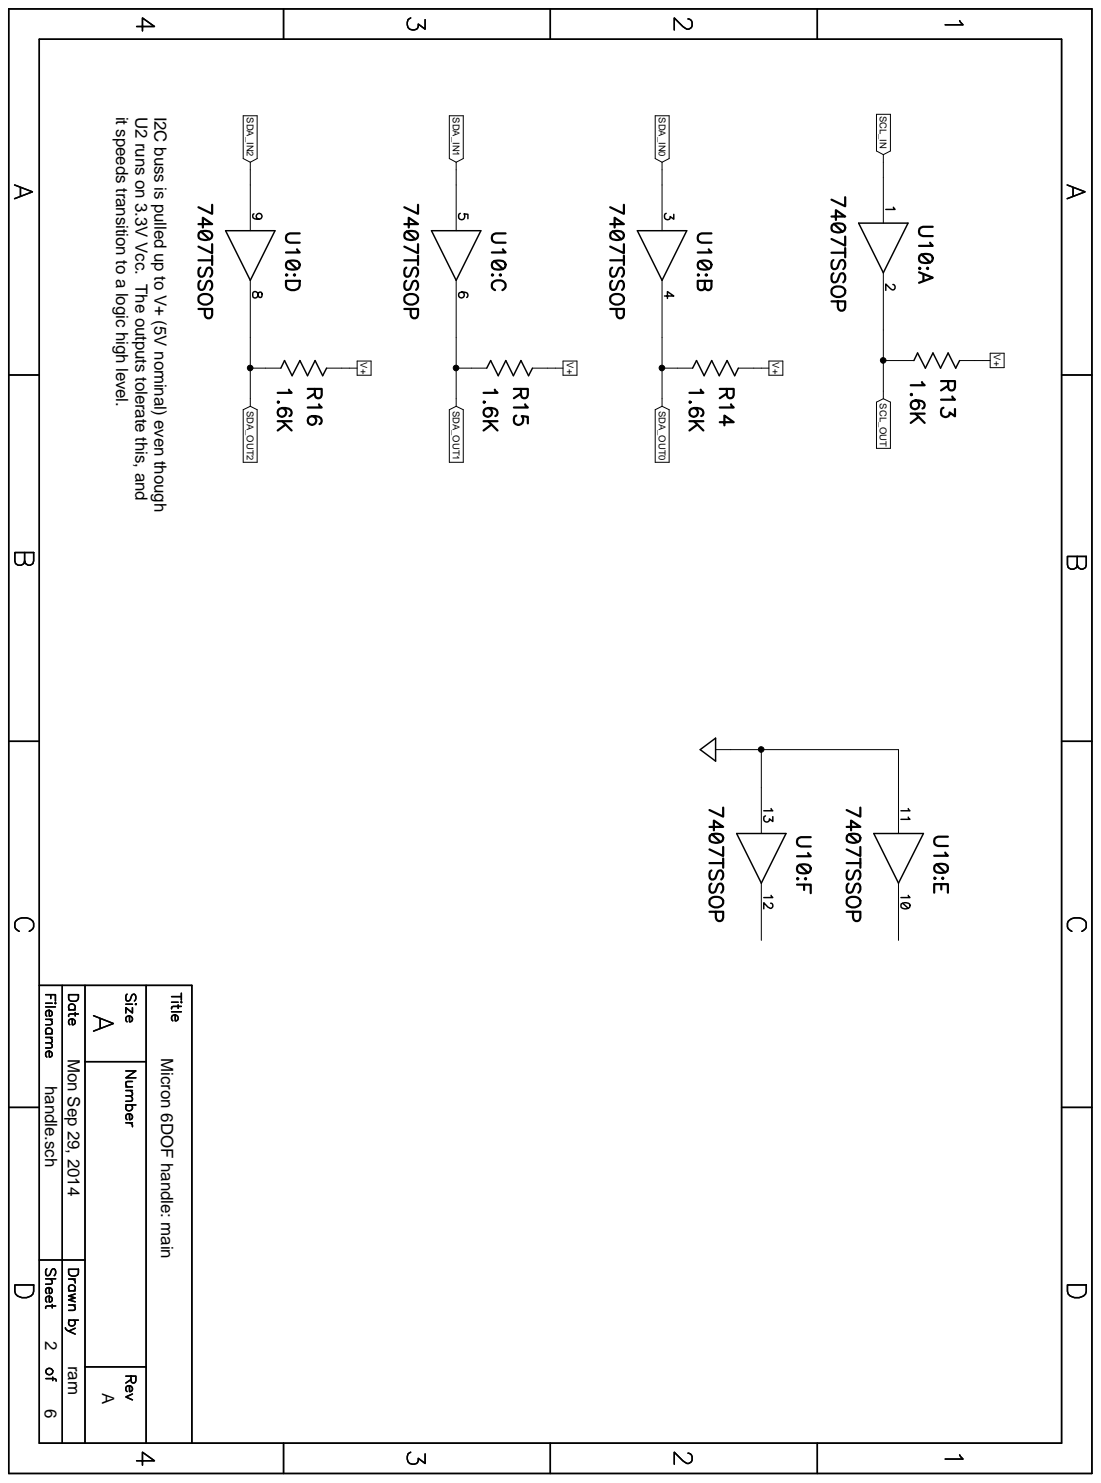
[picture p169: page 2]
SCL_OUT; SDA_OUT0; SDA_OUT1; SDA_OUT2; SDA_IN2; SDA_IN1; SDA_IN0; SCL_IN; 6 2 handle.sch; Mon Sep 29, 2014; ram

it speeds transition to a logic high level.

U2 runs on 3.3V Vcc. The outputs tolerate this, and

I2C buss is pulled up to V+ (5V nominal) even thoug

Micron 6DOF handle: main

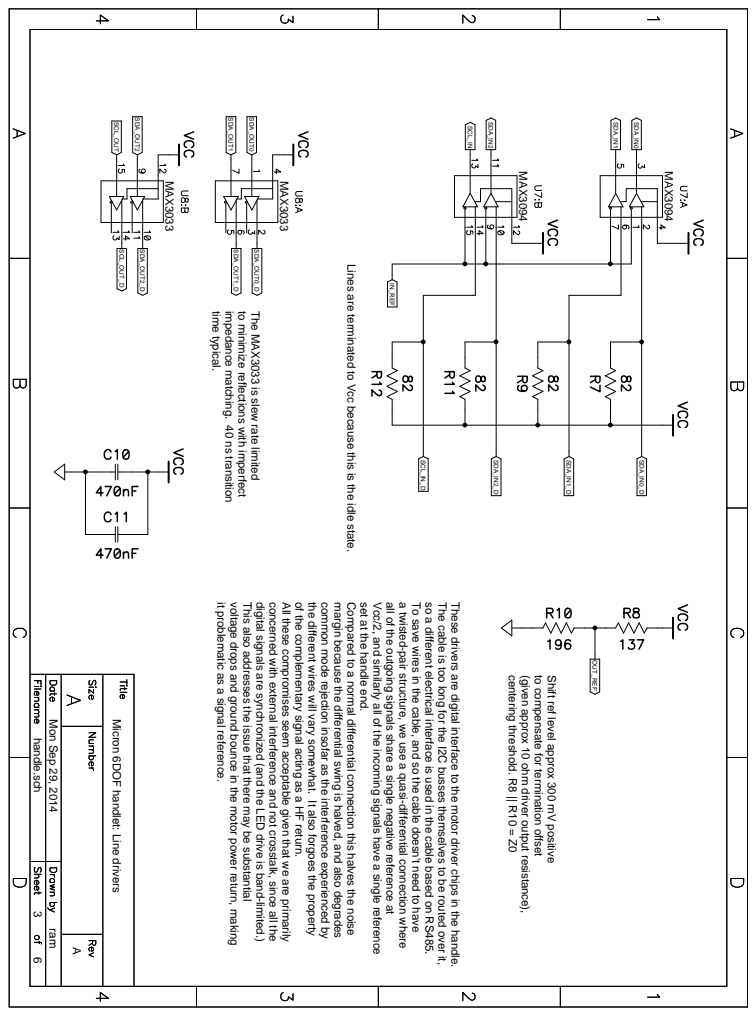
[picture p170: page 3]
time typical.; SCL_OUT_D; SDA_OUT2_D; SDA_OUT1_D; SDA_OUT0_D; SCL_OUT; SDA_OUT2; SDA_OUT1; SDA_OUT0; IN_REF; MAX3033; SCL_IN; SDA_IN2; SDA_IN1; SDA_IN0; SCL_IN_D; SDA_IN2_D; SDA_IN1_D; SDA_IN0_D; MAX3094; OUT_REF; centering threshold. R8 || R10 = Z0; are primarily; ram; Mon Sep 29, 2014; handle.sch 3 6

Lines are terminated to Vcc because this is the idle state.

impedance matching. 40 ns transition

to minimize reflections with imperfect

The MAX3033 is slew rate limited

it problematic as a signal reference.

voltage drops and ground bounce in the motor power return, making

This also addresses the issue that there may be substantial

digital signals are synchronized (and the LED drive is band-limited.)

concerned with external interference and not crosstalk, since all the

All these compromises seem acceptable given that we

of the complementary signal acting as a HF return.

the different wires will vary somewhat. It also forgoes the property

common mode rejection insofar as the interference experienced by

margin because the differential swing is halved, and also degrades

Compared to a normal differential connection this h

set at the handle end.

Vcc/2, and similarly all of the incoming signals have a single reference

all of the outgoing signals share a single negative reference at

a twisted-pair structure, we use a quasi-differential connection where

To save wires in the cable, and so the cable doesn't need to have

so a different electrical interface is used in the cable based on RS485.

The cable is too long for the I2C busses themselves to be routed over it,

These drivers are digital interface to the motor driver chips in the handle.

(given approx 10 ohm driver output resistance),

to compensate for termination offset

Shift ref level approx 300 mV positive

Micron 6DOF handlet: Line drivers

alves the noise

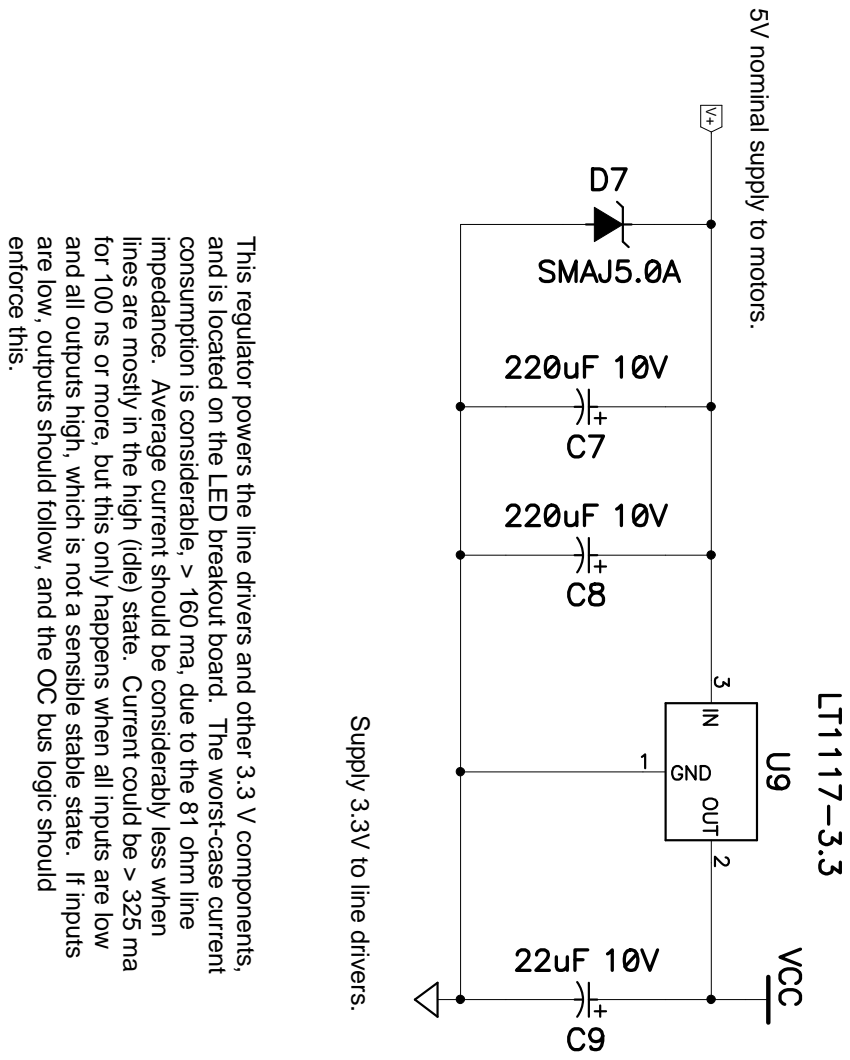
[picture p171: page 4]
enforce this.; 6 4 handle.sch; Mon Sep 29, 2014; ram

5V nominal supply to motors.

are low, outputs should follow, and the OC bus logic should

and all outputs high, which is not a sensible stable state. If inputs

for 100 ns or more, but this only happens when all inputs are low

lines are mostly in the high (idle) state. Current could be > 325 ma

impedance. Average current should be considerably less when

consumption is considerable, > 160 ma, due to the 81 ohm line

and is located on the LED breakout board. The worst-case current

This regulator powers the line drivers and other 3.3 V components,

Supply 3.3V to line drivers.

Micron 6DOF handle: Supplies

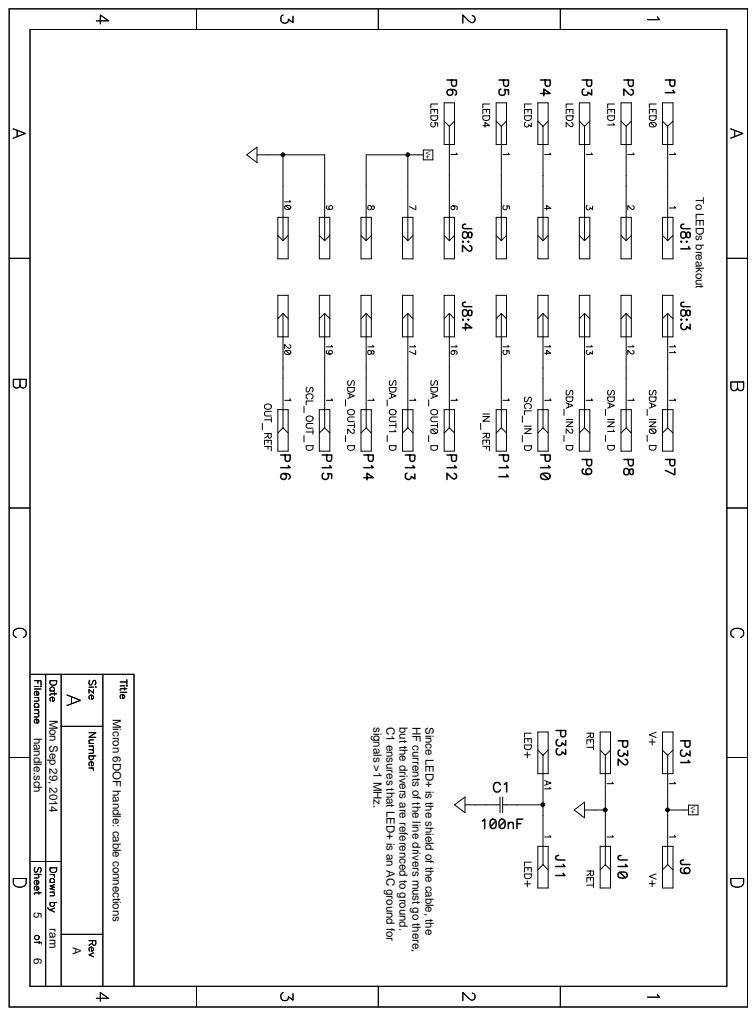
[picture p172: page 5]
signals >1 MHz.; 6 5 handle.sch; Mon Sep 29, 2014; ram

To LEDs breakout

Micron 6DOF handle: cable connections

C1 ensures that LED+ is an AC ground for

but the drivers are referenced to ground.

HF currents of the line drivers must go there,

Since LED+ is the shield of the cable, the

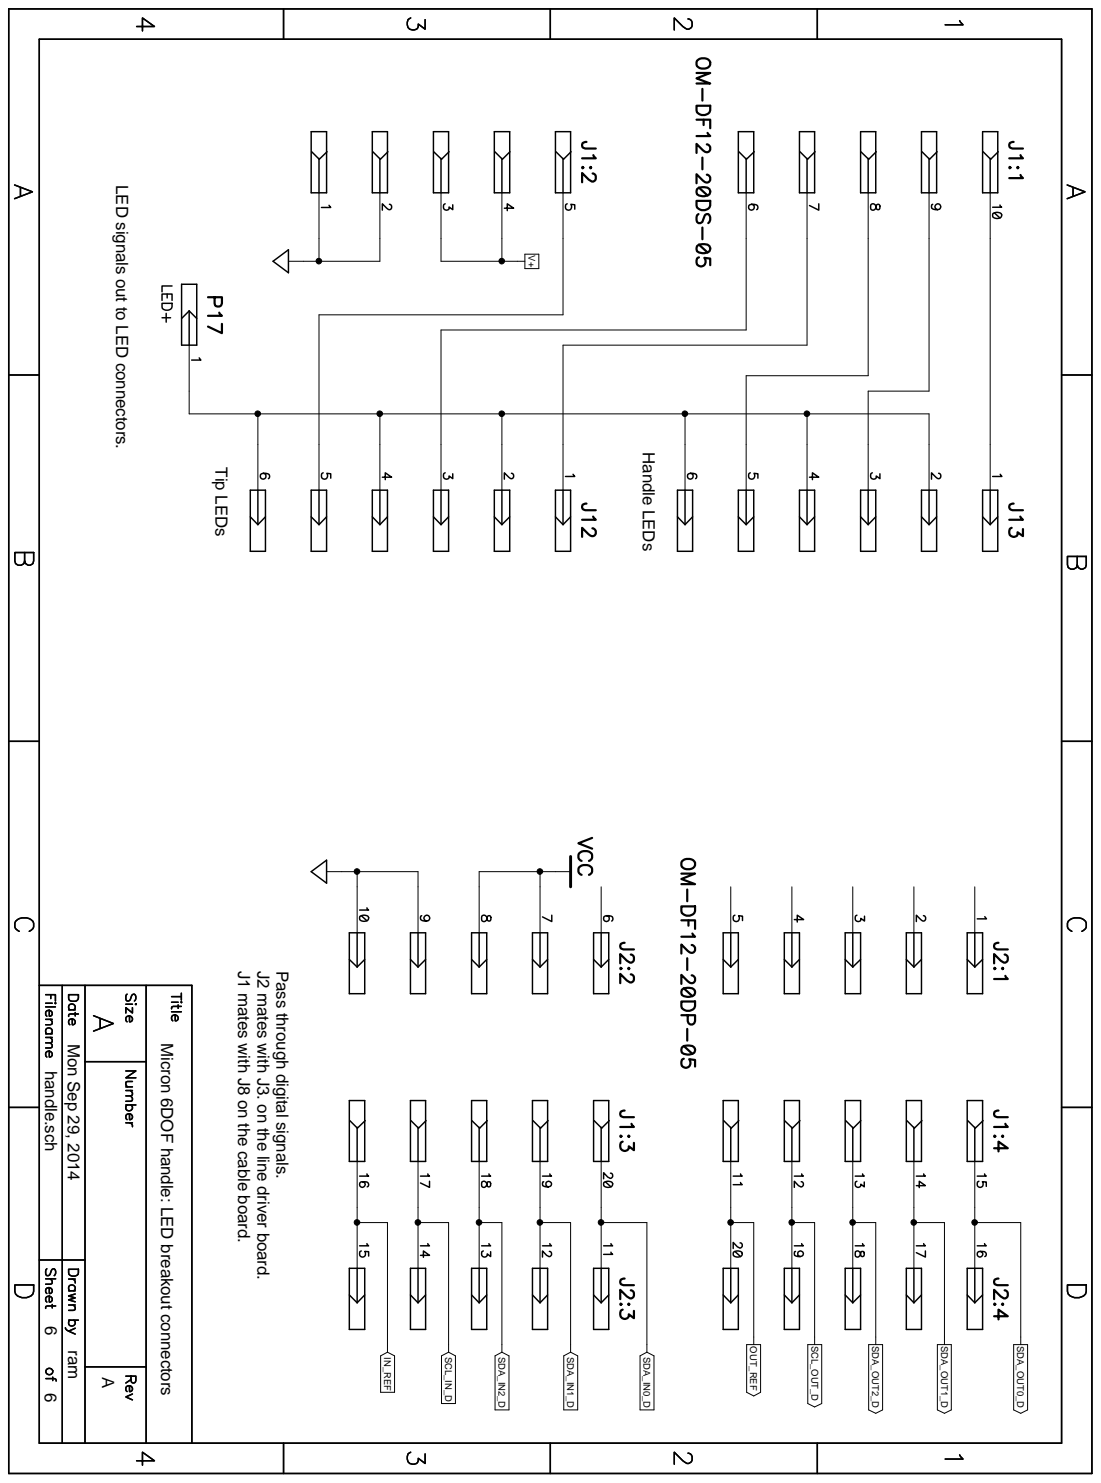
[picture p173: page 6]
Tip LEDs; Handle LEDs SDA_IN0_D; OUT_REF; SCL_OUT_D; SDA_OUT2_D; SDA_OUT1_D; SDA_OUT0_D; IN_REF; SCL_IN_D; SDA_IN2_D; SDA_IN1_D; ram; Mon Sep 29, 2014; handle.sch 6 6

LED signals out to LED connectors.

J1 mates with J8 on the cable board.

J2 mates with J3. on the line driver board.

Pass through digital signals.

Micron 6DOF handle: LED breakout connectors
