robmacl/micron_maxon/cad/micron_6dof/motor-drive.pdf

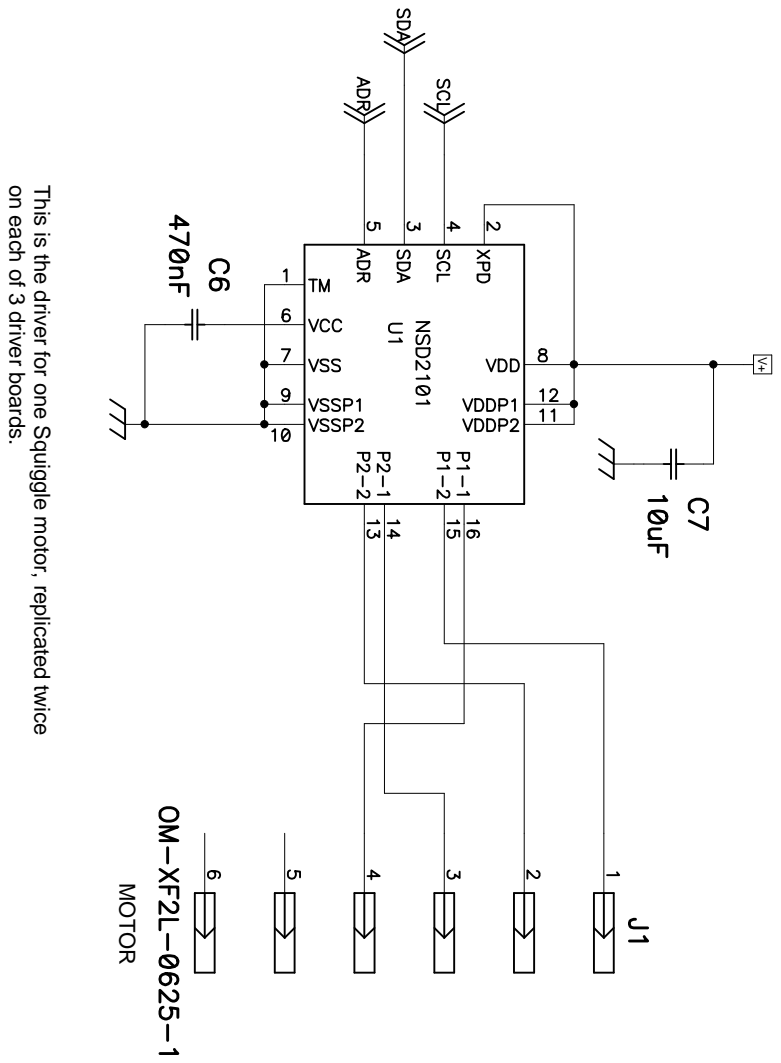
[picture p174: page 1]
MOTOR; ram; Wed Feb 24, 2016

on each of 3 driver boards.

This is the driver for one Squiggle motor, replicated twice

Micron 6DOF handle: motor driver

motor-drive.sch 1 3

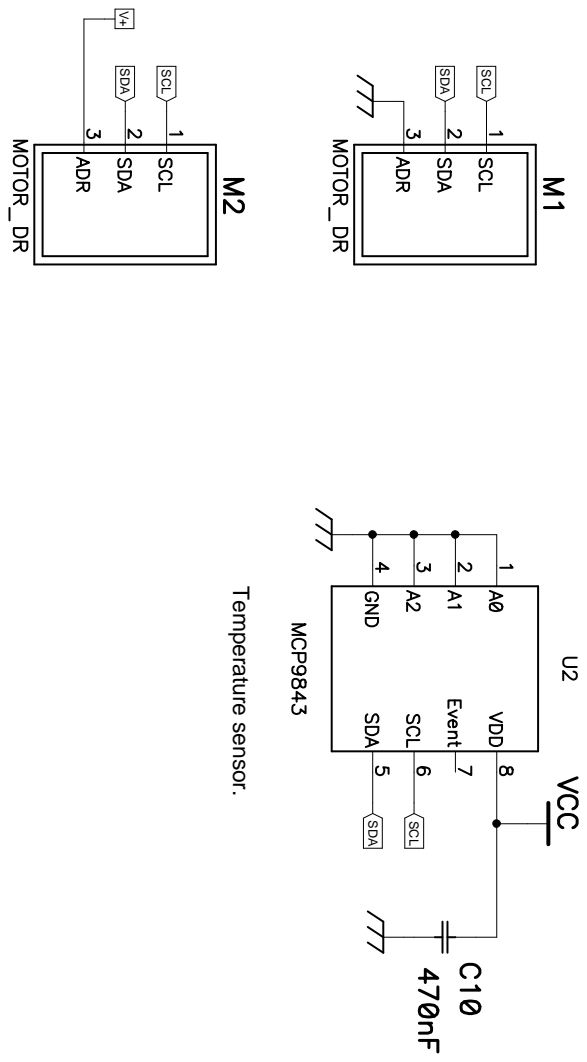
[picture p175: page 2]
SDA; SCL; Temperature sensor.; ram; Wed Feb 24, 2016

Micron 6DOF motor driver: main

motor-drive.sch 2 3

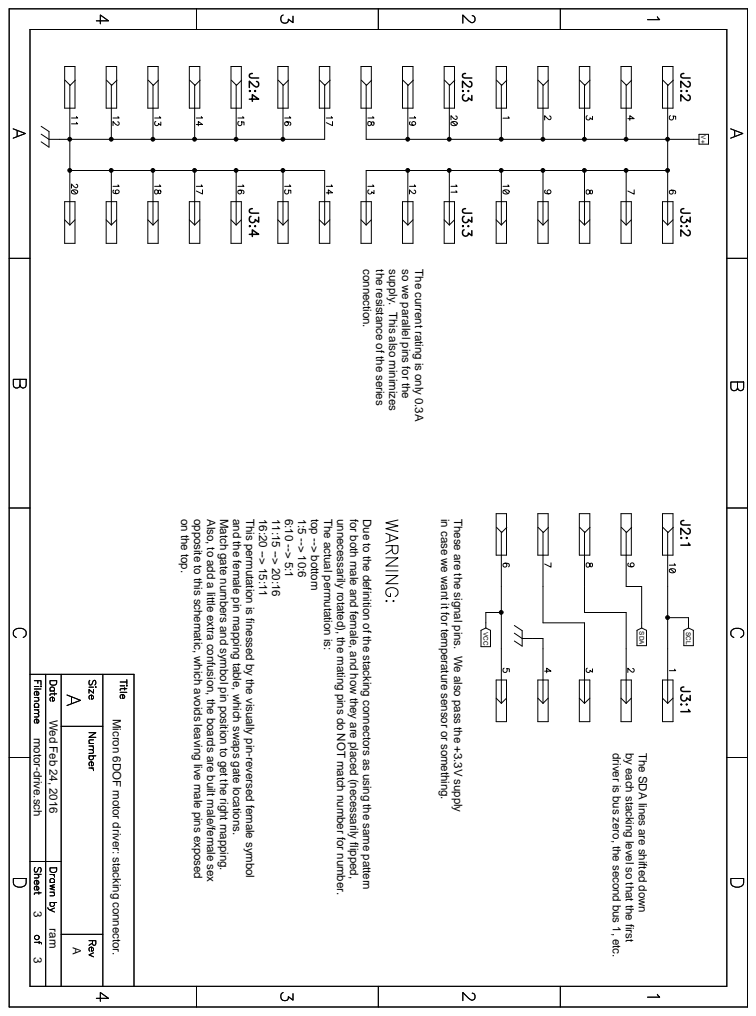
[picture p176: page 3]
connection.; VCC; SDA; SCL; top --> bottom; Wed Feb 24, 2016; ram

the resistance of the series

supply. This also minimizes

so we parallel pins for the

The current rating is only 0.3A

on the top.

opposite to this schematic, which avoids leaving live male pins exposed

Also, to add a little extra confusion, the boards are built male/female sex

Match gate numbers and symbol pin position to get the right mapping.

and the female pin mapping table, which swaps gate locations.

This permutation is finessed by the visually pin-re

The actual permutation is:

unnecessarily rotated), the mating pins do NOT match number for number.

for both male and female, and how they are placed (necessarily flipped,

Due to the definition of the stacking connectors as using the same pattern

in case we want it for temperature sensor or something.

These are the signal pins. We also pass the +3.3V supply

Micron 6DOF motor driver: stacking connector.

3 3 motor-drive.sch

driver is bus zero, the second bus 1, etc.

by each stacking level so that the first

The SDA lines are shifted down

versed female symbol
