robmacl/micron_maxon/drawings/Jigs/Top_Bottom_Align.pdf

B
P

TIO; ole; al Ali

PRODUCED BY AN AUTODESK EDUCATIONAL PRODUCT

TIO; A U T O D E S K E D U C A TIO; TITLE; Jig_Aligner Sleeve; 2-56 UNC - 2B

PRODUCED BY AN AUTODESK EDUCATIONAL PRODUCT

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

DRAWN sungwook | 2/27/2012

CHECKED | 2/29/2012

MFG

APPROVED

SIZE A | DWG NO Micron_New_Rev4 | REV

SCALE | | SHEET 5 OF 6

TIO; A U T O D E S K E D U C A TIO; TITLE; Sliding Fit #1; Sliding Fit #3; Assembly Fitting; Sliding Fit #2

PRODUCED BY AN AUTODESK EDUCATIONAL PRODUCT

Pin Gauge: .0800 No-Go

Pin Gauge: .1180 No-Go

DRAWN sungwook | 2/27/2012

CHECKED | 2/29/2012

MFG

APPROVED

SIZE A | DWG NO Micron_New_Rev4 | REV

SCALE | | SHEET 6 OF 6
