robmacl/micron_maxon/cad/micron_6dof/kinematic_data.pdf

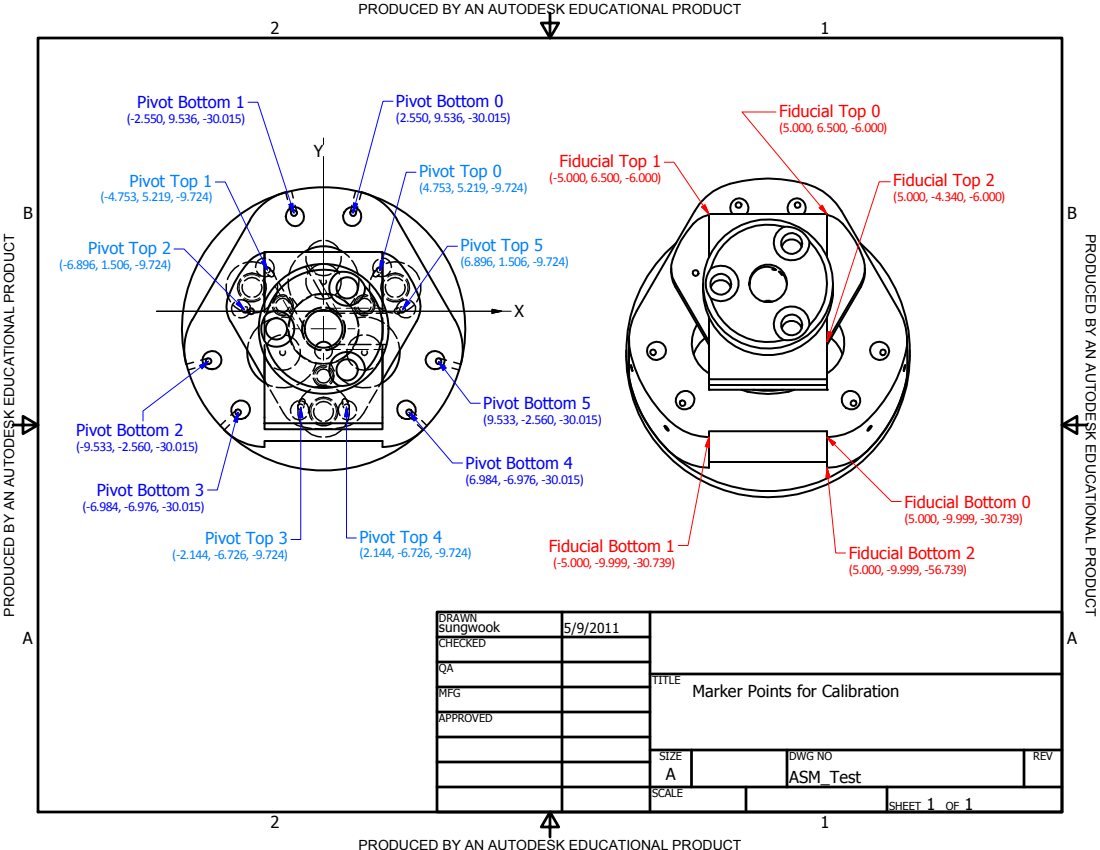
[picture p177: page 1]
TIO; A U T O D E S K E D U C A TIO; DRAWN sungwook; CHECKED; MFG; APPROVED; SIZE A; SCALE; DWG NO ASM_Test; REV; SHEET 1 OF 1; Fiducial Bottom 0 (5.000, -9.999, -30.739); Fiducial Bottom 1 (-5.000, -9.999, -30.739); Fiducial Bottom 2 (5.000, -9.999, -56.739); Fiducial Top 1 (-5.000, 6.500, -6.000); Fiducial Top 0 (5.000, 6.500, -6.000); Fiducial Top 2 (5.000, -4.340, -6.000); Pivot Bottom 0 (2.550, 9.536, -30.015); Pivot Bottom 1 (-2.550, 9.536, -30.015)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

PRODUCED BY AN AUTODESK EDUCATIONAL PRODUCT

TITLE
Marker Points for Calibration
