robmacl/micron_maxon/drawings/Fiducials/Kinematic_Pt_120111.pdf

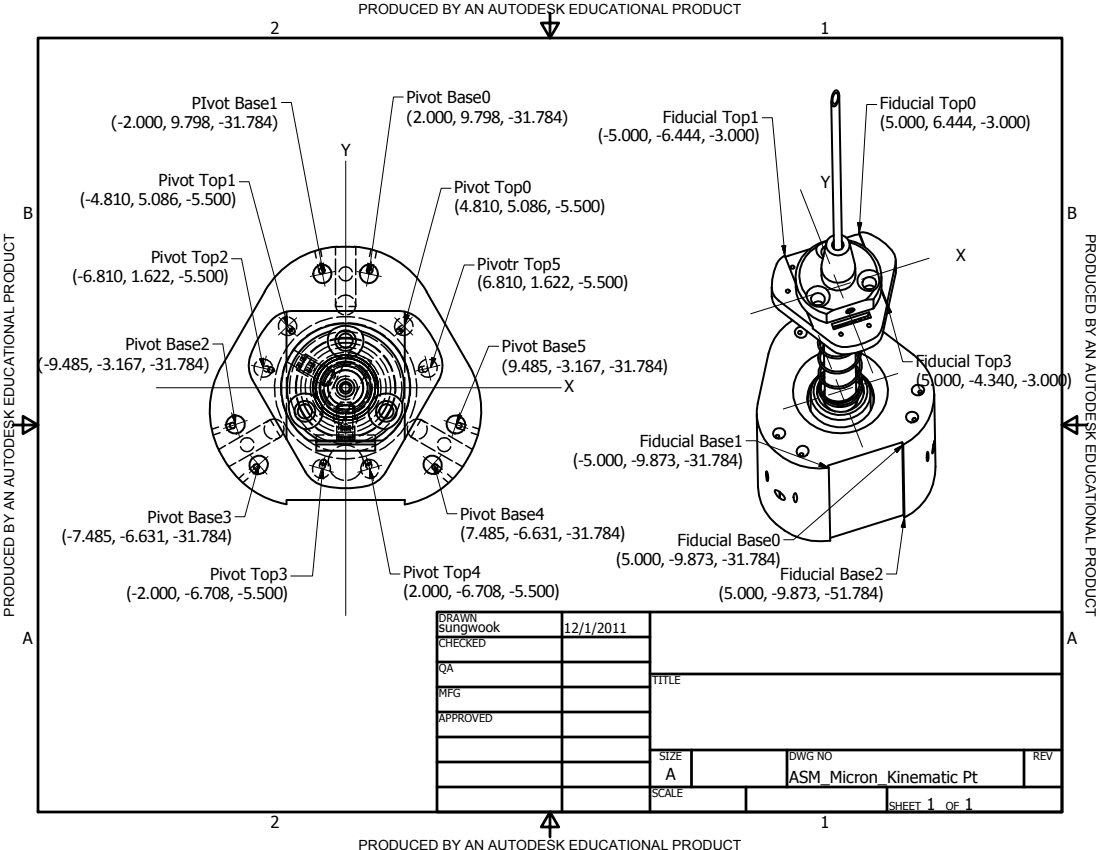
[picture p178: page 1]
TIO; A U T O D E S K E D U C A TIO; DRAWN sungwook; CHECKED; MFG; APPROVED; TITLE; SIZE A; SCALE; DWG NO ASM_Micron_Kinematic Pt; REV; SHEET 1 OF 1; Pivot Base0 (2.000, 9.798, -31.784); Pivotr Top5 (6.810, 1.622, -5.500); Pivot Top0 (4.810, 5.086, -5.500); Pivot Top1 (-4.810, 5.086, -5.500); PIvot Base1 (-2.000, 9.798, -31.784); Pivot Top2 (-6.810, 1.622, -5.500); Pivot Base2 (-9.485, -3.167, -31.784); Pivot Base3 (-7.485, -6.631, -31.784); Pivot Top3 (-2.000, -6.708, -5.500)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

PRODUCED BY AN AUTODESK EDUCATIONAL PRODUCT
