robmacl/micron_maxon/drawings/Inventor_Design/Micron22_top_adj_02082013_Inventor2013/02082012_Fiducail_Markers/Fiducial_Post.pdf

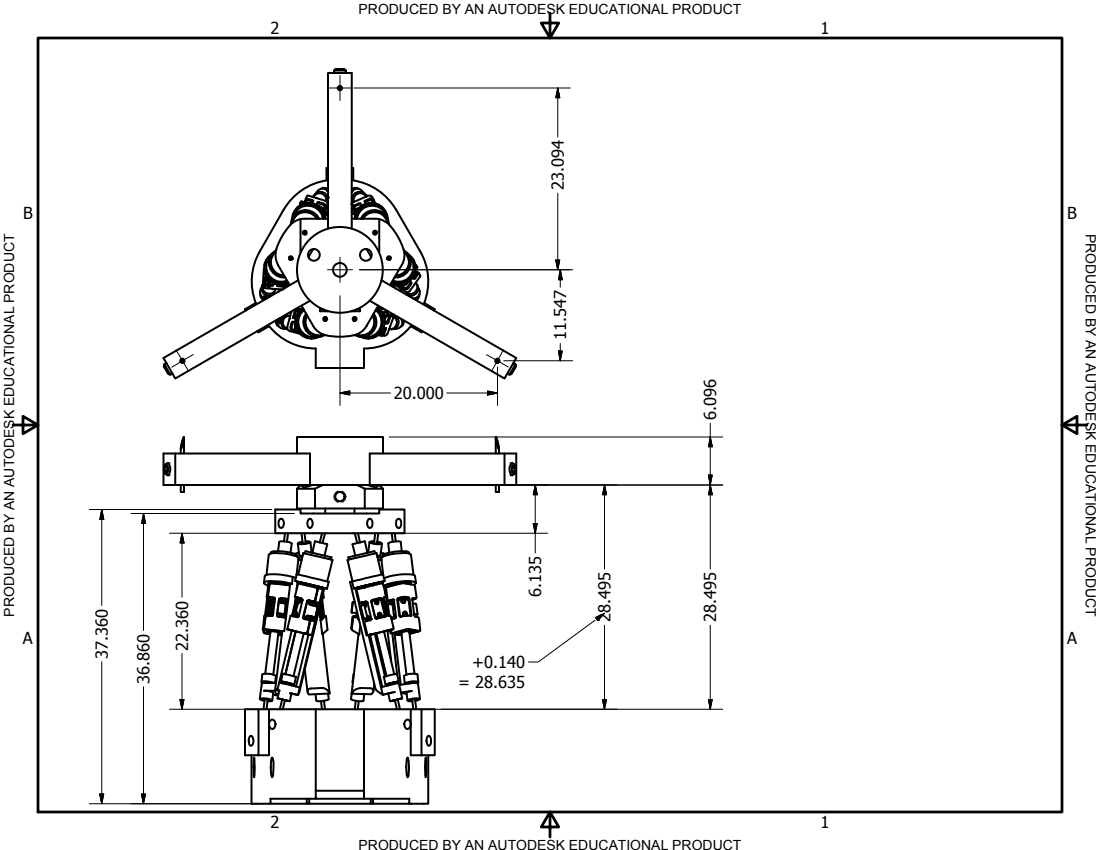
[picture p179: page 1]
TIO

PRODUCED BY AN AUTODESK EDUCATIONAL PRODUCT
