robmacl/micron_maxon/drawings/Inventor_Design/Micron22_top_adj_02082013_Inventor2013/Drawings/ASM_Motor_Unit_Full_Stroke.pdf

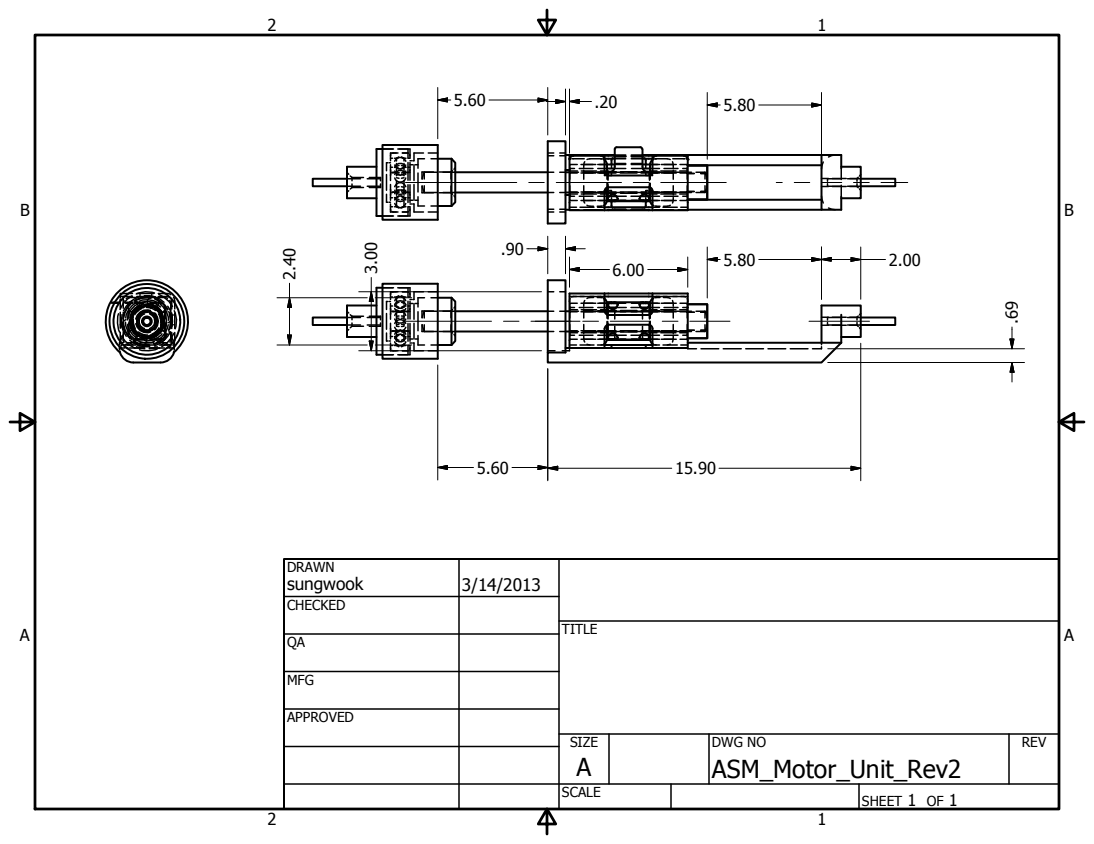
[picture p180: page 1]
SHEET 1 OF 1; DRAWN; CHECKED; MFG; APPROVED; sungwook; DWG NO ASM_Motor_Unit_Rev2; TITLE; SIZE A; SCALE; REV
