robmacl/micron_maxon/drawings/Inventor_Design/Micron22_top_adj_02082013_Inventor2013/Drawings/Top and Base(Auxiliary View).pdf

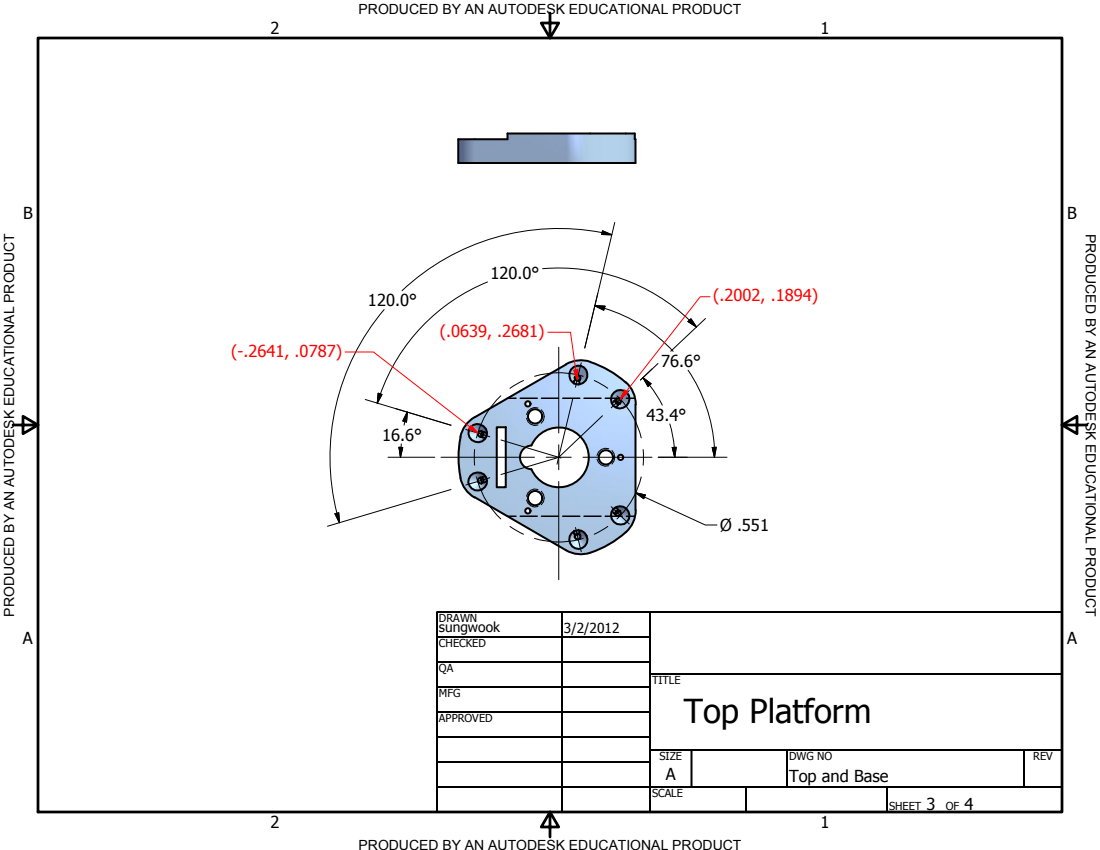
[picture p181: page 1]
TIO; Pla

PRODUCED BY AN AUTODESK EDUCATIONAL PRODUCT

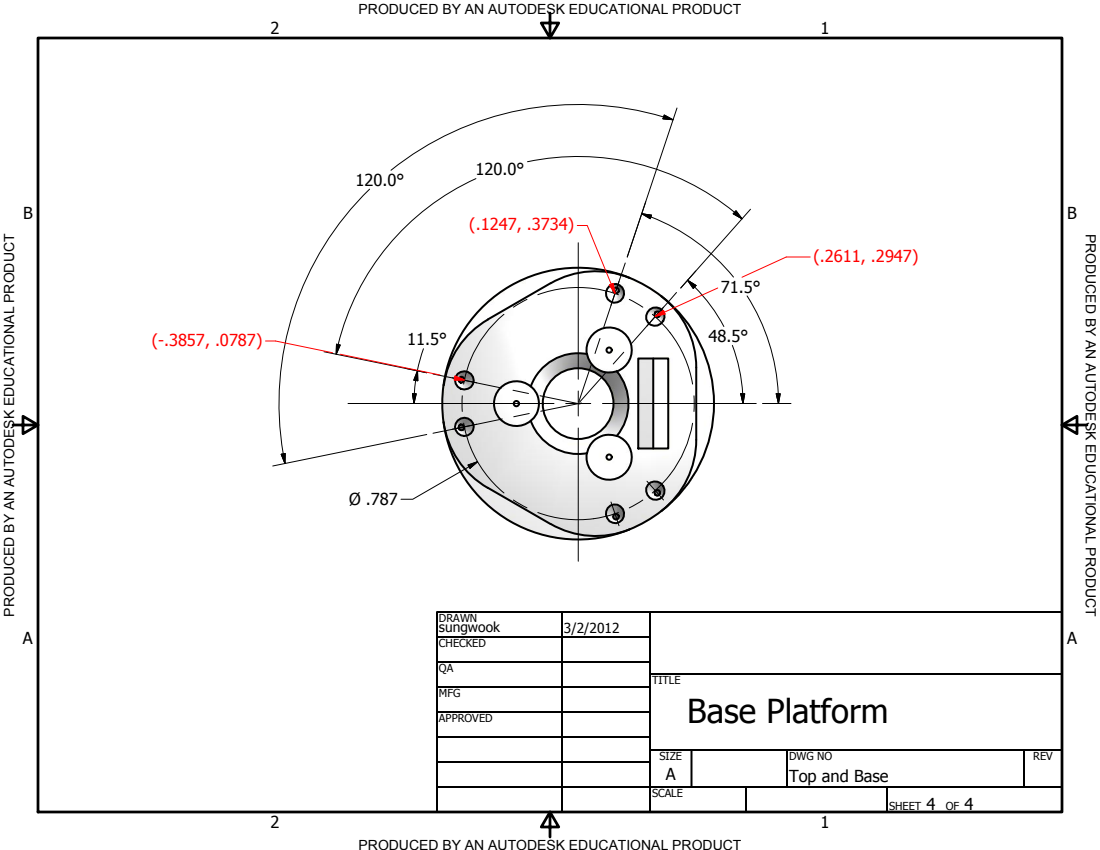
[picture p182: page 2]
TIO; Pla

PRODUCED BY AN AUTODESK EDUCATIONAL PRODUCT
