robmacl/micron_maxon/drawings/Etc/ASM_Micron_Matlab_Indication.pdf

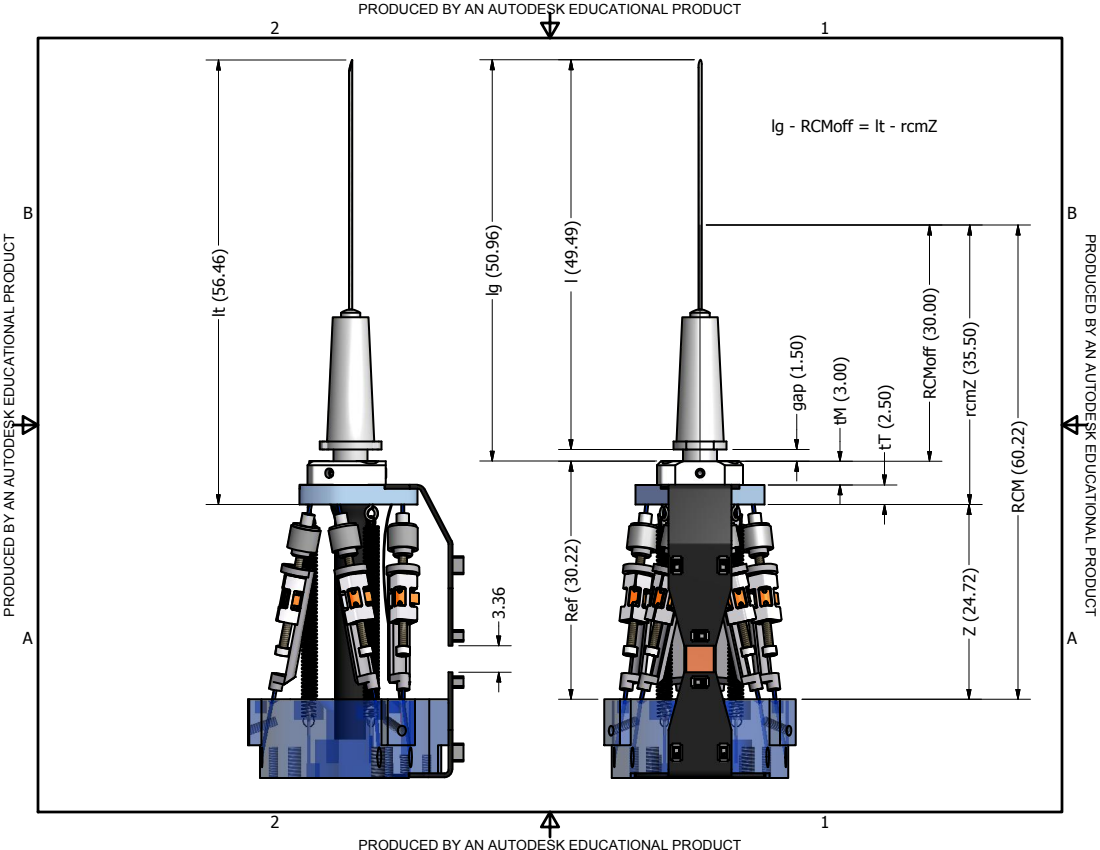
[picture p183: page 1]
TIO; 1.50 gap ( ); 30.22 Ref ( ); 30.00 RCMoff ( ); 60.22 RCM ( ); 35.50 rcmZ ( ) 24.72 Z ( )

PRODUCED BY AN AUTODESK EDUCATIONAL PRODUCT
