robmacl/micron_maxon/drawings/Fiducials/Fiducial_Post.pdf

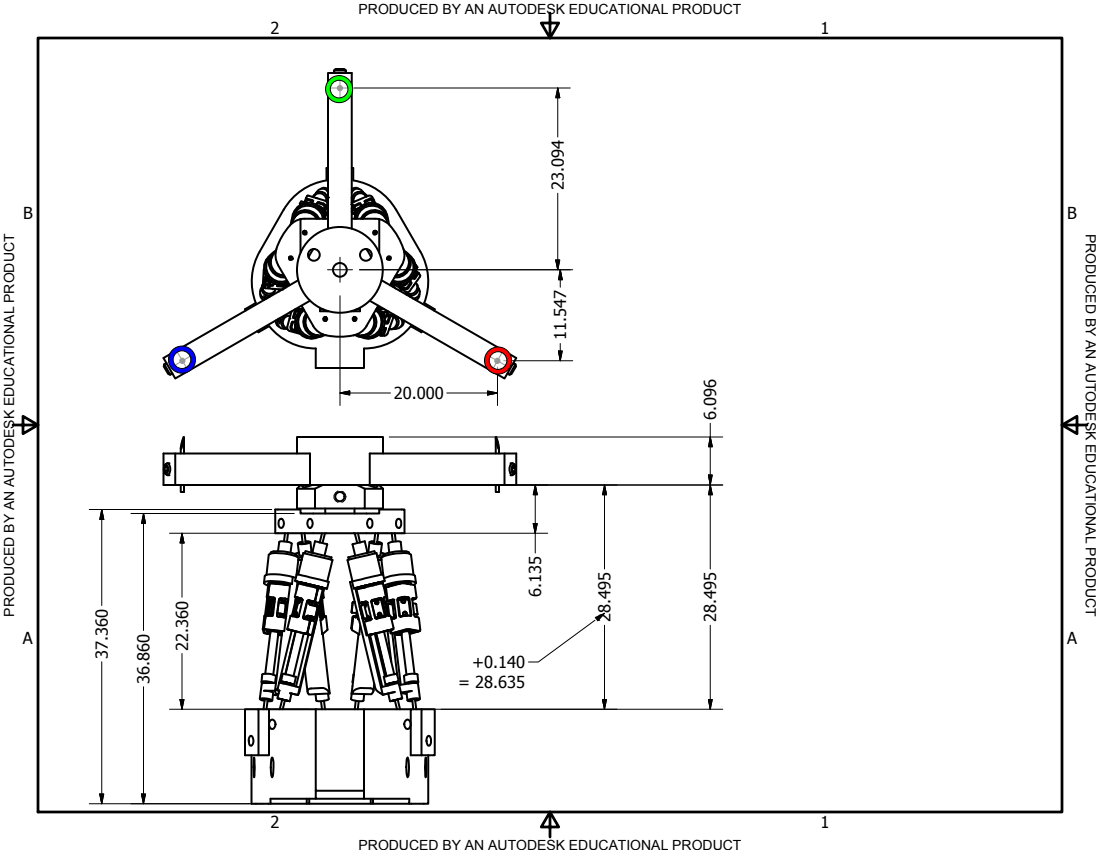
[picture p184: page 1]
TIO

PRODUCED BY AN AUTODESK EDUCATIONAL PRODUCT
