robmacl/micron_maxon/cad/Micron CAD/Select tidbits/led_flex.pdf

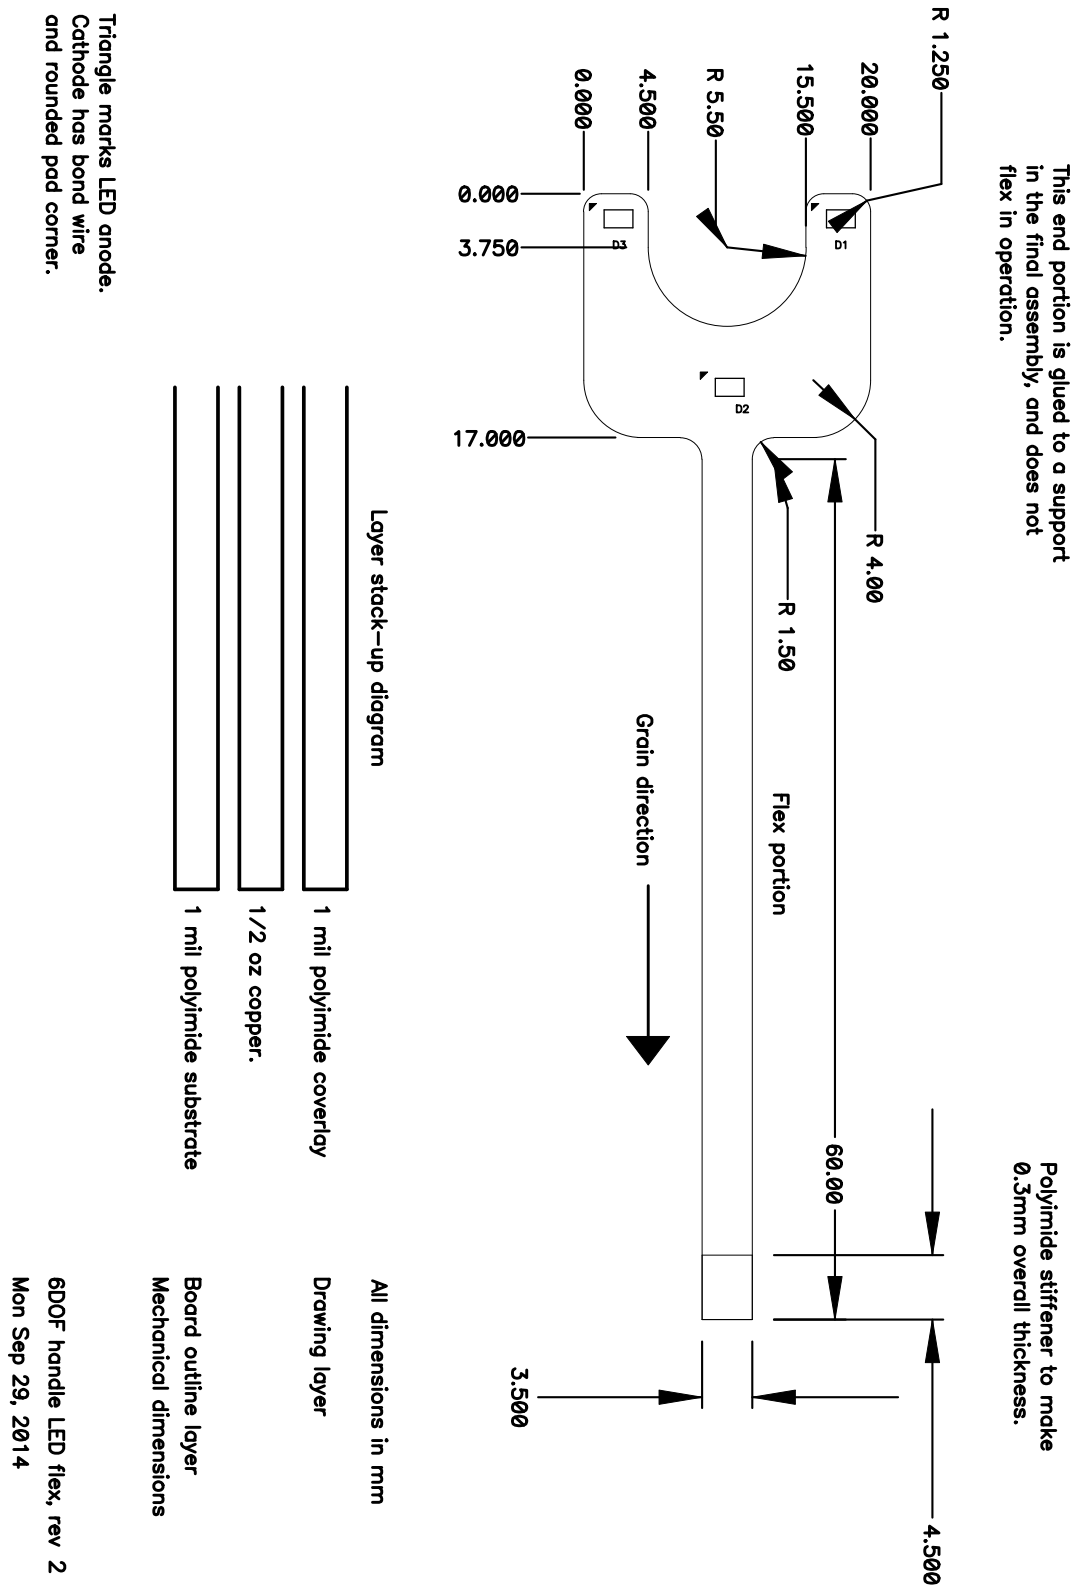
[picture p185: page 1]

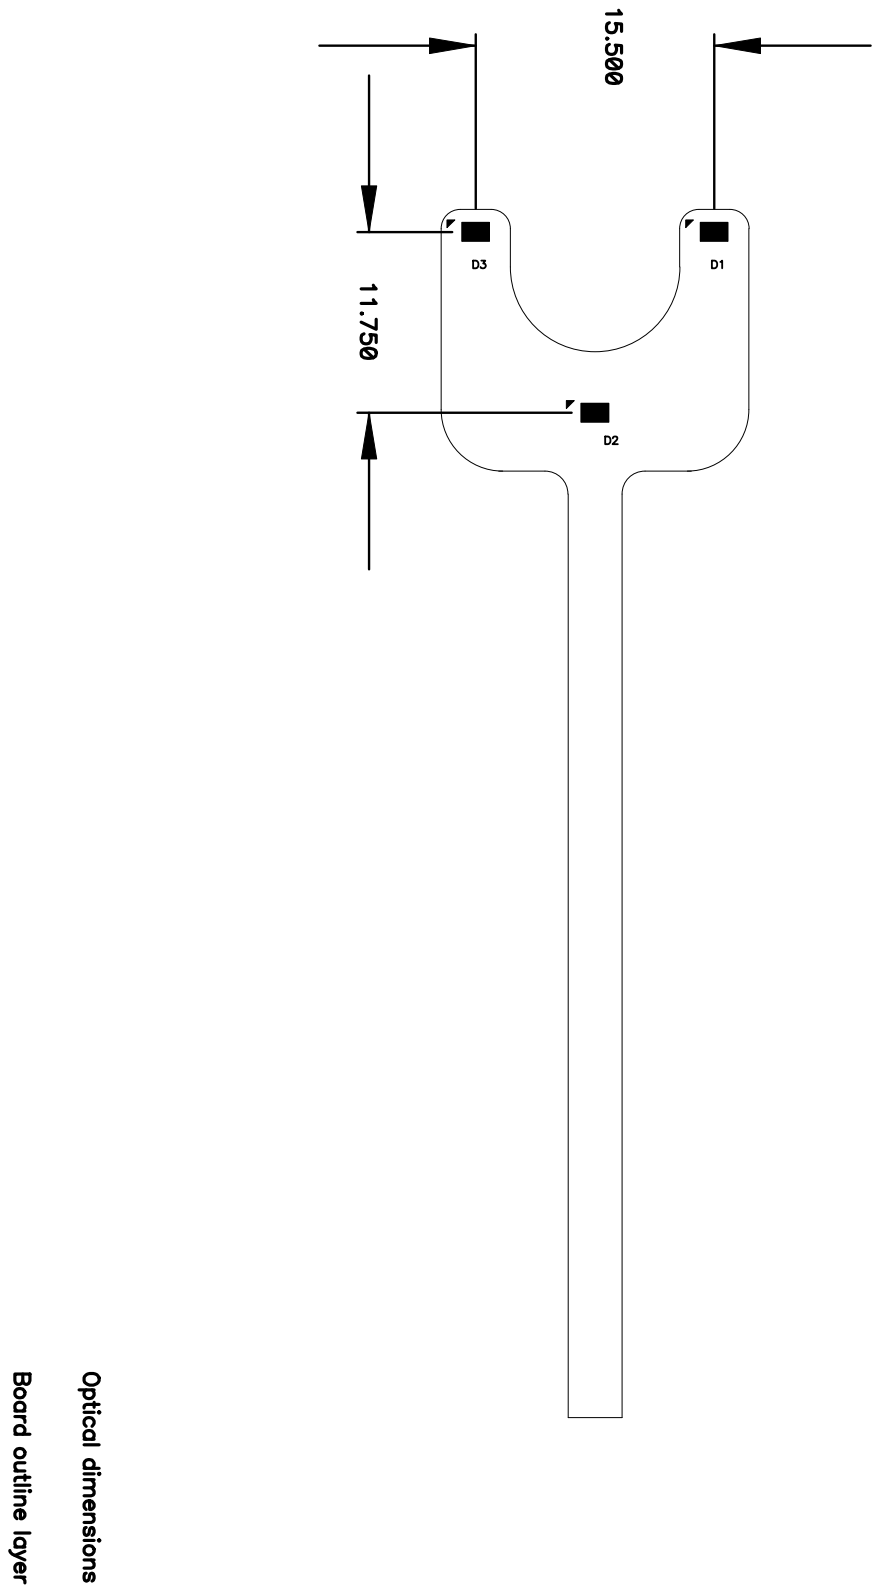
[picture p186: page 2]
