robmacl/micron_maxon/cad/micron_6dof/line_drive_bead.asc

R1: res; 75
T1: tline; Td=12n Z0=100
U1: xferritebead1; HZ0805D102R-10
V1: voltage; PULSE(0 3 0 1n 1n 625n 1250n 1); AC 1; Rser=5
Named nets: 0
.include "LairdTech_v2_0.lib"
;tran 0 1.5u 0 100p
.ac oct 10 10k 200meg
