robmacl/micron_maxon/(list of files, drawings)

Other design files:
cad/3dof_handle/flex.pcb
cad/3dof_handle/flex_new.pcb
cad/3dof_handle/mechanical/holder.pcb
cad/3dof_handle/mechanical/jig.pcb
cad/3dof_handle/mechanical/piezo_detail.pcb
cad/3dof_handle/mechanical/piezo_layout.pcb
cad/asap_micron/asap-in-r1-resolve.pcb
cad/asap_micron/asap-in-resolve.pcb
cad/asap_micron/breakout-r1-resolve.pcb
cad/asap_micron/breakout-resolve.pcb
cad/asap_micron/driver-r1-resolve.pcb
cad/asap_micron/driver-resolve.pcb
cad/asap_micron/probe-conn.pcb
cad/asap_micron/probe.pcb
cad/asap_micron/sensor-r1-resolve.pcb
cad/asap_micron/sensor-resolve.pcb
cad/exp_fixtures/circle_cross_500.pcb
cad/inertial_micron/handle-resolve-all.pcb
cad/inertial_micron/handle-resolve.pcb
cad/micron_6dof/fp-transition.pcb
cad/micron_6dof/fpga-breakout.pcb
cad/micron_6dof/handle.pcb
cad/micron_6dof/handle_r2.pcb
cad/micron_6dof/led-flex-r2-handle.pcb
cad/micron_6dof/led-flex-r2.pcb
cad/micron_6dof/led-flex.pcb
cad/micron_6dof/motor-drive-resolve.pcb
cad/micron_6dof/motor-drive-resolve_r1.pcb
cad/old_asap/asap-resolve.pcb
cad/piezo_amp/piezo_resolve.pcb
