robmacl/micron_maxon/(commit log)

2024-06-14 Micron files pulled over to git. This particular version has the labview which is being tweaked up for the Maxon 6DOF manipulator.
    [1.3k_amp_sq_calibrate.xlsx, 1.3k_amp_sq_calibrate_new.xlsx, 1.3k_amp_sq_calibrate_new2_06122013.xlsx, 2D_Al_Tubing.dwg, 2D_Al_Tubing_2.dwg, 90107A001.IGS, 90107A001.ipt, ASAP-IN-R1-RESOLVE.BRD]
2024-07-09 Changes related to light calibration and Maxon control. Tweaking get_fiducials.vi to try to get calibration working (temp hack), added back sq_controller.vi and wired in the link KF. Other changes ap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
2024-07-11 Restored some of the link estimation stuff, swapped back to the CMU 6dof version of inverse_kin6.vi. Added kinematic data for Maxon manipulator.
2024-07-19 Implemented recenter.vi function, improved documentation in sub_inverse_kin6.vi, tweaks to manipulator kinematic data.
2024-07-30 Messing with the light calibration and pose solution to fix problems with the pose being flipped upside down on Maxon. Tried swapping lights 3 & 5 in various places, eventually came around to modifyi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
2024-08-22 New kinematic data, implemented recenter, new version of manip_status_test
